mk2442/Itla/digital/impresion-3d/stepper-motor-17hs15/global.png

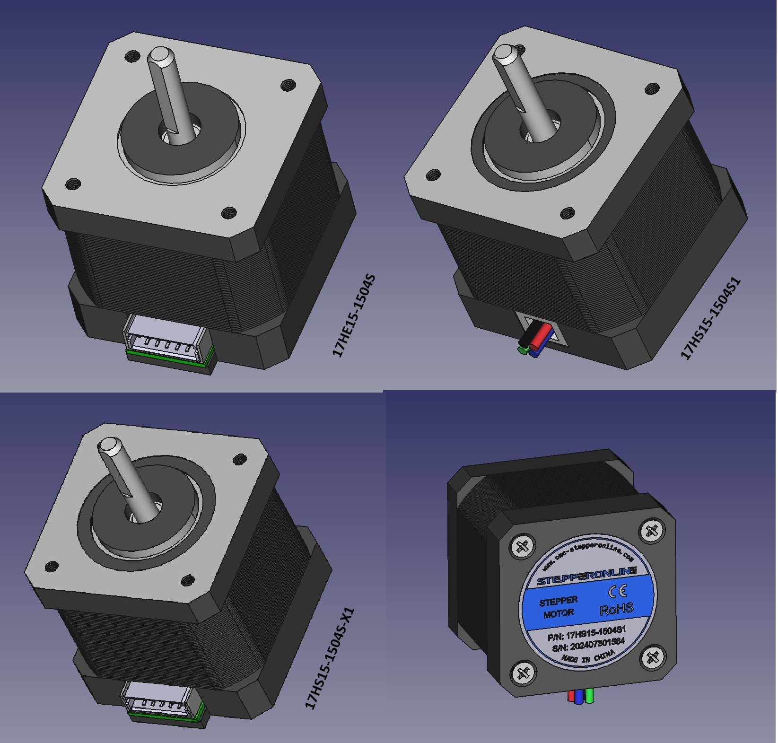
digital/impresion-3d/stepper-motor-17hs15/global.png
