mk2442/Itla/electronica/ESP32-DEVKITV1/README.md

# ESP32-DEVKITV1
ESP32-DEVKITV1 EAGLE-FOOTPRINT

ESP32

ESP32s
