mk2442/Itla/electronica/PHM-30A/README.md

# PHM-30A
Puente H con Mosfet discretos 30A
