mk2442/Itla/digital/proyectos/troca-mcu-stm32g474/README.md

# TROCA-MCU-STM32G474
Tarjeta con microcontrolador STM32G474 100 pines, usamos PCB con pines gatillados.
