mk2442/Itla/digital/documentos/ALU.pdf

# ALU

Angel Alam Mateo Encarnación Mecatrónica
ITLA
La Caleta, Santo Domingo
Cristian Miguel Jimenez
20240712@itla.edu.do

Resumen: En este laboratorio se llevarán a cabo distintas operaciones vinculadas a la unidad lógica aritmética, con el propósito de analizar sus aplicaciones tanto en el ámbito práctico como en el teórico, siendo este un componente fundamental en la electrónica digital.

Abstract: During this lab, various functions related to the arithmetic logic unit will be performed in order to see both the practical and theoretical applications of this key component in the world of digital electronics.

Palabras claves: ALU.

I. Introducción

Durante el siguiente documento se estará
diseñando | un | ALU | mediante | lógica
combinacional con el fin de poder realizar operaciones lógicas y aritméticas de cuatro bits.
II. | Marco Teórico
ALU: | Una | Unidad | Aritmético-Lógica
(ALU) es un elemento esencial dentro de los
procesadores, | encargado | de | ejecutar
operaciones aritméticas, como suma y resta, así como operaciones lógicas, como AND, OR y XOR, entre otras, utilizando datos binarios. Su funcionamiento se basa en recibir dos operandos de entrada junto con una señal de control que define la operación a realizar, generando como salida el resultado y ciertas señales de estado, como acarreo, desbordamiento o condición de cero. Este componente es clave en el procesamiento de información en CPUs, microcontroladores y sistemas digitales, y puede implementarse de manera sencilla
mediante | lenguajes | como | Verilog | en
proyectos con FPGA o en entornos de simulación digital.

III. Diseño del circuito

Para el diseño de la ALU, se partirá de las
funciones | asignadas, | las | cuales | serán
seleccionadas en parte por elección propia y en parte según la matrícula. Estas funciones se escogerán a partir de la siguiente tabla:

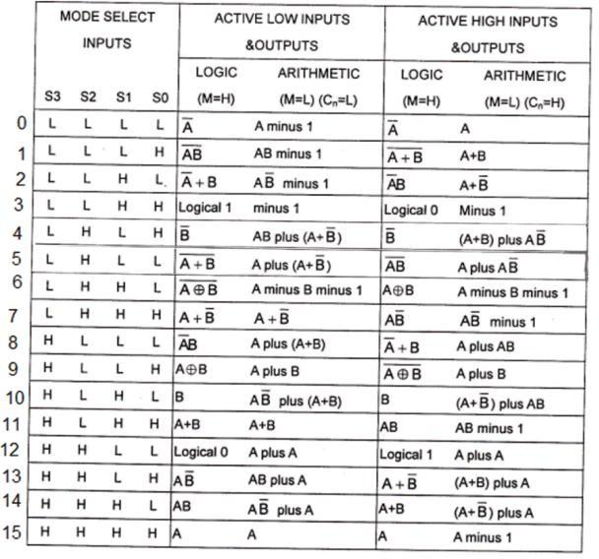
[picture p144: figure]

Y las funciones elegidas son las siguientes:

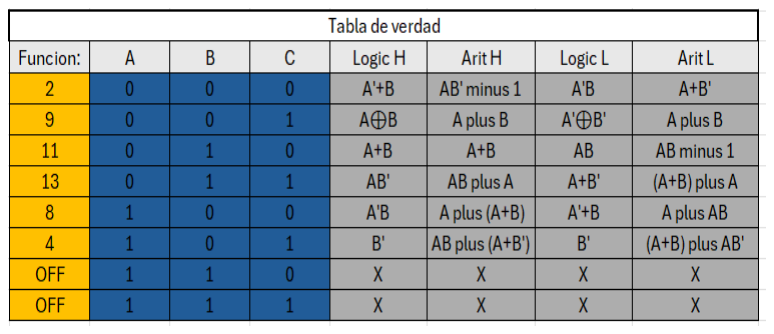
[picture p145: figure]

Partiendo de esta tabla, podemos construir los circuitos logicos en multsim:

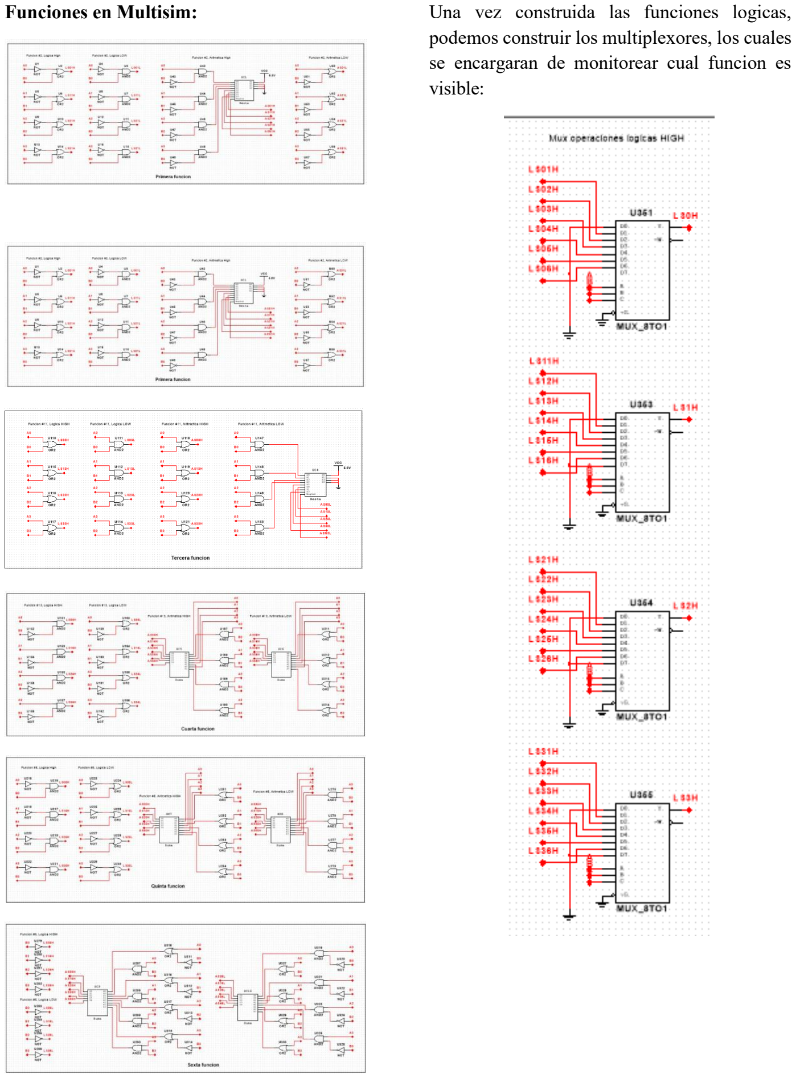
[picture p146: page 2]

Funciones en Multisim: | Una vez construida las funciones logicas, podemos construir los multiplexores, los cuales se encargaran de monitorear cual funcion es visible:

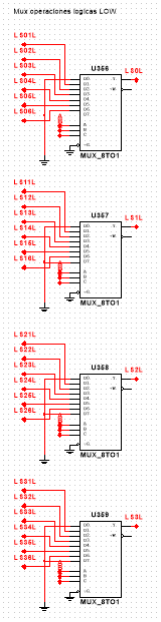
[picture p147: figure]

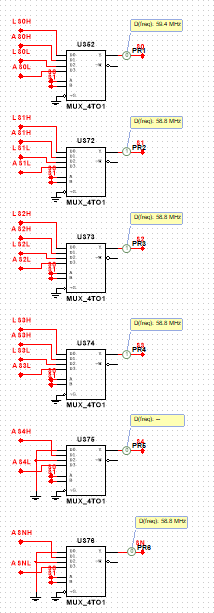
[picture p148: figure]

Para concluir, llevaremos a verilog las funciones creadas y haremos la implementacion en fisico:

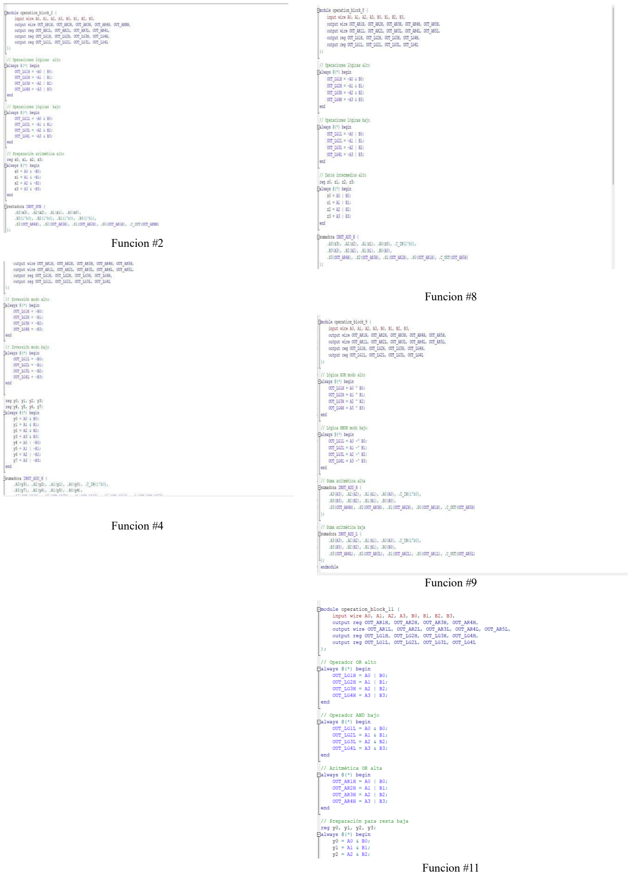
[picture p149: page 5]

Funcion #2

Funcion #4

Funcion #8

Funcion #9

Funcion #11

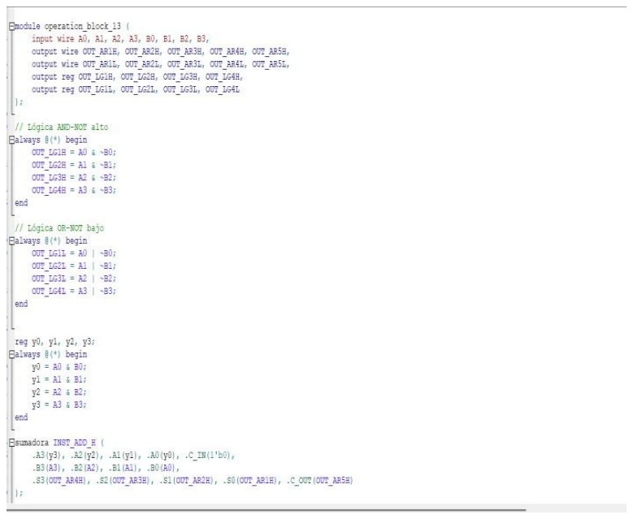
[picture p150: figure]

Funcion #13

Nota: Para la construccion de la restadora, sumadora se utilizaron los mismo diagramas logicos y codigo que se utilizaron en la tarea de la multiplicadora.

IV. Conclusión

Durante el desarrollo de este laboratorio se consiguió diseñar y simular una Unidad Aritmético-Lógica (ALU) de 4 bits empleando lógica combinacional. Se implementaron diversas funciones aritméticas y lógicas, seleccionadas tanto de forma manual como en función de la matrícula, lo que permitió integrar varias operaciones en un único bloque funcional. El uso de multiplexores facilitó la selección de las salidas, evidenciando el principio de control presente en una ALU real. Asimismo, el diseño fue llevado a Verilog con el objetivo de posibilitar su implementación en hardware, acercando el proyecto al uso de FPGA y sistemas digitales reales. Esta
experiencia | permitió | fortalecer | los
conocimientos en diseño digital, estructuración de código y comprender la importancia de las ALU dentro de los sistemas computacionales.
