mk2442/Itla/digital/documentos/Circuitos secuenciales II.pdf

# Circuitos secuenciales II

Cristian Miguel Jimenez

Mecatrónica
ITLA
La Caleta, Santo Domingo
20240712@itla.edu.do

Resumen: En esta práctica se desarrolló un contador síncrono mediante el uso de lógica secuencial y flip-flops tipo D, con el propósito de mostrar en displays de 7 segmentos determinadas combinaciones previamente definidas.

Abstract: In this practice, a synchronous counter was developed using sequential logic and D-type flip-flops, with the objective of displaying specific predefined combinations on 7-segment displays.

Palabras claves: Flip-flop, lógica secuencial, contador síncrono.

I. Introducción

A lo largo del presente documento se llevará a cabo el diseño de un contador síncrono y un decodificador, con el objetivo de representar un patrón secuencial mediante el uso de un display de 7 segmentos.

II. Marco Teórico

Lógica secuencial: La lógica secuencial corresponde a una clase de circuitos digitales cuya salida no solo está determinada por las entradas presentes, sino también por los estados anteriores del sistema. A diferencia de la lógica combinacional, este tipo de lógica puede conservar información a través de elementos de memoria, como los flip-flops, lo que hace posible el desarrollo de registros, contadores y máquinas de estado.

Flip-flop: Un flip-flop es un dispositivo digital biestable capaz de guardar un único bit de información. Su estado cambia según las señales de entrada y la señal de reloj. Constituye la base del almacenamiento en la lógica secuencial y es ampliamente utilizado en la construcción de registros, contadores y sistemas de contro.

Contador síncrono: Un contador síncrono es un circuito secuencial diseñado para aumentar o disminuir su valor con cada pulso de reloj. A diferencia del contador asíncrono, en este caso todos los flip-flops son activados de manera simultánea por la misma señal de reloj, lo que permite un funcionamiento más preciso y reduce los retrasos acumulados.

III. Diseño del circuito e implementación en multisim

El | circuito | que | se | pretende | diseñar
corresponde a un contador síncrono encargado de realizar un desplazamiento de derecha a izquierda, mostrando de manera secuencial una serie de letras mediante el uso de un display de 7 segmentos.

La combinacion que se vera son las iniciales de mi nombre junto a mi matricula, todo separado por guiones.

CMJI-2024-0712

Partiendo de esto, podemos comenzar a diseñar el contador, donde la secuencia sera la siguiente:

Y partiendo de esto, podemos construir la tabla de estados, donde cada estado es representado por un numero de 4 bits, a su vez, incluimos su equivalente para el FlipF tipo D:

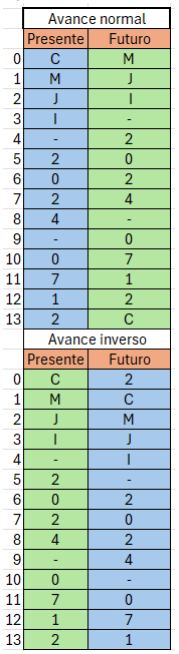
[picture p151: figure]
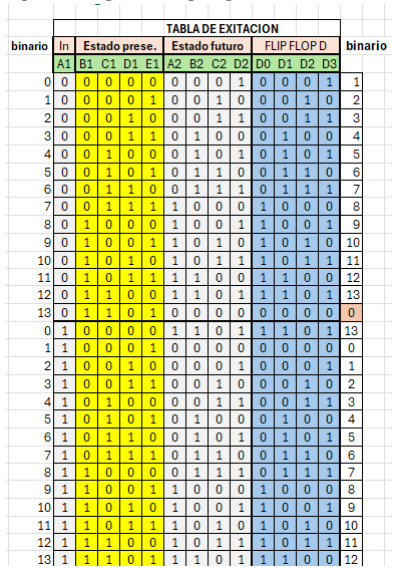
[picture p152: figure]

Y tambien podemos construir el diagrama de estados:

Con esto, realizamos los K-maps para poder

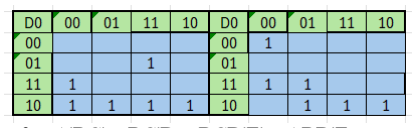
[picture p153: figure]

D0= A'BC' + BC'D + BCD'E' + ABD'E + AB'C'D'E' + A'B'CDE

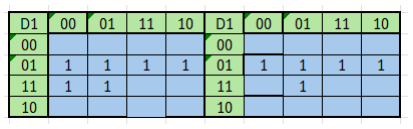
[picture p154: figure]

D1 = B'C + A'CD' + CD'E

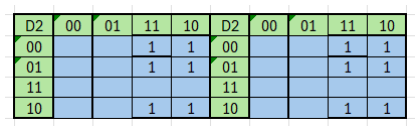
[picture p155: figure]

D2 = B'D + C'D

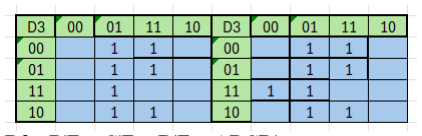
[picture p156: figure]

D3= B'E + C'E + D'E + ABCD'

Con los k-maps, podemos construir el circuito secuencial, que es la primera parte del trabajo:

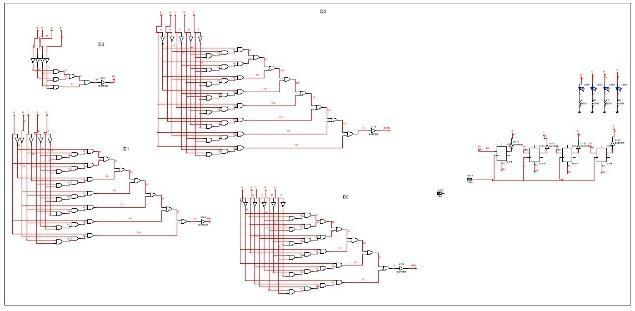
[picture p157: figure]

Diagrama secuencial

Ahora construiremos los pulsadores retencibos para el reset, la inversion de secuencia y el On-off del circuito.

Para hacer un pulsador retencibo con un flip-flop tipo D, basta con las terminare

a un uno logico, y conectar el pulsador al pin de reloj, de la siguiente manera:

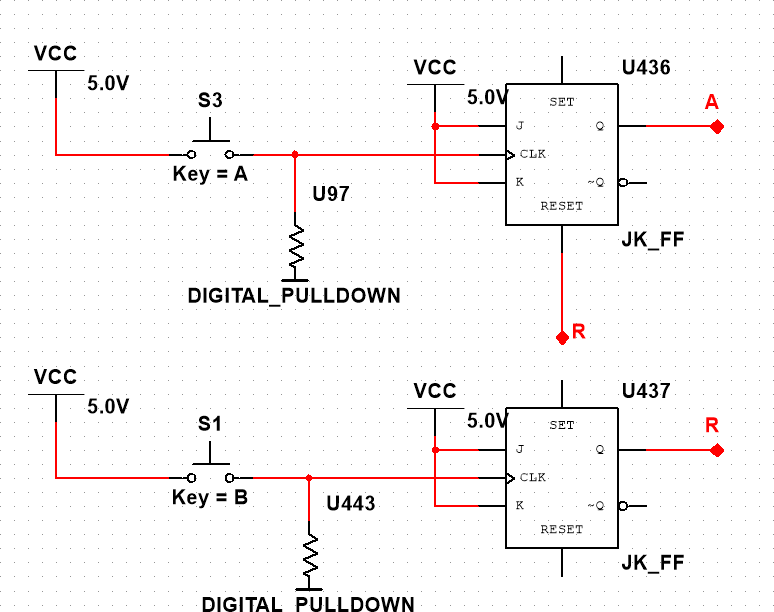
[picture p158: figure]

Pulsadores de inversion y de reset

Nota: El pulsador del reset esta conectado al pin de reset de todos los flip-flop, incluyendo el de inversion.

Para el on-off se utilizaron multiplexores 2 a 1, donde el primer estado es la salida del circuito secuencial, y el segundo estado es una combinacion que hara que los display se apaguen totalmente:

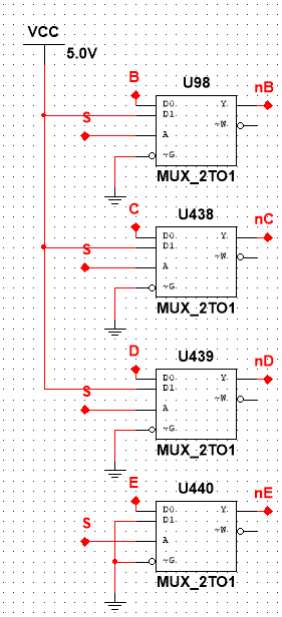
[picture p159: figure]

MUX 2 a 1 del on-off

Y un pulsador retenido:

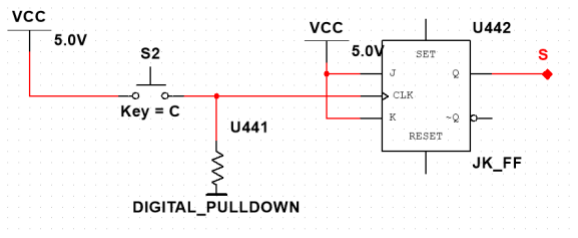
[picture p160: figure]

Conexion de pulsador de On-Off

Para concluir, hay que realizar dos decoder, uno que siga la secuencia normal, otro que vaya desafasado un carácter, para dar el efecto que van moviendose de izquierda a derecha en secuencia normal, y de derecha a izquiera en sucuencia inversa.

Para la construccion de los decoder, utilizamos el siguiente diagrama de referencia:

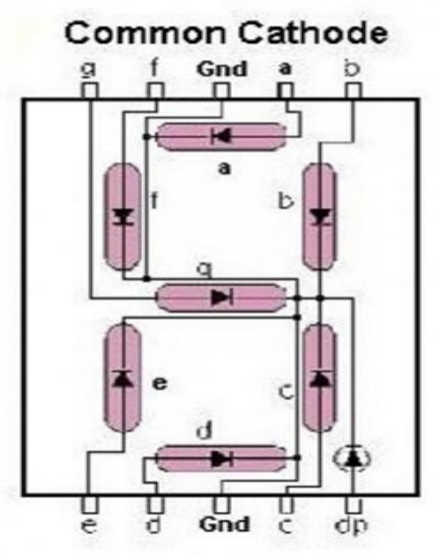
[picture p161: figure]

Display de 7 segmentos

Con esto en conocimimiento, creamos la tabla de verdad de ambos decoder:

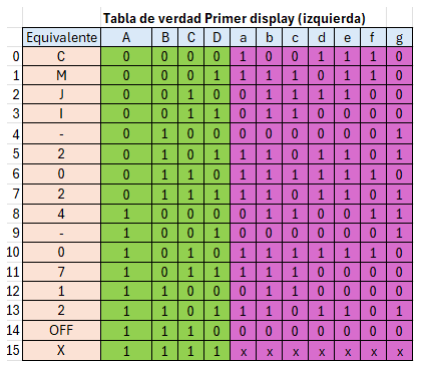
[picture p162: figure]

Primer decoder

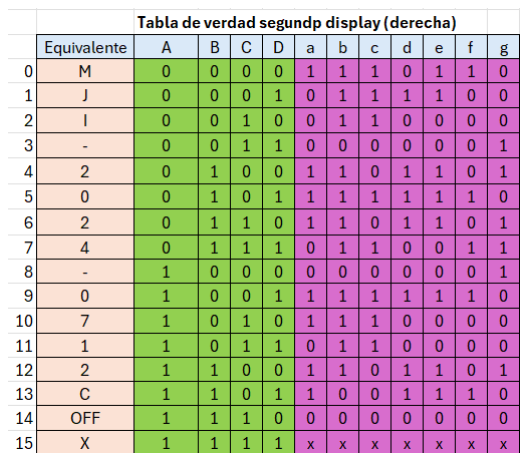
[picture p163: figure]

Segundo decoder

Funciones de cada display:

PRIMER DISPLAY:

ƒA =BD + A'B'C' + A'BC + AB'C

ƒB = A'D + A'C + B'C + BD + AC'D'

ƒC= B'C + A'B'D + A'CD' + AC'D'

ƒD =BD + A'B'D' + B'CD' + A'BC

ƒE = BD + A'B'C' + B'CD' + A'BC

ƒF = A'B'C' + AB'D' + A'BCD'

ƒG =BD + A'BC' + AB'C'

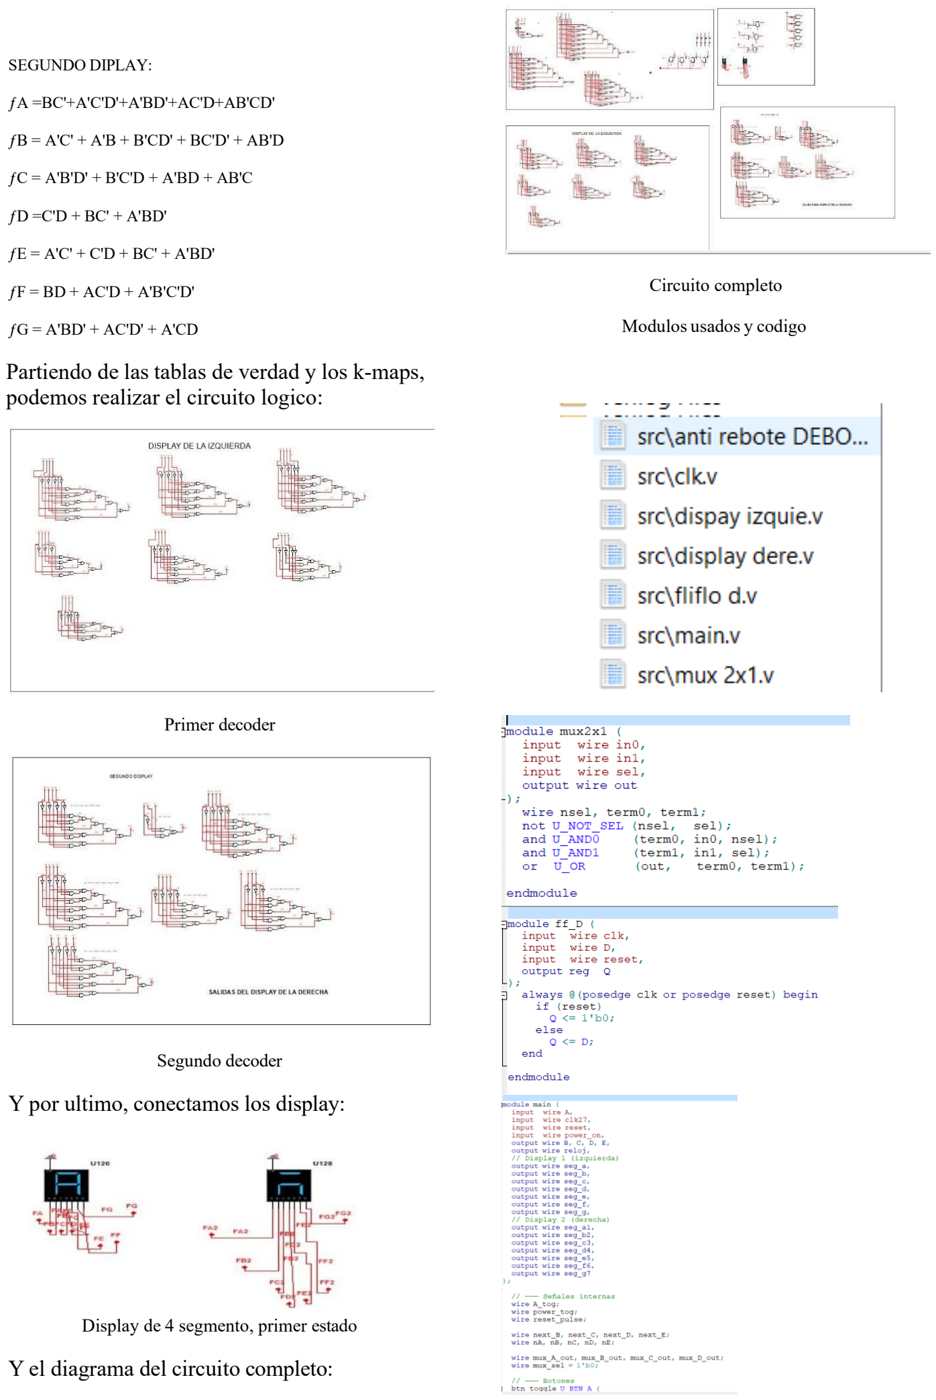
[picture p164: page 5]

SEGUNDO DIPLAY:

ƒA =BC'+A'C'D'+A'BD'+AC'D+AB'CD'

ƒB = A'C' + A'B + B'CD' + BC'D' + AB'D

ƒC = A'B'D' + B'C'D + A'BD + AB'C

ƒD =C'D + BC' + A'BD'

ƒE = A'C' + C'D + BC' + A'BD'

ƒF = BD + AC'D + A'B'C'D'

ƒG = A'BD' + AC'D' + A'CD

Partiendo de las tablas de verdad y los k-maps, podemos realizar el circuito logico:

Primer decoder

Segundo decoder

Y por ultimo, conectamos los display:

Display de 4 segmento, primer estado

Y el diagrama del circuito completo:

Circuito completo

Modulos usados y codigo

IV. Conclusión

Durante el desarrollo de esta práctica se consiguió diseñar e implementar un circuito secuencial operativo, capaz de mostrar una secuencia personalizada de caracteres en dos displays de 7 segmentos mediante el uso de lógica secuencial y flip-flops tipo D. Para su funcionamiento, se incorporaron de manera adecuada elementos fundamentales como el contador síncrono, los decodificadores y los pulsadores retentivos, los cuales permitieron controlar la inversión de la secuencia, el reinicio y el encendido o apagado del sistema. Asimismo, se utilizaron mapas de Karnaugh con el fin de simplificar la lógica de control, y multiplexores para gestionar el estado de activación del circuito. En conjunto, estas herramientas no solo hicieron posible alcanzar los objetivos planteados en la práctica, sino que también fortalecieron el aprendizaje y la comprensión del diseño y análisis de sistemas digitales de mayor complejidad.
