mk2442/Itla/digital/documentos/Multiplexores CRISTIAN.pdf

# Multiplexores

Cristian Miguel Jiménez

20240712@itla.edu.do

MECATRONICA

ITLA
La Caleta, Santo Domingo

Resumen - En esta práctica de laboratorio se trabajó en el diseño y la implementación de circuitos lógicos combinacionales, empleando los multiplexores (MUX) como componente principal. El propósito fue desarrollar sistemas
digitales | capaces | de | generar | salidas
determinadas a partir de entradas específicas, evidenciando así que los multiplexores pueden utilizarse como generadores de funciones lógicas universales

Abstract - In this laboratory practice, the focus was on the design and implementation of combinational logic circuits, using multiplexers (MUX) as the main component. The goal was to create digital systems capable of producing
specific | outputs | from | given | inputs,
demonstrating that multiplexers can be used as universal logic function generators

INTRODUCCIÓN

En este documento se presenta el desarrollo de
un | circuito | combinacional | utilizando
multiplexores 4×1. A lo largo del trabajo se muestra el proceso de diseño e implementación del circuito, así como el análisis de su funcionamiento dentro de un sistema digital.

MARCÓ TEÓRICO

Circuito combinacional:

Es un conjunto de compuertas lógicas en el que la salida depende únicamente de los valores actuales de las entradas, sin almacenar información ni considerar estados anteriores. Estos circuitos se emplean para implementar
diversas | funciones | lógicas, | como
decodificadores, multiplexores, sumadores,
entre | otros. | Su | comportamiento | puede
representarse completamente mediante tablas de verdad y expresiones booleanas.

Multiplexor:

Un multiplexor es un circuito lógico que permite seleccionar una señal entre varias entradas y dirigirla hacia una única salida. Esta selección se realiza mediante líneas de control llamadas selectores. En esencia, funciona como un interruptor digital que determina cuál de las entradas se conecta a la salida.

- Montaje experimental

Para la realización de este laboratorio se utilizaron los siguientes componentes:

1. Resistencias de 1 kΩ
2. Project board
3. Display de 7 segmentos
4. FPGA Tang Primer 25K

Asimismo, se emplearon los siguientes programas de simulación y desarrollo:

- Multisim
- Gowin

DISEÑO DE CIRCUITO

Para comenzar con el diseño del circuito, es necesario partir de la siguiente tabla de verdad, la cual define el comportamiento del

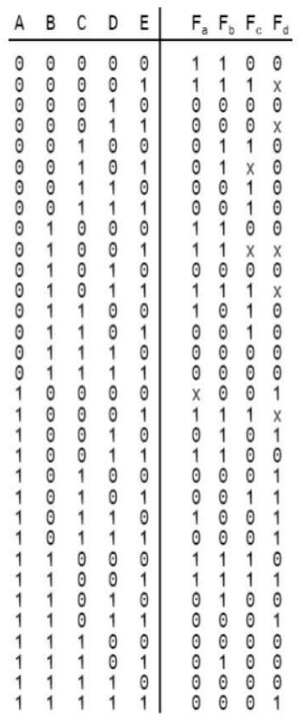
[picture p177: figure]

A esta tabla de verdad se le debe aplicar el método VEM, por lo que se dividirá en cuatro grupos. Además, se considerará que A y B funcionarán como las líneas selectoras de los multiplexores.

Partiendo de esa división, realizamos K-maps y los circuitos combinacionales para que la salida sea la esperada:

Función Fa vem:

Tabla de verdad
A B C | D E | Fa | Fb | Fc | Fd
0 0 | 0 | 0 0 | 1 | 1 | 0 | 0
0 0 | 0 | 0 1 | 1 | 1 | 1 | X
0 0 | 0 | 1 0 | 0 | 0 | 0 | 0
0 0 | 0 | 1 1 | 0 | 0 | 0 | X
0 0 | 1 | 0 0 | 0 | 1 | 1 | 0
0 0 | 1 | 0 1 | 0 | 1 | X | 0
0 0 | 1 | 1 0 | 0 | 0 | 1 | 0
0 0 | 1 | 1 1 | 0 | 0 | 1 | 0
0 1 | 0 | 0 0 | 1 | 1 | 0 | 0
0 1 | 0 | 0 1 | 1 | 1 | x | X
0 1 | 0 | 1 0 | 0 | 0 | 0 | 0
0 1 | 0 | 1 1 | 1 | 1 | 1 | X
0 1 | 1 | 0 0 | 1 | 0 | 1 | 0
0 1 | 1 | 0 1 | 0 | 0 | 1 | 0
0 1 | 1 | 1 0 | 0 | 0 | 0 | 0
0 1 | 1 | 1 1 | 0 | 0 | 0 | 0
1 0 | 0 | 0 0 | x | 0 | 0 | 1
1 0 | 0 | 0 1 | 1 | 1 | 1 | X
1 0 | 0 | 1 0 | 0 | 1 | 0 | 1
1 0 | 0 | 1 1 | 1 | 1 | 0 | 0
1 0 | 1 | 0 0 | 0 | 0 | 0 | 1
1 0 | 1 | 0 1 | 0 | 0 | 1 | 1
1 0 | 1 | 1 0 | 1 | 0 | 0 | 1
1 0 | 1 | 1 1 | 0 | 0 | 0 | 1
1 1 | 0 | 0 0 | 1 | 1 | 1 | 0
1 1 | 0 | 0 1 | 1 | 1 | 1 | 1
1 1 | 0 | 1 0 | 0 | 1 | 0 | 0
1 1 | 0 | 1 1 | 0 | 0 | 0 | 1
1 1 | 1 | 0 0 | 0 | 0 | 0 | 0
1 1 | 1 | 0 1 | 0 | 1 | 0 | 0
1 1 | 1 | 1 0 | 0 | 0 | 0 | 0
1 1 | 1 | 1 1 | 0 | 0 | 0 | 1

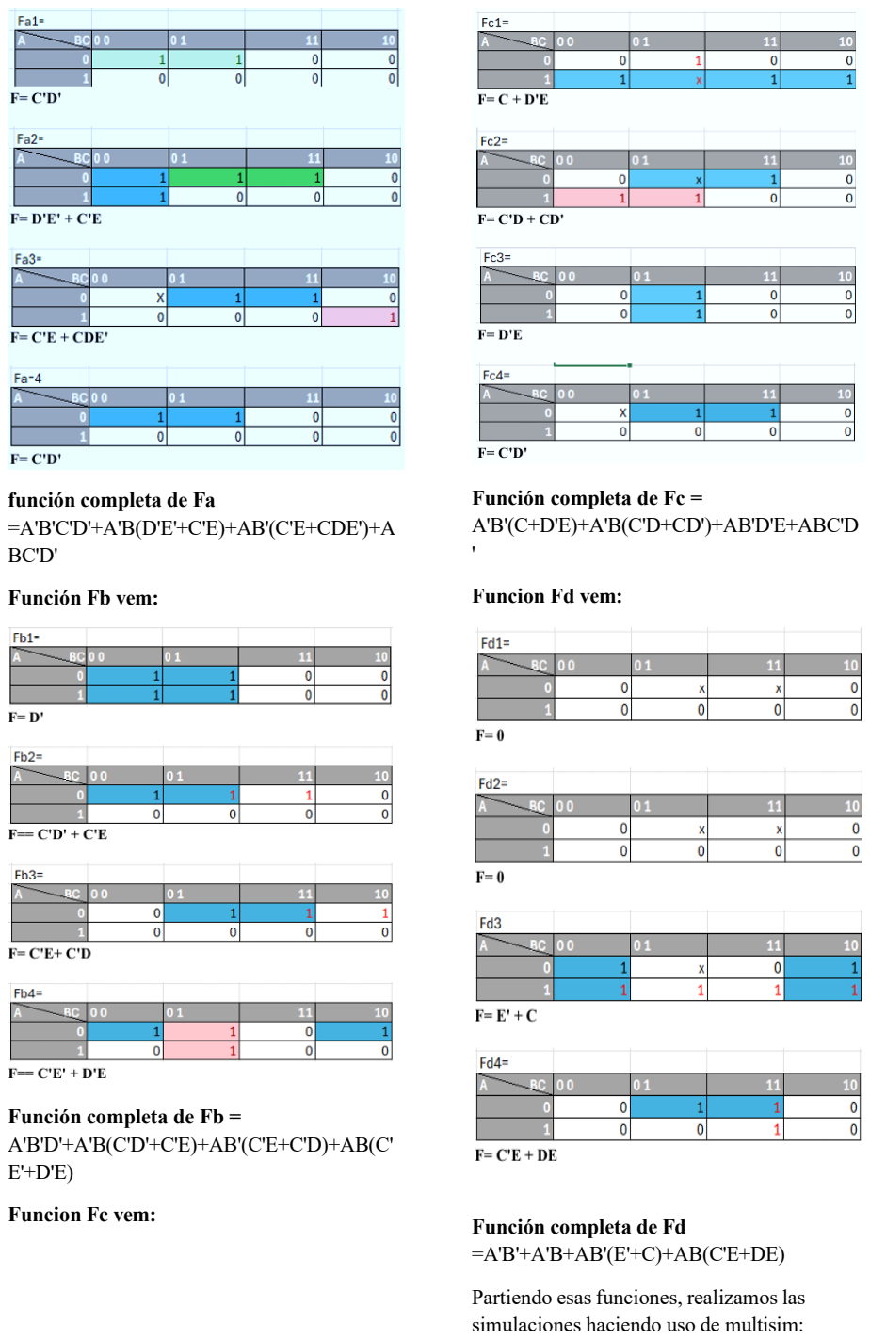
[picture p178: page 3]

función completa de Fa
=A'B'C'D'+A'B(D'E'+C'E)+AB'(C'E+CDE')+A BC'D'

Función Fb vem:

Función completa de Fb =
A'B'D'+A'B(C'D'+C'E)+AB'(C'E+C'D)+AB(C' E'+D'E)

Funcion Fc vem:

Función completa de Fc =
A'B'(C+D'E)+A'B(C'D+CD')+AB'D'E+ABC'D '

Funcion Fd vem:

Función completa de Fd
=A'B'+A'B+AB'(E'+C)+AB(C'E+DE)

Partiendo esas funciones, realizamos las simulaciones haciendo uso de multisim:

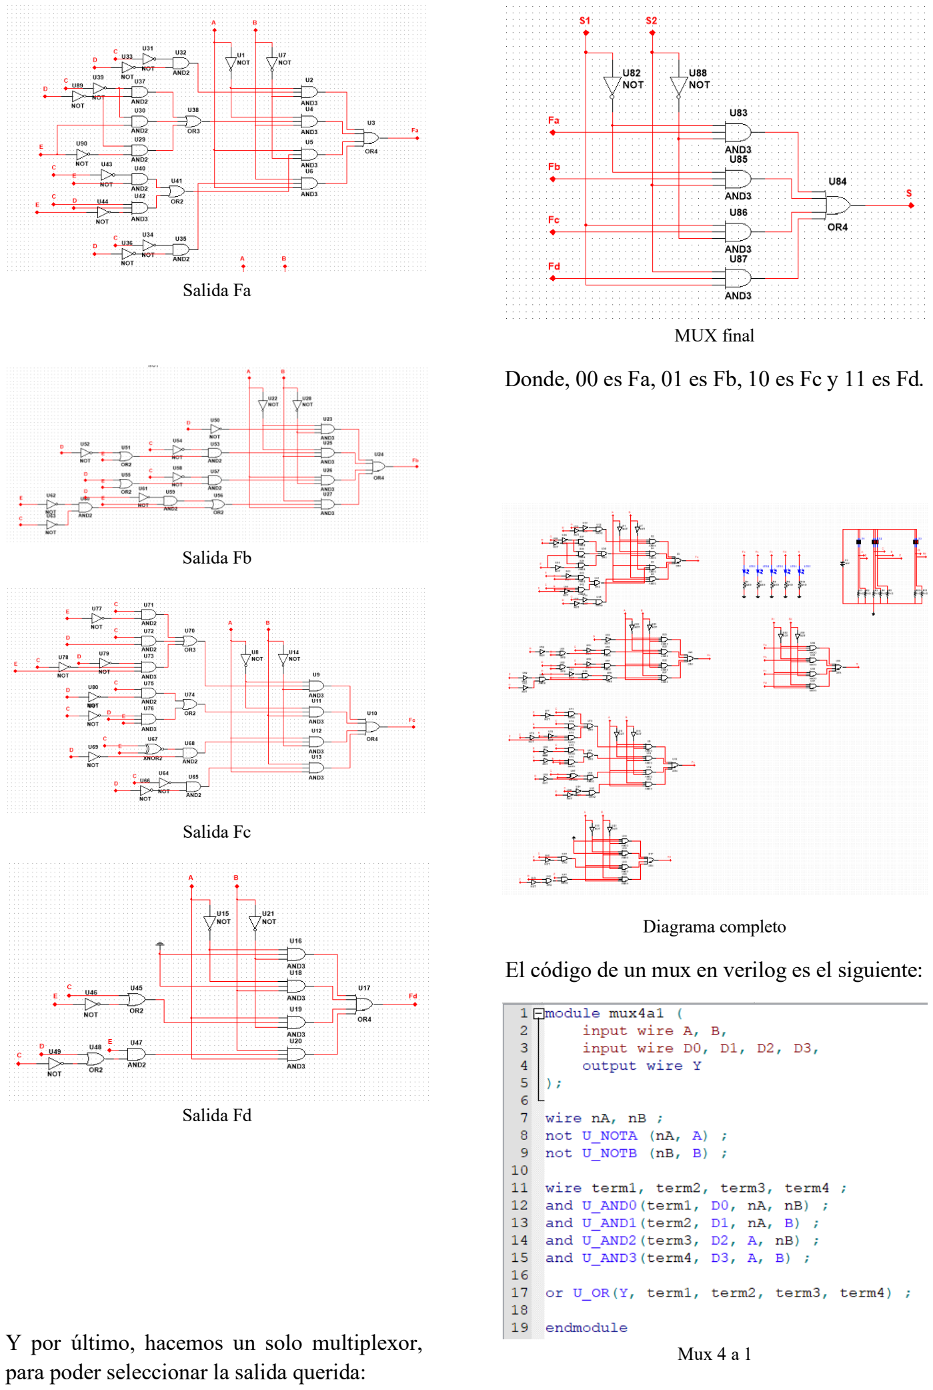
[picture p179: page 4]

Salida Fa

Salida Fb

Salida Fc

Salida Fd

Y por último, hacemos un solo multiplexor, para poder seleccionar la salida querida:

MUX final

Donde, 00 es Fa, 01 es Fb, 10 es Fc y 11 es Fd.

Diagrama completo

El código de un mux en verilog es el siguiente:

Mux 4 a 1

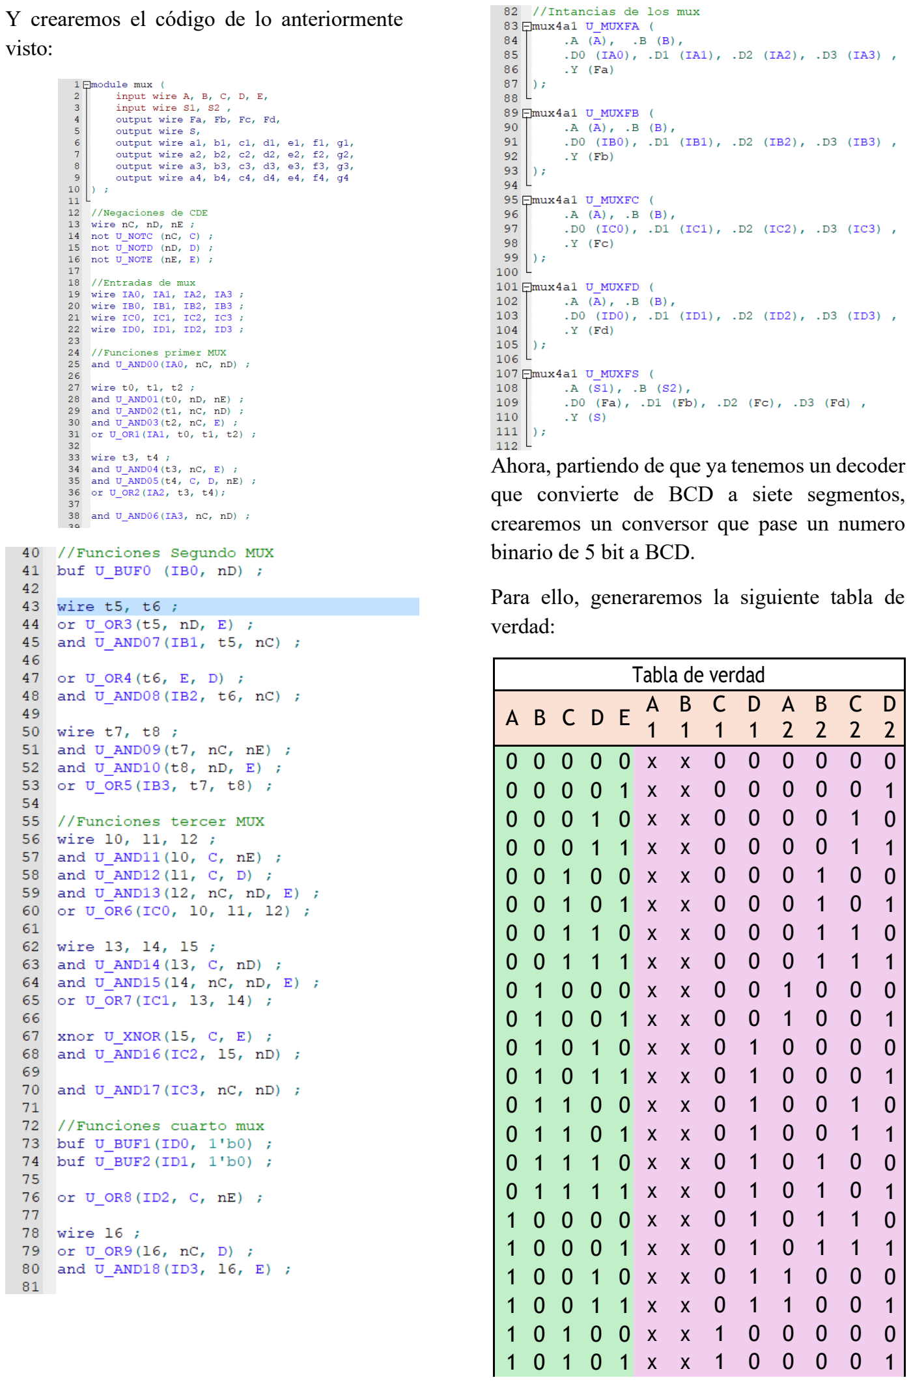
[picture p180: page 5]

Y crearemos el código de lo anteriormente visto:

Ahora, partiendo de que ya tenemos un decoder que convierte de BCD a siete segmentos, crearemos un conversor que pase un numero binario de 5 bit a BCD.

Para ello, generaremos la siguiente tabla de verdad:

Tabla de verdad

A B C D E

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
0 0 0 0 0 x x 0 0 0 0 0 0
0 0 0 0 1 x x 0 0 0 0 0 1
0 0 0 1 0 x x 0 0 0 0 1 0
0 0 0 1 1 x x 0 0 0 0 1 1
0 0 1 0 0 x x 0 0 0 1 0 0
0 0 1 0 1 x x 0 0 0 1 0 1
0 0 1 1 0 x x 0 0 0 1 1 0
0 0 1 1 1 x x 0 0 0 1 1 1
0 1 0 0 0 x x 0 0 1 0 0 0
0 1 0 0 1 x x 0 0 1 0 0 1
0 1 0 1 0 x x 0 1 0 0 0 0
0 1 0 1 1 x x 0 1 0 0 0 1
0 1 1 0 0 x x 0 1 0 0 1 0
0 1 1 0 1 x x 0 1 0 0 1 1
0 1 1 1 0 x x 0 1 0 1 0 0
0 1 1 1 1 x x 0 1 0 1 0 1
1 0 0 0 0 x x 0 1 0 1 1 0
1 0 0 0 1 x x 0 1 0 1 1 1
1 0 0 1 0 x x 0 1 1 0 0 0
1 0 0 1 1 x x 0 1 1 0 0 1
1 0 1 0 0 x x 1 0 0 0 0 0
1 0 1 0 1 x x 1 0 0 0 0 1

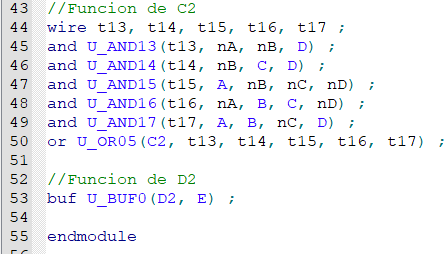
[picture p181: figure]

Por otro lado, creamos una función para poder visualizar mediante un display cual es las opciones vemos en el ultimo MUX, y lo hacemos con la siguiente tabla de verdad:

Partiendo de la tabla de verdad, podemos deducir las ecuaciones:
Tabla de verdad
A | B | a | b | c | d | e | f | g
0 | 0 | 1 | 1 | 1 | 0 | 1 | 1 | 1
0 | 1 | 0 | 0 | 1 | 1 | 1 | 1 | 1
1 | 0 | 1 | 0 | 0 | 1 | 1 | 1 | 0
1 | 1 | 0 | 1 | 1 | 1 | 1 | 0 | 1

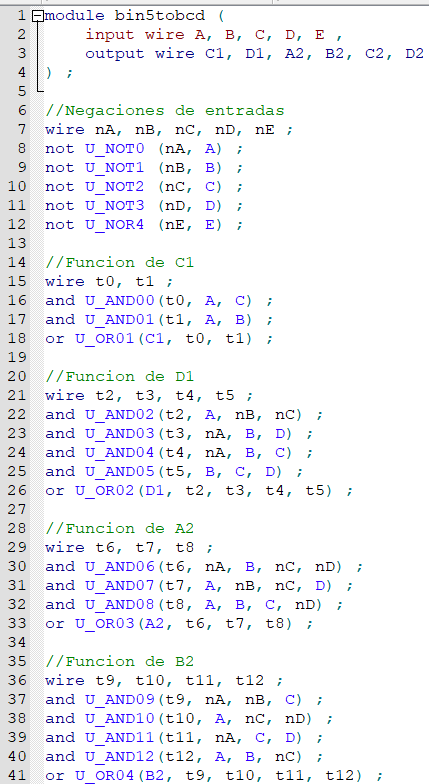
[picture p182: figure]

Y partiendo de esta tabla de verdad, realizamos el código:

1 0 1 1 0 x x 1 0 0 0 1 0
1 0 1 1 1 x x 1 0 0 0 1 1
1 1 0 0 0 x x 1 0 0 1 0 0
1 1 0 0 1 x x 1 0 0 1 0 1
1 1 0 1 0 x x 1 0 0 1 1 0
1 1 0 1 1 x x 1 0 0 1 1 1
1 1 1 0 0 x x 1 0 1 0 0 0
1 1 1 0 1 x x 1 0 1 0 0 1
1 1 1 1 0 x x 1 1 0 0 0 0
1 1 1 1 1 x x 1 1 0 0 0 1

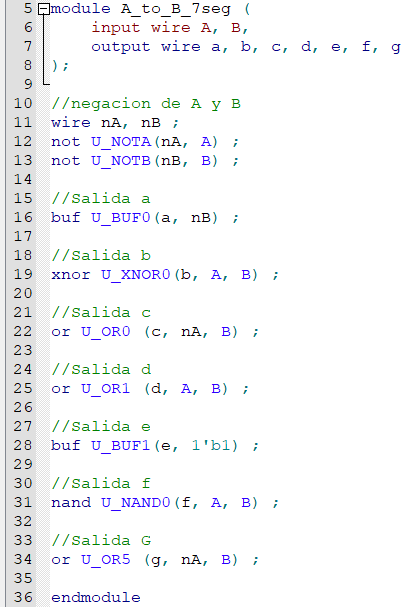
[picture p183: figure]
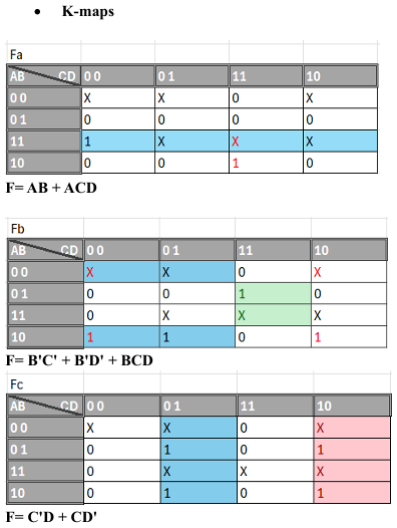
[picture p184: figure]

Ya con todo lo que necesario realizado, instanciamos las funciones para poder tener los display de salida:

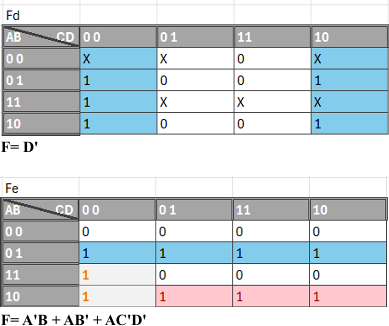
[picture p185: figure]

Problema 3: Diseñe un Decodificador de código Exceso-3 a Decimal. Para este circuito solo deben de hacer uso de un DEMUX 16x1 y las compuertas necesarias. Debajo la tabla de correspondencia.

Esta tabla muestra cómo convertir cada código Exceso-3 de 4 bits (A, B, C, D) a su equivalente decimal para usarlo con un DEMUX 1×16. En las filas tienes todas las combinaciones válidas de Exceso-3 (desde 0011 hasta 1100), y en la columna Fe aparece el número decimal que corresponde (con un “1” en la posición del decimal activo y “0” en las demás). Los “x” marcan los códigos inválidos de Exceso-3 (que no usamos). Así, al conectar esas entradas al DEMUX y usar las líneas de selección adecuadas, cada pulso activa la salida única que representa el valor decimal real de ese código.

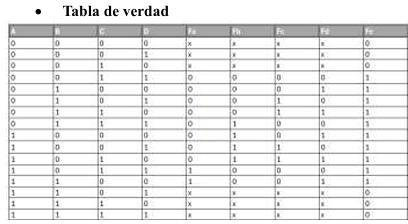
[picture p186: figure]

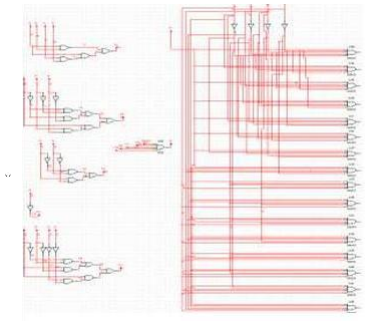
[picture p187: figure]
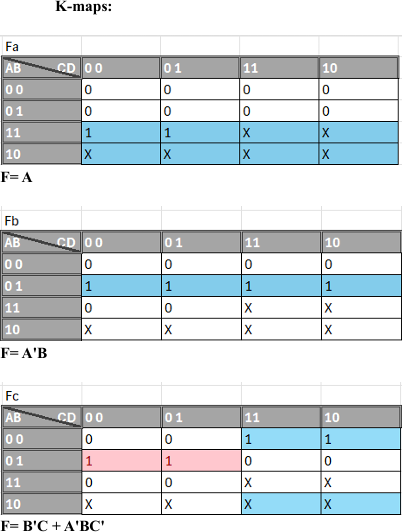
[picture p188: figure]

En este esquema diseñé el decodificador de código Exceso-3 a decimal usando un DEMUX 16×1 más unas compuertas lógicas para filtrar solo las combinaciones válidas. A la derecha está el DEMUX con sus 16 salidas, cada una conectada a los diodos de las compuertas AND que permiten pasar la señal solo cuando la entrada (A-D) coincide con uno de los códigos de Exceso-3 que quiero decodificar. A la izquierda ves varios grupos de compuertas NOT y AND que se encargan de generar las señales de habilitación de cada salida del DEMUX según el valor de A, B, C y D (marcando con “x” los códigos inválidos). Cuando pones en las entradas un código Exceso-3 válido, solo una de las líneas del DEMUX queda activa pasando por su AND correspondiente, y así obtengo el bit de salida decimal que buscaba.

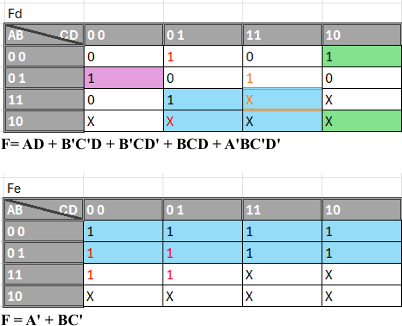
[picture p189: figure]

PROBLEMA 4 Diseñe un Decodificador de código Gray a Decimal. Para este circuito solo deben de hacer uso de un DEMUX 16x1 y las compuertas necesarias.

En esta tabla puse cada código Gray válido (columnas A D) y marqué con “x” los que no se usan. Luego, para cada fila, dejo en 1 solo la salida decimal que corresponde y en 0 las demás (Fa–Fe). Así tengo claro qué línea del DEMUX debe activarse para convertir ese patrón Gray en su número decimal equivalente.

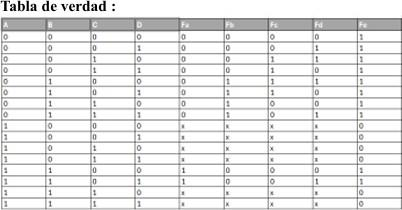
[picture p190: figure]

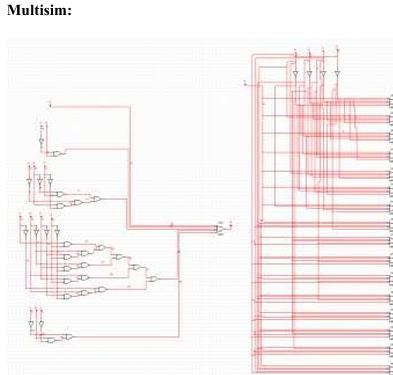
[picture p191: figure]

En mi proyecto de Multisim armé el decodificador de Gray a decimal usando solo un DEMUX 16×1 y unas pocas compuertas. A la izquierda puse la lógica que transforma el código Gray de 4 bits (mis entradas A-D) en los bits de selección del DEMUX, usando inversores y compuertas AND/XOR para filtrar los patrones válidos. A la derecha coloqué el DEMUX 16×1 con su entrada de datos fija en ‘1’, así cada una de las 16 salidas se activa solo cuando los selectores coinciden con ese número. De esta forma, al ingresar cualquier código Gray válido, solo se enciende la línea decimal correcta del 0 al 15.

Conclusión

Durante esta práctica se logró implementar
circuitos | combinacionales | usando
multiplexores 4x1 para generar funciones lógicas específicas, las cuales fueron seleccionadas por un multiplexor adicional y visualizadas en un display. También se construyó un conversor binario a BCD para mostrar el valor decimal correspondiente en siete segmentos. La implementación física con FPGA y la simulación en Gowin
permitieron | comprobar | el | correcto
funcionamiento de cada módulo. Esta experiencia permitió reforzar el uso de multiplexores en el diseño digital y cómo integrarlos en circuitos más complejos junto con decodificadores.
