mk2442/Itla/digital/documentos/Practica 2.pdf

# Practica 2

| Cristian Miguel Jimenez

Mecatrónica
ITLA
La Caleta, Boca chica
2024-0712@itla.edu.do
Resumen - Este documento describe la segunda práctica, la cual se enfoca en los circuitos secuenciales. Se destaca que estos circuitos son cruciales en la electrónica digital porque tienen la capacidad de almacenar y procesar información de forma secuencial, siendo esenciales para numerosos dispositivos y sistemas digitales.

Summary - This document describes the second practice, which focuses on sequential circuits. It emphasizes that these circuits are crucial in digital electronics because they have the ability to store and process information sequentially, making them essential for numerous digital devices and systems.

I. Introducción.

La segunda práctica de este documento aborda el
estudio | de | los | circuitos | secuenciales,
fundamentales en la electrónica digital. A diferencia de los circuitos combinacionales, cuyas salidas dependen únicamente de las entradas presentes, los circuitos secuenciales cuentan con memoria. Esto implica que su funcionamiento no solo se determina por las señales actuales, sino también por los estados previos y la secuencia de eventos que ha experimentado el sistema.

Marco Teórico.

A. Fundamentos de la lógica secuencial: Entender cómo los circuitos son capaces de
almacenar | información | de | estados
anteriores, a diferencia de los circuitos
combinacionales, | que | dependen
únicamente de las entradas presentes.
B. Flip-Flops: Analizar en detalle los distintos tipos de flip-flops, entre ellos:
RS (Set-Reset): El más sencillo, con entradas destinadas a establecer o reiniciar su estado. D (Data o retardo): Guarda el valor presente en su entrada de datos cuando es activado, siendo fundamental en la implementación de registros.
JK: Considerado un flip-flop universal, ya que puede emular el comportamiento de los tipos RS y D, además de incorporar una función de conmutación (toggle).
T (Toggle): Cambia de estado cada vez que recibe una señal de reloj, por lo que es ampliamente utilizado en contadores.
C. Diagramas y tablas de estados: Son herramientas utilizadas para el análisis y diseño de circuitos secuenciales más complejos. Permiten representar cómo el sistema evoluciona entre distintos estados lógicos en función de las entradas y del estado actual.

## I ) Primer ejercicio

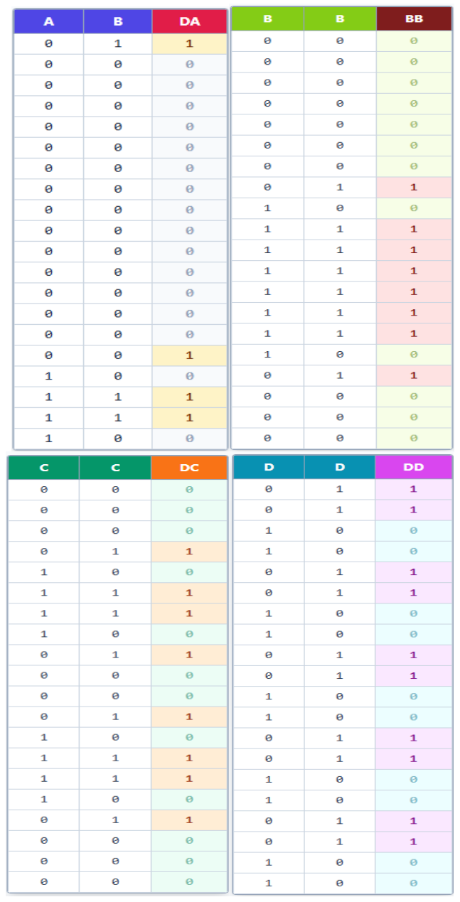
[picture p192: figure]

Realizar un contador que pase por los estado 0,1,2,3,4,5,6,7,8,9,8,7,6,5,4,3,2,1, el mismo debe tener un botón que permita iniciar el circuito y otro que pueda resetear el circuito ( no Dipswitch), Usar flip Flop tipo D y luego Tipo JK para realizarlo, hacer un análisis de similitudes y diferencias cuando se usa el tipo D y cuando se utiliza el JK.

Tabla de verdad y de estados

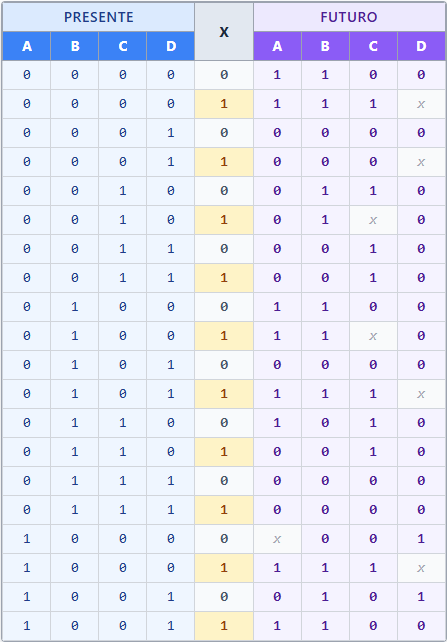
[picture p193: figure]

Para cumplir con los requisitos del ejercicio, se añadió un flip-flop extra junto con algunas compuertas lógicas. El propósito de esto fue cambiar la operación del circuito: cuando la cuenta binaria alcanzara el valor de "9", la lógica de salida pasaría de nivel alto (high) a nivel bajo (low). A partir de ese momento, el circuito iniciaría una cuenta regresiva. Una vez que la cuenta regresiva llegara a cero, el sistema se reiniciaría automáticamente utilizando una compuerta AND de cuatro entradas conectada a las salidas negadas de cada flip-flop.

flip flop(D) 5 Variables :

Kmaps FF (D) | FF (JK)

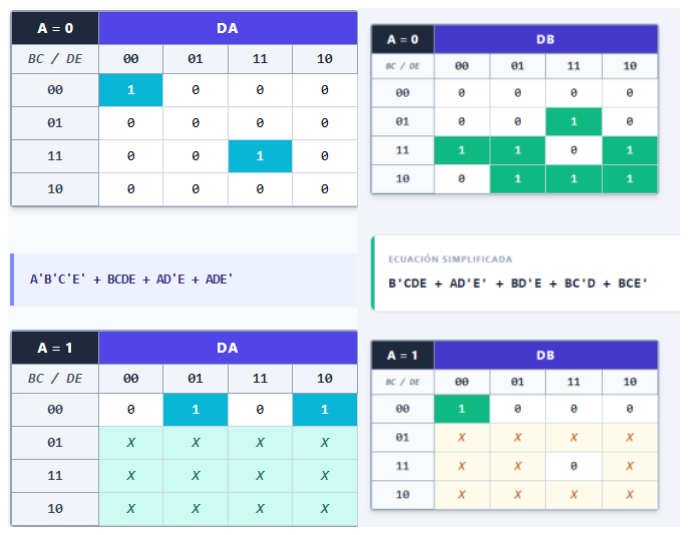
[picture p194: figure]
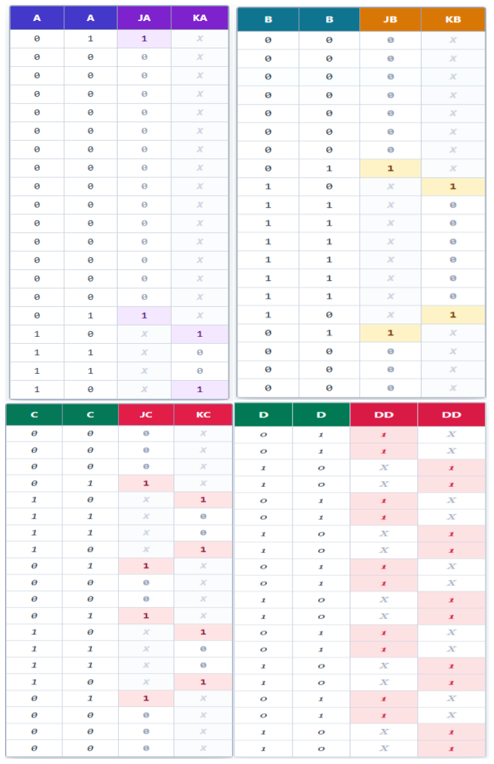
[picture p195: figure]
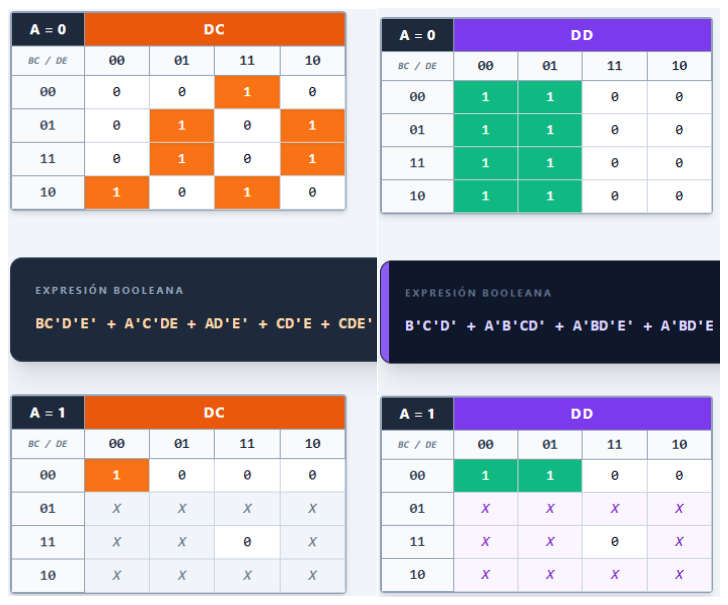
[picture p196: figure]

Kmaps FF(JK) 5 Variables

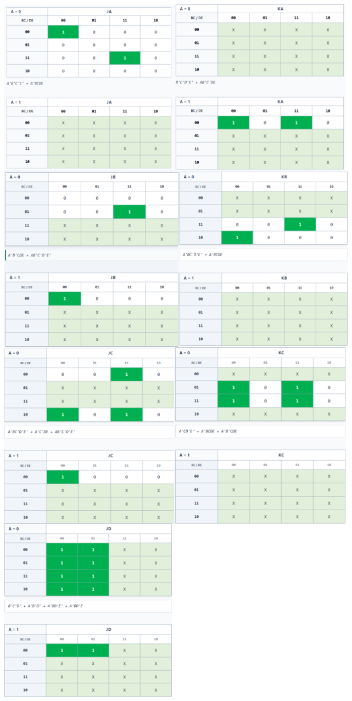
[picture p197: figure]

Diagramas lógicos y de estados

`

FF D:

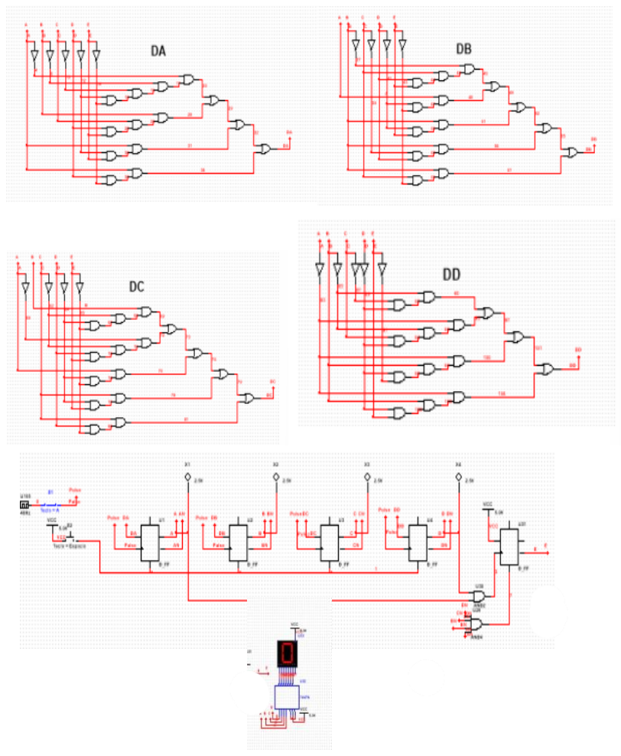
[picture p198: figure]

FF JK:

JA | KA

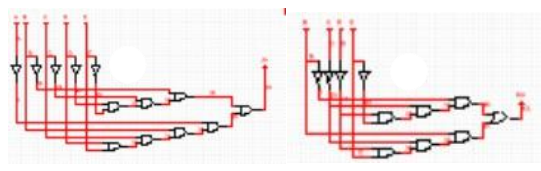
[picture p199: figure]

JB | KB

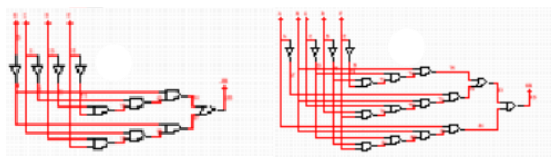
[picture p200: figure]

JC | KC

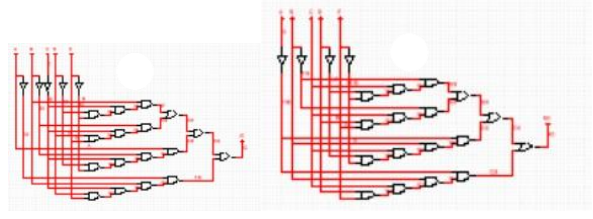
[picture p201: figure]

JD | KD

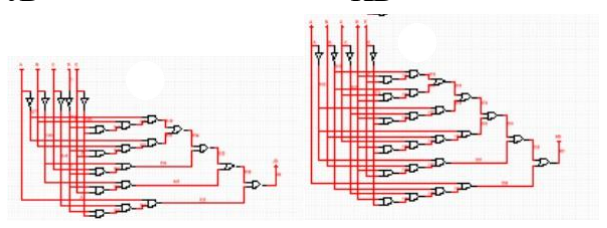
[picture p202: figure]

II - LABORATORIO
LOGICA SECUENCIAL

PROBLEMA 1
Diseñe un Contador del 0 al 9. Usar el FF JK

Para abordar la solución de este problema, el primer paso fundamental consistió en la creación de la tabla de estados, la cual fue elaborada meticulosamente siguiendo las indicaciones y transiciones que se visualizan en el diagrama de estados previamente definido.

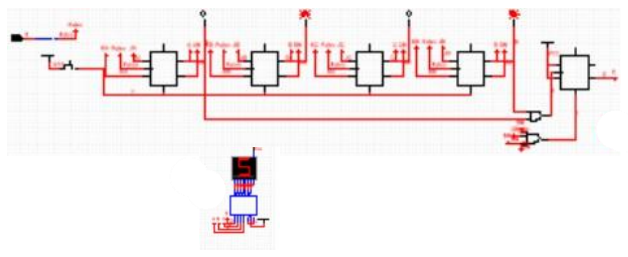
[picture p203: figure]

Una vez establecida la lógica de los estados, el siguiente paso crucial fue la elaboración de las tablas de excitación para cada uno de los flip-flops involucrados en el diseño del circuito. Estas tablas son esenciales, ya que a partir de ellas se logra determinar las entradas requeridas para que cada flip-flop alcance el siguiente estado deseado, lo que a su vez permite obtener las expresiones lógicas de las salidas del sistema. Finalmente, con toda esta información, se procedió a la construcción y simplificación mediante los mapas de Karnaugh (K-maps), un método gráfico que facilita la minimización de las funciones booleanas, optimizando así el diseño del circuito digital.

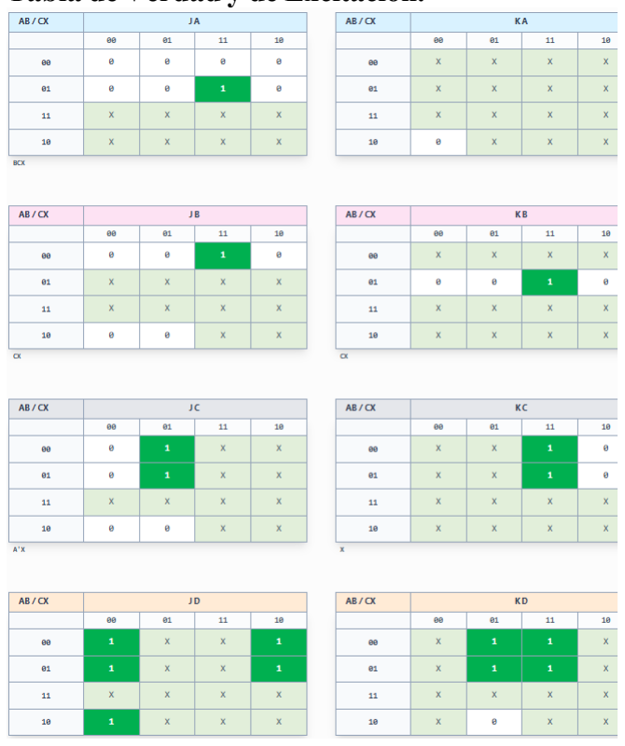
[picture p204: figure]

Tabla de Verdad y de Excitación.

Diagrama de estados

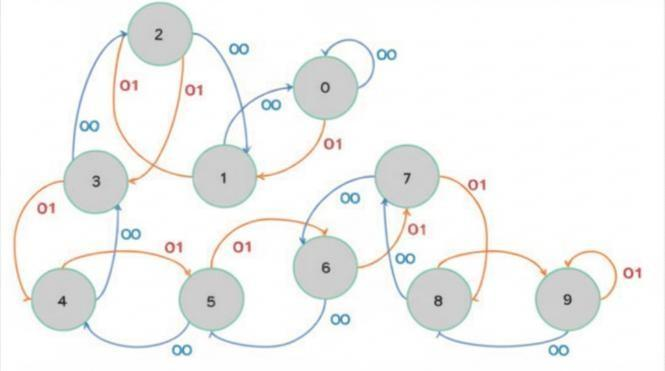
[picture p205: figure]
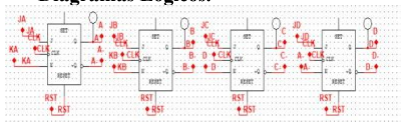
[picture p206: figure]

Diagramas Lógicos.

Diagramas Lógicos:

PROBLEMA 2

Un contador con la siguiente secuencia binaria: 0,1,3,2,6,4,5,7 y que se repita. Use Flip-Flops RS.

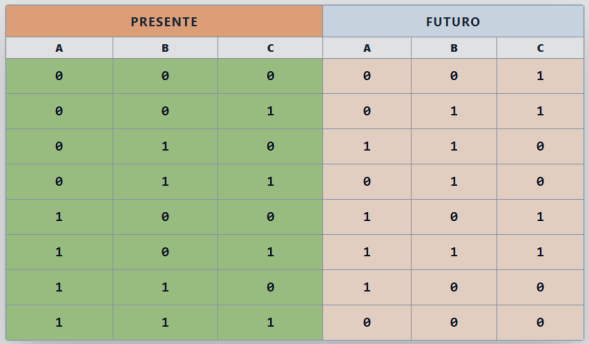
[picture p207: figure]

Tabla de Verdad y de Excitación.

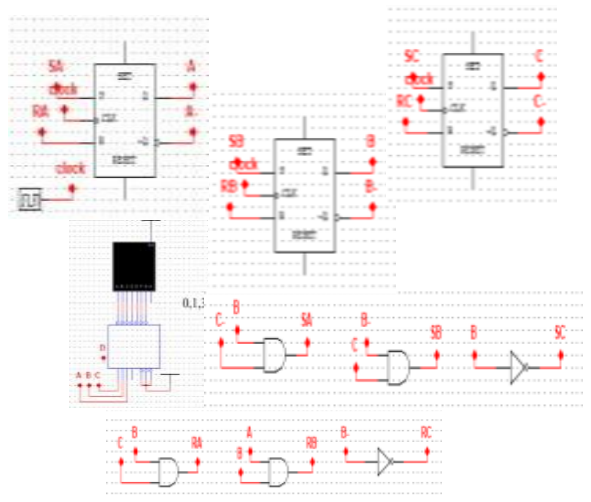
[picture p208: figure]
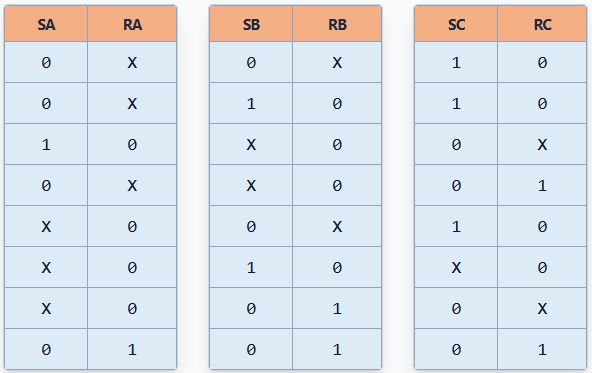
[picture p209: figure]

PROBLEMA 3
Un circuito secuencial tiene una entrada y una salida. El diagrama de estado se muestra abajo. Diseñe un circuito secuencial con FF tipo D.

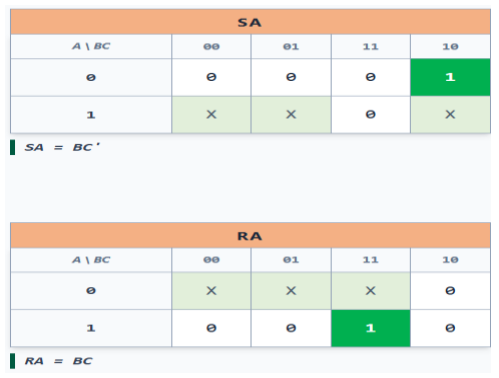
[picture p210: figure]
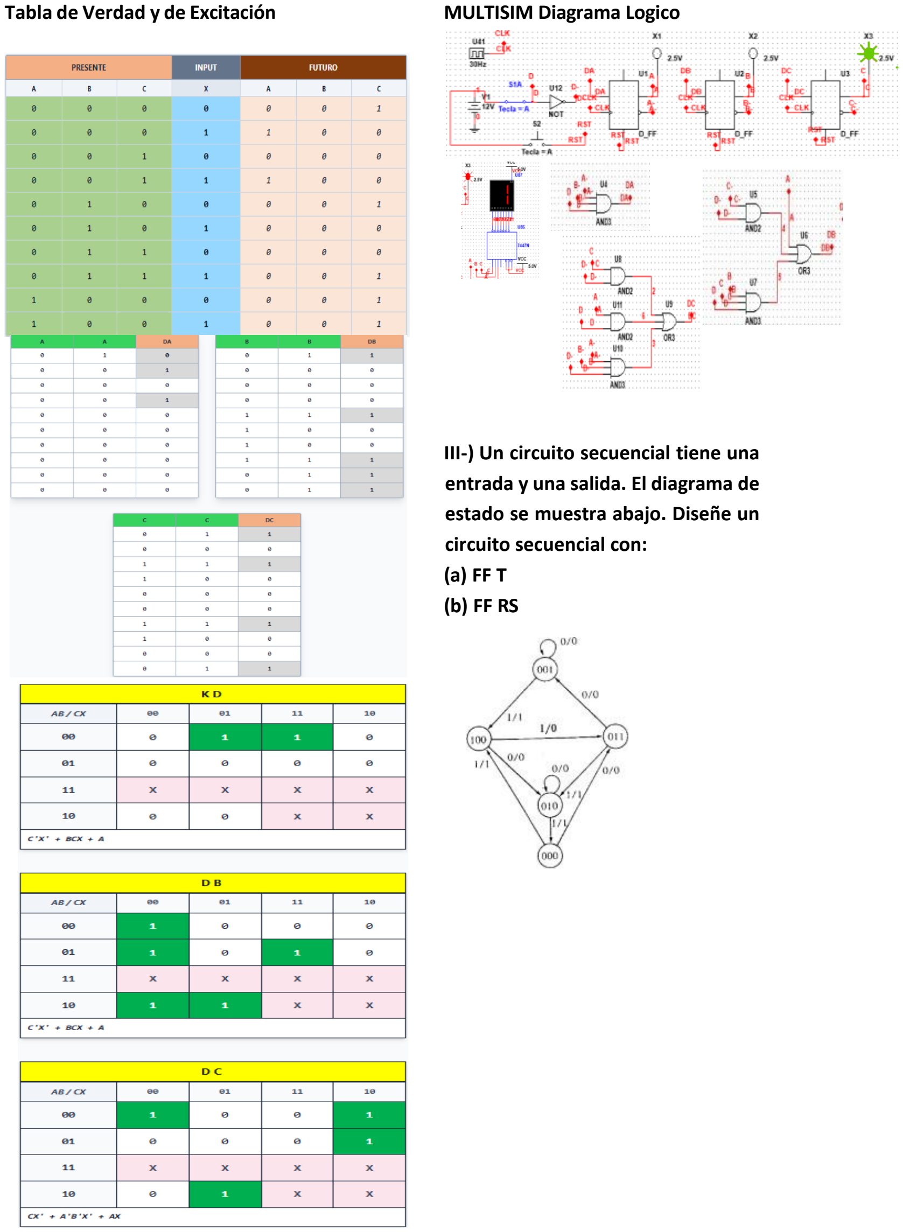
[picture p211: page 8]

Tabla de Verdad y de Excitación | MULTISIM Diagrama Logico

### III-) Un circuito secuencial tiene una entrada y una salida. El diagrama de estado se muestra abajo. Diseñe un circuito secuencial con: (a) FF T (b) FF RS

### Para abordar la solución de este complejo problema de diseño digital, el proceso se inició de manera sistemática, construyendo minuciosamente la tabla de estados ; esta fue elaborada en estricta conformidad con las transiciones y comportamientos definidos en el diagrama de estados

### previamente establecidos, sirviendo como la hoja de ruta que describe cómo el sistema evoluciona de un estado a otro en

función de sus entradas.

Una vez que la lógica de las transiciones de estado estuvo claramente definida, el siguiente paso crítico fue la generación de las tablas de excitación para cada uno de los flip-flops que conformarían el núcleo de nuestro circuito. Estas tablas son fundamentales, ya que nos permitieron determinar cuáles deben ser las entradas específicas(J, K, D, T, etc.) de cada flip-flop para inducir el cambio del estado actual al

siguiente estado deseado.

## Tabla de Verdad y de estados

## (a) FF RS

## Kmaps FF RS

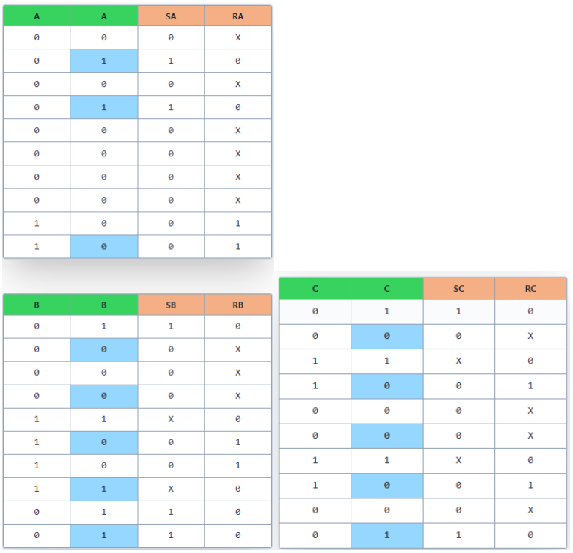
[picture p212: figure]

## Diagrama logico FF RS

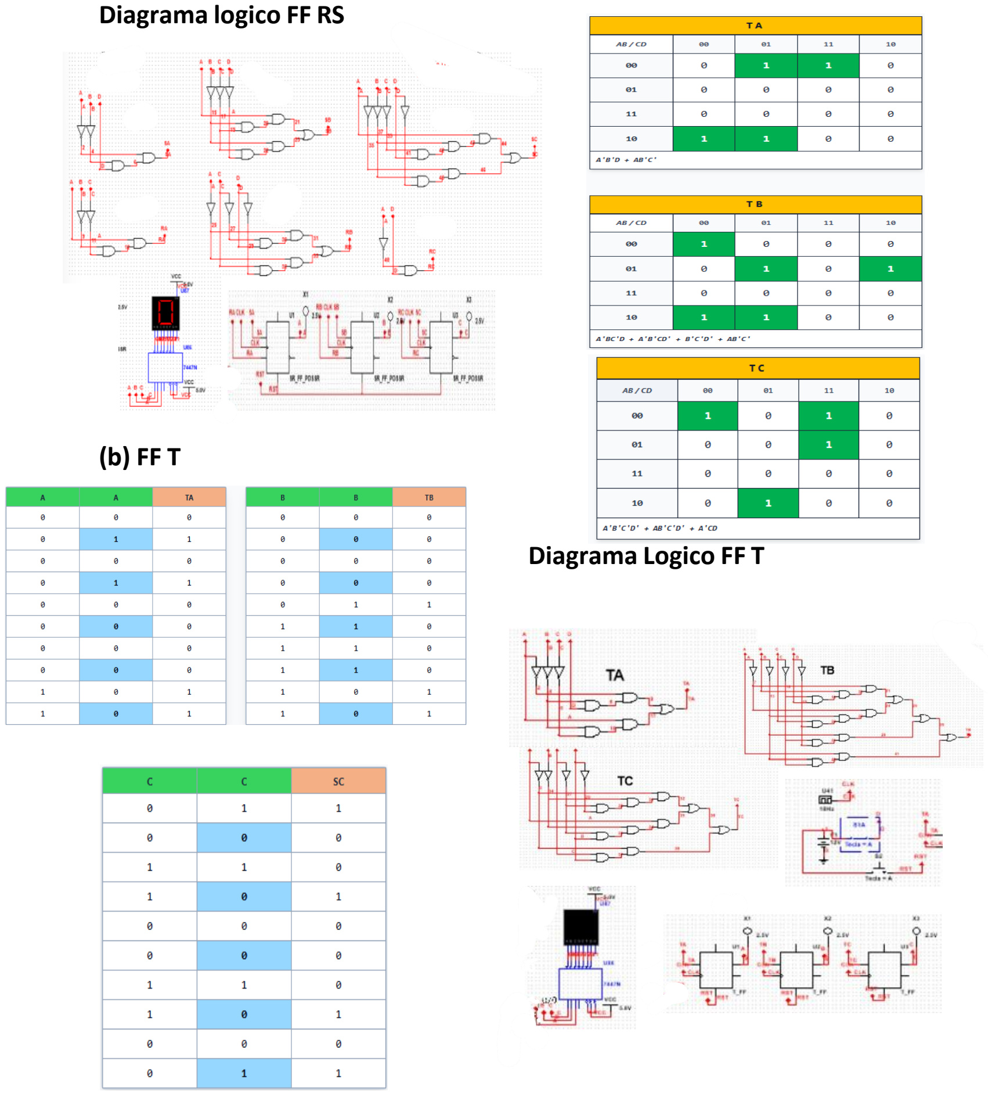
[picture p213: page 11]

## (b) FF T

## Diagrama Logico FF T

11’

## 2-) Un circuito secuencial tiene una entrada y una salida. El diagrama de estado se muestra abajo. Diseñe un circuito secuencial con: (a) FF RS

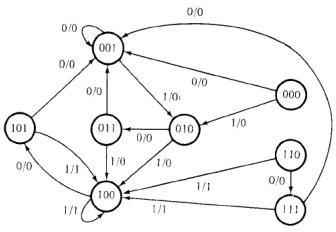
[picture p214: figure]
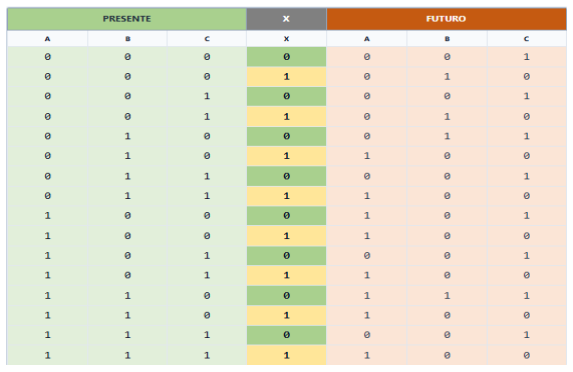
[picture p215: figure]

## Para abordar la solución de este complejo problema de diseño digital, el proceso se inició de

manera sistemática,

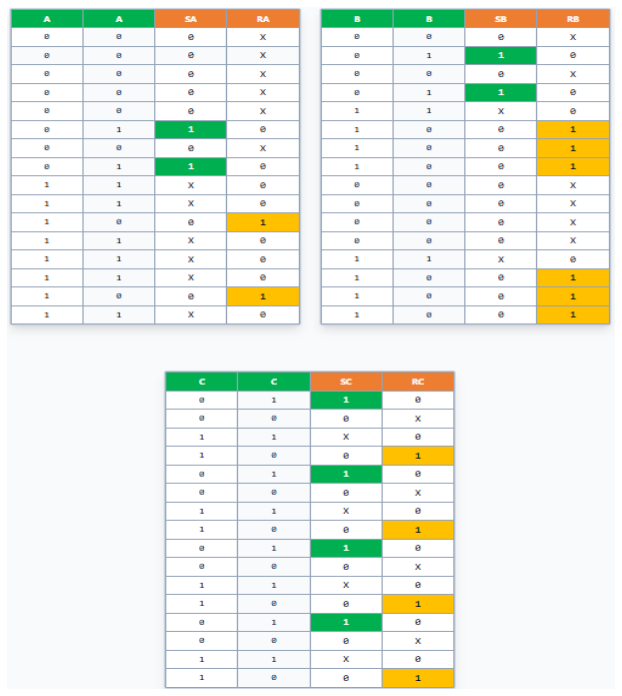
[picture p216: figure]

## construyendo minuciosamente la tabla de estados ; esta fue elaborada en estricta conformidad con lastransiciones y comportamientos definidos en el diagrama de estados previamente establecidos

## sirviendo como la hoja de ruta que describe cómo el sistema evoluciona de un estado a otro

## en función de sus entradas. Una vez que la lógica de las transiciones de estado estuvo claramente definida, el siguiente paso crítico fue la generación de lastablas de excitación para cada uno de los flip-flops que conformarían el núcleo de

nuestro circuito.

IV- Ejercicio 1.

## Utilizando un multiplexor con A

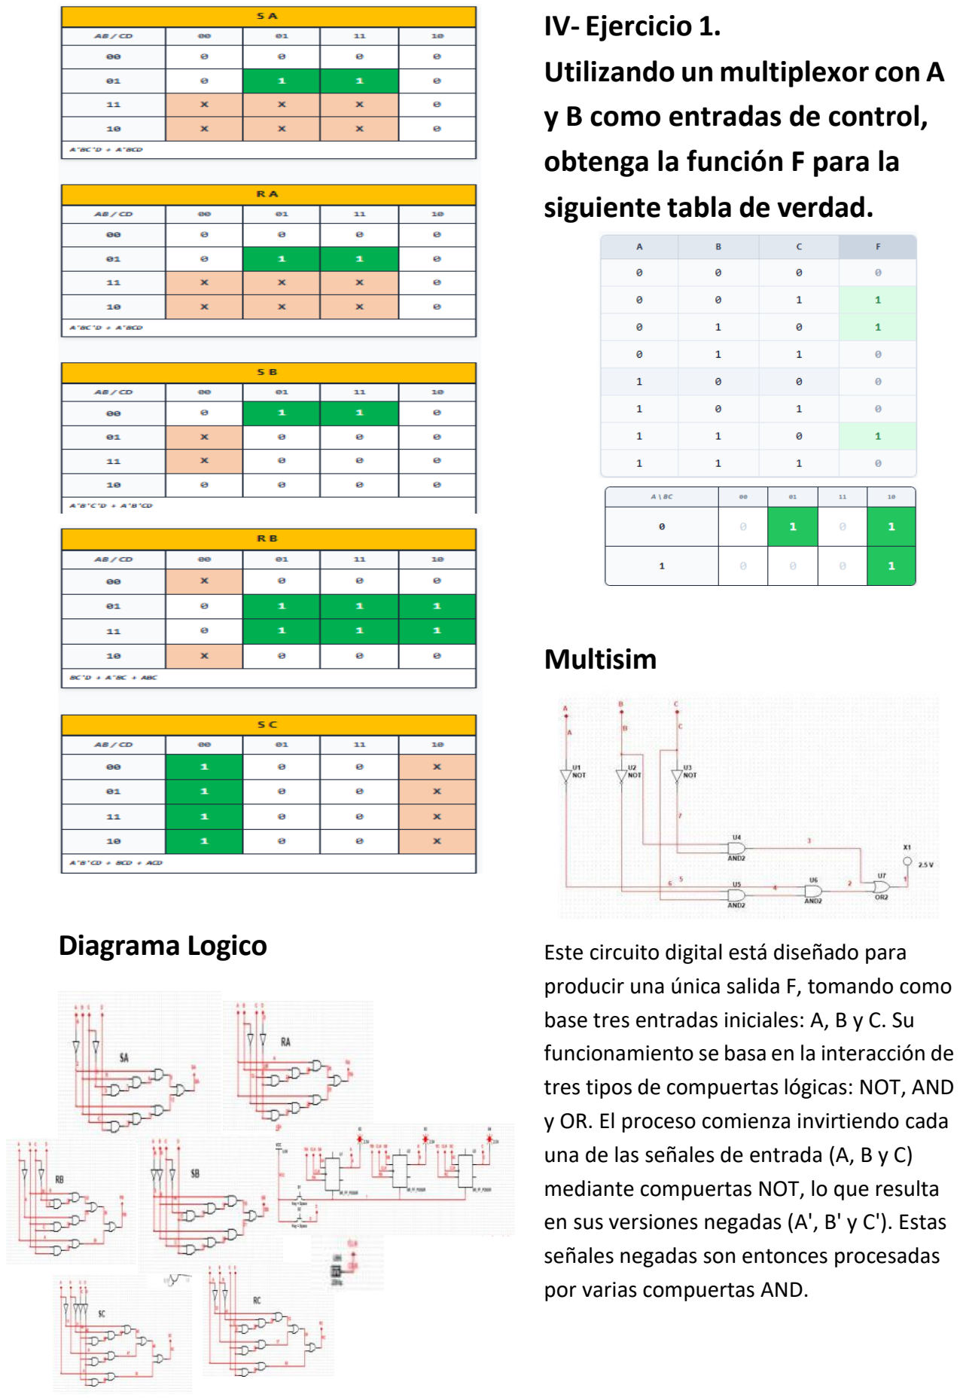
[picture p217: page 13]

## Diagrama Logico

y B como entradas de control,

## obtenga la función F para la

siguiente tabla de verdad.

## Multisim

Este circuito digital está diseñado para producir una única salida F, tomando como base tres entradas iniciales: A, B y C. Su funcionamiento se basa en la interacción de tres tipos de compuertas lógicas: NOT, AND y OR. El proceso comienza invirtiendo cada una de las señales de entrada (A, B y C) mediante compuertas NOT, lo que resulta en sus versiones negadas (A', B' y C'). Estas señales negadas son entonces procesadas

por varias compuertas AND.

### Específicamente, una sección del circuito una la negación de A (A') con la negación de C (C'). Otra sección, por su parte, combina

la negación de B (B') con la señal original C,

### y el producto de esta operación se fusiona a

su vez con la entrada original A. Finalmente,

### los resultados obtenidos de estas dos operaciones con compuertas AND son enviados a una compuerta OR, cuya función es unirlos para generar la señal de salida definitiva, F. La expresión booleana que describe la lógica de este circuito es F = A'·C'

+ A·B'·C.

## Código en verilog

## Ejercicio 2

## Implementarla siguiente función mediante un multiplexor de tres entradas de control

## Tabla de verdad

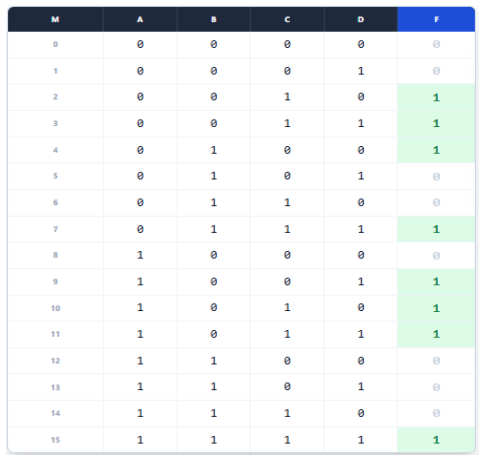
[picture p218: figure]
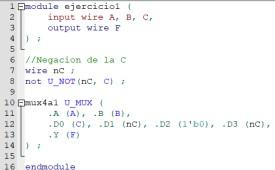
[picture p219: figure]

## Tabla de verdad para definir que debe tener cada entrada del mux

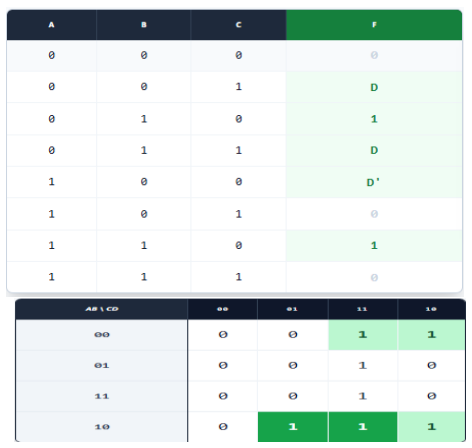
[picture p220: figure]

## B’C’+CD+AB’D+A’BC’D’

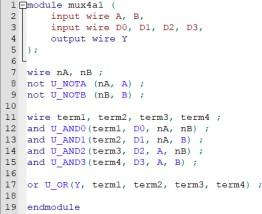
[picture p221: figure]

## DIAGRAMA LOGICO

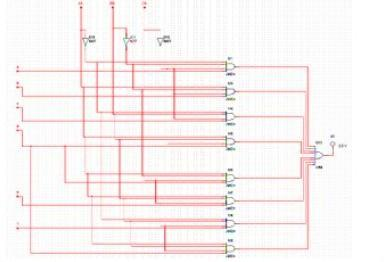
[picture p222: figure]
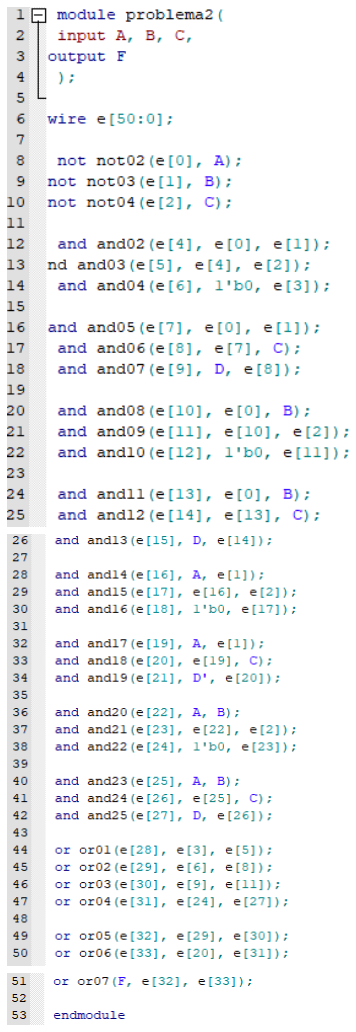
[picture p223: figure]

### Este diseño electrónico corresponde a un multiplexor de 8 a 1 implementado únicamente con compuertas lógicas básicas. Su funcionamiento se basa en el uso de las señales A, B y C como líneas de selección, las cuales son invertidas para obtener también sus

respectivos complementos.

### Cada una de las ocho combinaciones posibles de estas señales de control habilita de manera exclusiva una compuerta AND. Dichas compuertas reciben diferentes entradas de datos, que pueden ser constantes (0 o 1) o variables lógicas como D y su

complemento D’.

### En consecuencia, solo una de las rutas de entrada se activa en cada momento, según

la combinación presente en A, B y C.

### Finalmente, las salidas de todas las compuertas AND se integran mediante una compuerta OR, produciendo la salida final

del multiplexor.

### Código en verilog

Ejercicio 3.

### Diseñe una unidad aritmética lógica que realiza las operaciones NAND, NOR, AND y OR entre dos bits (C y D). La operación se indica con otros dos bits (A y B). Utilice las variables A y B como entradas de control

del multiplexor.

### Tabla de verdad:

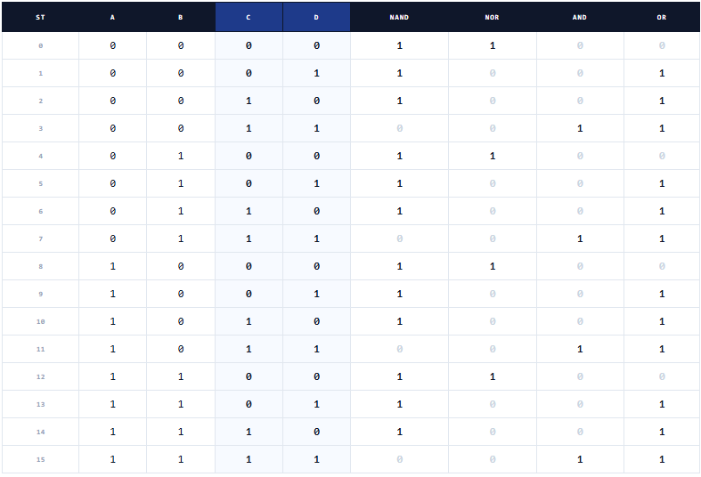
[picture p224: figure]

Diagrama lógico

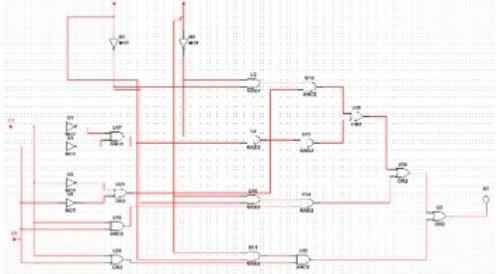
[picture p225: figure]

### Este diseño electrónico corresponde a una unidad aritmético-lógica (ALU) básica, capaz de realizar cuatro tipos distintos de operaciones lógicas a partir de sus

entradas.

### Ejercicio 4 Mediante un multiplexor de tres entradas de control implementar la siguiente función:

### Tabla de verdad

## ABC'D+AB'C'D+ AB'C'D' + ABCD'+

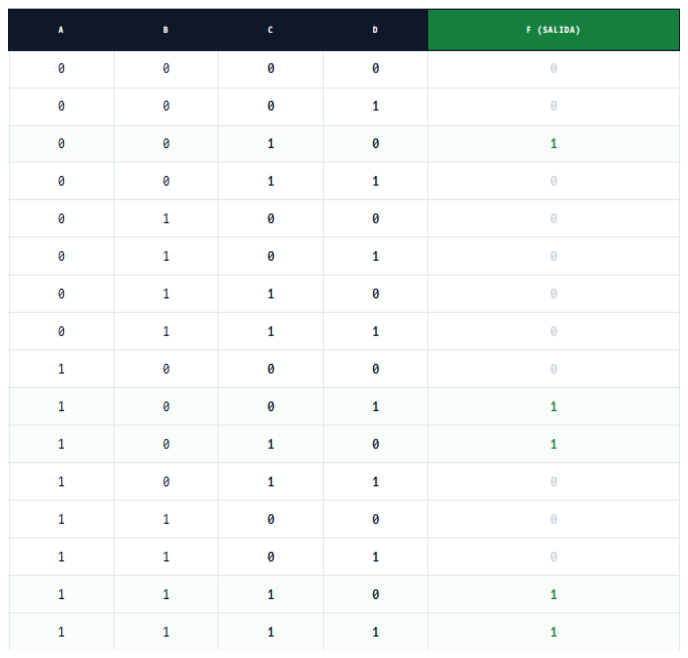
[picture p226: figure]

## ABCD

Este documento incluye una tabla de verdad diseñada para analizar el comportamiento de la función F(A, B, C, D), resaltando visualmente (mediante colores) los casos en los que la salida F toma el valor de 1.
La función se activa, o resulta verdadera, únicamente en cinco combinaciones específicas de entrada, conocidas como minterminos. Estas configuraciones representan los únicos escenarios en los que se cumplen las condiciones lógicas definidas por la función original.
Para garantizar la exactitud del diseño, cada término lógico fue cuidadosamente verificado dentro de la tabla de verdad, evaluando cada bit de manera detallada y confirmando así la correcta implementación de la función.

### Diagrama lógico

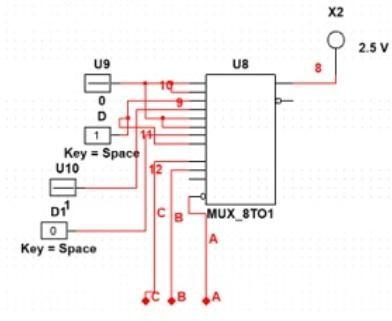
[picture p227: figure]

Problema:
Realizar un circuito teóricamente un portón digital con estados
FF Tipo D

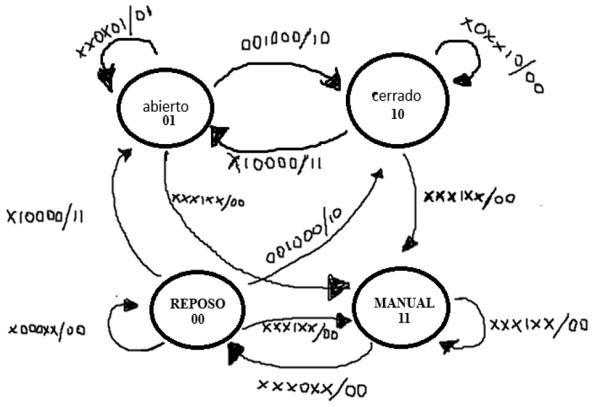
[picture p228: figure]

Tabla de Excitación del Flip-Flop D:

Regla simple: D siempre es igual a Q(t+1)

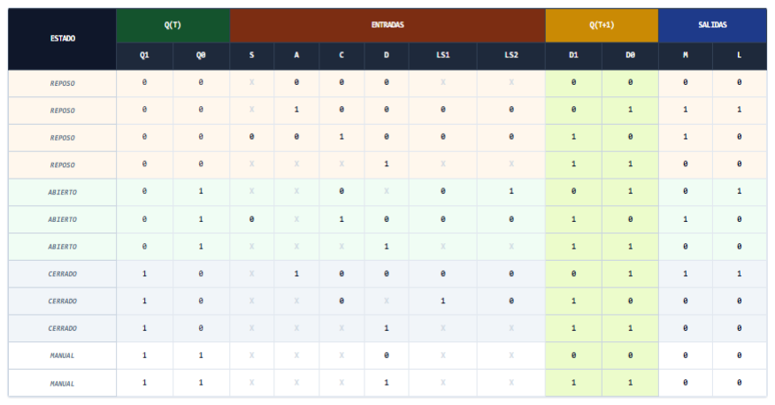
[picture p229: figure]

D1 y D0 son las entradas de tus dosflip-flops:
D1 controla el flip-flop que maneja Q1 (bit mássignificativo) D0 controla el flip-flop que maneja Q0 (bit menossignificativo)

Las columnas D1 y D0 en la tabla de excitación representan qué valores debes poner en las entradas de los flip-flops para lograr la transición deseada.
Para el Flip-Flop tipo D siempre es igual al próximo estado Q(t+1). Las ecuaciones se obtienen analizando en qué casos D1=1 y D0=1, escribiendo la expresión booleana que satisface todos esos casos.

Ecuaciones de Excitación (Flip-Flop D):
D1 = Q1'·Q0'·C·S' + Q1'·Q0·C·S' + Q1·Q0'·A' + Q1·Q0·D + D D0 = Q1'·Q0'·A + Q1'·Q0·C'·LS2 + Q1·Q0'·A + Q1·Q0·D Motor = (Q1'·Q0'·A) + (Q1'·Q0·C·S') + (Q1·Q0'·A)
LED = (Q1'·Q0'·A) + (Q1'·Q0) + (Q1·Q0'·A)

### FF Tipo JK:

Tabla de Excitación JK (Referencia)

El Flip-Flop JK tiene dos entradas de control: J (Jump): Para activar/poner en 1
K (Kill): Para desactivar/poner en 0

1- X representa "don't care" (no importa el valor) 2- Se necesitan 2 flip-flopsJK para representar los 4 estados (Q1 Q0)
3- Los valores de J y K se calculan según la tabla de excitación del flip-flop JK
4- Las entradas XXX1XX indican activación del modo MANUAL

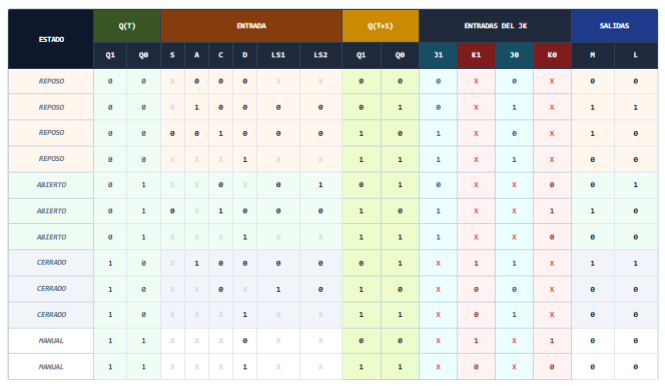
[picture p230: figure]

Proceso de Cálculo de esta tabla
Identificar la transición Miras el estado actual y el próximo estado de cada bit (Q1 y Q0) , entonces Aplicar la tabla de excitación Para cada bit, buscas en la tabla qué valores de J y K necesitas , después Asignar valores
Escribeslos valores de J1, K1, J0, K0 .

Funciones booleanas

Para los Flip-Flops JK:

J1 = Q1'·(Q0'·A + Q0'·S'·LS1'·LS2' + Q0'·D + Q0·S'·A + Q0·D) K1 = Q1·A'·D'·(Q0'·LS1'·LS2' + Q0)
J0 = Q0'·(Q1'·A·LS1'·LS2' + Q1'·D + Q1·A'·D'·LS1'·LS2' + Q1·D)
K0 = Q0·(Q1'·S'·A·LS1'·LS2' + Q1·A'·D')

Para las Salidas:
Motor = LS1'·LS2'·(Q1'·Q0'·A + Q1'·Q0'·S' + Q1'·Q0·S'·A + Q1·Q0'·A'·D')
LED = Q1'·Q0'·A·LS1'·LS2' + Q0·LS1'·LS2·(Q1'·A'·D' + Q1·A'·D')

## Conclusión

### Esta experiencia práctica ha sido fundamental para fortalecer mi comprensión sobre los circuitos secuenciales. Al desarrollar los problemas propuestos por el profesor, logré profundizar en el funcionamiento y las aplicaciones de los contadores basados en

flip-flops síncronos.

### La resolución de cada ejercicio me permitió entender con mayor claridad la interacción entre estos componentes y su gran

versatilidad dentro de la electrónica digital.

### Considero que esta etapa de aprendizaje ha sido clave para consolidar mis habilidades tanto en el diseño como en el análisis de sistemas secuenciales, estableciendo una base sólida para enfrentar proyectos futuros

de mayor complejidad.

PD.
(Después de todo este proceso, solo puedo concluir que el verdadero experimento no fue el de los circuitos secuenciales, sino comprobar cuántas horas puede sobrevivir una persona sin dormir, cuántos niveles de estrés puede soportar sin colapsar, y cómo, en algún punto del análisis, casi me convenzo de que restaurar Constantinopla era una idea completamente razonable.)
