mk2442/Itla/digital/documentos/Primer parcial 2Display.pdf

# Laboratorio de Electrónica Digital Primer Parcial

### Cristian M. Jimenez

2024-0712

### 1. Información específica de la practica Descripción:

En esta práctica se desarrollará un circuito combinacional que cumpla con las especificaciones indicadas más adelante. Para el diseño se aplicarán las herramientas de sistemas digitales vistas hasta ahora, como la tabla de verdad, álgebra booleana, mapas de Karnaugh, términos max-term o min-term y el diagrama de tiempo. Este último permitirá prever el comportamiento esperado en la salida del circuito antes de implementarlo. Cada proyecto será diferente, ya que estará basado en la matrícula y datos personales de cada estudiante. Debido a que es una actividad evaluativa, se espera que tanto el diseño como su montaje físico cumplan con los requisitos establecidos y funcionen correctamente.

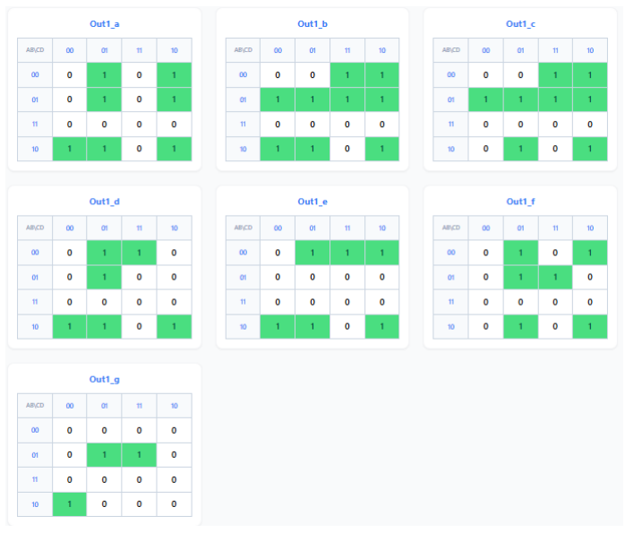
[picture p231: figure]

### 2. Objetivos de Aprendizaje:

1. Crear un circuito combinacional que cumpla estrictamente con las especificaciones técnicas dadas.
2.Emplear metodologías de diseño digital especializadas para sistemas de lógica combinacional.
3.Desarrollar el diseño utilizando Verilog como lenguaje de descripción de hardware (HDL).
4.Seleccionar la tecnología de implementación, ya sea mediante lógica discreta (compuertas) o dispositivos programables (FPGA). 5.Validar el comportamiento del sistema mediante herramientas de simulación de software.
6.Generar y analizar cronogramas (diagramas de tiempo) para verificar la sincronía y el funcionamiento lógico.
7.Ejecutar el montaje físico y la puesta en marcha del diseño en hardware real (FPGA o compuertas).

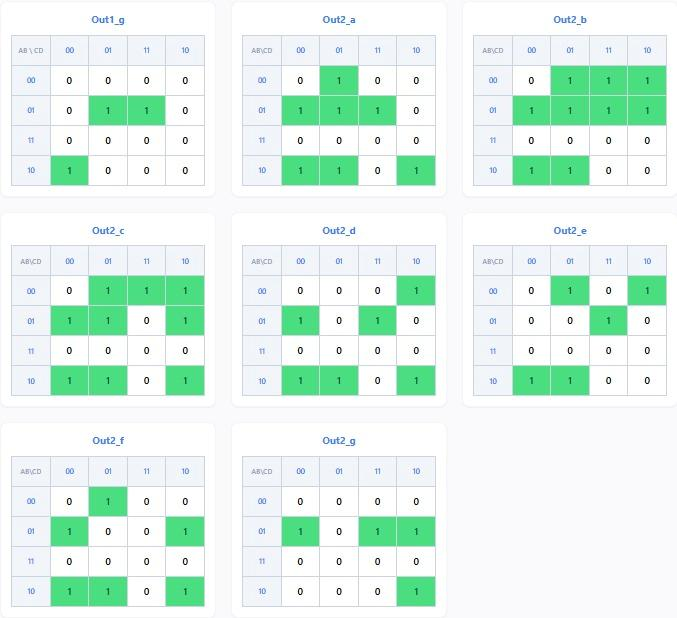
[picture p232: figure]

Diseño a realizar: Se necesita diseñar un decodificador que sea capaz de mostrar en un display a 7 segmentos (ánodo o cátodo común) las iniciales de sus nombres y sus dos apellidos, el día, mes y año de su cumpleaños. Si algún número se repite, deberá tomar alguno de los últimos cuatro dígitos de su matrícula. Tomando en cuenta que solo el año de nacimiento puede repetirse máximo dos veces. La información deberá presentarse en el mismo orden (OJHC2301974); en total se utilizarán once combinaciones. Utilizar un contador para automatizarlo y, de igual forma se debe observar en un conjunto de leds el número binario equivalente de 4 bits. La implementación debe ser usando HDL y el FPGA (Use descripción estructural)

En esta ocasión elaboré mi tabla considerando los dos displays y utilicé en el decodificador (SP1809042367). Para cumplir con los requisitos, decidí usar los últimos cuatro dígitos de una matrícula; sin embargo, elegí una combinación distinta a la de mi matrícula oficial porque coincidía con el mandato y este exige que no se repitan caracteres.

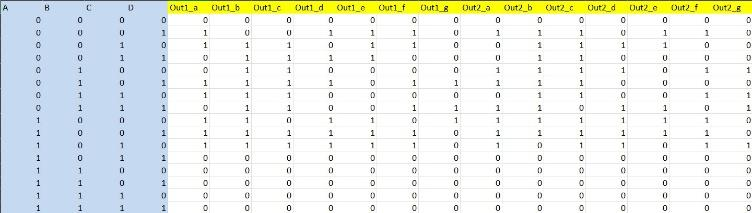
[picture p233: figure]

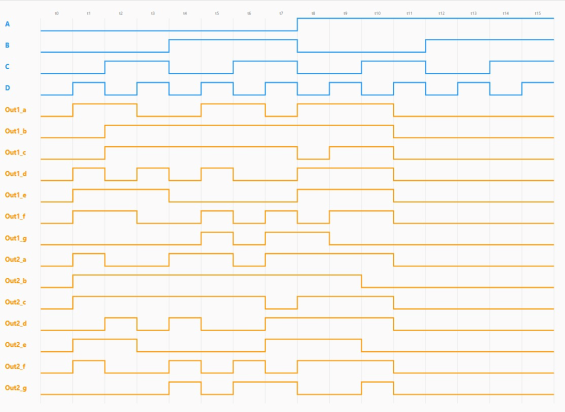
[picture p234: figure]

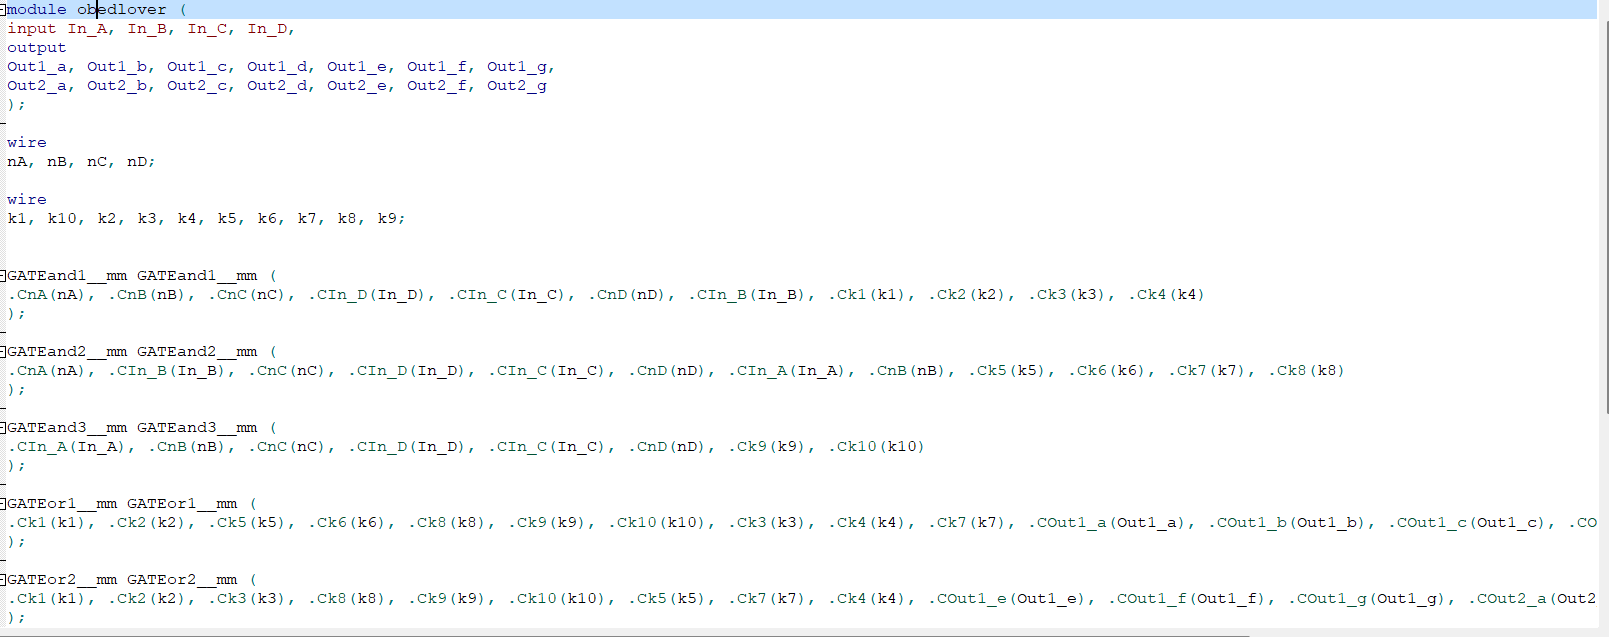
[picture p235: figure]
