mk2442/Itla/digital/impresion-3d/rd-inteligente/Auxiliaries/.thumbnails/thumbnail_3mf.png

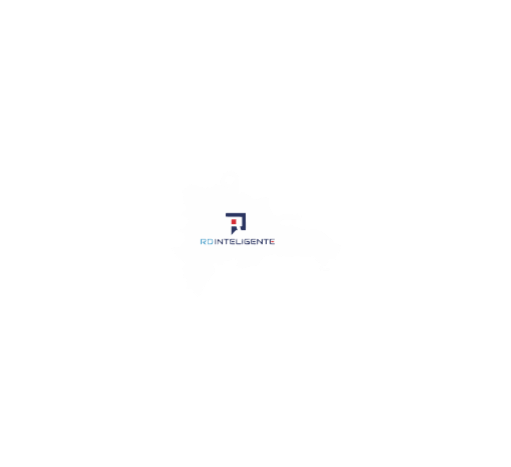
digital/impresion-3d/rd-inteligente/Auxiliaries/.thumbnails/thumbnail_3mf.png
