mk2442/Itla/digital/impresion-3d/rd-inteligente/Metadata/pick_1.png

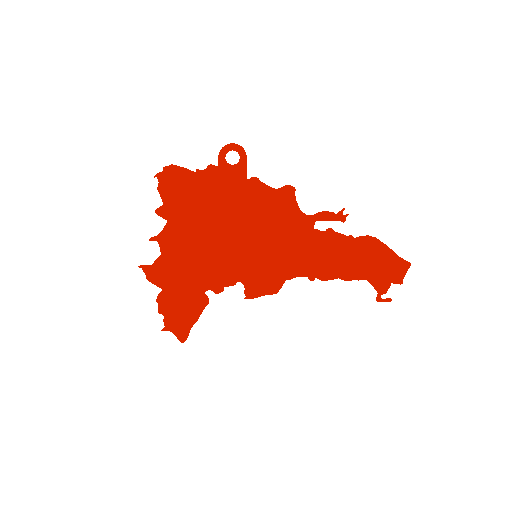
digital/impresion-3d/rd-inteligente/Metadata/pick_1.png
