mk2442/Itla/digital/impresion-3d/rd-inteligente/Metadata/pick_2.png

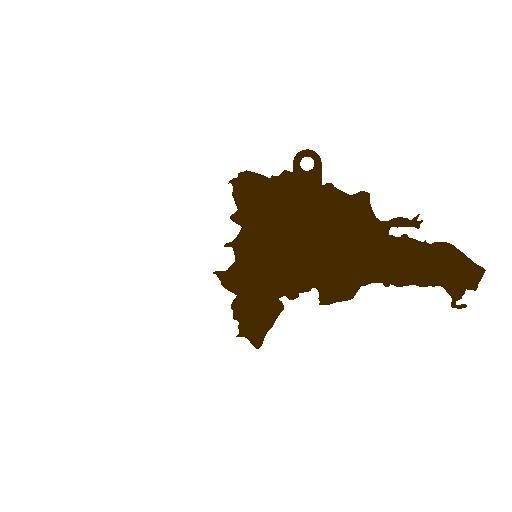
digital/impresion-3d/rd-inteligente/Metadata/pick_2.png
