mk2442/Itla/digital/impresion-3d/rd-inteligente/Metadata/pick_3.png

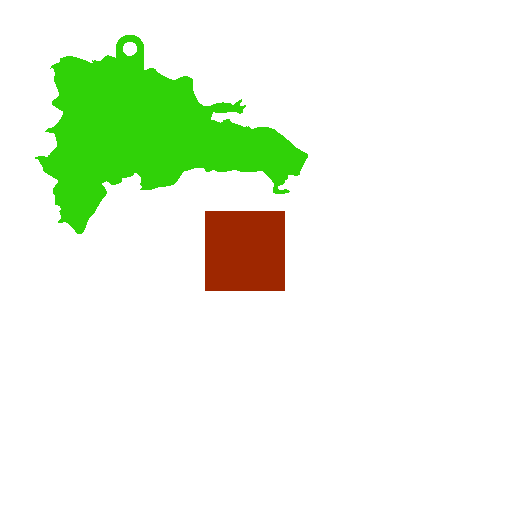
digital/impresion-3d/rd-inteligente/Metadata/pick_3.png
