mk2442/Itla/digital/impresion-3d/rd-inteligente/Metadata/plate_no_light_3.png

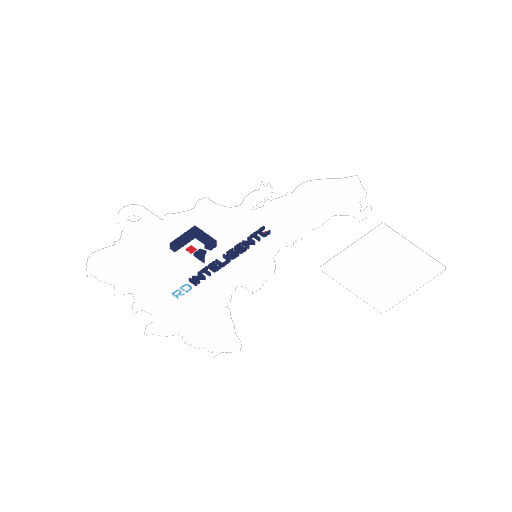
digital/impresion-3d/rd-inteligente/Metadata/plate_no_light_3.png
