mk2442/Itla/digital/impresion-3d/stepper-motor-17hs15/HE_s_v1.jpg

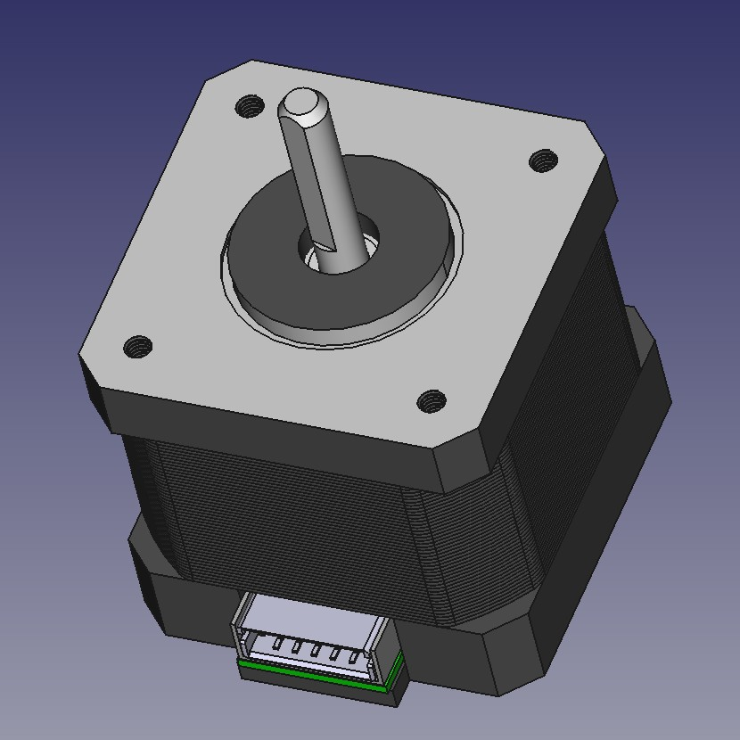
digital/impresion-3d/stepper-motor-17hs15/HE_s_v1.jpg
