mk2442/Itla/digital/impresion-3d/stepper-motor-17hs15/S-X1_V1.jpg

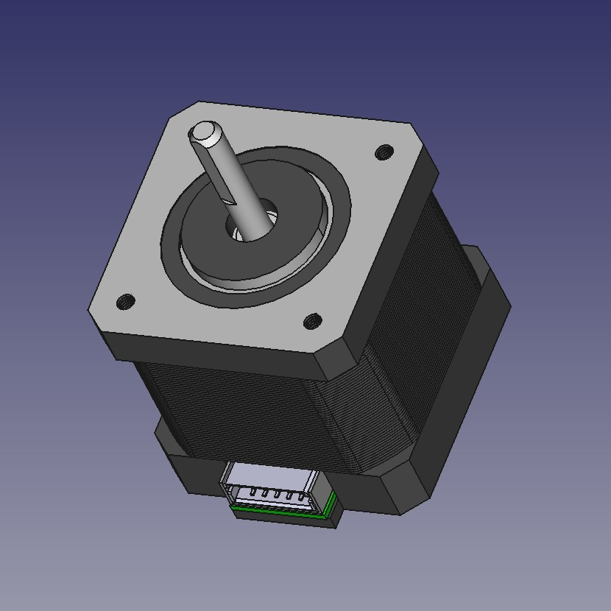
digital/impresion-3d/stepper-motor-17hs15/S-X1_V1.jpg
