mk2442/Itla/digital/impresion-3d/wireless-speaker-cover/Metadata/pick_3.png

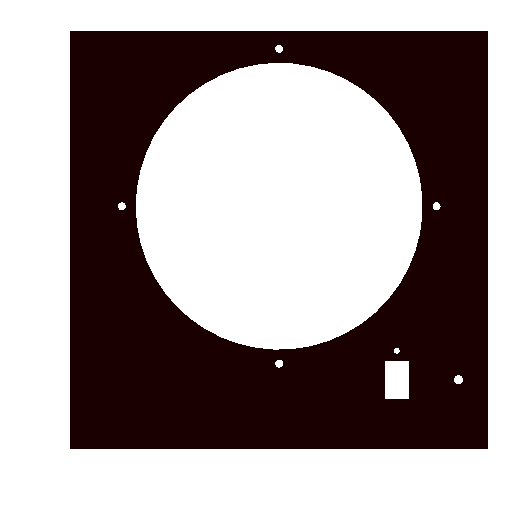
digital/impresion-3d/wireless-speaker-cover/Metadata/pick_3.png
