mk2442/Itla/digital/impresion-3d/wireless-speaker-cover/Metadata/plate_2.png

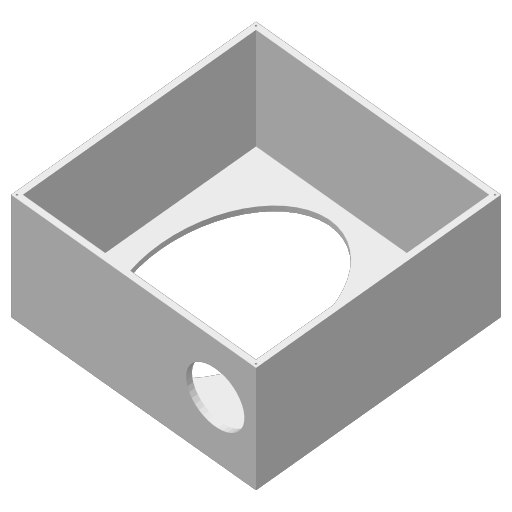
digital/impresion-3d/wireless-speaker-cover/Metadata/plate_2.png
