mk2442/Itla/digital/impresion-3d/wireless-speaker-cover/Metadata/plate_no_light_2.png

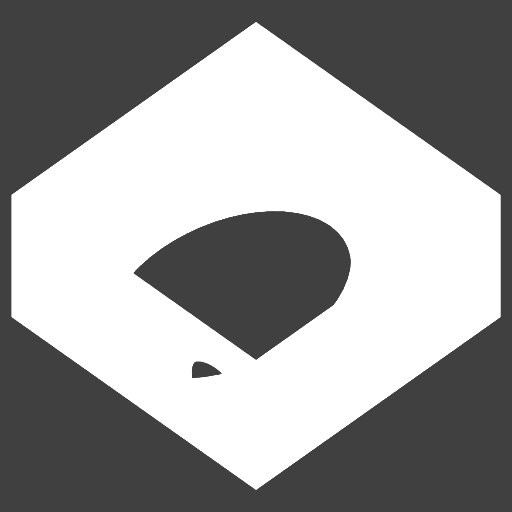
digital/impresion-3d/wireless-speaker-cover/Metadata/plate_no_light_2.png
