mk2442/Itla/solid/greca/Nueva carpeta/Hoja de Drawing.JPG

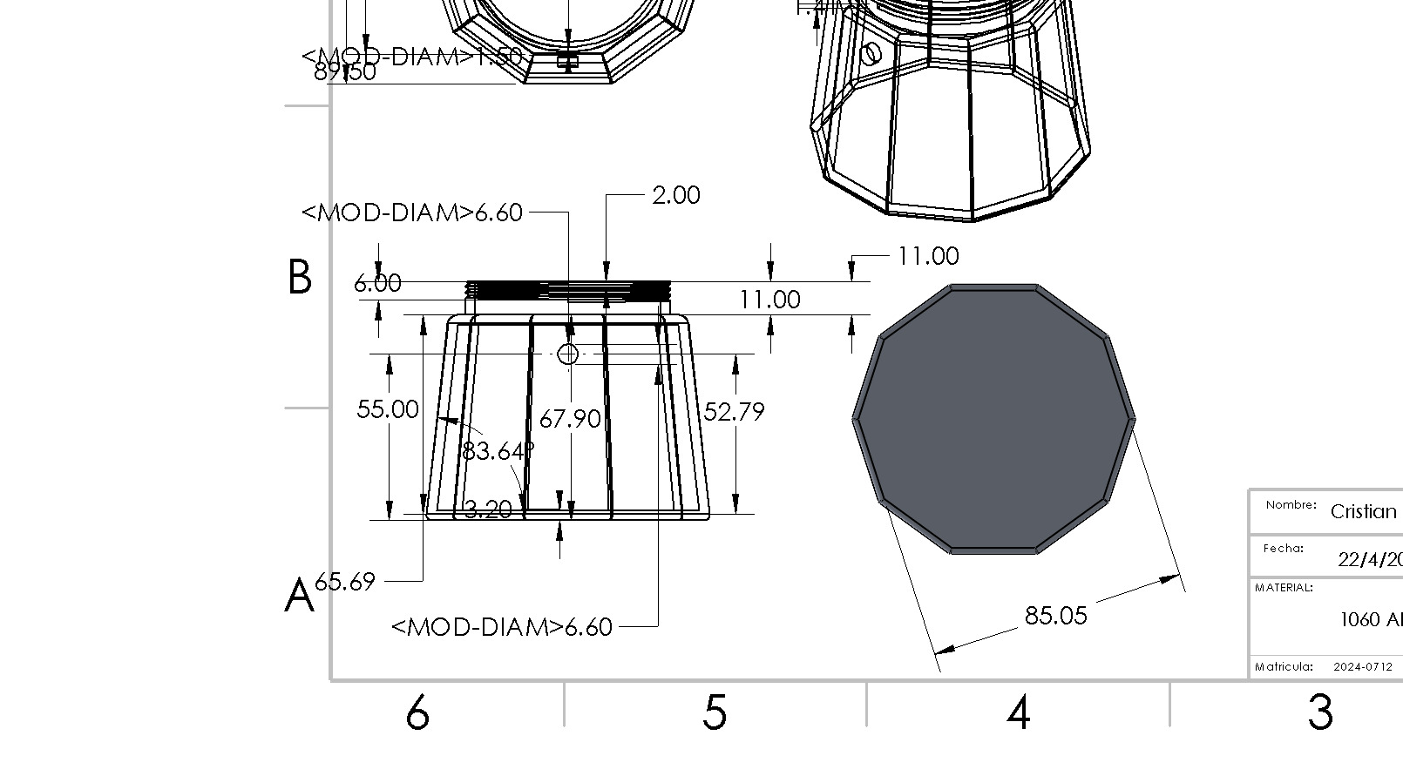
solid/greca/Nueva carpeta/Hoja de Drawing.JPG
