mk2442/Itla/digital/proyectos/rc-kakata-control/production/backups/RC_KAKATA_CONTROL_1.0_2026-02-28_17-51-48_x/bom.csv

Designator | Footprint | Quantity | Value | LCSC Part #
C1, C10, C11, C12, C13, C14, C16, C17, C18, C19, C2, C21, C24, C25, C26, C29, C3, C30, C31, C32, C33, C34, C35, C4, C40, C41, C42, C43, C5, C51, C52, C53, C54, C6, C7, C8, C9 | C_0603 | 37 | 100NF | C14663
C15 | 0603 | 1 | 10nF | C100042
C20, C22, C50 | C_0603 | 3 | 1uF | C559769
C23 | CP_Elec_8x6.2 | 1 | 100uF | C116241
C36, C37 | C_0603 | 2 | 16pF | C327125
C38, C39 | C_0603 | 2 | 20pF | C105621
C45, C47, C48, C49 | CP_Elec_6.3x5.9 | 4 | 100uF | C72478
C55, C56 | 0603 | 2 | 100nF | C519438
C57 | 0603 | 1 | 100nF | C14663
D1, D3 | D_SMC | 2 | SS54 | C22452
D13, D14, D15, D16, D17 | D_SOD-323_TVS | 5 | PESD3V3L1BA | C22466620
D2 | D_SOD-123F | 1 | SMF5.0A | C151296
D4, D6 | D_SOD-123F | 2 | SMF24CA | C3720035
D5 | SMF3.3_SODFL3718X108N | 1 | SMF3.3 | C6165153
J10, J14, J8 | CONN-TH_DB125-2.54-4P-GN | 3 | DB125-2.54-4P-GN | C918122
J11, J13, J17, J19, J2, J21, J23, J3, J4, J5, J7, J9 | CONN-TH_2P-P5.08_DIBO_DB128V-5.08 | 12 | Screw_Terminal_01x02 | C2915639
J12 | PinHeader_1x07_P2.54mm_Vertical | 1 | Conn_01x07 | C6332200
J6 | 2x20_Shrouded | 1 | Raspberry_Pi_2x20_PTH | C9138
L1 | 0603 | 1 | 130nH | C701178
LED1, LED2, LED3, LED4, LED5 | 0603 | 5 | LED_0603_Red | C965799
R1, R2, R3, R4 | R_0603 | 4 | 4.7K | C99782
R10, R9 | R_0603 | 2 | 2.2K | C114662
R11, R6, R8 | R_0603 | 3 | 1K | C22548
R12, R18 | R_0603 | 2 | 300 | C114617
R13, R14, R16, R19, R38, R39, R5, R52, R7 | R_0603 | 9 | 10K | C98220
R15, R17, R20, R21, R22, R23, R24, R25, R26, R27, R28, R29, R30, R31, R32, R33, R34, R35, R36, R37, R40, R41, R42, R43, R44, R53, R54, R55 | R_0603 | 28 | 22K | C114065
R46, R47, R48, R49, R50 | R_0603 | 5 | 33R | C108661
R51 | R_0603 | 1 | 100K | C14675
SW1, SW2, SW3, SW4, SW6 | SW-SMD_L3.9-W3.0-P4.45 | 5 | TS-1088-AR02016 | C720477
U3 | LQFP-176_L24.0-W24.0-P0.50-LS26.0-BL | 1 | STM32H743IIT6 | C89597
U4 | JOYTICK-TH_YF16S-FL7.2-B5KB-45-10-Y_1 | 1 | YK16S-L7.2-B10KA(32-8)-G-A29 | C37323746
U5 | QFN-24_L4.0-W4.0-P0.50-BL-EP2.7 | 1 | MPU-6050_C24112 | C24112
U8 | SOIC-8_L5.3-W5.3-P1.27-LS8.0-BL | 1 | W25Q128JVSIQ | C97521
X1 | Crystal_SMD_3225-4Pin_3.2x2.5mm | 1 | 25MHZ | C5280577
X2 | MC-306_4P-L8.0-W3.2-P5.5-BL | 1 | 32.768kHz | C16320
