mk2442/Itla/solid/p/Ensamblaje1 - Pieza1-1-1.STL

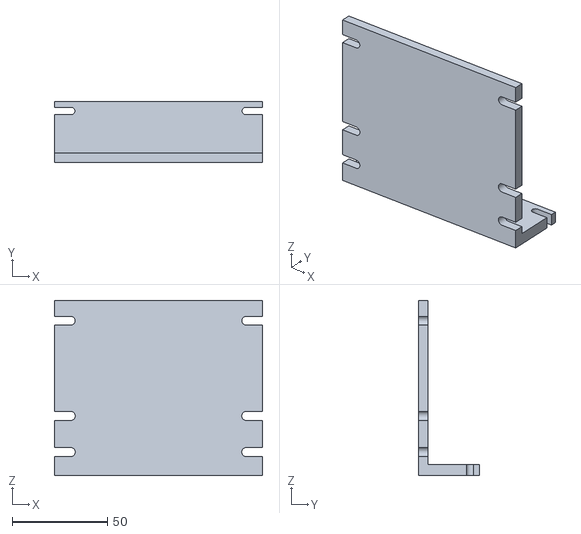
[picture p263: CAD file, 2026-11-01]
solid/p/Ensamblaje1 - Pieza1-1-1.STL
109.1 x 32.0 x 92.0
