mk2442/Itla/solid/empaque/2/Ensamblaje1.SLDASM

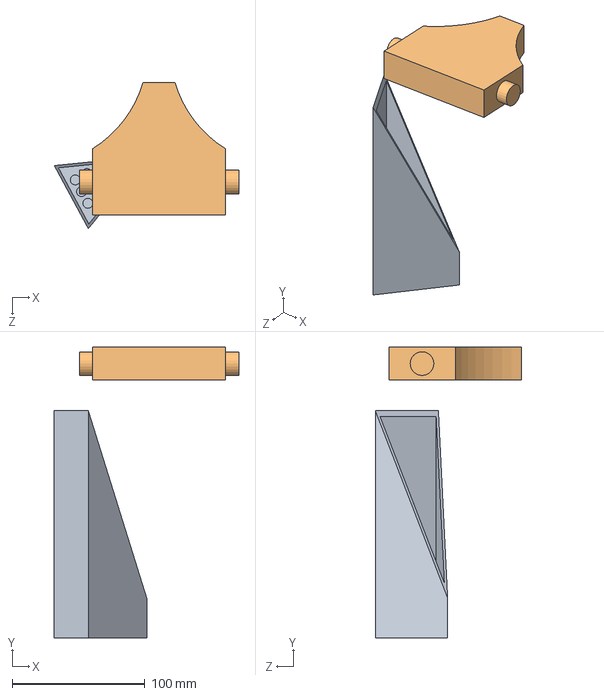
[picture p264: CAD file, 2026-11-01]
solid/empaque/2/Ensamblaje1.SLDASM
138.8 x 218.9 x 110.2 mm
Pieza1
Pieza2
