mk2442/Itla/solid/ensamble 1/Assem1.SLDASM

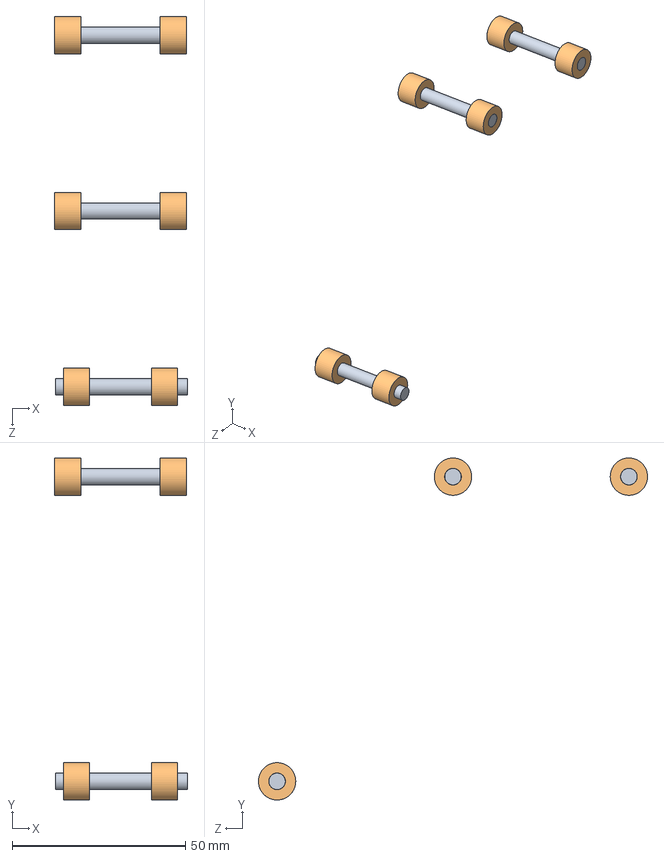
[picture p265: CAD file, 2026-11-01]
solid/ensamble 1/Assem1.SLDASM
38.5 x 98.8 x 112.4 mm
collar x 6
axle x 3
