mk2442/Itla/solid/asemble 2/Assem2.SLDASM

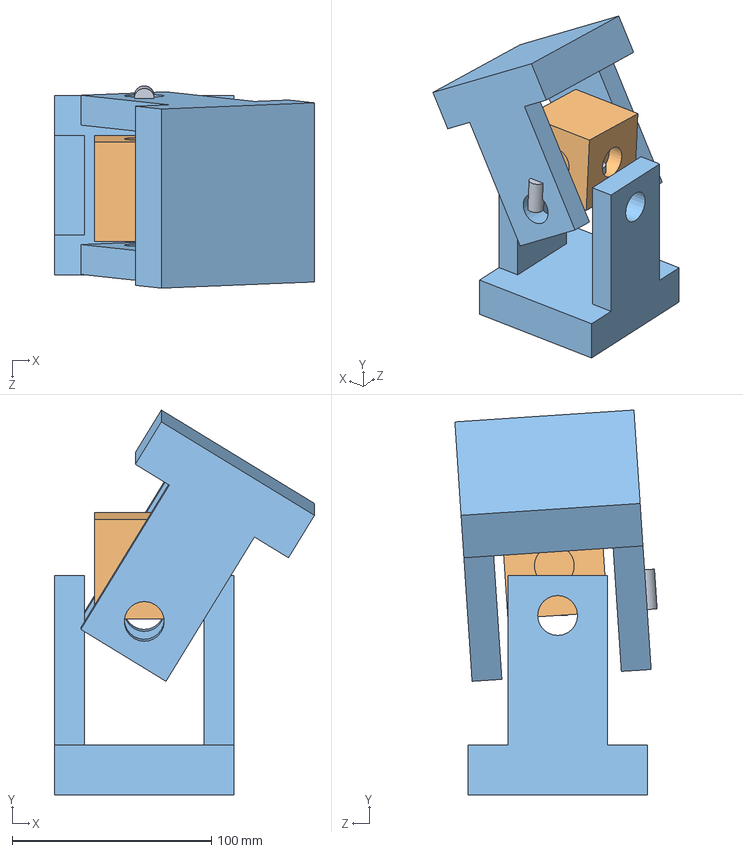
[picture p266: CAD file, 2026-11-01]
solid/asemble 2/Assem2.SLDASM
130.4 x 193.0 x 101.4 mm
u bracket x 2
block
pin x 4
