mk2442/Itla/solid/asemble/Assem1.SLDASM

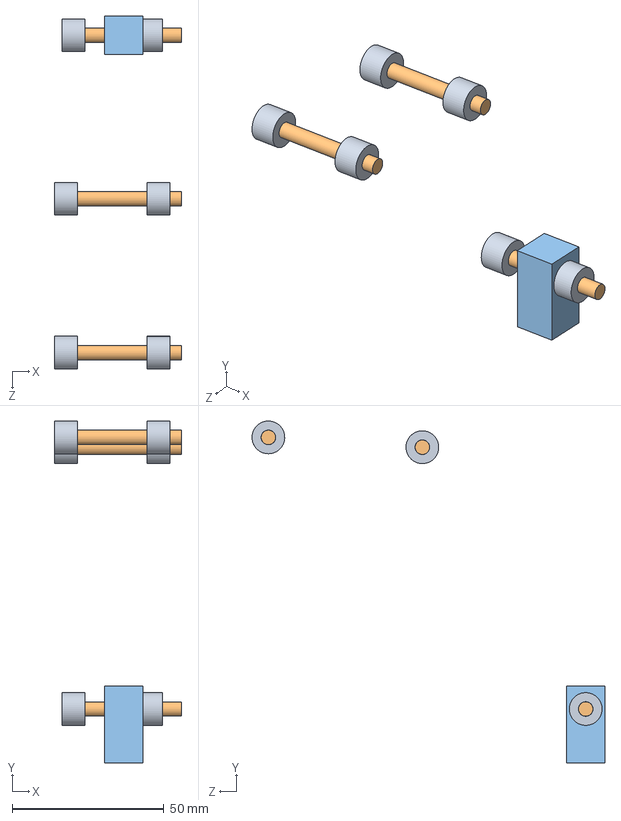
[picture p267: CAD file, 2026-11-01]
solid/asemble/Assem1.SLDASM
41.9 x 112.6 x 116.2 mm
clevis
axle x 3
collar x 6
