mk2442/Itla/solid/ensamble 2/Assem1.SLDASM

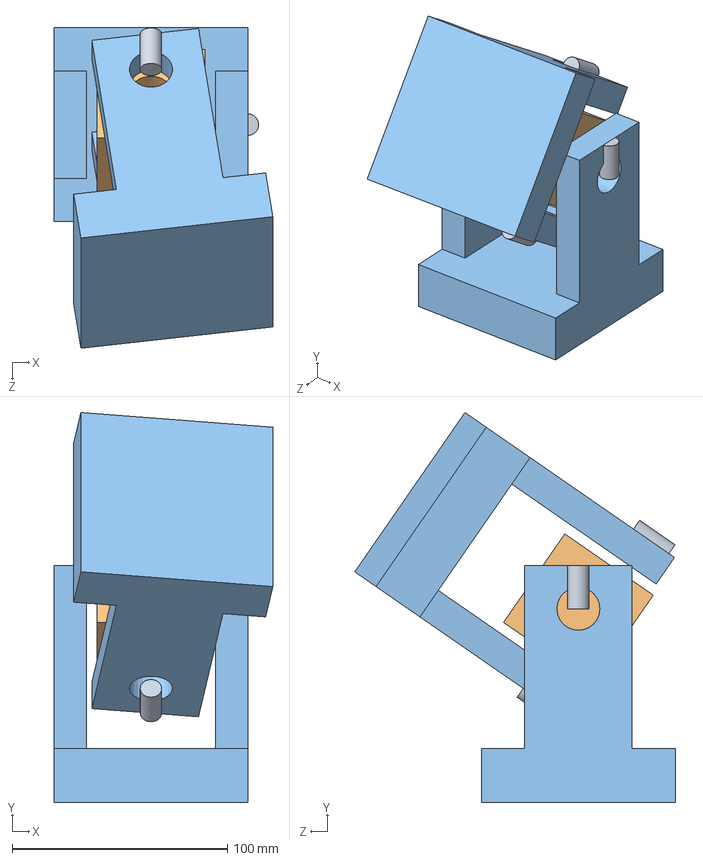
[picture p268: CAD file, 2026-11-01]
solid/ensamble 2/Assem1.SLDASM
101.6 x 181.2 x 148.9 mm
u bracket x 2
block
pin x 4
