mk2442/Itla/solid/p/Ensamblaje1.SLDASM

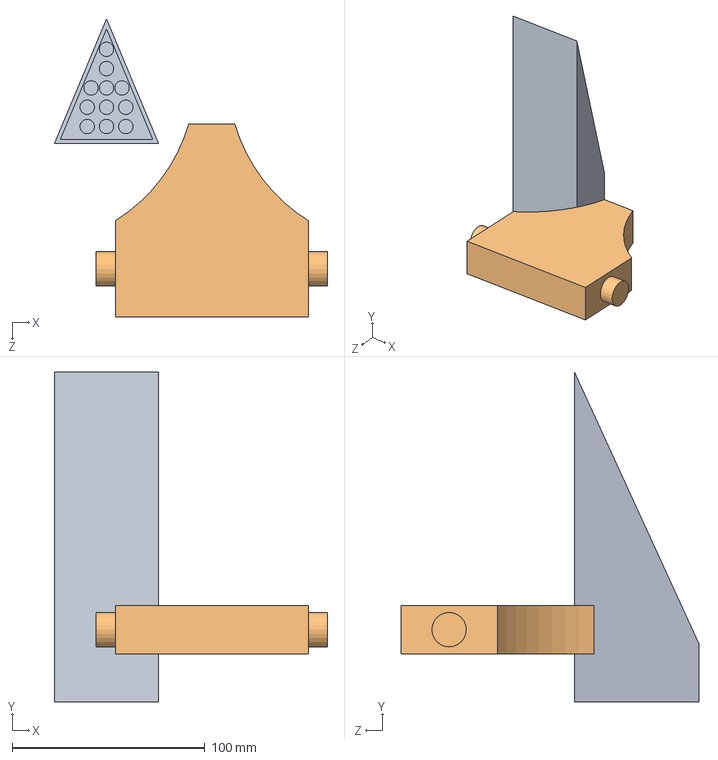
[picture p269: CAD file, 2026-11-01]
solid/p/Ensamblaje1.SLDASM
141.6 x 171.0 x 154.6 mm
Pieza1
Pieza2
