mk2442/Itla/solid/asemble 3/Assem1.SLDASM

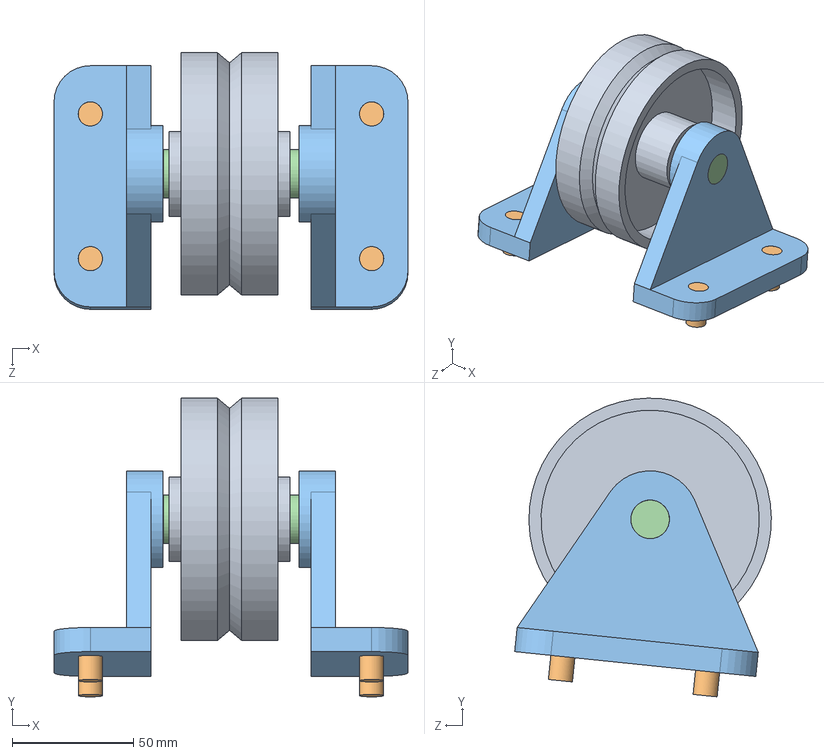
[picture p270: CAD file, 2026-11-01]
solid/asemble 3/Assem1.SLDASM
146.0 x 123.2 x 105.9 mm
axle40
nraket100 x 2
pin x 4
will
