mk2442/Itla/solid/ensable 3/Assem1.SLDASM

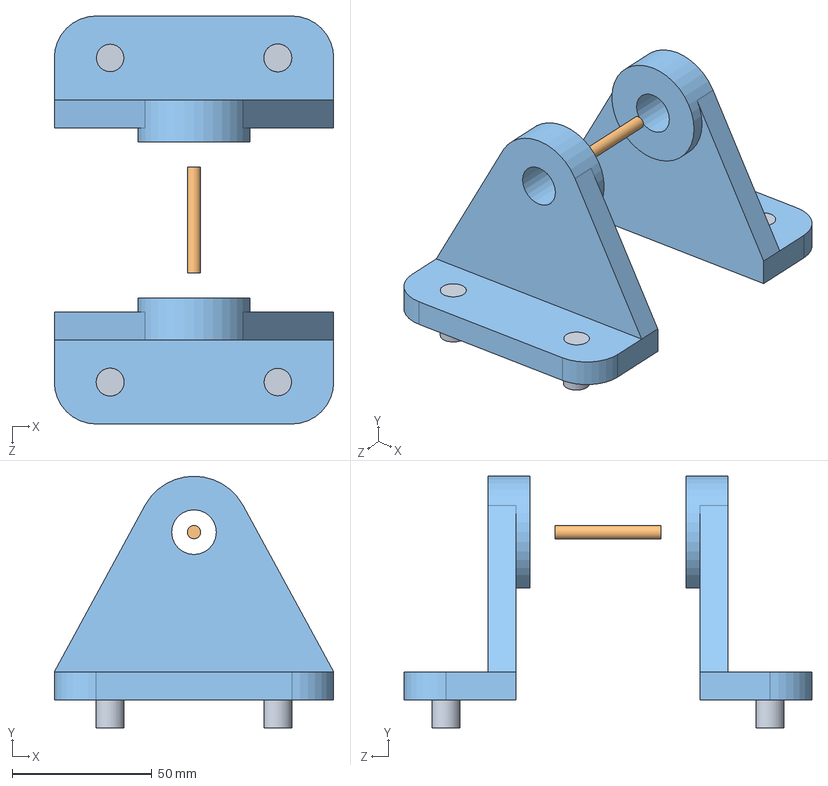
[picture p271: CAD file, 2026-11-01]
solid/ensable 3/Assem1.SLDASM
100.0 x 90.0 x 146.0 mm
braket x 2
axle
pin x 4
