mk2442/Itla/solid/p/Ensamblaje1 - Pieza2-2-1.3mf

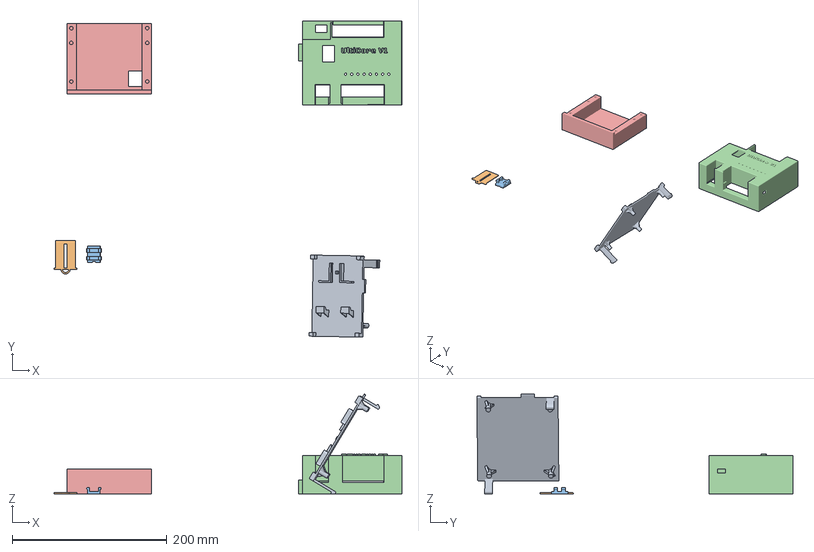
[picture p272: CAD file, 2026-11-01]
solid/p/Ensamblaje1 - Pieza2-2-1.3mf
450.0 x 409.1 x 129.2 mm
parte inferior case plc def.STL
cuña plc def.STL
tapa plc.STL
parte superior de case PLC def.STL
Ensamblaje1 - Pieza2-2-1.STL
Texto
