mk2442/Itla/solid/parcial final/knuckle joint.SLDASM

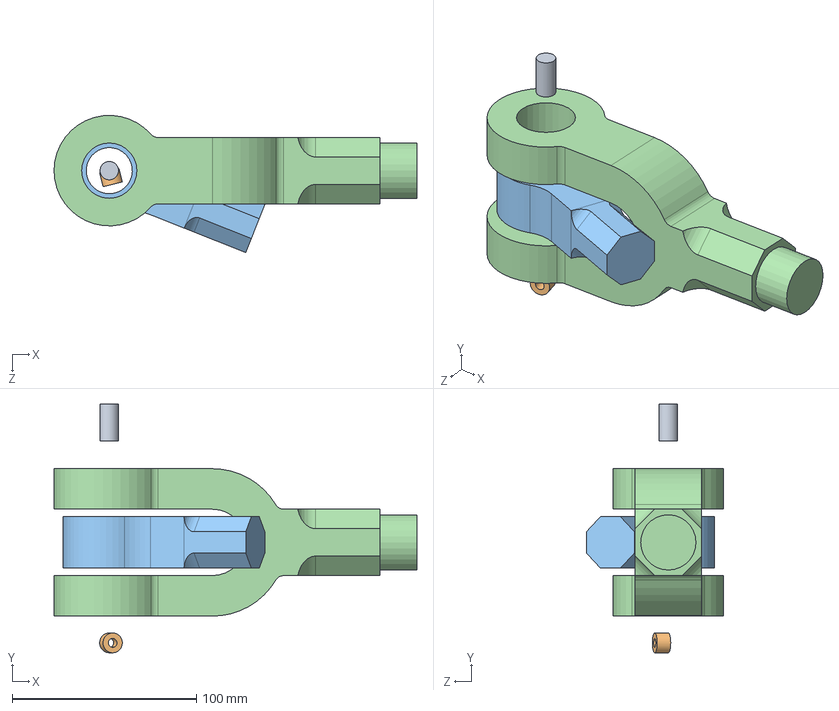
[picture p273: CAD file, 2026-11-01]
solid/parcial final/knuckle joint.SLDASM
197.0 x 134.9 x 74.4 mm
fork
eye end
collar
pin
