mk2442/Itla/solid/a/knucle point.SLDASM

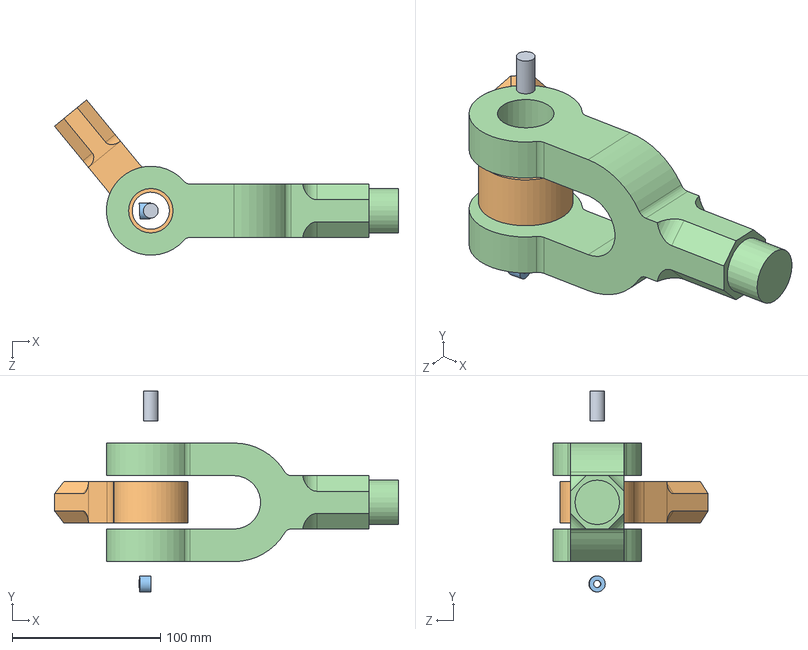
[picture p274: CAD file, 2026-11-01]
solid/a/knucle point.SLDASM
232.0 x 135.4 x 104.7 mm
fork
collar
eye end
pin
