mk2442/Itla/solid/p/Ensamblaje1 - Pieza2-2.STL

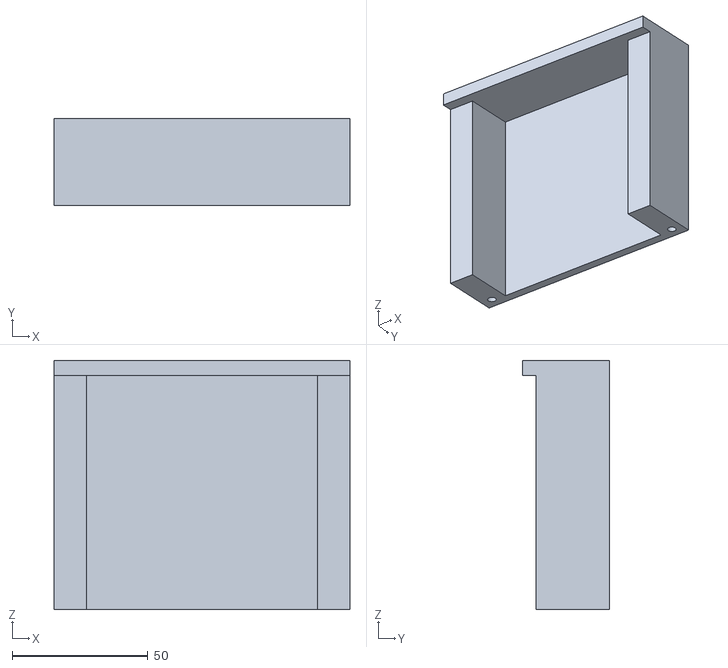
[picture p275: CAD file, 2026-11-01]
solid/p/Ensamblaje1 - Pieza2-2.STL
109.0 x 32.0 x 91.8
