mk2442/Itla/digital/impresion-3d/llavero-rdx/LlaveroRDXv1.3mf

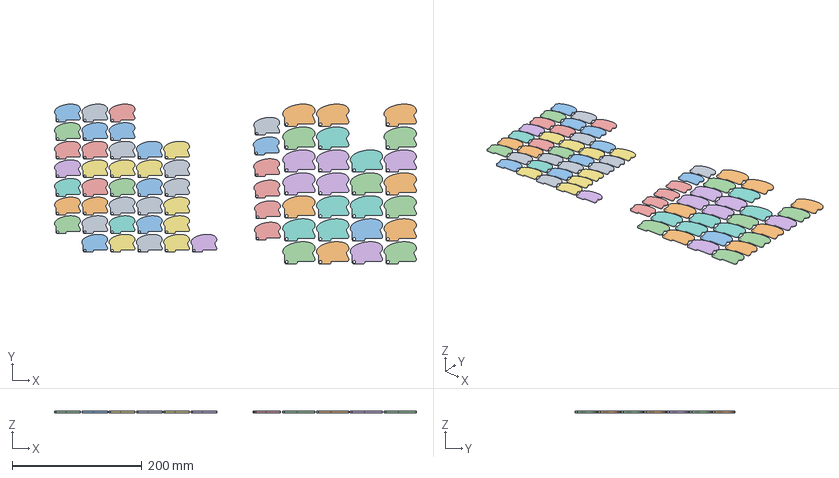
[picture p276: CAD file, 2026-11-01]
digital/impresion-3d/llavero-rdx/LlaveroRDXv1.3mf
557.0 x 246.1 x 2.50 mm
LlaveroRDXv1.STL
LlaveroRDXv1.STL 4
LlaveroRDXv1.STL 1
LlaveroRDXv1.STL 4 1
LlaveroRDXv1.STL 2
LlaveroRDXv1.STL 4 2
LlaveroRDXv1.STL 3
LlaveroRDXv1.STL 4 3
LlaveroRDXv1.STL 5
LlaveroRDXv1.STL 4 4
LlaveroRDXv1.STL 6
LlaveroRDXv1.STL 4 5
LlaveroRDXv1.STL 7
LlaveroRDXv1.STL 4 6
LlaveroRDXv1.STL 8
LlaveroRDXv1.STL 4 7
LlaveroRDXv1.STL 9
LlaveroRDXv1.STL 4 8
LlaveroRDXv1.STL 10
LlaveroRDXv1.STL 4 9
LlaveroRDXv1.STL 11
LlaveroRDXv1.STL 4 10
LlaveroRDXv1.STL 12
LlaveroRDXv1.STL 4 11
LlaveroRDXv1.STL 13
LlaveroRDXv1.STL 4 12
LlaveroRDXv1.STL 14
LlaveroRDXv1.STL 4 13
LlaveroRDXv1.STL 15
LlaveroRDXv1.STL 4 14
LlaveroRDXv1.STL 16
LlaveroRDXv1.STL 4 15
LlaveroRDXv1.STL 17
LlaveroRDXv1.STL 4 16
LlaveroRDXv1.STL 4 17
LlaveroRDXv1.STL 18
LlaveroRDXv1.STL 19
LlaveroRDXv1.STL 4 18
LlaveroRDXv1.STL 20
LlaveroRDXv1.STL 4 19
LlaveroRDXv1.STL 21
LlaveroRDXv1.STL 4 20
LlaveroRDXv1.STL 22
LlaveroRDXv1.STL 4 21
LlaveroRDXv1.STL 23
LlaveroRDXv1.STL 4 22
LlaveroRDXv1.STL 24
LlaveroRDXv1.STL 4 23
LlaveroRDXv1.STL 25
LlaveroRDXv1.STL 4 24
LlaveroRDXv1.STL 26
LlaveroRDXv1.STL 4 25
LlaveroRDXv1.STL 27
LlaveroRDXv1.STL 28
LlaveroRDXv1.STL 29
LlaveroRDXv1.STL 30
LlaveroRDXv1.STL 31
LlaveroRDXv1.STL 32
LlaveroRDXv1.STL 33
LlaveroRDXv1.STL 34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
