mk2442/Itla/digital/impresion-3d/logo/base.stl

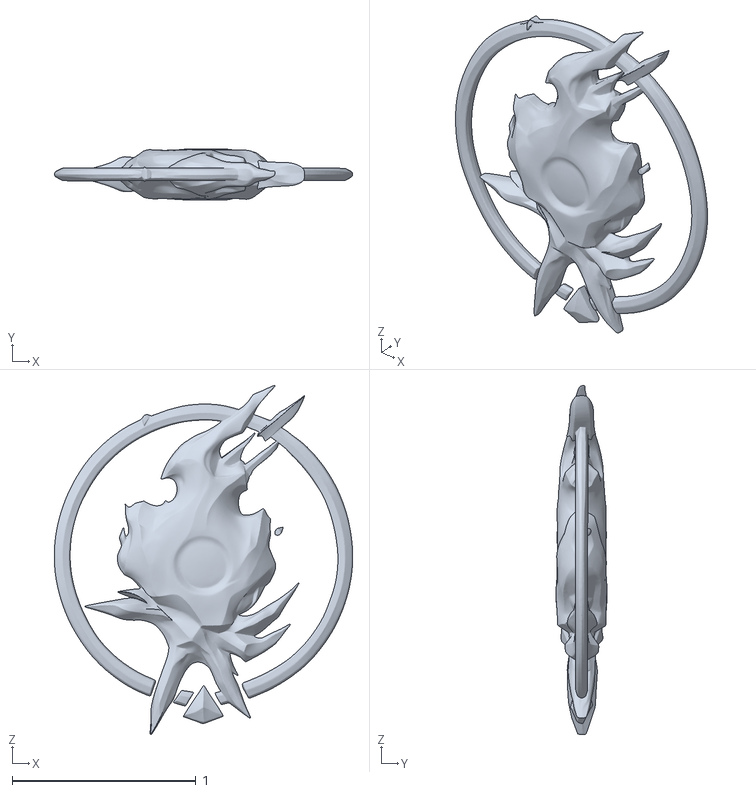
[picture p277: CAD file, 2026-11-01]
digital/impresion-3d/logo/base.stl
1.62 x 0.278 x 1.90
