mk2442/Itla/digital/proyectos/rc-kakata-control/RC-KAKATA-CONTROL.step

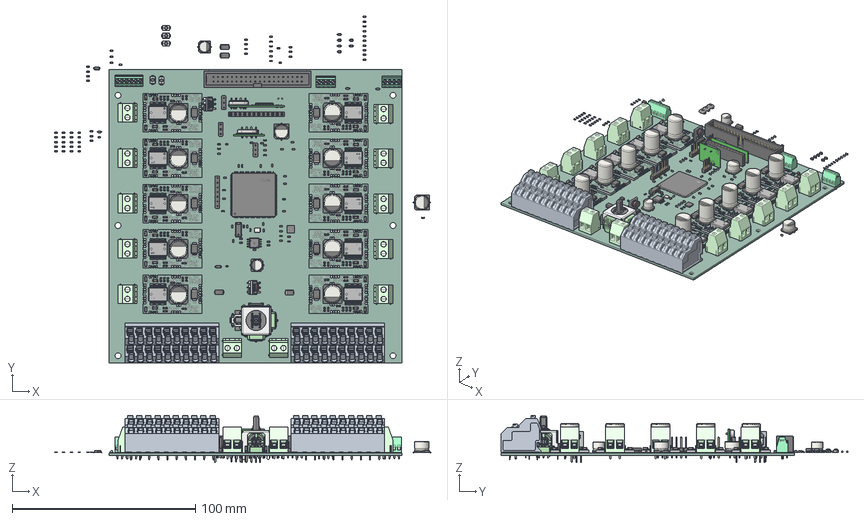
[picture p279: CAD file, 2026-11-01]
digital/proyectos/rc-kakata-control/RC-KAKATA-CONTROL.step
205.2 x 189.3 x 25.7 mm
C_0603_1608Metric x 57
QFN-24_L4.0-W4.0-P0.50-TL-EP2.6
D_SOD-323 x 9
C_0805_2012Metric x 40
D_SMB x 10
CP_Elec_10x14.3 x 10
R_0603_1608Metric x 130
POWERSSO-36_L10.3-W7.5-H2.3-P0.50-LS10.3-BL-EP_VNH5050ATR-E x 10
H_bridge_copper x 10
H_bridge_pad x 10
H_bridge_via x 10
H_bridge_silkscreen x 10
H_bridge_soldermask x 20
H_bridge_PCB x 10
LQFP-176_L24.0-W24.0-H1.4-LS26.0-P0.50
CONN-TH_2P-P5.08_DIBO_DB128V-5.08 x 12
Module_RF_Transmisor_WL102-341_Vertical
D_SMA x 4
SW-SMD_L3.9-W2.9-H2.0-LS4.8 x 5
LED_0603_1608Metric x 4
DG250T-5.0-20P-11-00A&Z(H) x 2
CP_Elec_8x6.2 x 2
JOYTICK-TH_YF16S-FL7.2-B5KB-45-10-Y_1
MC-306_4P-L8.0-W3.2-H2.4-LS3.8-P5.5
CONN-TH_DB125-2.54-4P-GN x 2
Crystal_SMD_3225-4Pin_3.2x2.5mm
IDC-Header_2x20_P2.54mm_Vertical
Module_RF_Receiver_WL101-341_Horizontal
D_SOD-123F x 2
PCB, DD0503MA ULTRA MINI DC 3.7V 4.5V 5V TO 3.3V DC DC STEP DOWN CONVERTER BUCK MODULE x 2
SMD RESISTOR, DD0503MA ULTRA MINI DC 3.7V 4.5V 5V TO 3.3V DC DC STEP DOWN CONVERTER BUCK MODULE x 6
PIN HEADER, 1X3, 2.54 mm, DD0503MA ULTRA MINI DC 3.7V 4.5V 5V TO 3.3V DC DC STEP DOWN CONVERTER BUCK MODULE x 2
6R8 SMD INDUCTOR, DD0503MA ULTRA MINI DC 3.7V 4.5V 5V TO 3.3V DC DC STEP DOWN CONVERTER BUCK MODULE x 2
MICRO REG, DD0503MA ULTRA MINI DC 3.7V 4.5V 5V TO 3.3V DC DC STEP DOWN CONVERTER BUCK MODULE x 2
PinHeader_1x07_P2.54mm_Vertical
PinHeader_1x03_P2.54mm_Vertical x 3
D_SOD-523
CP_Elec_6.3x5.9 x 2
PinSocket_1x12_P2.54mm_Vertical
CONN-TH_DB125-2.54-6P-GN
SOIC-8_L5.3-W5.3-H1.9-LS7.9-P1.27
RC-KAKATA-CONTROL_PCB
