mk2442/Itla/digital/proyectos/troca-mcu-stm32g474/H_bridge.step

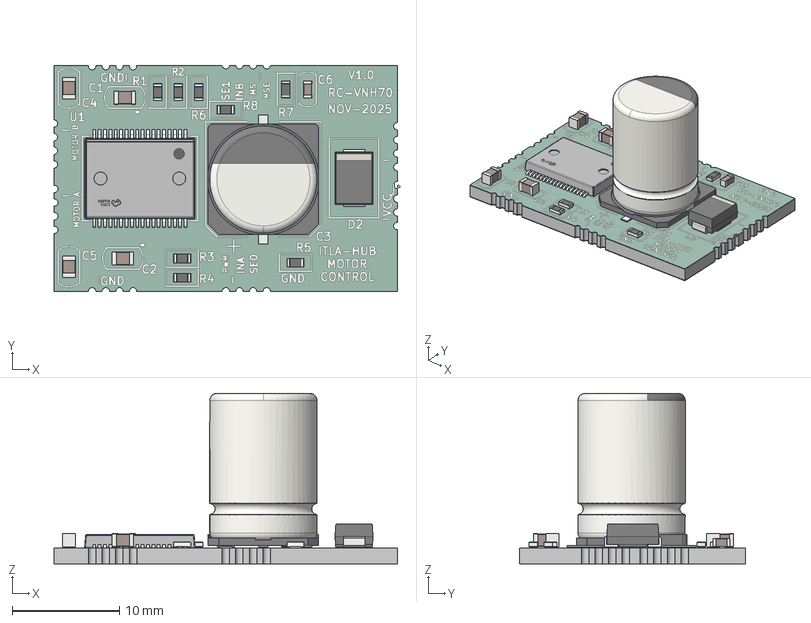
[picture p280: CAD file, 2026-11-01]
digital/proyectos/troca-mcu-stm32g474/H_bridge.step
32.2 x 21.0 x 15.9 mm
C_0805_2012Metric x 4
D_SMB
CP_Elec_10x14.3
R_0603_1608Metric x 8
C_0603_1608Metric
POWERSSO-36_L10.3-W7.5-H2.3-P0.50-LS10.3-BL-EP_VNH5050ATR-E
H_bridge_silkscreen
H_bridge_soldermask x 2
H_bridge_PCB
