mk2442/Itla/solid/a/fork.SLDPRT

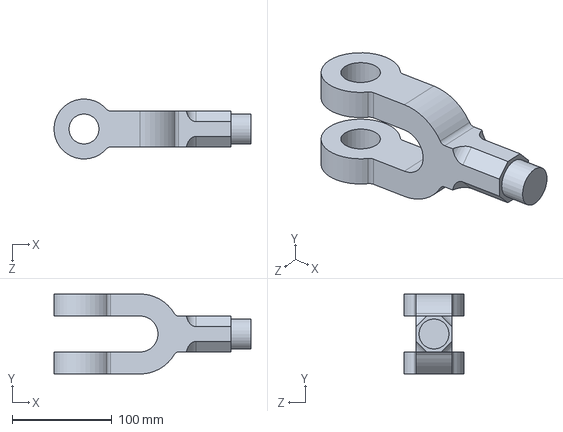
[picture p281: CAD file, 2026-11-01]
solid/a/fork.SLDPRT
197.0 x 80.0 x 59.9 mm
