mk2442/Itla/solid/asemble 2/u bracket.SLDPRT

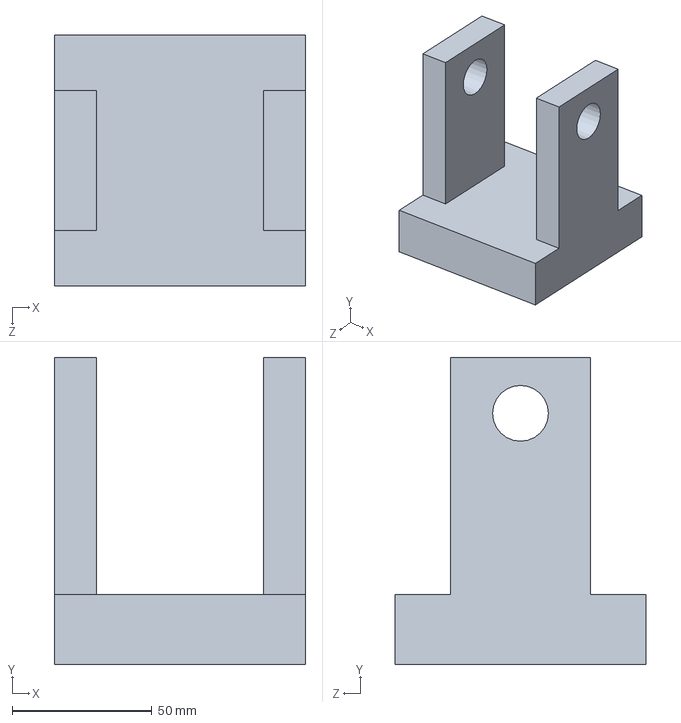
[picture p282: CAD file, 2026-11-01]
solid/asemble 2/u bracket.SLDPRT
90.0 x 110.0 x 90.0 mm
