mk2442/Itla/solid/asemble 3/axle40.SLDPRT

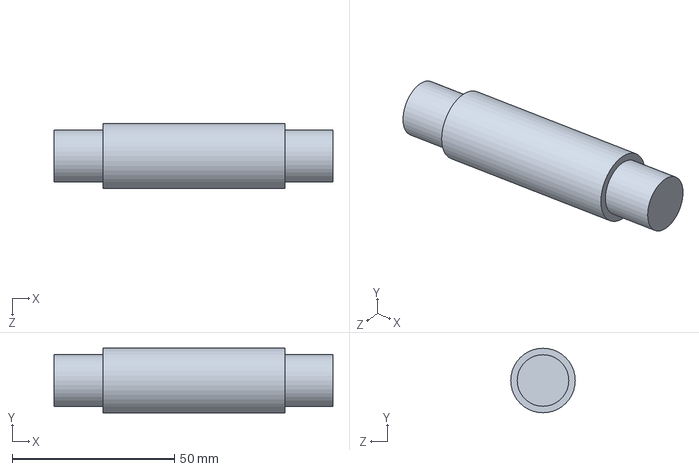
[picture p283: CAD file, 2026-11-01]
solid/asemble 3/axle40.SLDPRT
86.0 x 19.9 x 19.9 mm
