mk2442/Itla/solid/asemble/clevis.SLDPRT

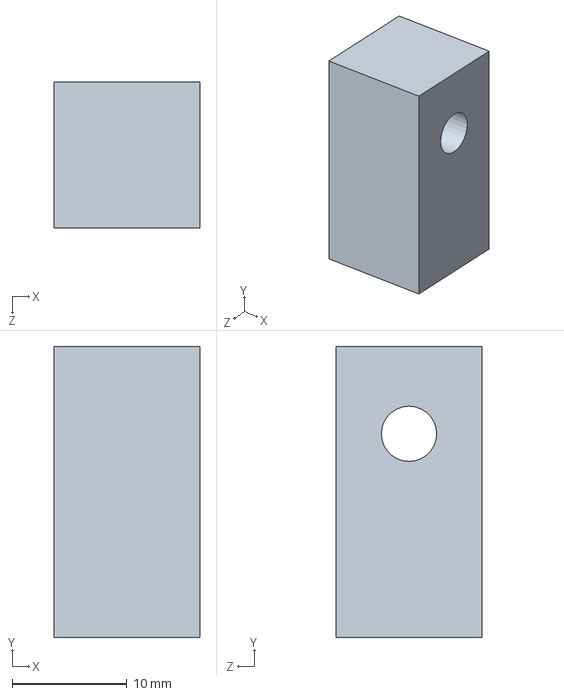
[picture p284: CAD file, 2026-11-01]
solid/asemble/clevis.SLDPRT
12.7 x 25.4 x 12.7 mm
