mk2442/Itla/solid/cafetera/junta de goma.SLDPRT

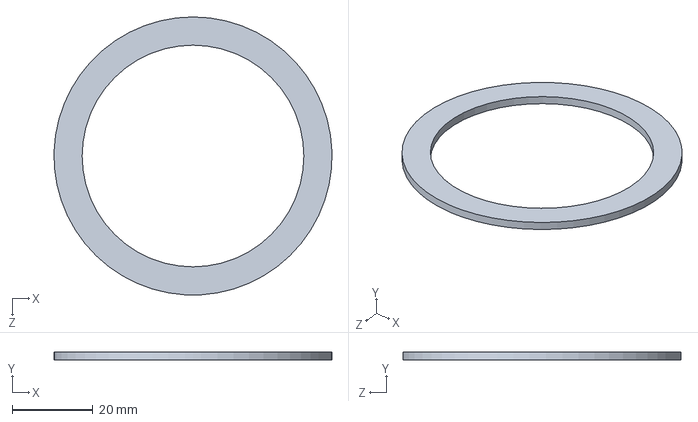
[picture p285: CAD file, 2026-11-01]
solid/cafetera/junta de goma.SLDPRT
69.0 x 2.00 x 69.0 mm
