mk2442/Itla/solid/eco/ss.SLDPRT

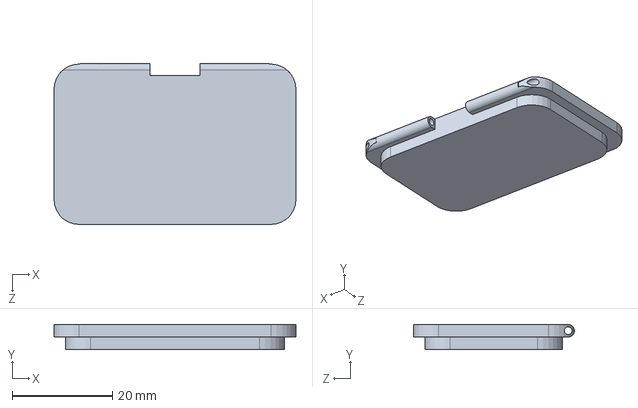
[picture p286: CAD file, 2026-11-01]
solid/eco/ss.SLDPRT
48.2 x 5.00 x 32.0 mm
