mk2442/Itla/solid/empaque/2/Pieza2.SLDPRT

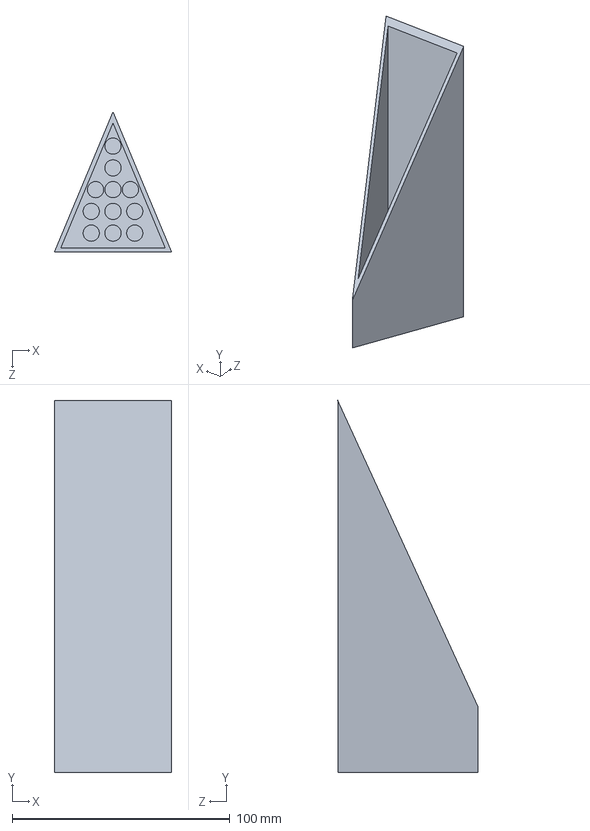
[picture p287: CAD file, 2026-11-01]
solid/empaque/2/Pieza2.SLDPRT
54.0 x 171.0 x 64.6 mm
