mk2442/Itla/solid/ensable 3/pin.SLDPRT

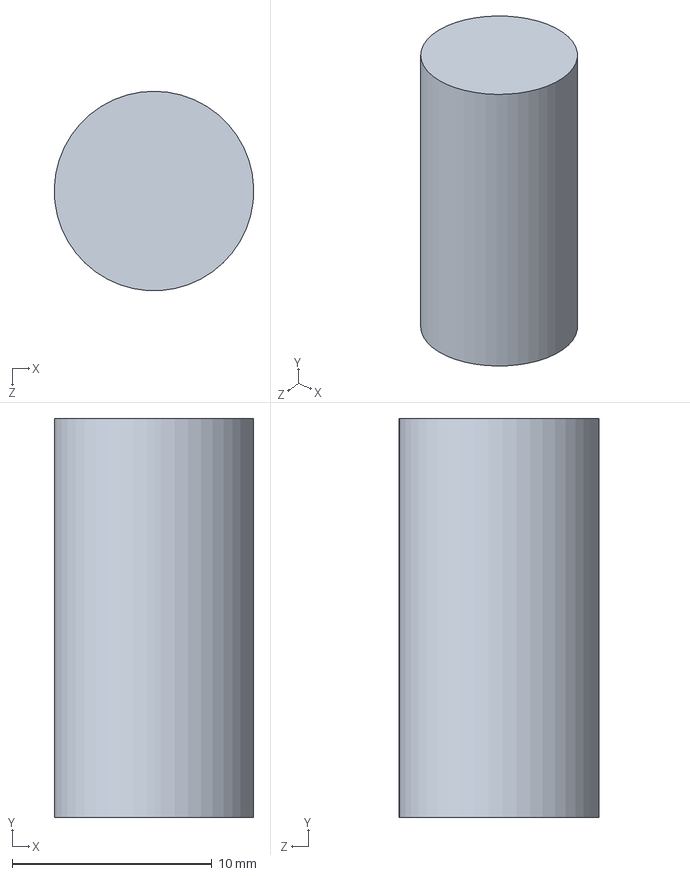
[picture p288: CAD file, 2026-11-01]
solid/ensable 3/pin.SLDPRT
9.99 x 20.0 x 10.0 mm
