mk2442/Itla/solid/ensamble 1/collar.SLDPRT

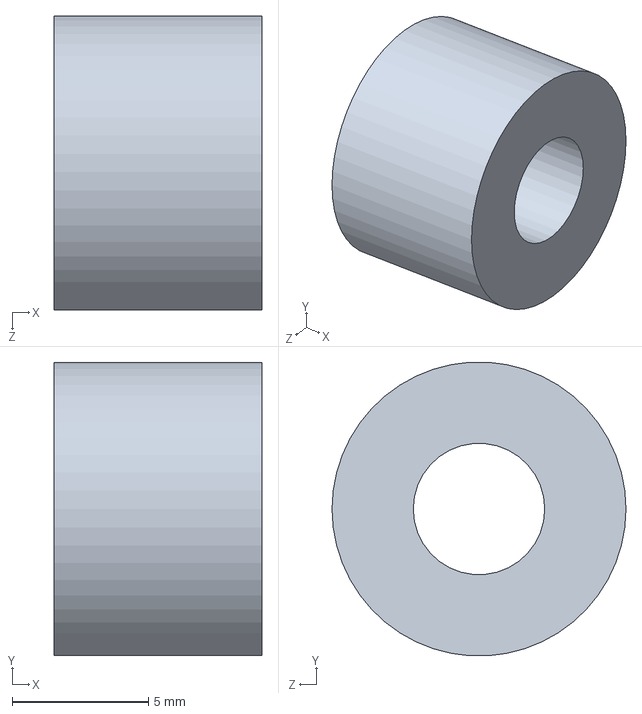
[picture p289: CAD file, 2026-11-01]
solid/ensamble 1/collar.SLDPRT
7.62 x 10.8 x 10.8 mm
