mk2442/Itla/solid/ensamble 2/block.SLDPRT

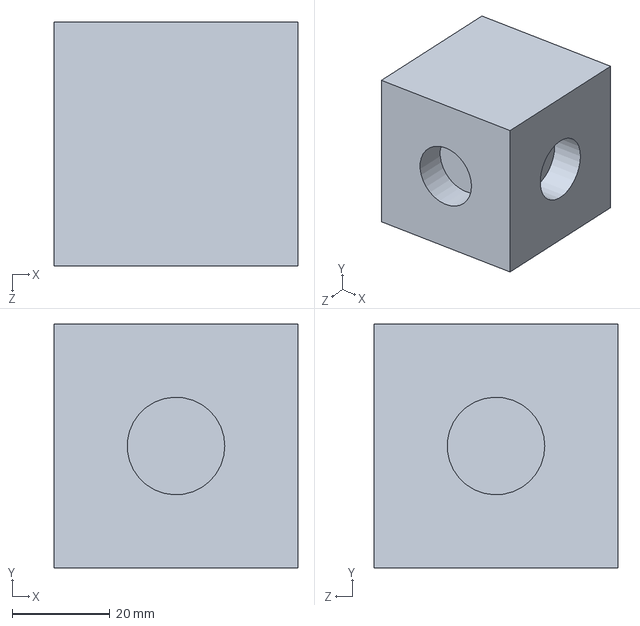
[picture p290: CAD file, 2026-11-01]
solid/ensamble 2/block.SLDPRT
50.0 x 50.0 x 50.0 mm
