mk2442/Itla/solid/examen final/eye end.SLDPRT

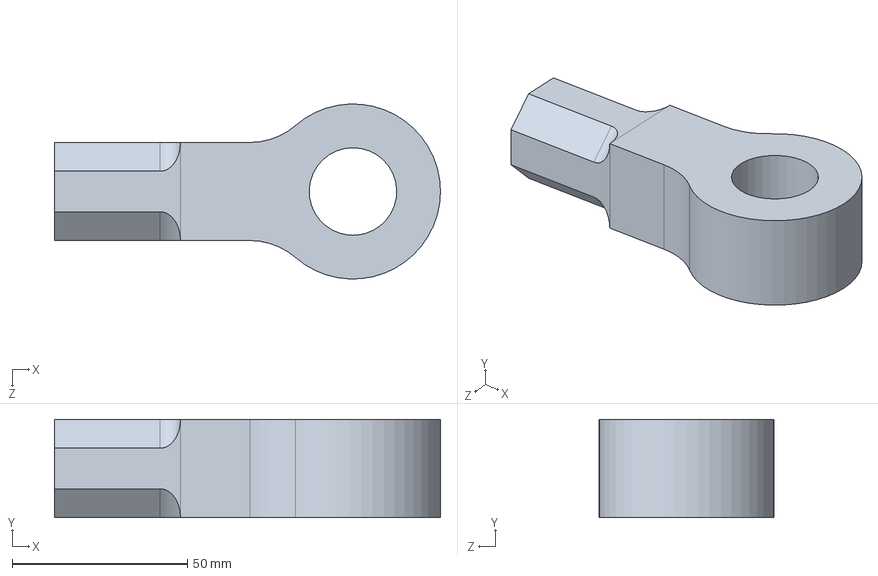
[picture p291: CAD file, 2026-11-01]
solid/examen final/eye end.SLDPRT
110.3 x 28.0 x 50.0 mm
