mk2442/Itla/solid/figura 10.SLDPRT

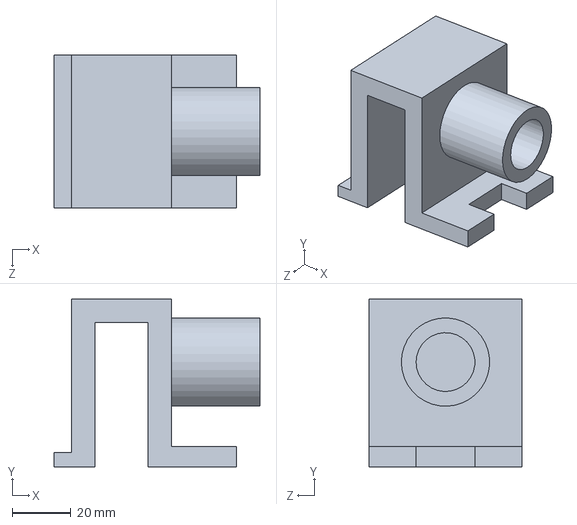
[picture p292: CAD file, 2026-11-01]
solid/figura 10.SLDPRT
70.0 x 57.0 x 52.0 mm
