mk2442/Itla/solid/greca/a/3d/elvi/Pieza_vE_9.STL

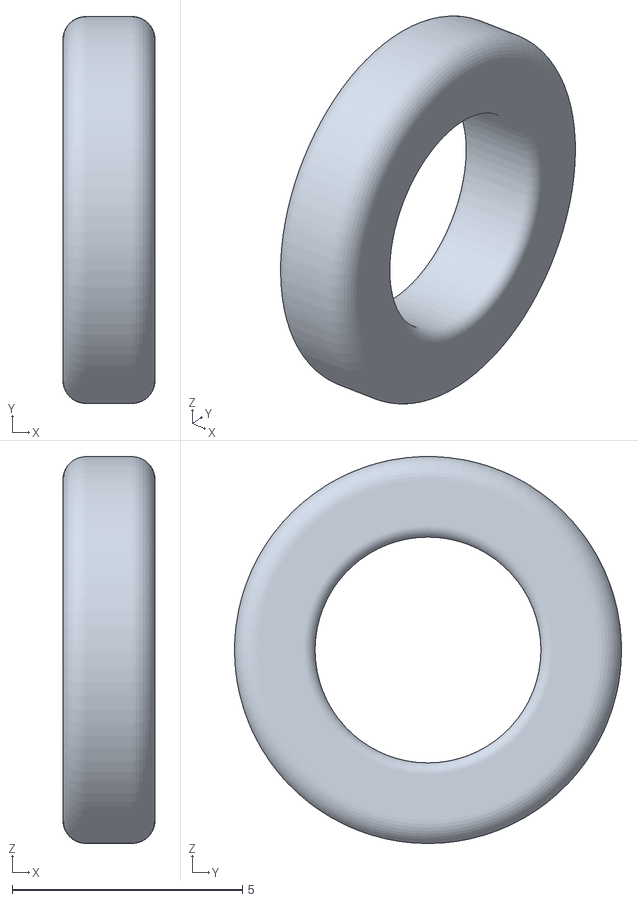
[picture p293: CAD file, 2026-11-01]
solid/greca/a/3d/elvi/Pieza_vE_9.STL
2.00 x 8.40 x 8.40
