mk2442/Itla/solid/greca/a/3d/motol.SLDPRT

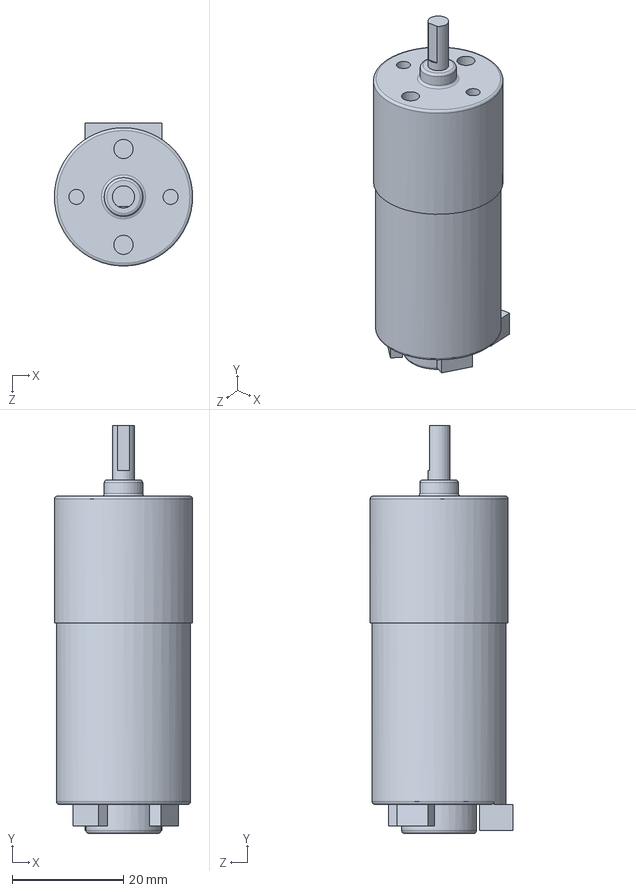
[picture p294: CAD file, 2026-11-01]
solid/greca/a/3d/motol.SLDPRT
24.9 x 73.5 x 25.7 mm
