mk2442/Itla/solid/greca/a/Nueva carpeta/Piezas del Sistema de giro/Case Motor de Giro Nuevo.SLDPRT

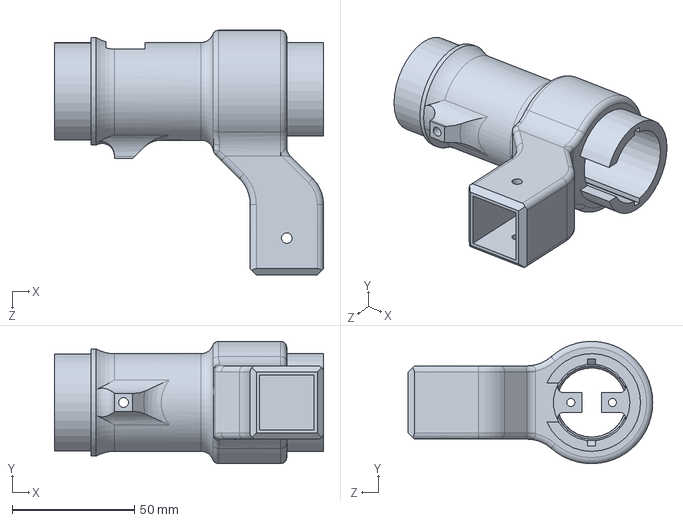
[picture p295: CAD file, 2026-11-01]
solid/greca/a/Nueva carpeta/Piezas del Sistema de giro/Case Motor de Giro Nuevo.SLDPRT
110.0 x 50.0 x 100.0 mm
