mk2442/Itla/solid/greca/a/Nueva carpeta/soporte.STL

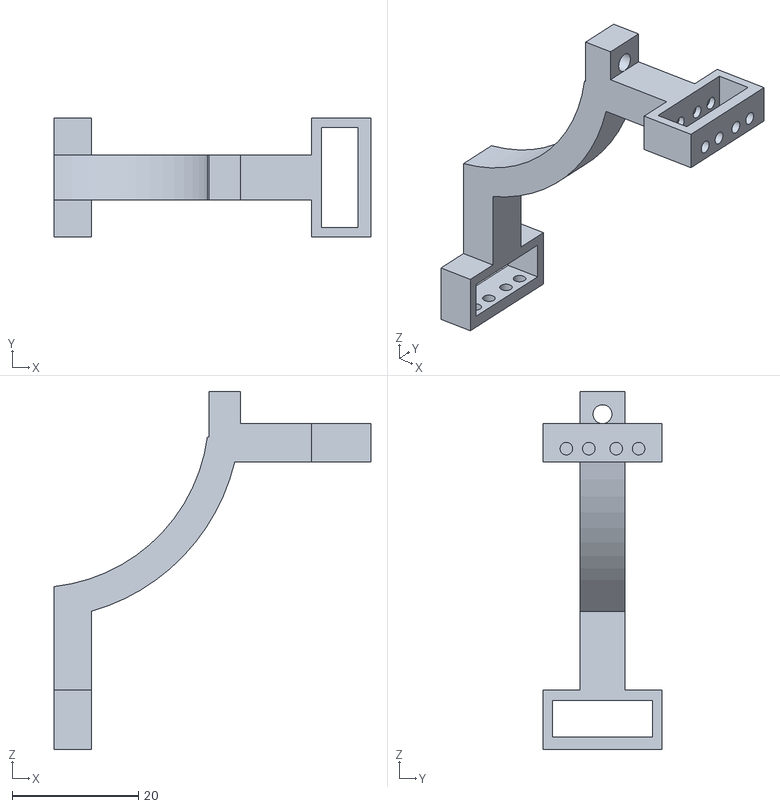
[picture p296: CAD file, 2026-11-01]
solid/greca/a/Nueva carpeta/soporte.STL
50.2 x 18.8 x 56.8
