mk2442/Itla/solid/greca/a/Pieza extractor.SLDPRT

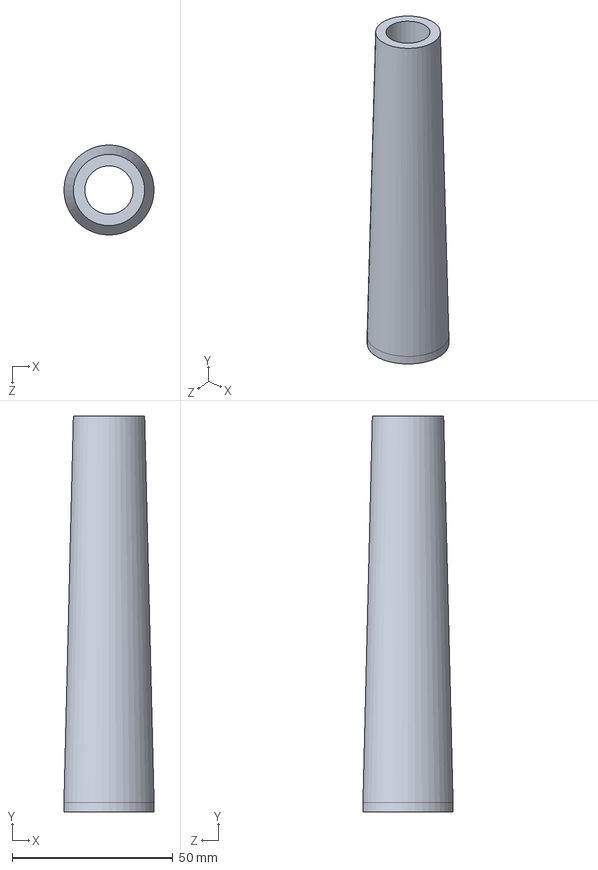
[picture p297: CAD file, 2026-11-01]
solid/greca/a/Pieza extractor.SLDPRT
28.0 x 123.0 x 28.0 mm
