mk2442/Itla/solid/greca/a/TORNILLO 1/tornillo2.1.SLDPRT

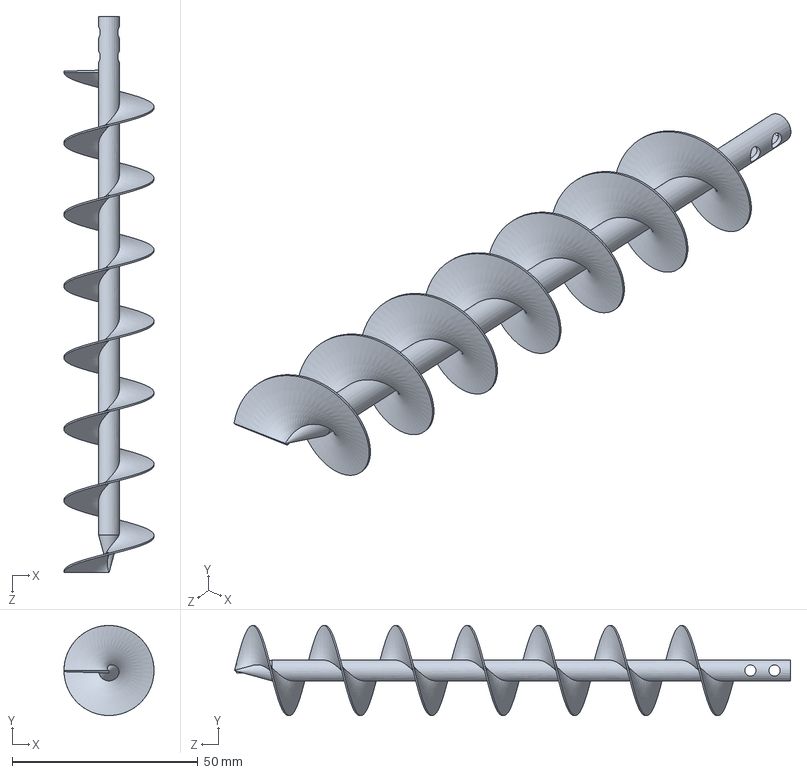
[picture p298: CAD file, 2026-11-01]
solid/greca/a/TORNILLO 1/tornillo2.1.SLDPRT
24.2 x 24.2 x 149.7 mm
