mk2442/Itla/solid/greca/embudo.SLDPRT

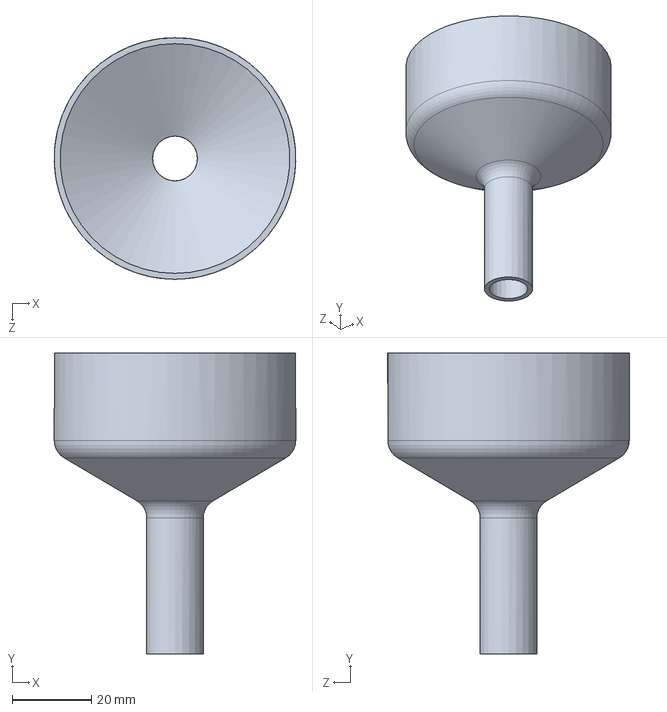
[picture p299: CAD file, 2026-11-01]
solid/greca/embudo.SLDPRT
61.0 x 76.0 x 61.0 mm
