mk2442/Itla/solid/Nueva carpeta/Pieza1.SLDPRT

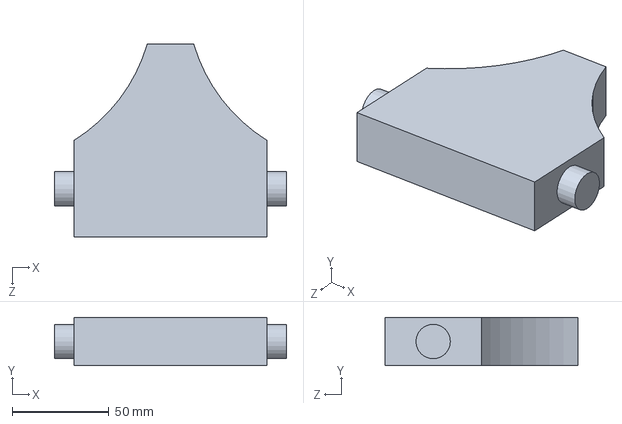
[picture p300: CAD file, 2026-11-01]
solid/Nueva carpeta/Pieza1.SLDPRT
120.0 x 25.0 x 100.0 mm
