mk2442/Itla/solid/parcial final/eye end.SLDPRT

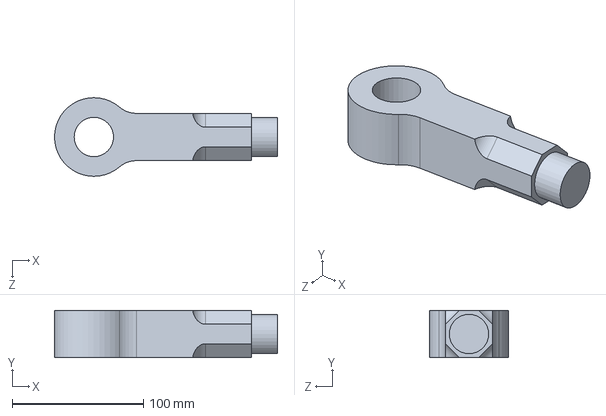
[picture p301: CAD file, 2026-11-01]
solid/parcial final/eye end.SLDPRT
170.0 x 36.0 x 60.0 mm
