mk2442/Itla/solid/pieza/afsgd/porton.STL

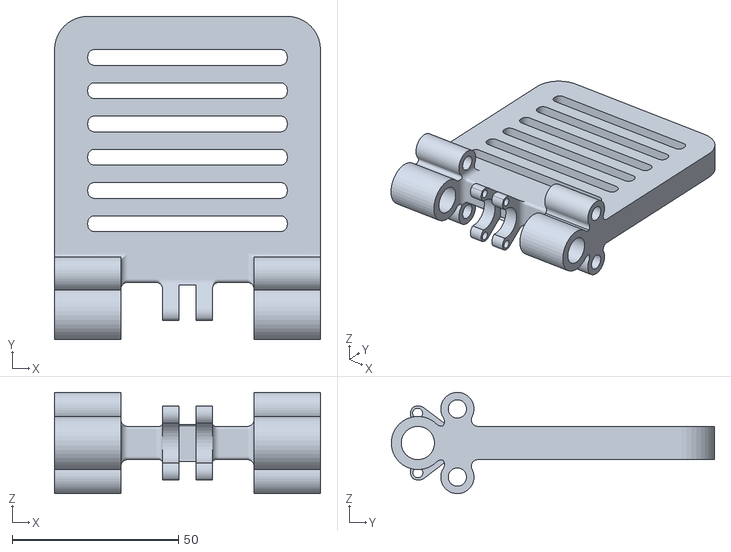
[picture p302: CAD file, 2026-11-01]
solid/pieza/afsgd/porton.STL
80.0 x 97.2 x 30.5
