mk2442/Itla/solid/pieza/Nueva carpeta/porton.STL

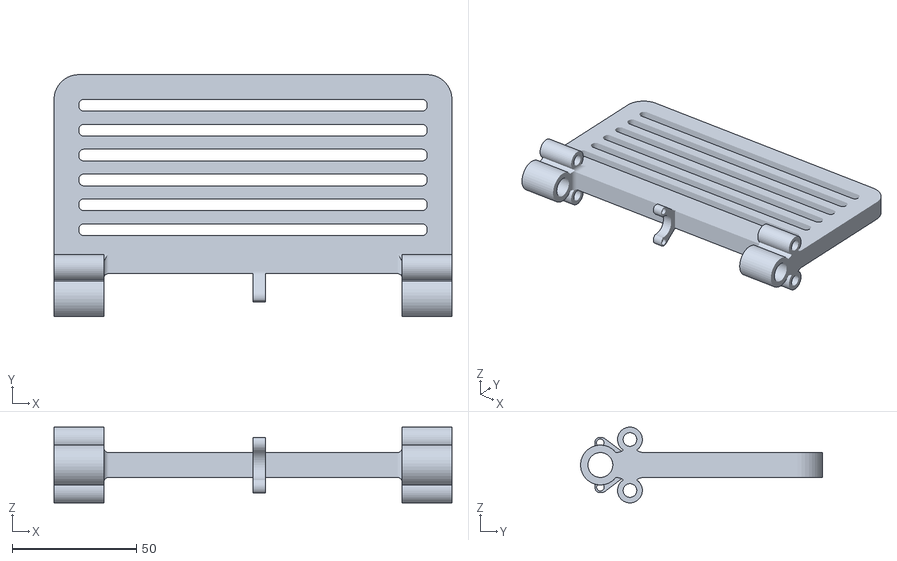
[picture p303: CAD file, 2026-11-01]
solid/pieza/Nueva carpeta/porton.STL
160.0 x 97.2 x 30.5
