mk2442/Itla/solid/pieza/Pieza2.SLDPRT

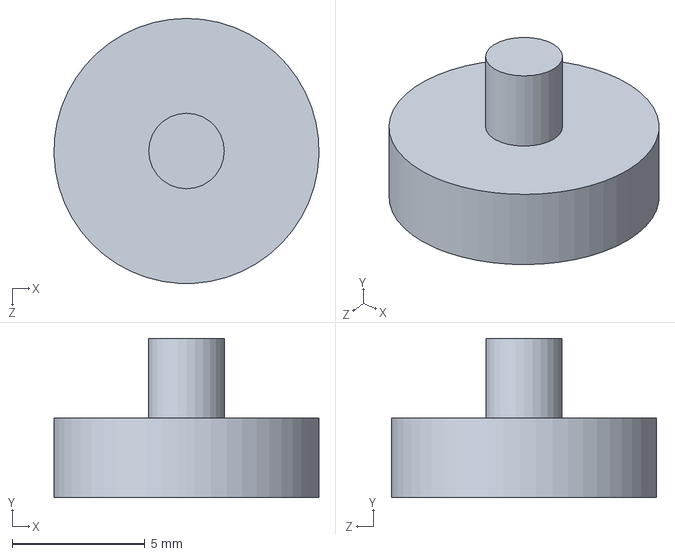
[picture p304: CAD file, 2026-11-01]
solid/pieza/Pieza2.SLDPRT
10.00 x 6.00 x 10.0 mm
