mk2442/Itla/digital/proyectos/troca-mcu-stm32g474/TROCA-MCU-STM32G474.step

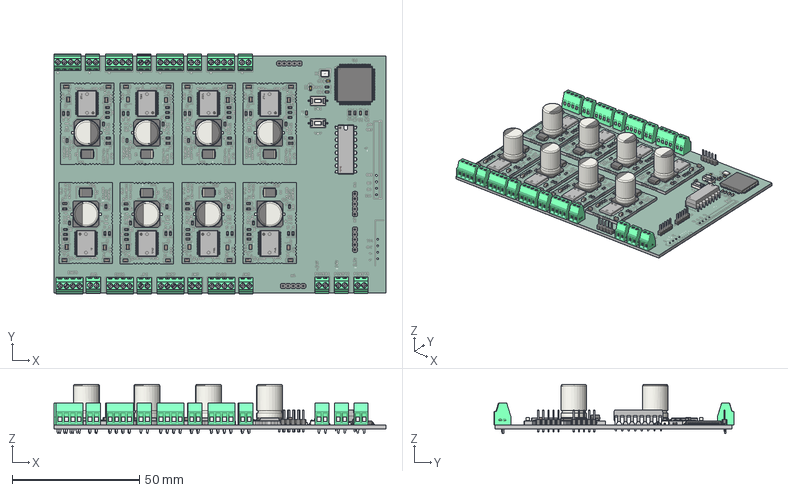
[picture p306: CAD file, 2026-11-01]
digital/proyectos/troca-mcu-stm32g474/TROCA-MCU-STM32G474.step
130.5 x 94.5 x 19.4 mm
CONN-TH_XY308-2.54-4P x 8
C_0603_1608Metric x 14
C_0805_2012Metric x 32
D_SMB x 8
CP_Elec_10x14.3 x 8
R_0603_1608Metric x 65
POWERSSO-36_L10.3-W7.5-H2.3-P0.50-LS10.3-BL-EP_VNH5050ATR-E x 8
H_bridge_silkscreen x 8
H_bridge_soldermask x 16
H_bridge_PCB x 8
CONN-TH_XY308-2.54-2P x 11
HDR-TH_5P-P2.00-M-LI-1X5P x 4
CRYSTAL-SMD_4P-L3.2-W2.5-BL
C0603_L1.6-W0.8-H0.8 x 2
PDIP-16_L19.3-W6.4-P2.54-LS7.94-BL
SW-SMD_HX-3X6X2.5-X x 2
LQFP-100_14x14mm_P0.5mm
TROCA-MCU-STM32G474_silkscreen
TROCA-MCU-STM32G474_soldermask x 2
TROCA-MCU-STM32G474_PCB
