mk2442/Itla/solid/a/collar.SLDPRT

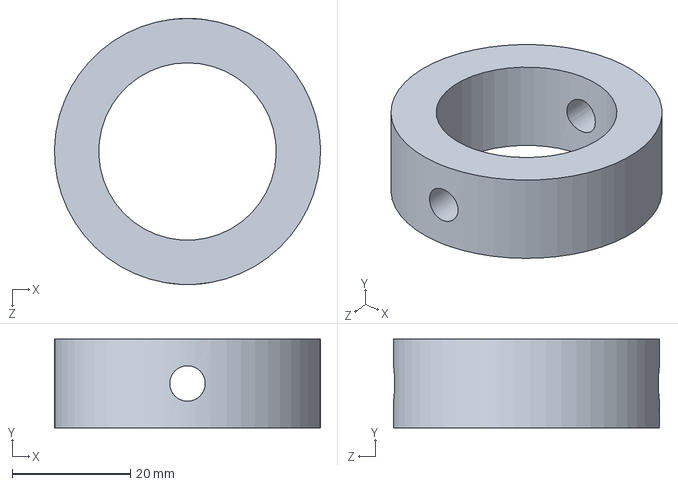
[picture p307: CAD file, 2026-11-01]
solid/a/collar.SLDPRT
45.0 x 15.0 x 45.0 mm
