mk2442/Itla/solid/asemble 3/nraket100.SLDPRT

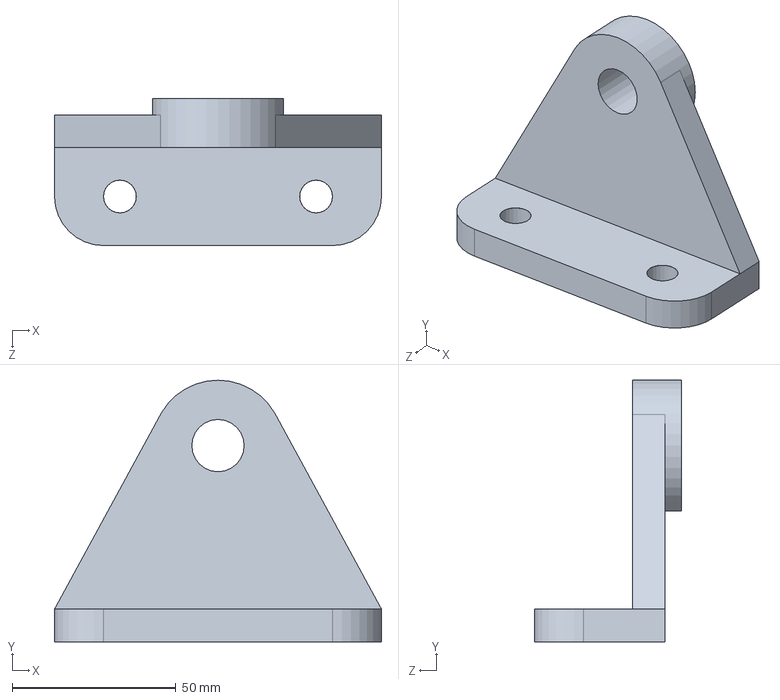
[picture p308: CAD file, 2026-11-01]
solid/asemble 3/nraket100.SLDPRT
100.0 x 80.0 x 45.0 mm
