mk2442/Itla/solid/asemble/axle.SLDPRT

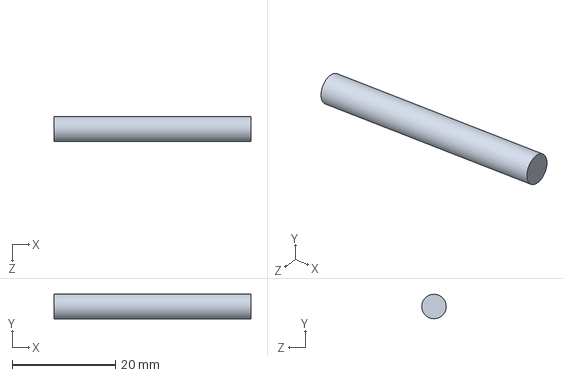
[picture p309: CAD file, 2026-11-01]
solid/asemble/axle.SLDPRT
38.1 x 4.76 x 4.76 mm
