mk2442/Itla/solid/cafetera/cabezita.SLDPRT

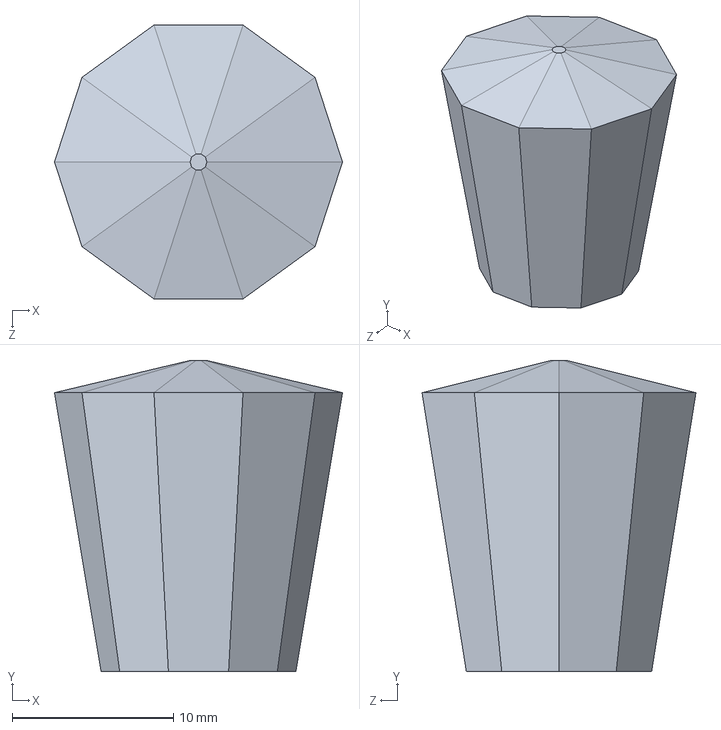
[picture p310: CAD file, 2026-11-01]
solid/cafetera/cabezita.SLDPRT
17.9 x 19.3 x 17.0 mm
