mk2442/Itla/solid/eco/p.SLDPRT

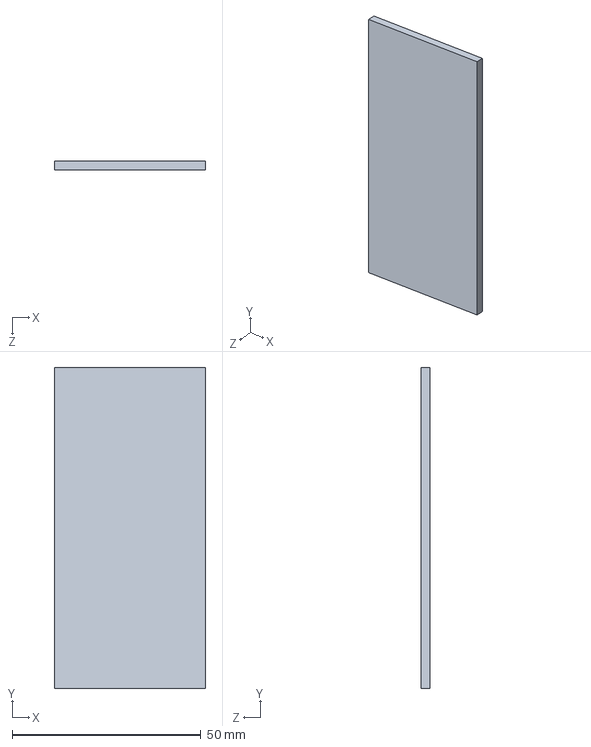
[picture p311: CAD file, 2026-11-01]
solid/eco/p.SLDPRT
40.0 x 85.0 x 2.50 mm
