mk2442/Itla/solid/empaque/1/cajon 1.SLDPRT

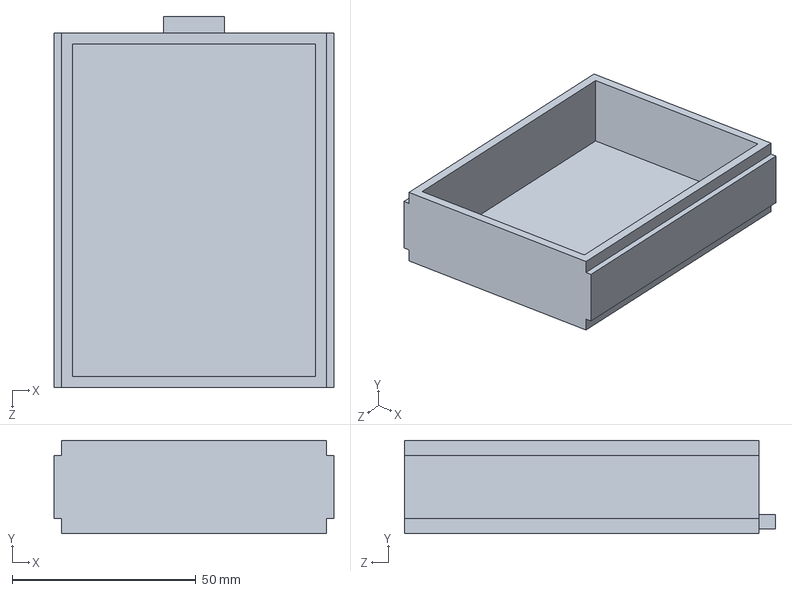
[picture p312: CAD file, 2026-11-01]
solid/empaque/1/cajon 1.SLDPRT
76.2 x 25.4 x 101.0 mm
