mk2442/Itla/solid/ensamble 2/pin.SLDPRT

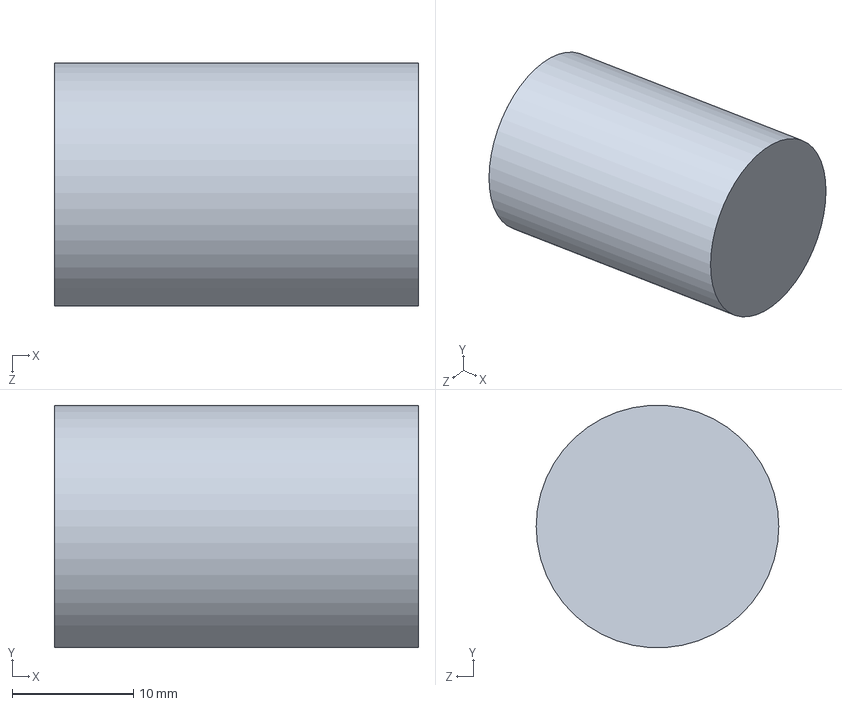
[picture p313: CAD file, 2026-11-01]
solid/ensamble 2/pin.SLDPRT
30.0 x 20.0 x 20.0 mm
