mk2442/Itla/solid/examen final/fprk.SLDPRT

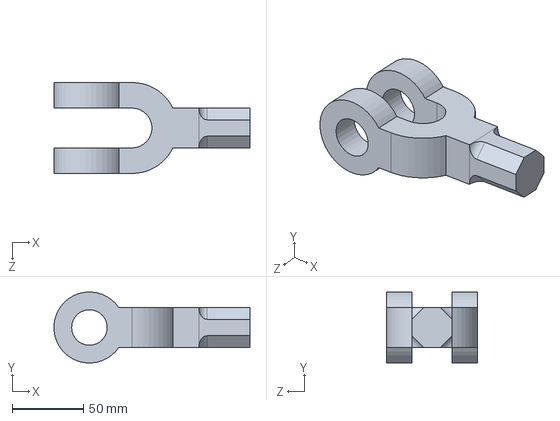
[picture p314: CAD file, 2026-11-01]
solid/examen final/fprk.SLDPRT
137.9 x 49.9 x 64.0 mm
