mk2442/Itla/solid/greca/a/3d/elvi/Pieza4_extractor_agua.STL

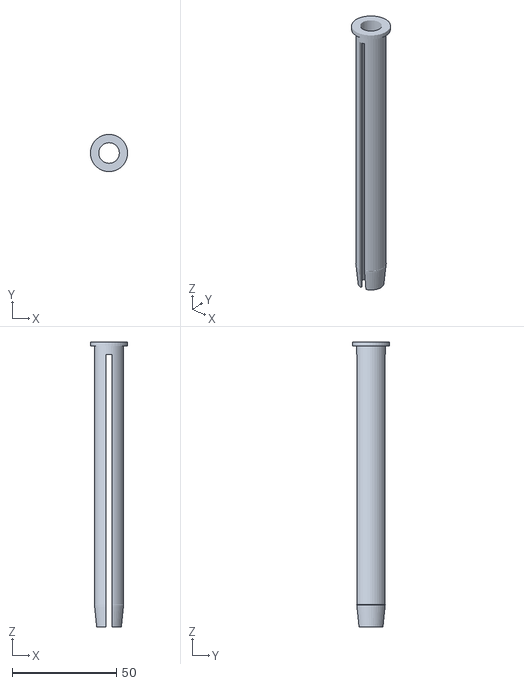
[picture p315: CAD file, 2026-11-01]
solid/greca/a/3d/elvi/Pieza4_extractor_agua.STL
17.9 x 17.9 x 137.0
