mk2442/Itla/solid/greca/a/3d/motol2.SLDPRT

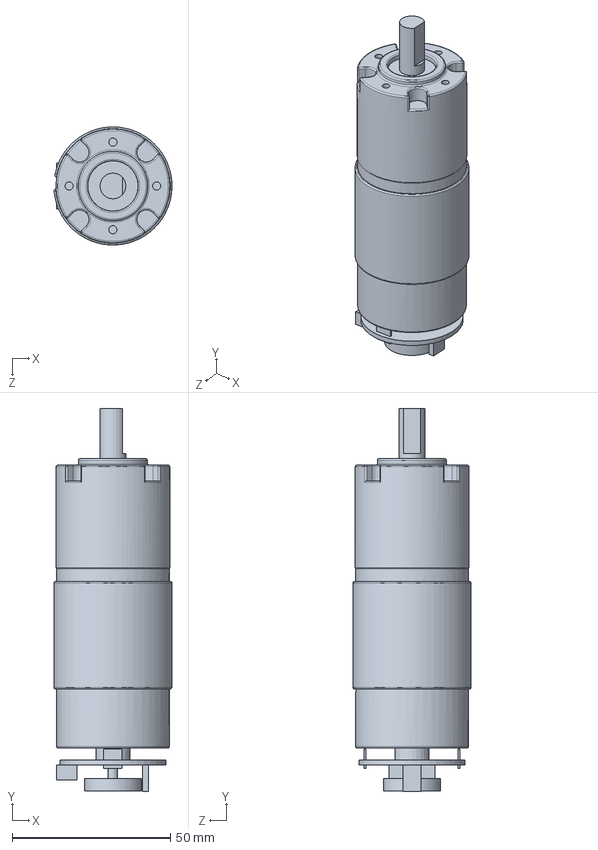
[picture p316: CAD file, 2026-11-01]
solid/greca/a/3d/motol2.SLDPRT
37.3 x 121.0 x 37.3 mm
