mk2442/Itla/solid/greca/a/extractor 3.SLDPRT

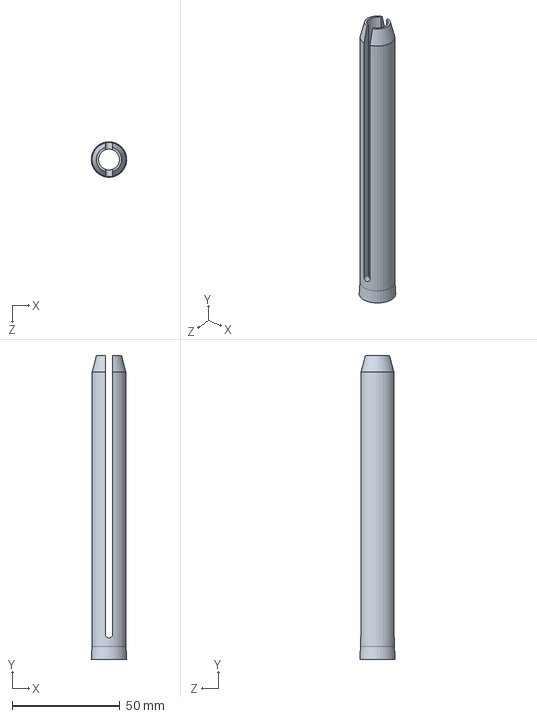
[picture p317: CAD file, 2026-11-01]
solid/greca/a/extractor 3.SLDPRT
16.5 x 140.8 x 16.4 mm
