mk2442/Itla/solid/greca/a/TORNILLO 1/tornillo1.SLDPRT

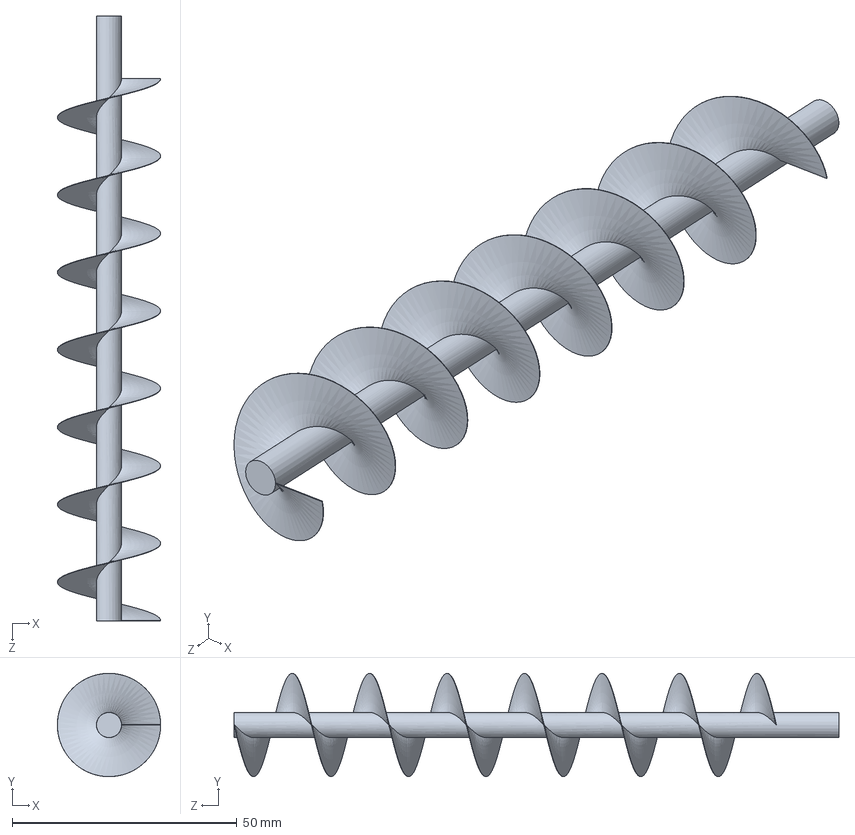
[picture p318: CAD file, 2026-11-01]
solid/greca/a/TORNILLO 1/tornillo1.SLDPRT
23.0 x 23.0 x 134.7 mm
