mk2442/Itla/solid/greca/base.SLDPRT

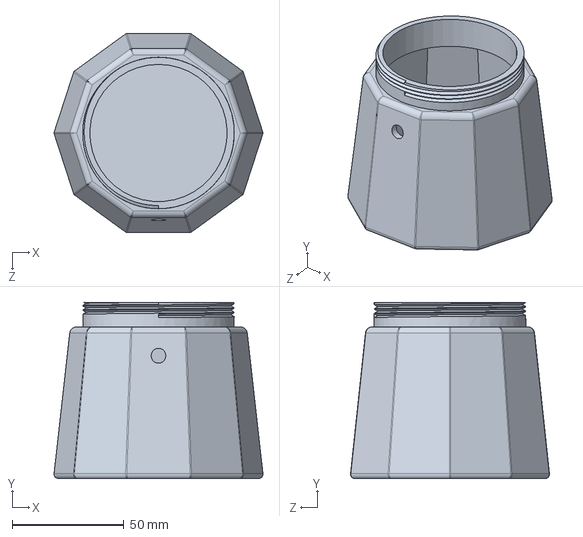
[picture p319: CAD file, 2026-11-01]
solid/greca/base.SLDPRT
93.5 x 78.9 x 89.1 mm
