mk2442/Itla/solid/parcial final/fork.SLDPRT

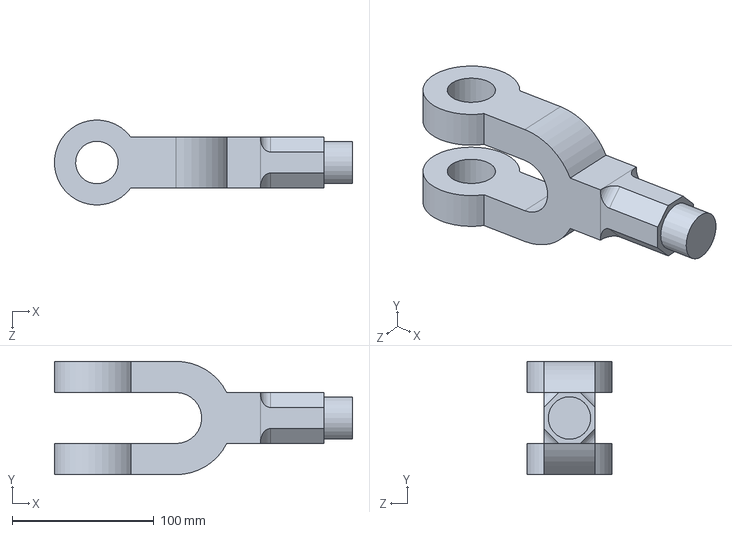
[picture p320: CAD file, 2026-11-01]
solid/parcial final/fork.SLDPRT
210.4 x 80.0 x 60.0 mm
