mk2442/Itla/solid/Part2.SLDPRT

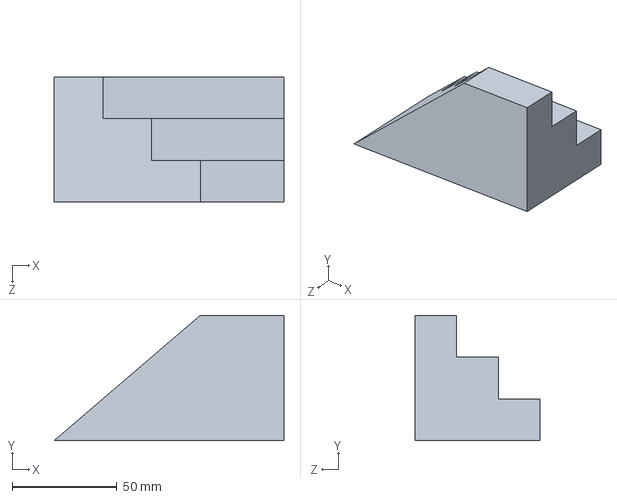
[picture p321: CAD file, 2026-11-01]
solid/Part2.SLDPRT
110.0 x 60.0 x 60.0 mm
