mk2442/Itla/solid/pieza/afsgd/soporte steppler1.STL

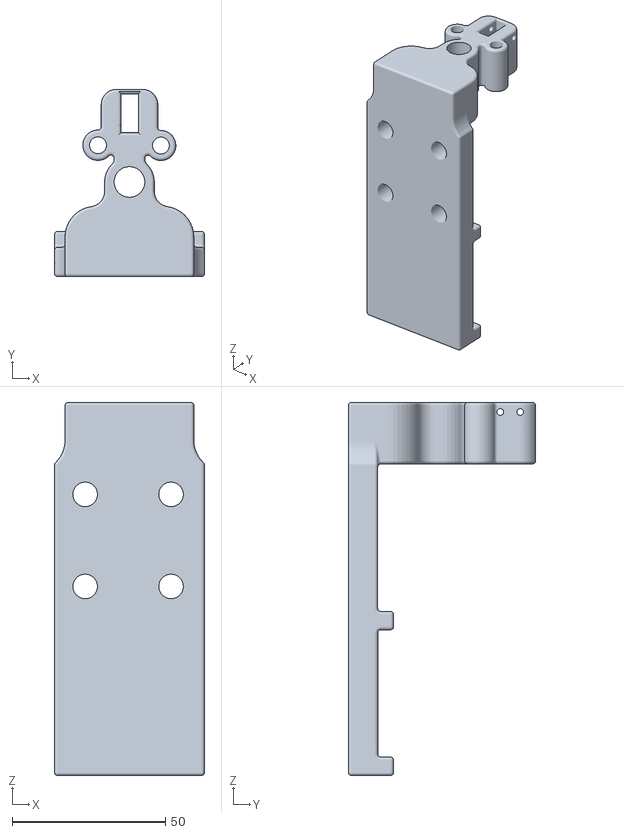
[picture p322: CAD file, 2026-11-01]
solid/pieza/afsgd/soporte steppler1.STL
48.9 x 61.1 x 121.6
