mk2442/Itla/solid/pieza/soporte steppler.SLDPRT

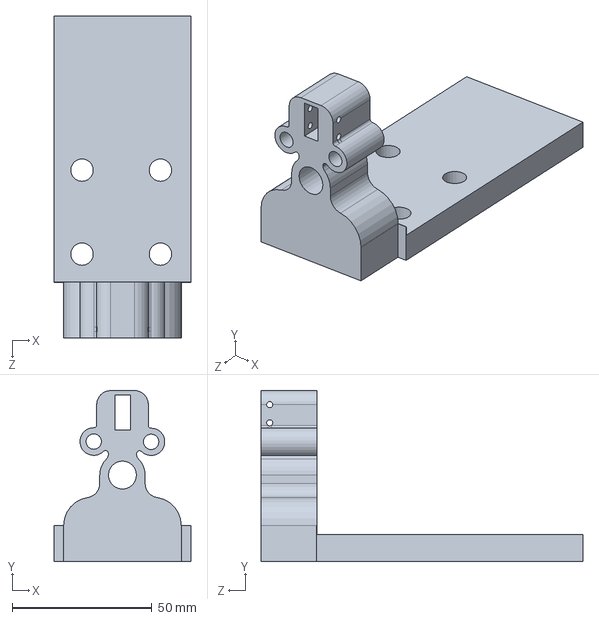
[picture p323: CAD file, 2026-11-01]
solid/pieza/soporte steppler.SLDPRT
48.9 x 61.1 x 115.0 mm
