mk2442/Itla/solid/rover/goma.SLDPRT

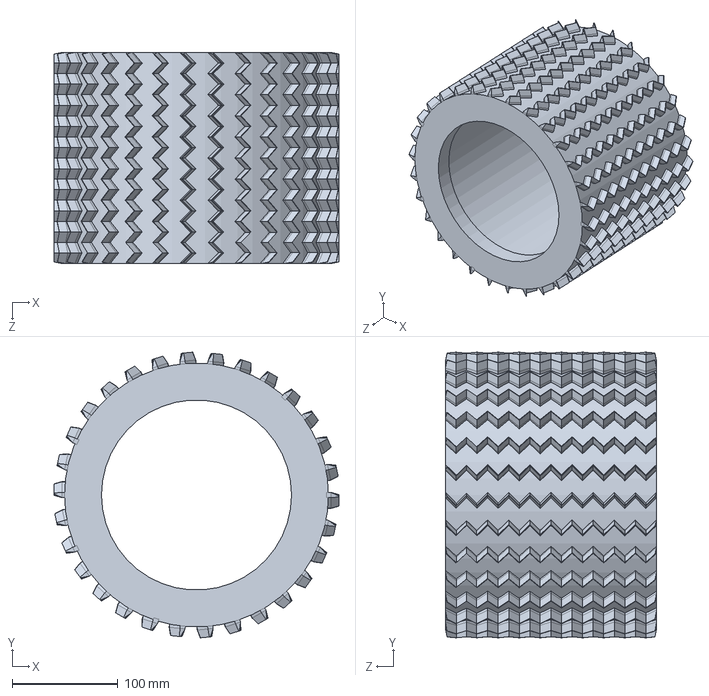
[picture p324: CAD file, 2026-11-01]
solid/rover/goma.SLDPRT
270.0 x 270.7 x 200.0 mm
