mk2442/Itla/digital/impresion-3d/stepper-motor-17hs15/17HE15-1504S.step

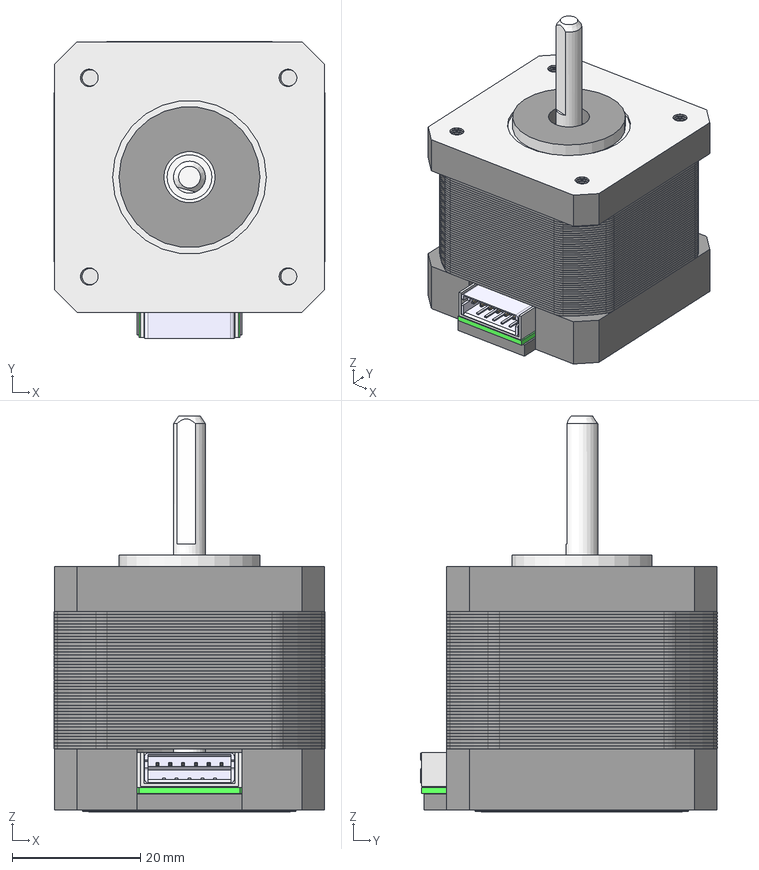
[picture p325: CAD file, 2026-11-01]
digital/impresion-3d/stepper-motor-17hs15/17HE15-1504S.step
42.3 x 46.3 x 61.8 mm
Bottom
Sheet_metal
Axis
625ZZ_001 x 2
PCB
Conn_cover
M3x16-Vis x 4
Base
pin001
pin002
pin003
pin004
pin005
pin006
Top_body
Blue
Blue001
Blue002
Blue003
Blue004
Blue005
Blue006
Blue007
Blue008
www.omc
www.omc001
www.omc002
www.omc003
www.omc004
www.omc005
www.omc006
www.omc007
www.omc008
www.omc009
www.omc010
www.omc011
www.omc012
www.omc013
www.omc014
www.omc015
www.omc016
www.omc017
www.omc018
www.omc019
www.omc020
www.omc021
www.omc022
www.omc023
www.omc024
www.omc025
