mk2442/Itla/solid/a/eye end.SLDPRT

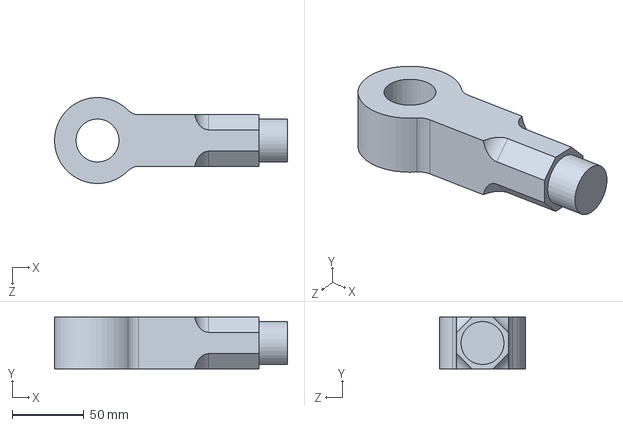
[picture p326: CAD file, 2026-11-01]
solid/a/eye end.SLDPRT
162.5 x 36.0 x 60.0 mm
