mk2442/Itla/solid/asemble 3/will.SLDPRT

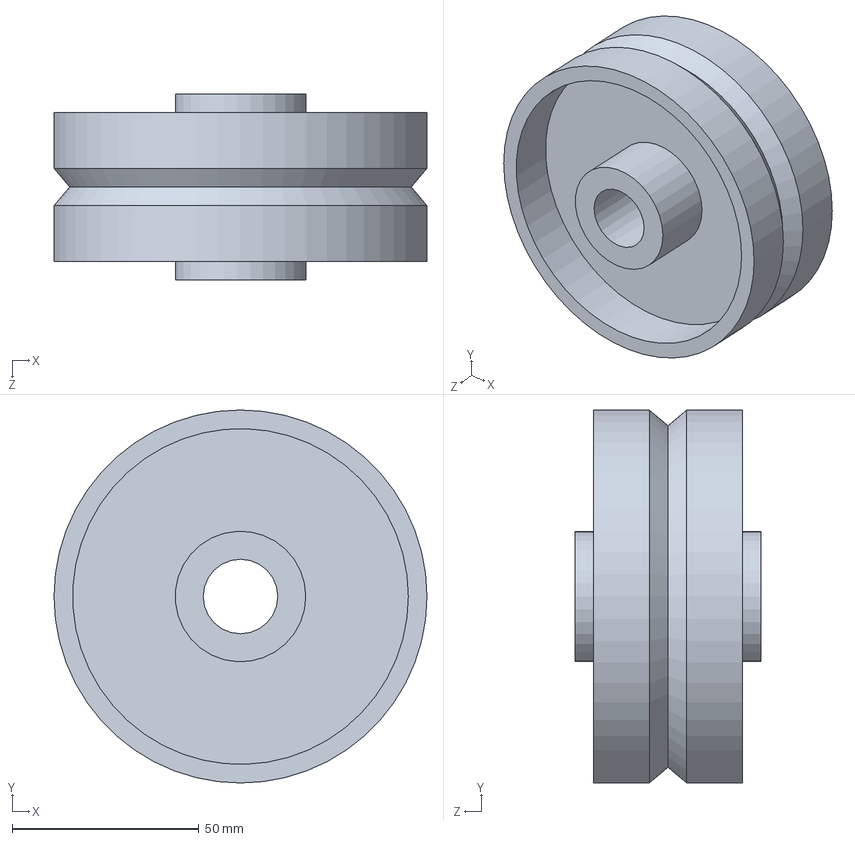
[picture p327: CAD file, 2026-11-01]
solid/asemble 3/will.SLDPRT
100.0 x 100.0 x 50.0 mm
