mk2442/Itla/solid/cafetera/mango.SLDPRT

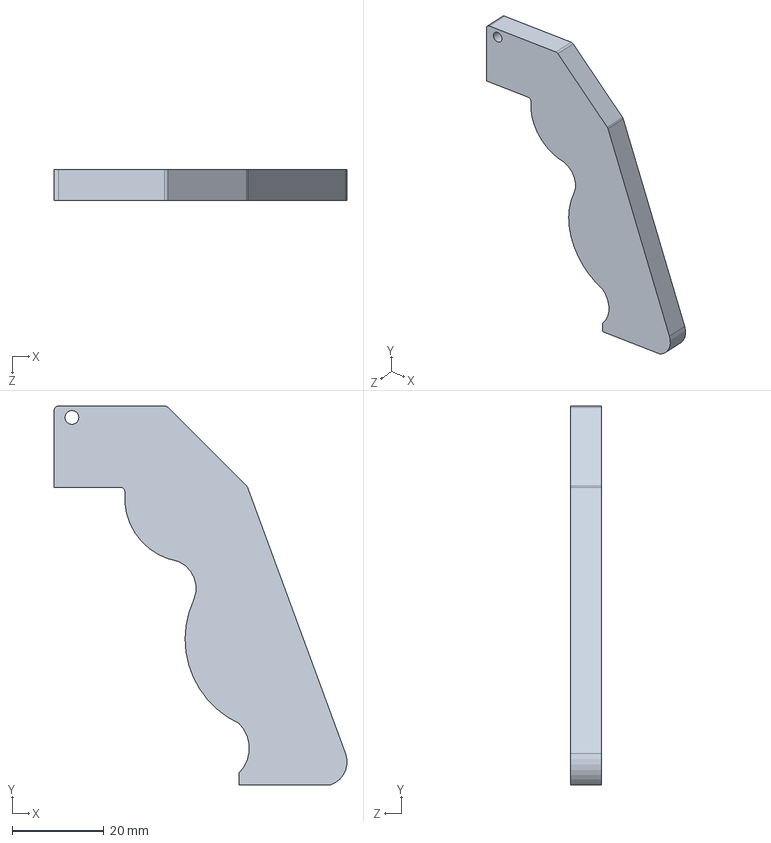
[picture p328: CAD file, 2026-11-01]
solid/cafetera/mango.SLDPRT
63.8 x 82.5 x 6.80 mm
