mk2442/Itla/solid/eco/tp.SLDPRT

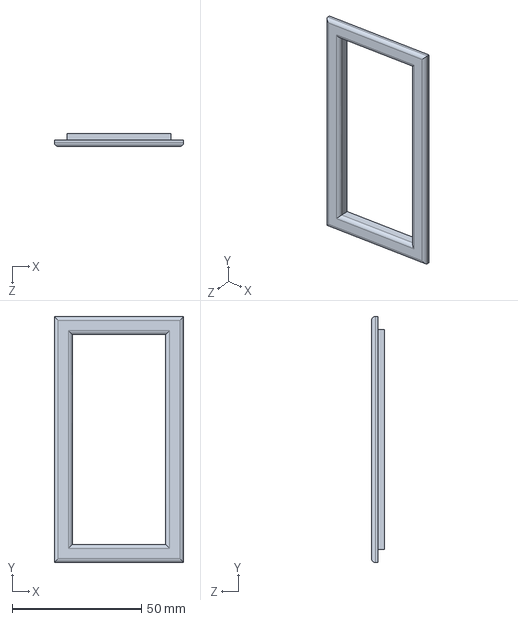
[picture p329: CAD file, 2026-11-01]
solid/eco/tp.SLDPRT
50.0 x 95.0 x 5.00 mm
