mk2442/Itla/solid/empaque/1/empaque.SLDPRT

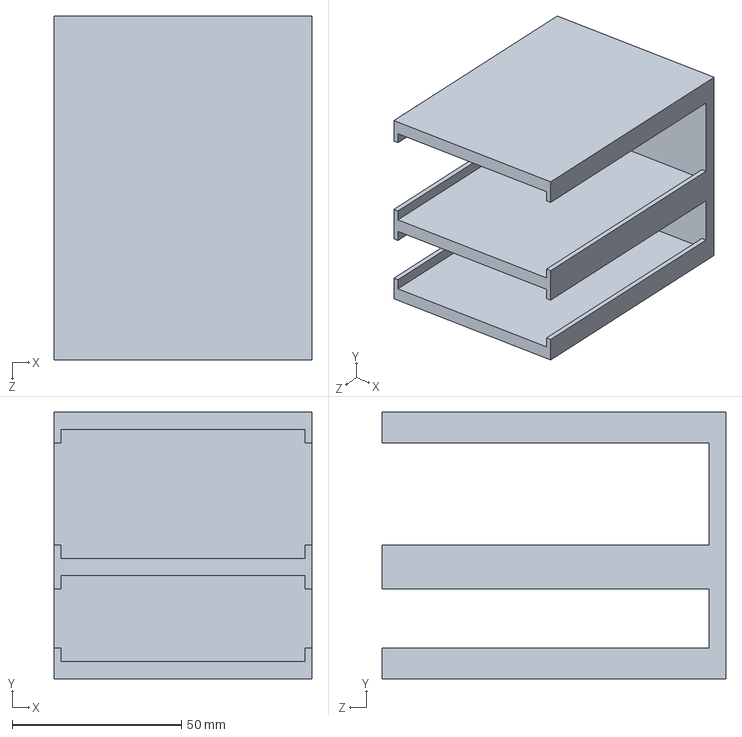
[picture p330: CAD file, 2026-11-01]
solid/empaque/1/empaque.SLDPRT
76.2 x 78.7 x 101.6 mm
