mk2442/Itla/solid/empaque/2/Pieza1.SLDPRT

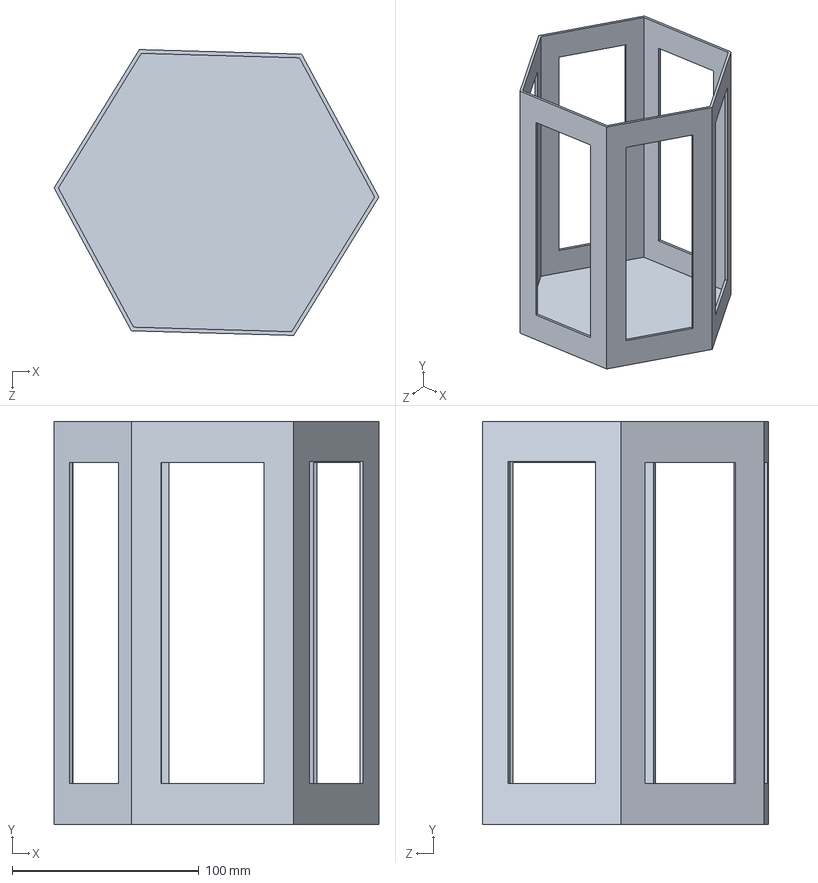
[picture p331: CAD file, 2026-11-01]
solid/empaque/2/Pieza1.SLDPRT
174.0 x 215.9 x 153.2 mm
