mk2442/Itla/solid/ensable 3/weel.SLDPRT

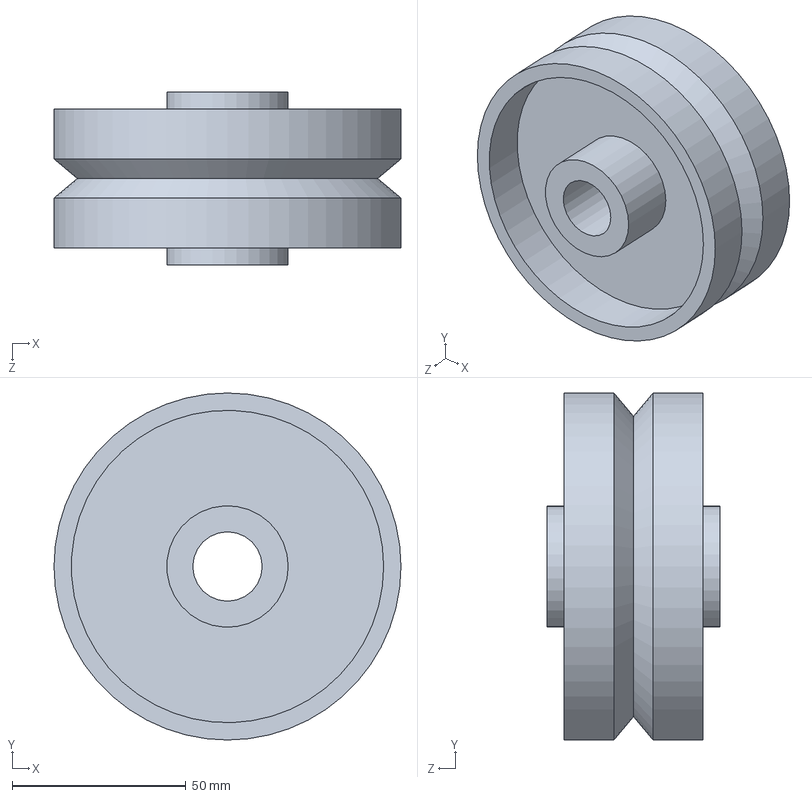
[picture p332: CAD file, 2026-11-01]
solid/ensable 3/weel.SLDPRT
100.0 x 100.0 x 50.0 mm
