mk2442/Itla/solid/ensamble 1/link 5 hole.SLDPRT

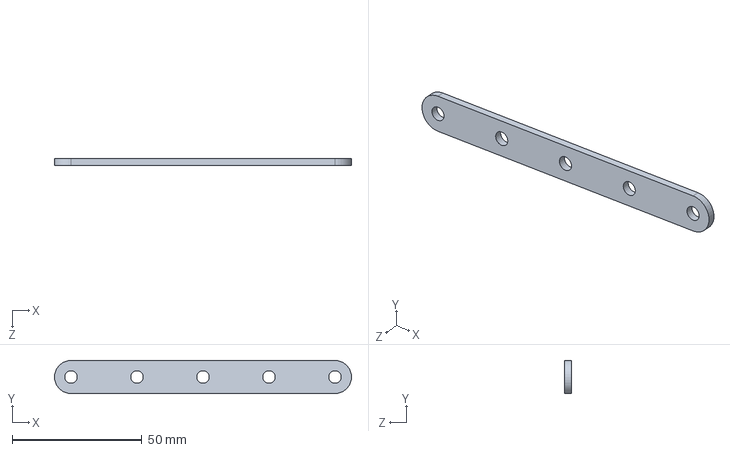
[picture p333: CAD file, 2026-11-01]
solid/ensamble 1/link 5 hole.SLDPRT
114.3 x 12.7 x 2.54 mm
