mk2442/Itla/solid/examen final/Part3.SLDPRT

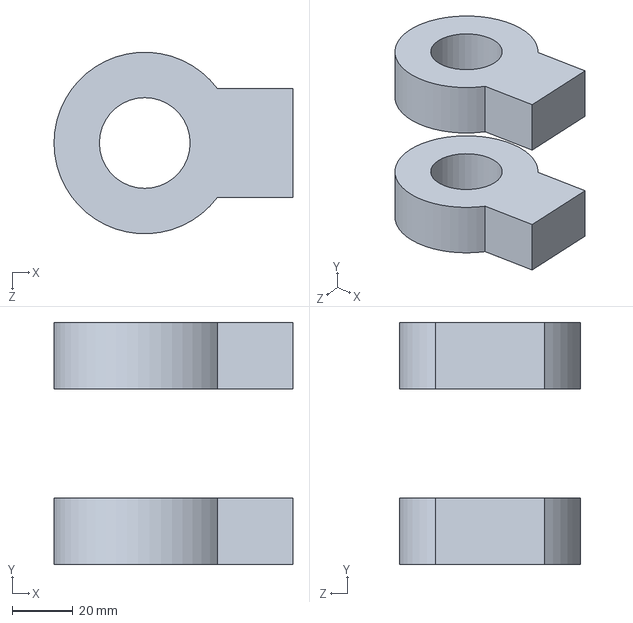
[picture p334: CAD file, 2026-11-01]
solid/examen final/Part3.SLDPRT
79.0 x 80.0 x 59.9 mm
