mk2442/Itla/solid/greca/a/3d/elvi/Pieza_vE_3.STL

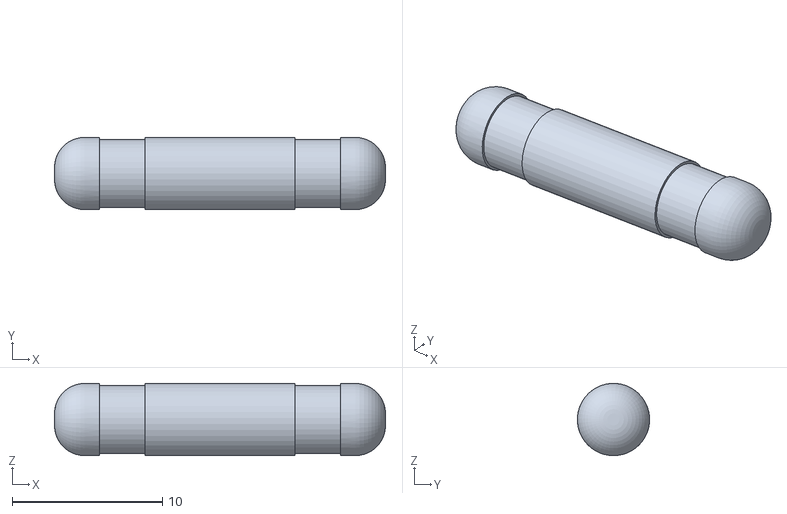
[picture p335: CAD file, 2026-11-01]
solid/greca/a/3d/elvi/Pieza_vE_3.STL
22.0 x 4.80 x 4.80
