mk2442/Itla/solid/greca/a/Nueva carpeta/Piezas del Sistema de giro/Case Motor de Giro Nuevo Tapa.SLDPRT

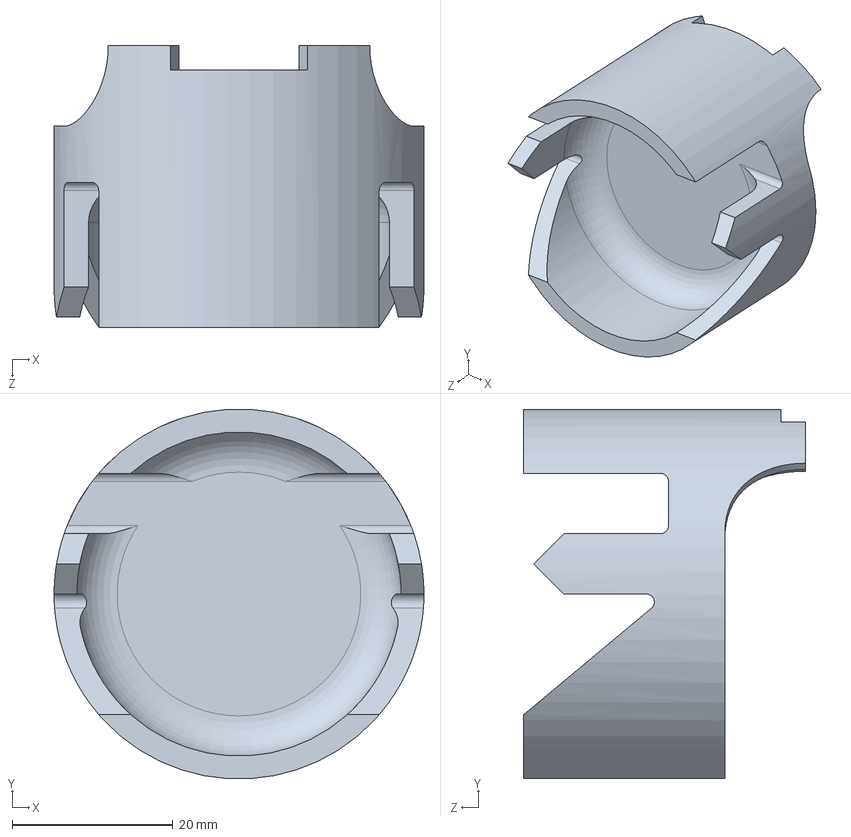
[picture p336: CAD file, 2026-11-01]
solid/greca/a/Nueva carpeta/Piezas del Sistema de giro/Case Motor de Giro Nuevo Tapa.SLDPRT
46.0 x 45.9 x 35.0 mm
