mk2442/Itla/solid/greca/a/Pieza extractor2.SLDPRT

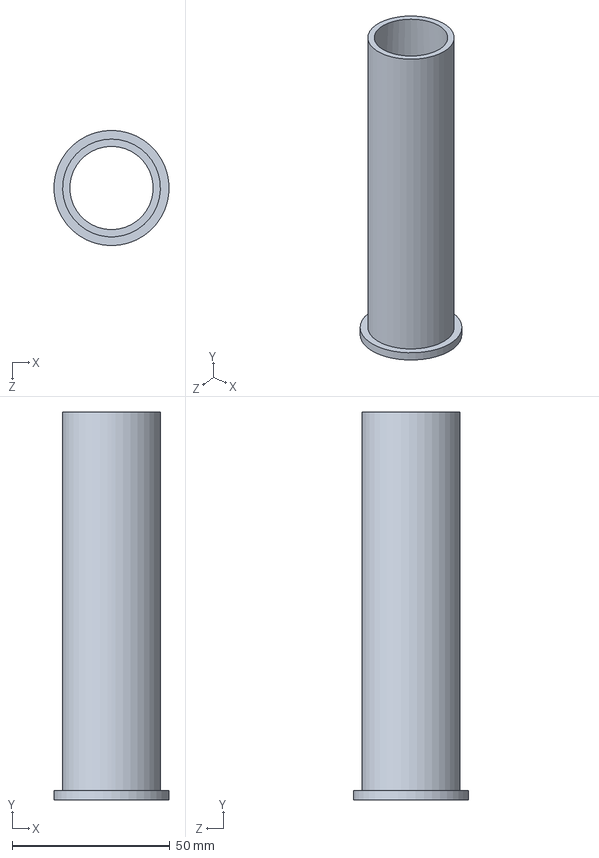
[picture p337: CAD file, 2026-11-01]
solid/greca/a/Pieza extractor2.SLDPRT
36.4 x 123.0 x 36.5 mm
