mk2442/Itla/solid/pieza/adaptador.3mf

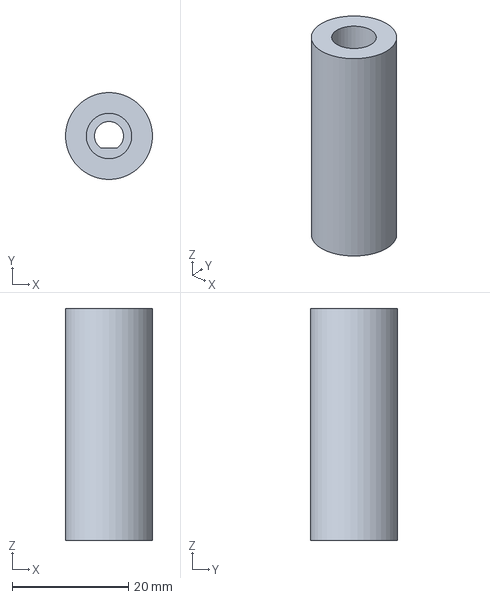
[picture p338: CAD file, 2026-11-01]
solid/pieza/adaptador.3mf
15.0 x 15.0 x 40.0 mm
