mk2442/Itla/solid/pieza/afsgd/Pieza117.STL

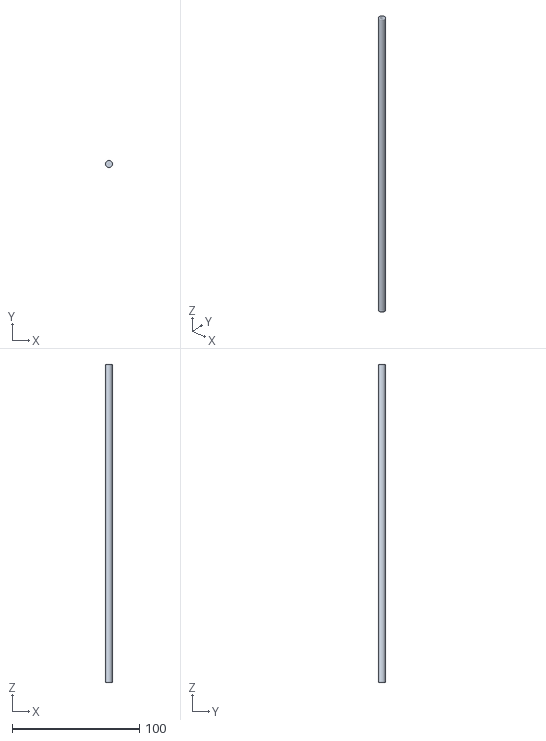
[picture p339: CAD file, 2026-11-01]
solid/pieza/afsgd/Pieza117.STL
5.50 x 5.50 x 250.0
