mk2442/Itla/solid/rover/centro de rueda.SLDPRT

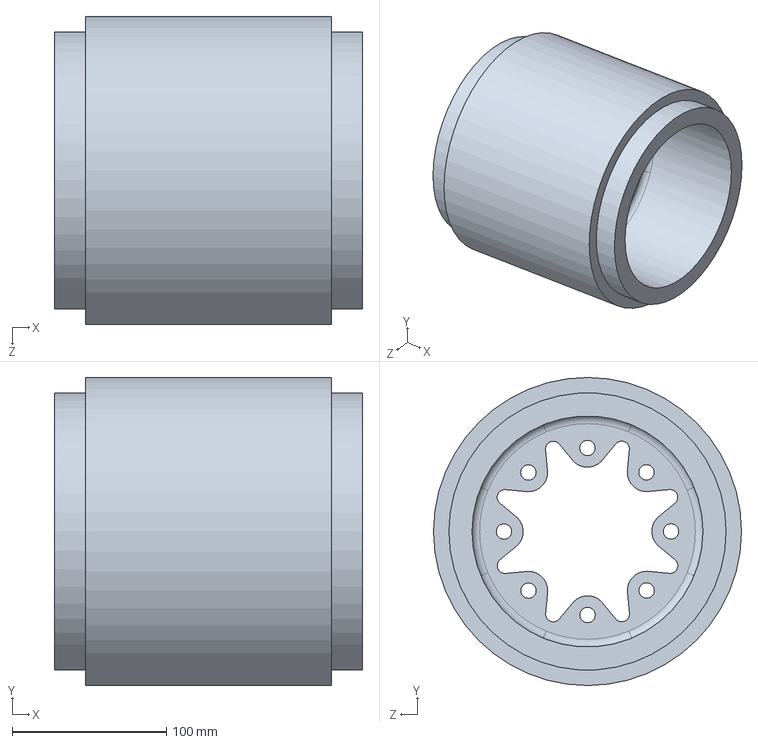
[picture p340: CAD file, 2026-11-01]
solid/rover/centro de rueda.SLDPRT
200.0 x 200.0 x 200.0 mm
