mk2442/Itla/solid/asemble/5 hole link.SLDPRT

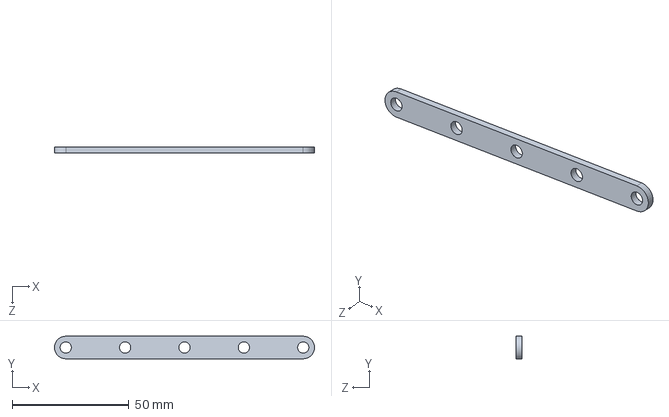
[picture p341: CAD file, 2026-11-01]
solid/asemble/5 hole link.SLDPRT
111.2 x 9.68 x 2.54 mm
