mk2442/Itla/solid/cafetera/parte de arriba.SLDPRT

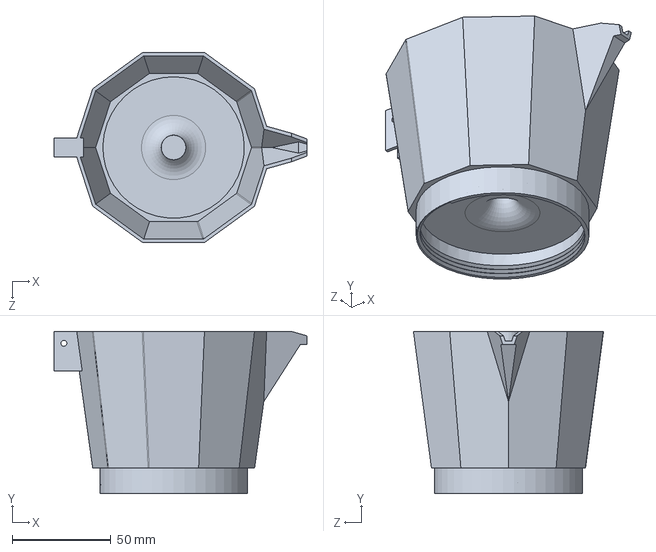
[picture p342: CAD file, 2026-11-01]
solid/cafetera/parte de arriba.SLDPRT
128.0 x 82.0 x 96.2 mm
