mk2442/Itla/solid/empaque/1/cajon 2.SLDPRT

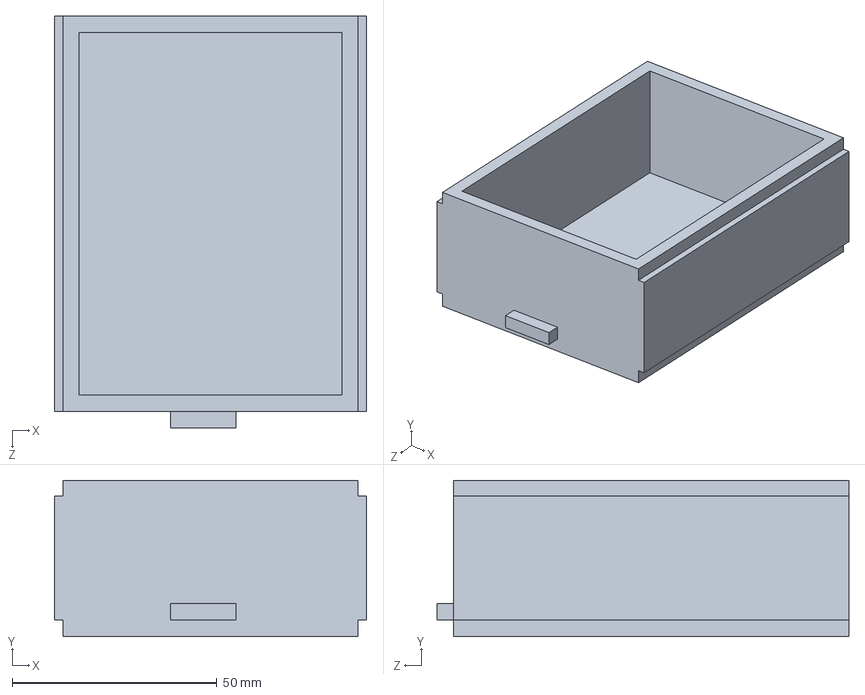
[picture p343: CAD file, 2026-11-01]
solid/empaque/1/cajon 2.SLDPRT
76.2 x 38.1 x 100.5 mm
