mk2442/Itla/solid/greca/a/Nueva carpeta/Piezas del Sistema de giro/Sujetador Motor A.SLDPRT

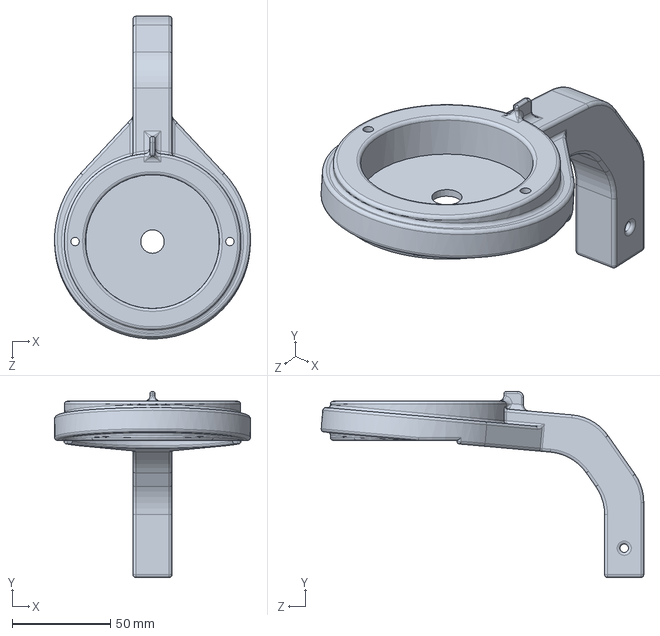
[picture p344: CAD file, 2026-11-01]
solid/greca/a/Nueva carpeta/Piezas del Sistema de giro/Sujetador Motor A.SLDPRT
100.0 x 95.0 x 164.6 mm
