mk2442/Itla/solid/greca/a/Pieza extractor2.0.SLDPRT

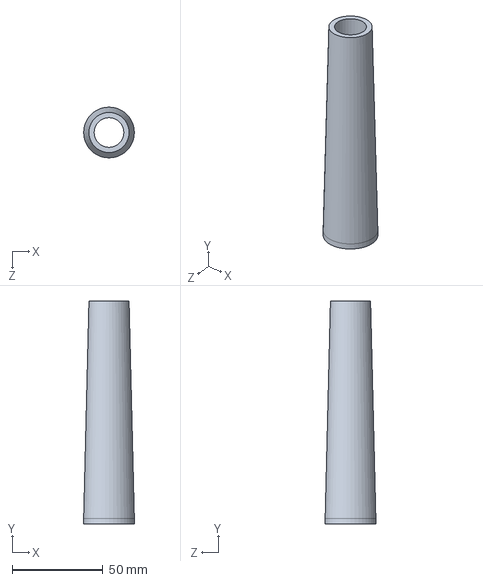
[picture p345: CAD file, 2026-11-01]
solid/greca/a/Pieza extractor2.0.SLDPRT
28.0 x 123.0 x 28.0 mm
