mk2442/Itla/solid/greca/colador-tapa.SLDPRT

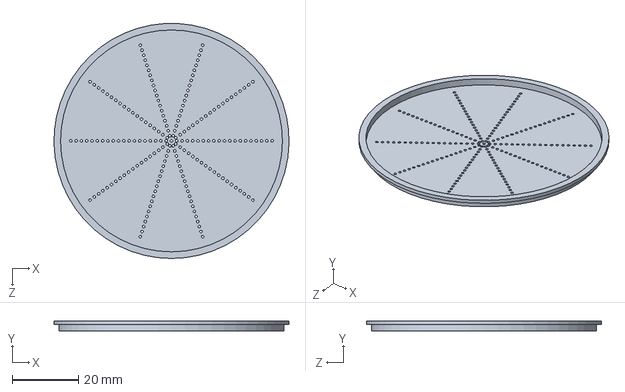
[picture p346: CAD file, 2026-11-01]
solid/greca/colador-tapa.SLDPRT
71.0 x 3.00 x 70.9 mm
