mk2442/Itla/solid/Part25.SLDPRT

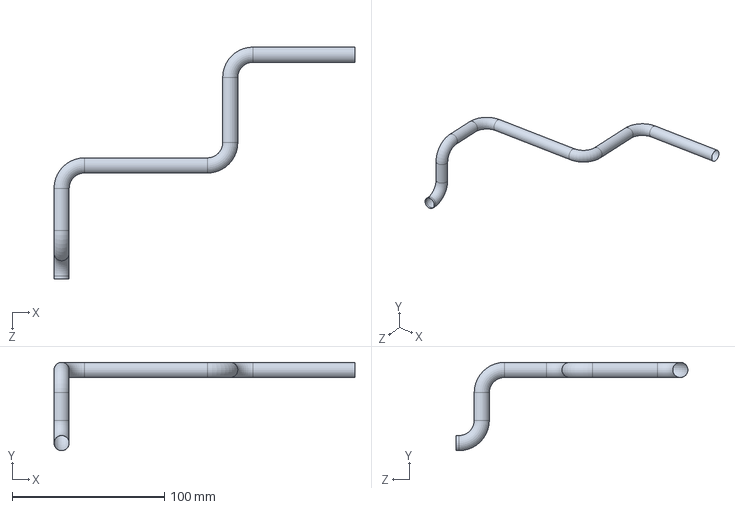
[picture p347: CAD file, 2026-11-01]
solid/Part25.SLDPRT
197.8 x 58.1 x 152.4 mm
