mk2442/Itla/solid/pieza/Pieza1.SLDPRT

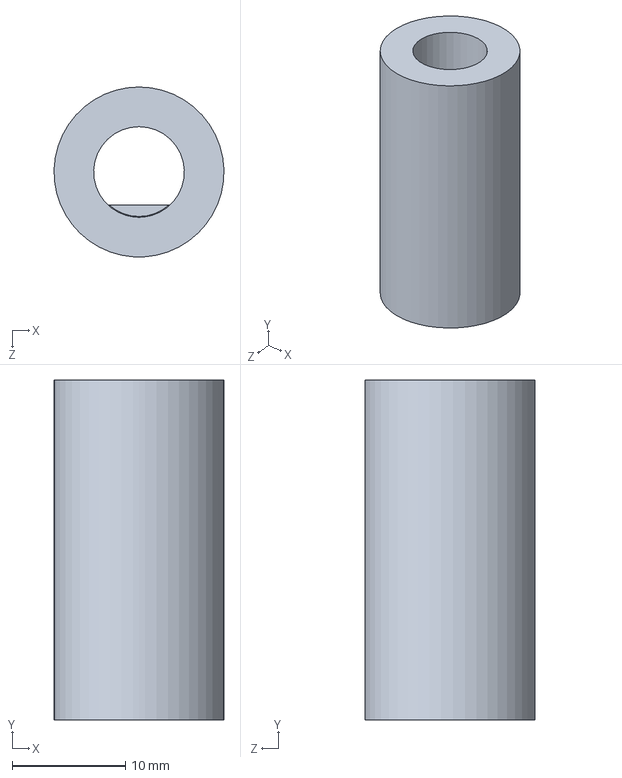
[picture p348: CAD file, 2026-11-01]
solid/pieza/Pieza1.SLDPRT
15.0 x 30.0 x 15.0 mm
