mk2442/Itla/solid/rover/transmicion.SLDPRT

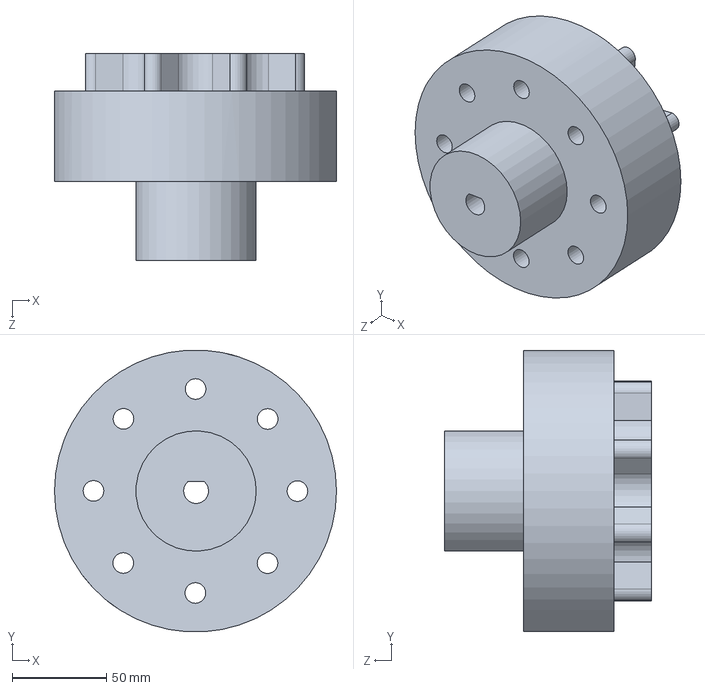
[picture p349: CAD file, 2026-11-01]
solid/rover/transmicion.SLDPRT
150.0 x 149.7 x 110.0 mm
