mk2442/Itla/solid/asemble 3/wheelplate.SLDPRT

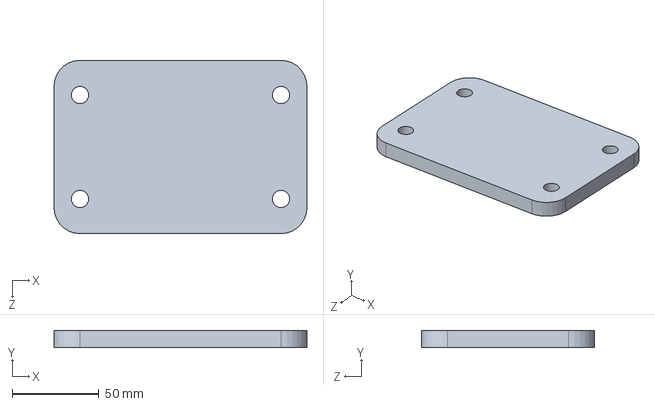
[picture p350: CAD file, 2026-11-01]
solid/asemble 3/wheelplate.SLDPRT
146.0 x 10.0 x 100.0 mm
