mk2442/Itla/solid/asemble/3 hole link.SLDPRT

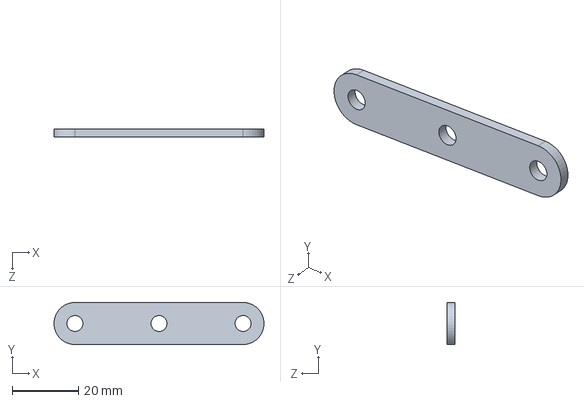
[picture p351: CAD file, 2026-11-01]
solid/asemble/3 hole link.SLDPRT
63.5 x 12.7 x 2.54 mm
