mk2442/Itla/solid/cafetera/embudo.SLDPRT

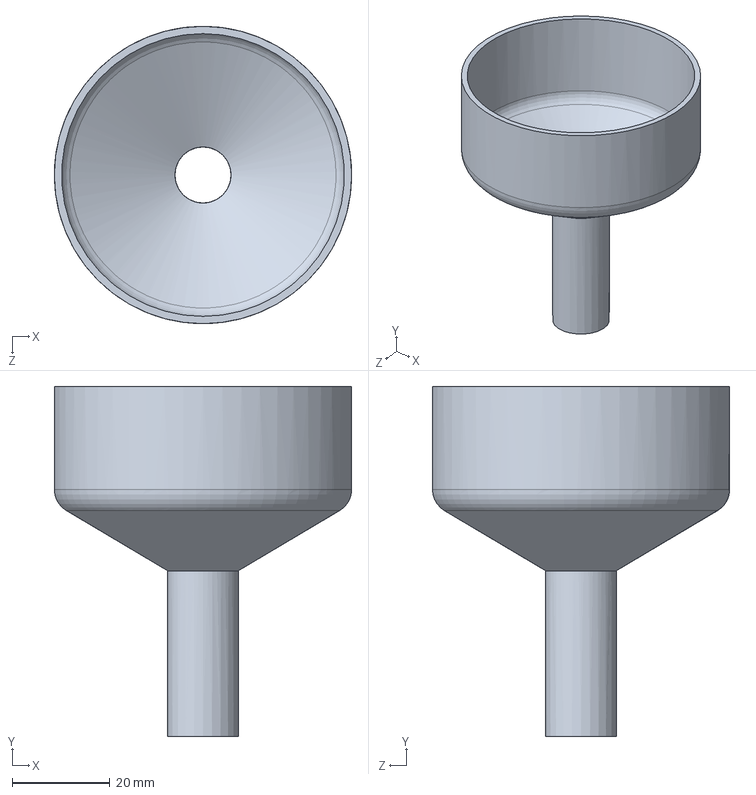
[picture p352: CAD file, 2026-11-01]
solid/cafetera/embudo.SLDPRT
61.0 x 71.8 x 61.0 mm
