mk2442/Itla/solid/eco/s.SLDPRT

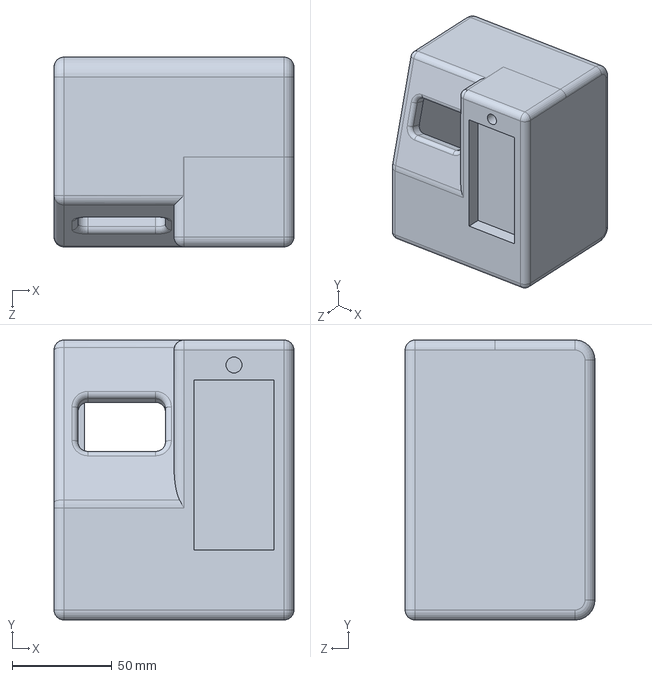
[picture p353: CAD file, 2026-11-01]
solid/eco/s.SLDPRT
120.0 x 140.0 x 94.9 mm
