mk2442/Itla/solid/figura 1.SLDPRT

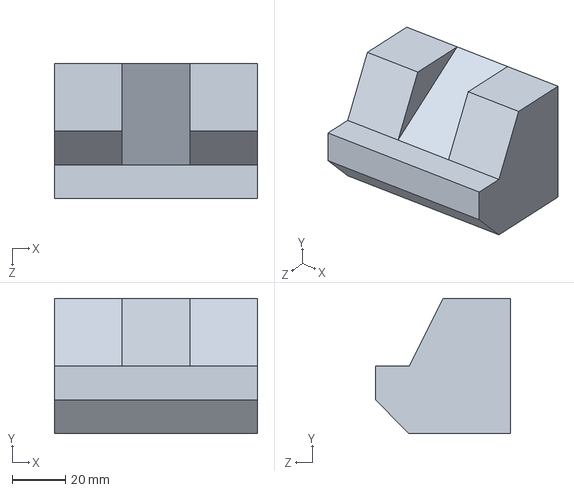
[picture p354: CAD file, 2026-11-01]
solid/figura 1.SLDPRT
76.2 x 50.8 x 50.8 mm
