mk2442/Itla/solid/greca/a/Nueva carpeta/Piezas del Sistema de giro/Eje Exagonal de Giro.SLDPRT

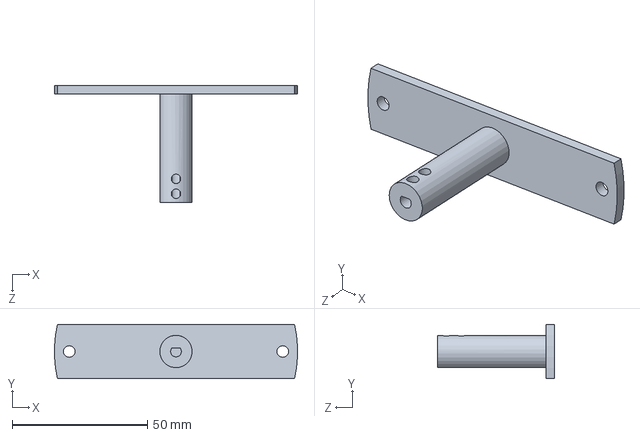
[picture p355: CAD file, 2026-11-01]
solid/greca/a/Nueva carpeta/Piezas del Sistema de giro/Eje Exagonal de Giro.SLDPRT
89.9 x 20.0 x 43.3 mm
