mk2442/Itla/solid/greca/valbula.SLDPRT

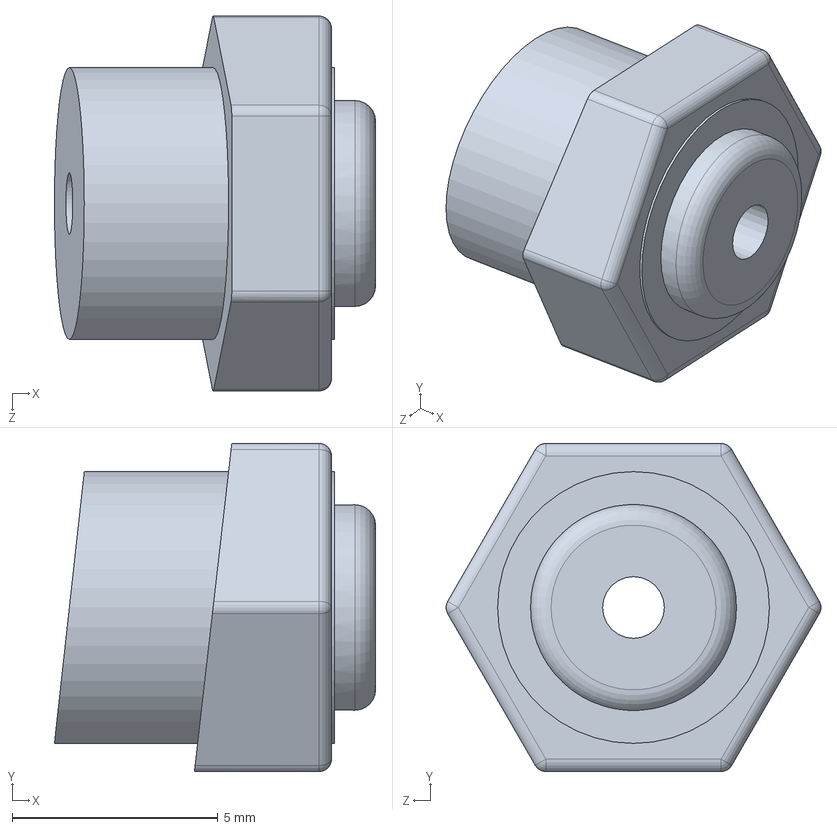
[picture p356: CAD file, 2026-11-01]
solid/greca/valbula.SLDPRT
7.80 x 7.97 x 9.11 mm
