mk2442/Itla/solid/parcial final/pin.SLDPRT

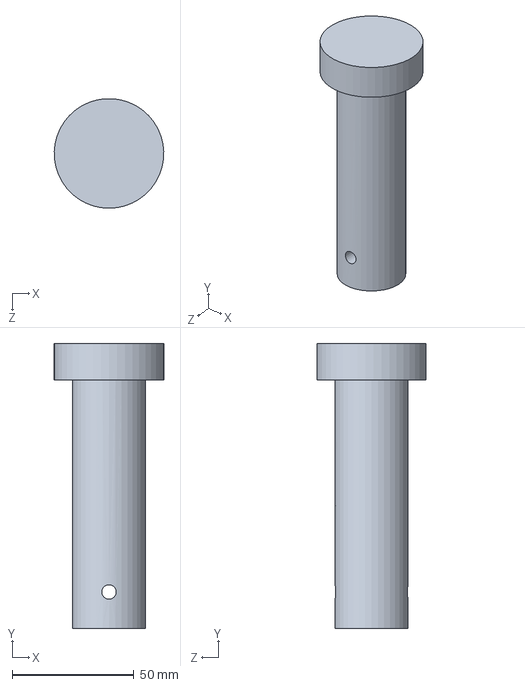
[picture p357: CAD file, 2026-11-01]
solid/parcial final/pin.SLDPRT
45.0 x 117.0 x 44.9 mm
