mk2442/Itla/solid/pieza/afsgd/Pieza1.3mf

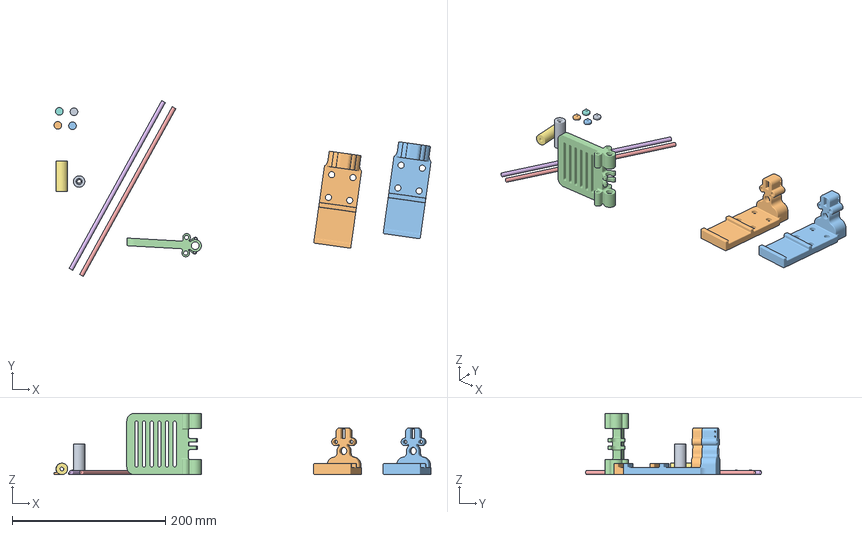
[picture p358: CAD file, 2026-11-01]
solid/pieza/afsgd/Pieza1.3mf
492.0 x 229.5 x 80.0 mm
Pieza1.STL x 2
Pieza2.STL x 4
porton.STL
Pieza117.STL x 2
soporte steppler1.STL x 2
