mk2442/Itla/solid/pieza/soporteSLDPRT.SLDPRT

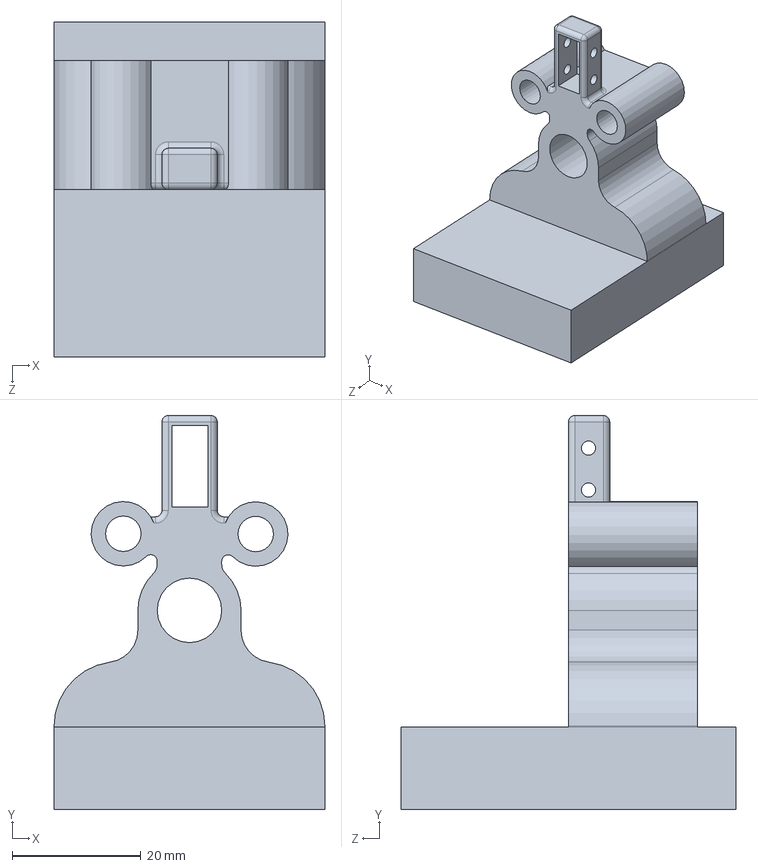
[picture p359: CAD file, 2026-11-01]
solid/pieza/soporteSLDPRT.SLDPRT
42.0 x 61.1 x 52.0 mm
