mk2442/Itla/solid/a/taper pin.SLDPRT

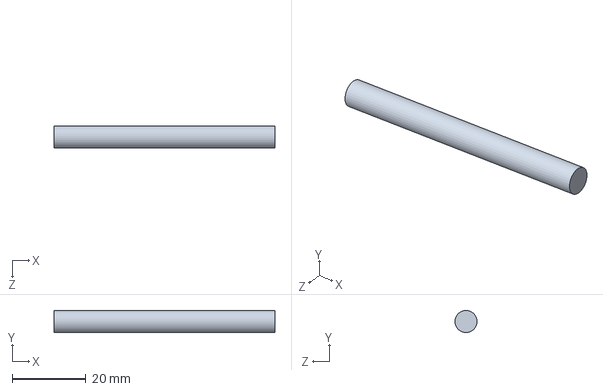
[picture p360: CAD file, 2026-11-01]
solid/a/taper pin.SLDPRT
60.0 x 5.97 x 6.00 mm
