mk2442/Itla/solid/cafetera/colador 2.SLDPRT

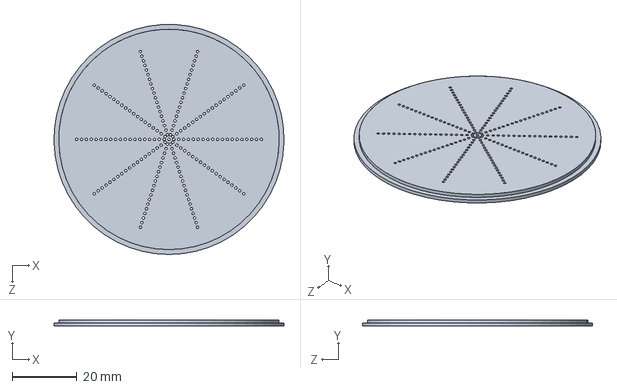
[picture p361: CAD file, 2026-11-01]
solid/cafetera/colador 2.SLDPRT
71.0 x 2.00 x 70.9 mm
