mk2442/Itla/solid/greca/a/Nueva carpeta/Piezas del Sistema de giro/Rodamiento Hub.SLDPRT

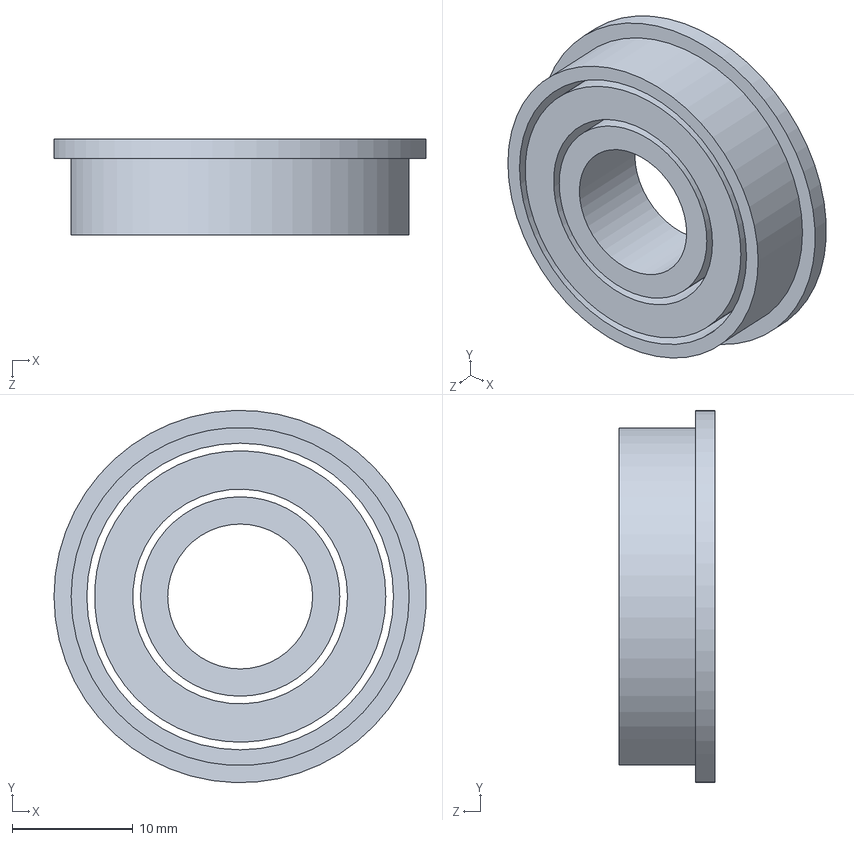
[picture p362: CAD file, 2026-11-01]
solid/greca/a/Nueva carpeta/Piezas del Sistema de giro/Rodamiento Hub.SLDPRT
30.8 x 30.8 x 7.95 mm
