mk2442/Itla/solid/greca/tapa.SLDPRT

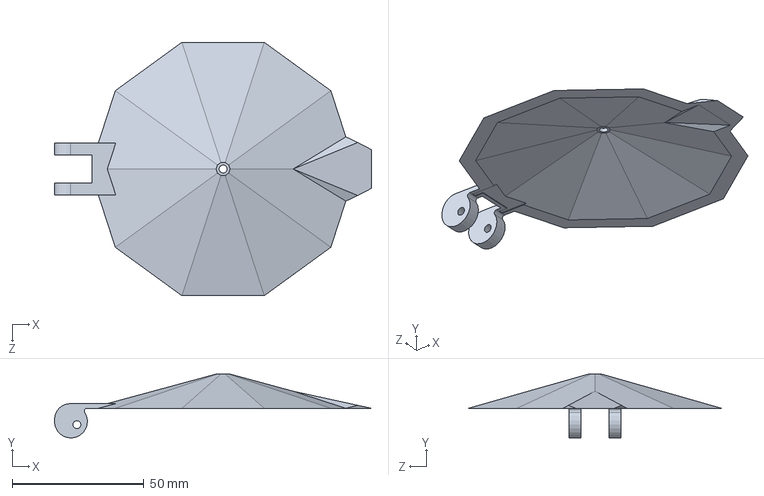
[picture p363: CAD file, 2026-11-01]
solid/greca/tapa.SLDPRT
120.4 x 24.2 x 96.2 mm
