mk2442/Itla/solid/Part7.SLDPRT

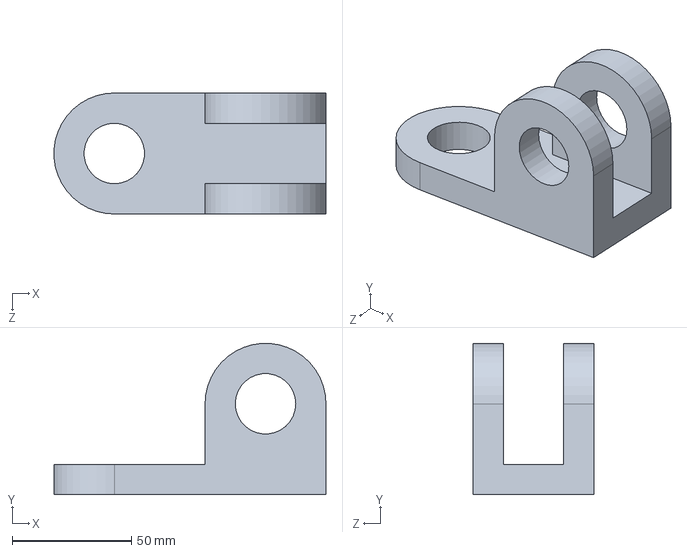
[picture p364: CAD file, 2026-11-01]
solid/Part7.SLDPRT
114.2 x 63.4 x 50.8 mm
