mk2442/Itla/solid/pieza/porton.SLDPRT

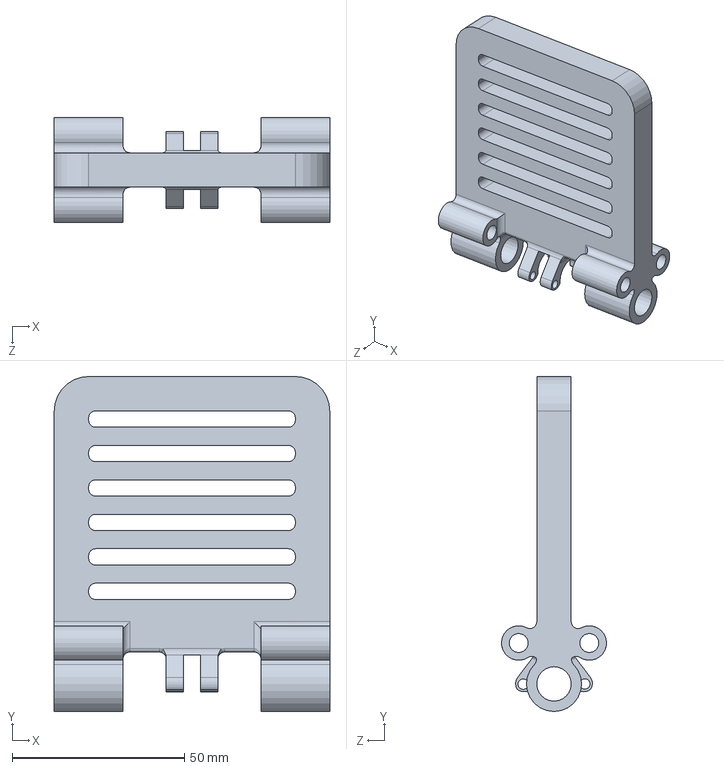
[picture p365: CAD file, 2026-11-01]
solid/pieza/porton.SLDPRT
80.0 x 97.2 x 30.5 mm
