mk2442/Itla/solid/cafetera/colador.SLDPRT

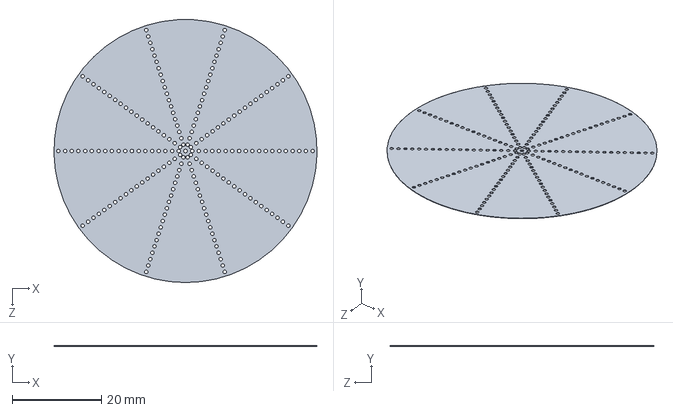
[picture p366: CAD file, 2026-11-01]
solid/cafetera/colador.SLDPRT
59.0 x 0.1 x 59.0 mm
