mk2442/Itla/solid/figura 13.SLDPRT

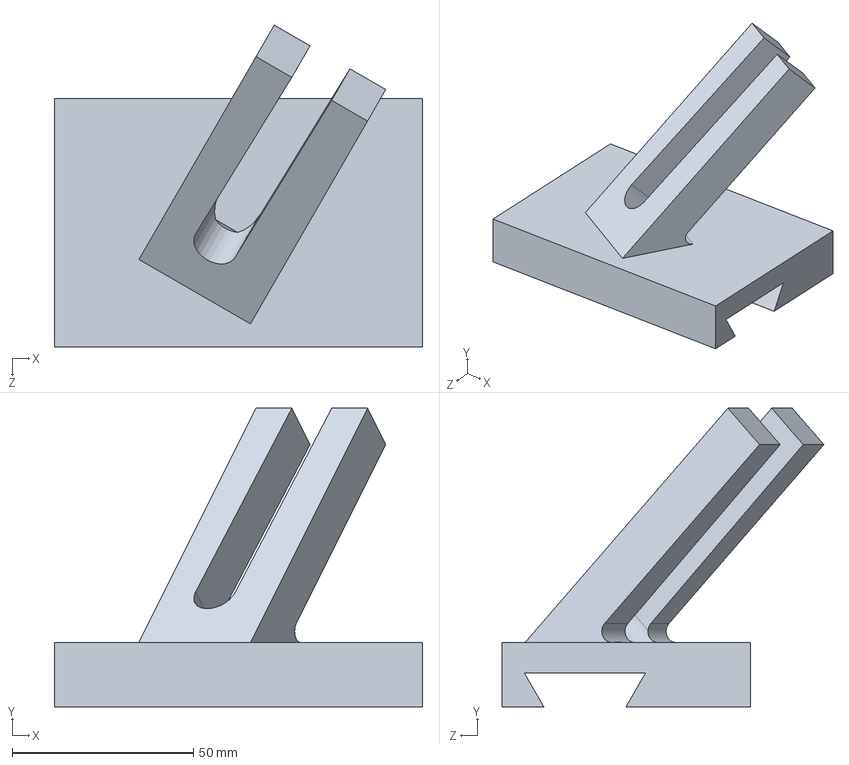
[picture p367: CAD file, 2026-11-01]
solid/figura 13.SLDPRT
101.6 x 82.4 x 88.8 mm
