mk2442/Itla/solid/greca/a/Nueva carpeta/Piezas del Sistema de giro/soporte 2.SLDPRT

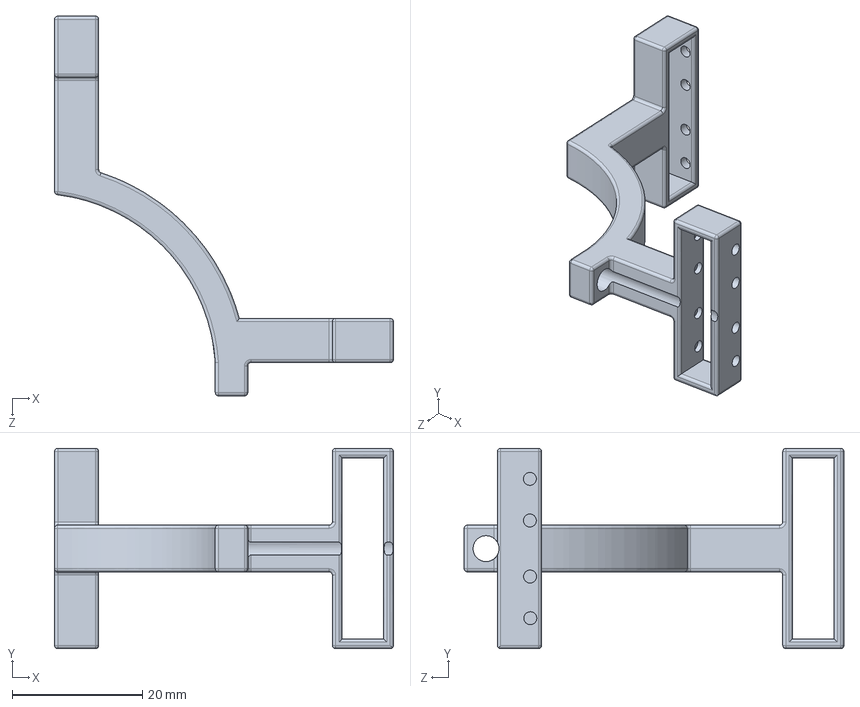
[picture p368: CAD file, 2026-11-01]
solid/greca/a/Nueva carpeta/Piezas del Sistema de giro/soporte 2.SLDPRT
52.1 x 30.8 x 58.4 mm
