mk2442/Itla/solid/p/Pieza2.SLDPRT

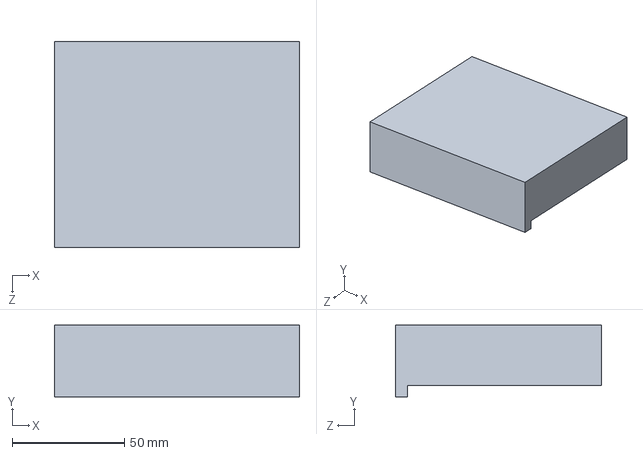
[picture p369: CAD file, 2026-11-01]
solid/p/Pieza2.SLDPRT
109.0 x 32.0 x 91.8 mm
