mk2442/Itla/solid/pieza/porton p.SLDPRT

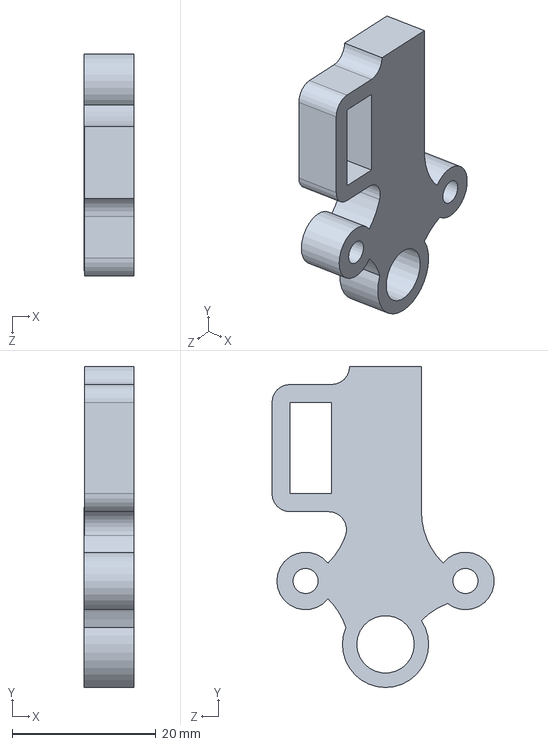
[picture p370: CAD file, 2026-11-01]
solid/pieza/porton p.SLDPRT
7.00 x 44.7 x 30.9 mm
