mk2442/Itla/solid/cafetera/valbula.SLDPRT

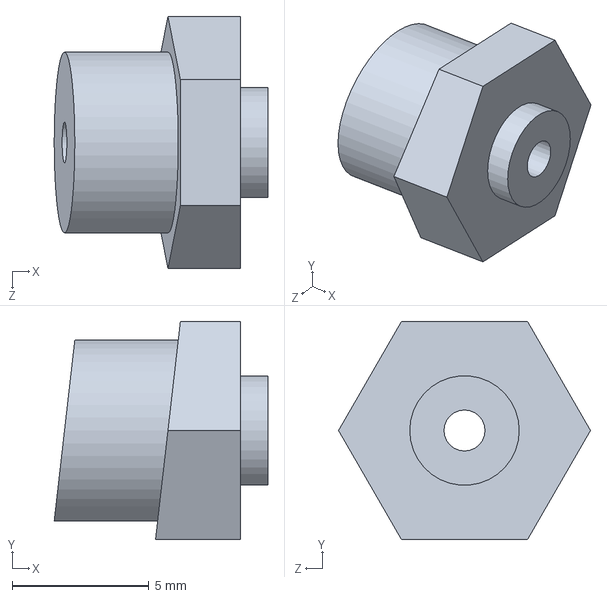
[picture p371: CAD file, 2026-11-01]
solid/cafetera/valbula.SLDPRT
7.80 x 7.97 x 9.20 mm
