mk2442/Itla/solid/greca/a/Nueva carpeta/Piezas del Sistema de giro/Rodamiento Hub Externo.SLDPRT

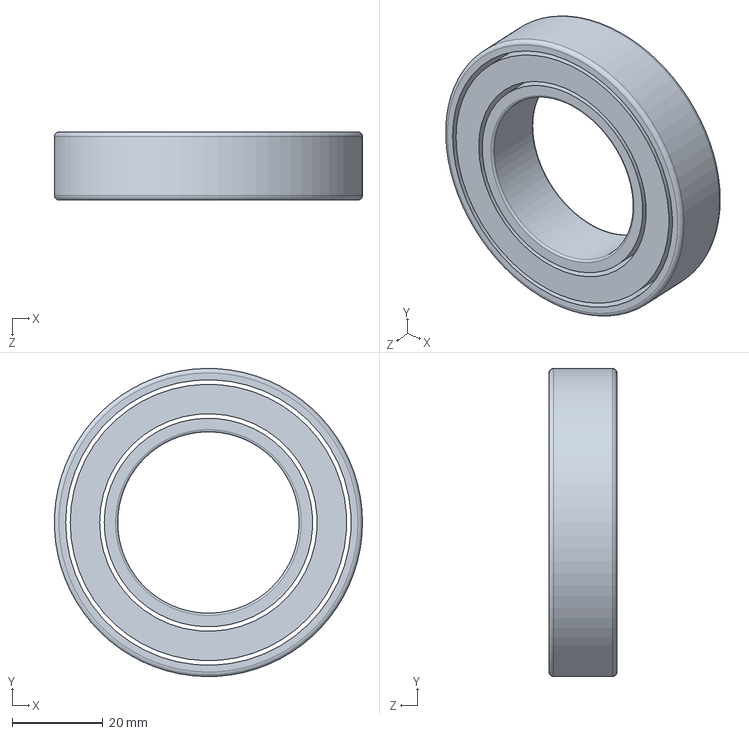
[picture p372: CAD file, 2026-11-01]
solid/greca/a/Nueva carpeta/Piezas del Sistema de giro/Rodamiento Hub Externo.SLDPRT
68.0 x 68.0 x 15.0 mm
