mk2442/Itla/solid/greca/palito de la tapa.SLDPRT

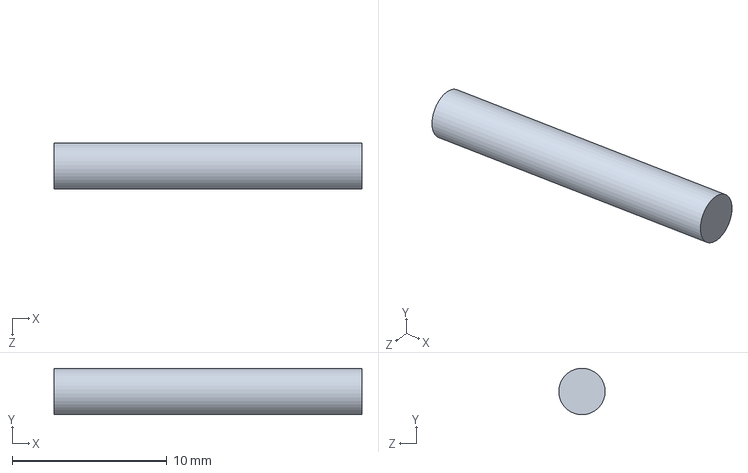
[picture p373: CAD file, 2026-11-01]
solid/greca/palito de la tapa.SLDPRT
19.9 x 3.00 x 2.99 mm
