mk2442/Itla/solid/Part22.SLDPRT

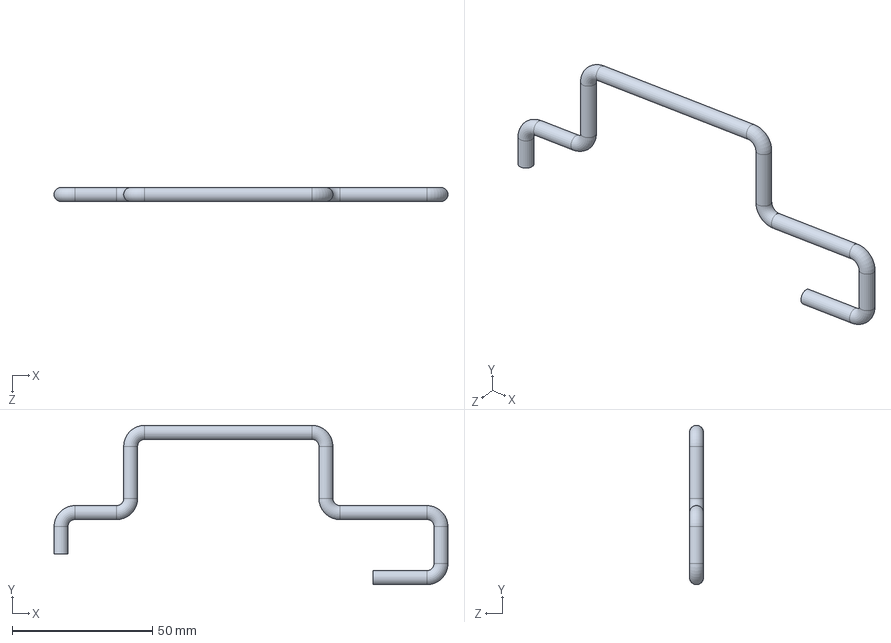
[picture p374: CAD file, 2026-11-01]
solid/Part22.SLDPRT
140.3 x 56.7 x 5.00 mm
