mk2442/Itla/solid/18.SLDPRT

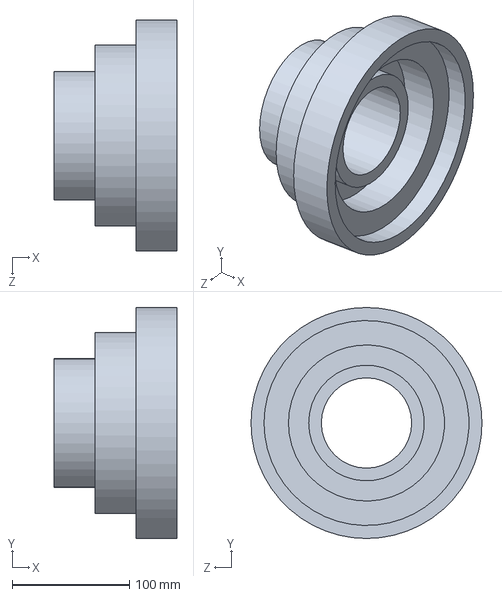
[picture p375: CAD file, 2026-11-01]
solid/18.SLDPRT
105.0 x 197.4 x 197.4 mm
