mk2442/Itla/solid/pieza/soporte steppler11.SLDPRT

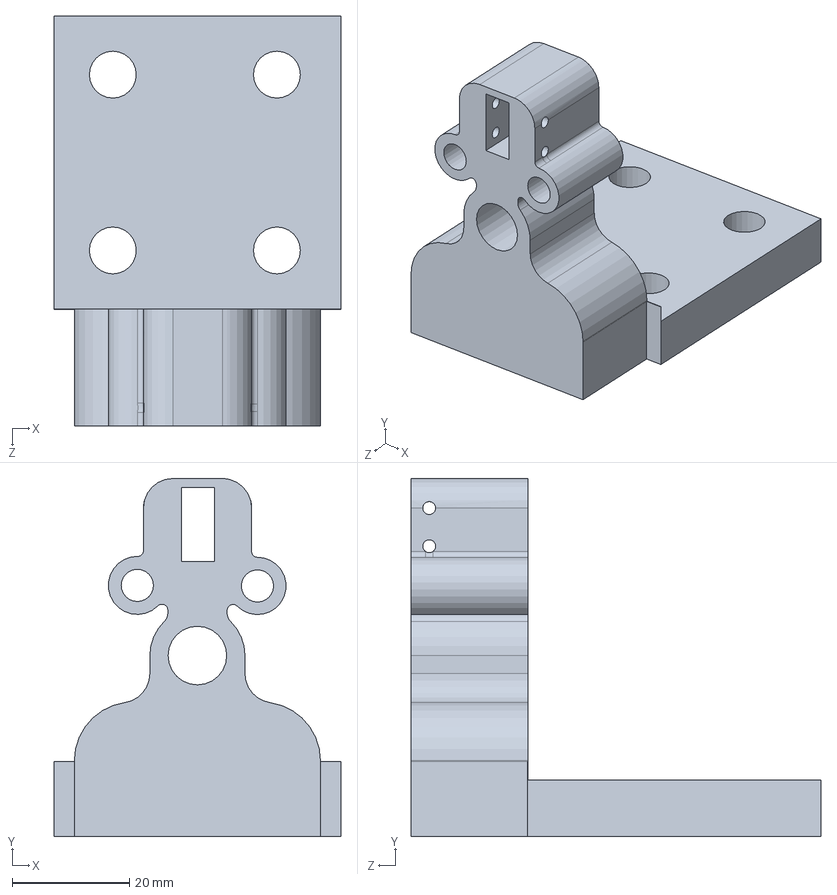
[picture p376: CAD file, 2026-11-01]
solid/pieza/soporte steppler11.SLDPRT
48.9 x 61.1 x 69.9 mm
