mk2442/Itla/solid/cafetera/tapaa.SLDPRT

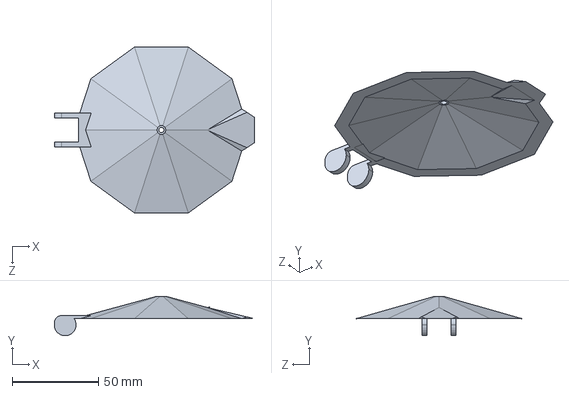
[picture p377: CAD file, 2026-11-01]
solid/cafetera/tapaa.SLDPRT
116.0 x 22.9 x 96.2 mm
