mk2442/Itla/solid/cafetera/base.SLDPRT

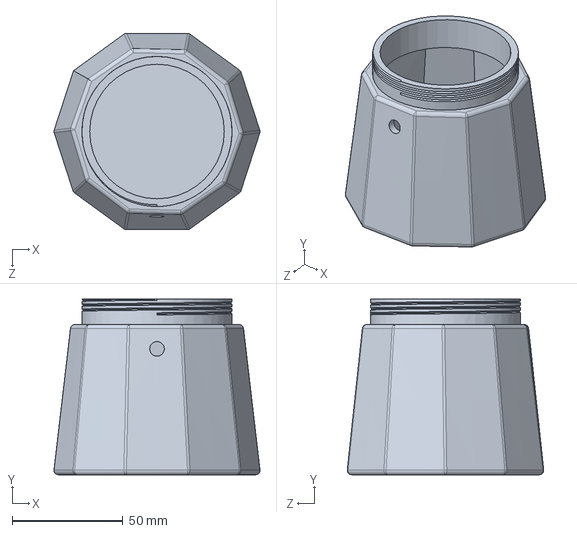
[picture p378: CAD file, 2026-11-01]
solid/cafetera/base.SLDPRT
92.9 x 79.2 x 88.6 mm
