mk2442/Itla/solid/empaque/1/Ensamblaje1.SLDASM

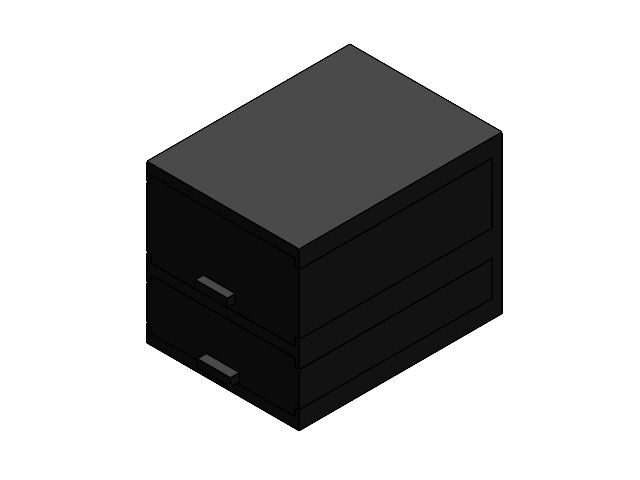
[picture p379: CAD file, 2026-11-01]
solid/empaque/1/Ensamblaje1.SLDASM
empaque
cajon 2
cajon 1
