mk2442/Itla/solid/rover/Ensamblaje1.SLDASM

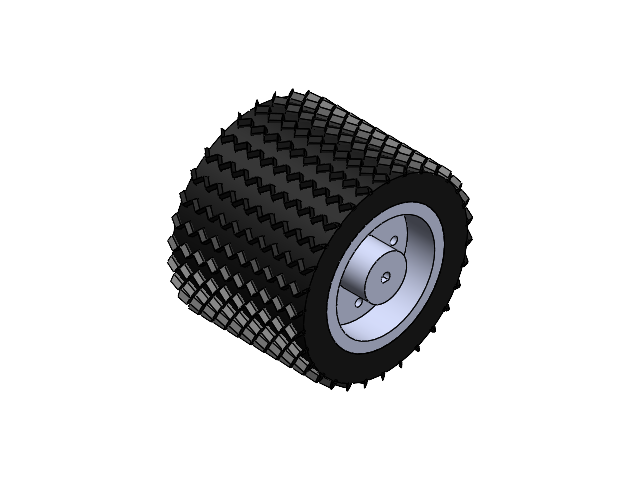
[picture p380: CAD file, 2026-11-01]
solid/rover/Ensamblaje1.SLDASM
centro de rueda
transmicion
goma
