mk2442/Itla/solid/greca/a/Nueva carpeta/Piezas del Sistema de giro/Sistema de Giro Mark 4.SLDASM

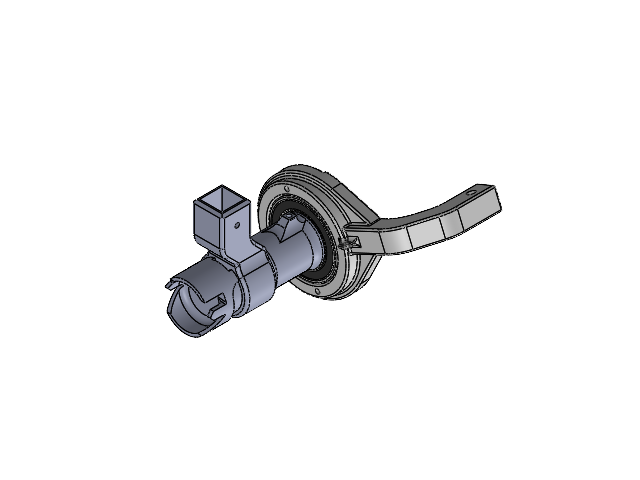
[picture p381: CAD file, 2026-11-01]
solid/greca/a/Nueva carpeta/Piezas del Sistema de giro/Sistema de Giro Mark 4.SLDASM
Case Motor de Giro Nuevo
Rodamiento Hub Externo
Rodamiento Hub
Sujetador Motor A
Eje Exagonal de Giro
Case Motor de Giro Nuevo Tapa
