mk2442/Itla/solid/eco/Ensamblaje1.SLDASM

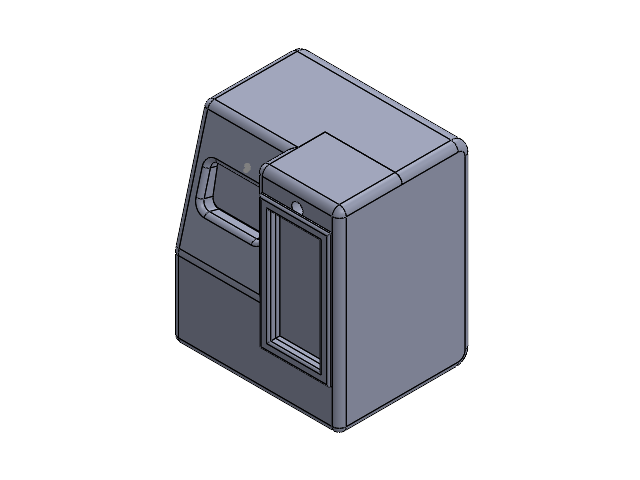
[picture p382: CAD file, 2026-11-01]
solid/eco/Ensamblaje1.SLDASM
s
ss
tp
p
