mk2442/Itla/solid/greca/greca v2.SLDASM

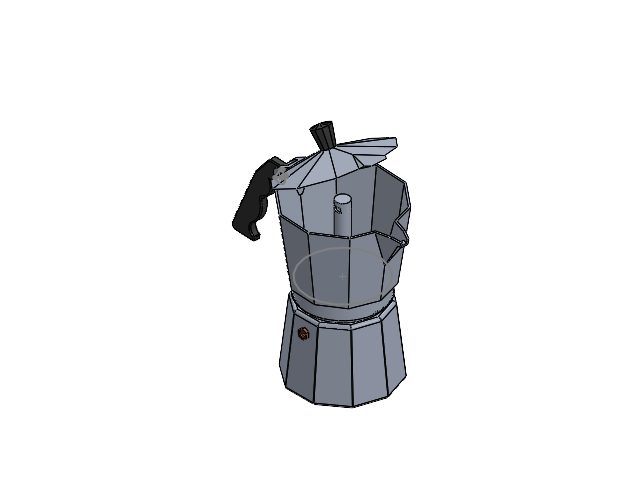
[picture p383: CAD file, 2026-11-01]
solid/greca/greca v2.SLDASM
base
arandela de goma
cabezita
colador-embudo
colador-tapa
embudo
mango
palito de la tapa x 2
parte de arriba
tapa
valbula
