mk2442/Itla/(list of files, cad)

Other CAD files:
solid/p/p/Ensamblaje1 - Pieza2-2-1.gcode.3mf
solid/p/Ensamblaje1 - Pieza1-1.STL
solid/asemble 2/block.SLDPRT
solid/ensable 3/braket.SLDPRT
solid/greca/a/TORNILLO 1/tornillo2.0.SLDPRT
solid/parcial final/collar.SLDPRT
solid/Part24.SLDPRT
solid/a/Pieza extractor.STL
solid/asemble 2/pin.SLDPRT
solid/ensamble 1/Part1.SLDPRT
solid/ensamble 2/u bracket.SLDPRT
solid/pieza/afsgd/Pieza2.STL
solid/ensable 3/well plate.SLDPRT
solid/ensamble 1/axle.SLDPRT
solid/p/Pieza1.SLDPRT
solid/asemble 3/pin.SLDPRT
solid/asemble/3 hole.SLDPRT
solid/ensable 3/axle.SLDPRT
solid/ensamble 1/link 3 hole.SLDPRT
solid/parcial final/taper pin.SLDPRT
solid/a/pin.SLDPRT
solid/asemble/collar.SLDPRT
solid/greca/cabezita.SLDPRT
solid/pieza/soporte steppler1.SLDPRT
solid/cafetera/palito.SLDPRT
solid/greca/arandela de goma.SLDPRT
solid/figura 2.SLDPRT
solid/greca/colador-embudo.SLDPRT
solid/pieza/Pieza117.SLDPRT
solid/Nueva carpeta (3)/Pieza1.SLDPRT
solid/Nueva carpeta (3)/Pieza1.STL
solid/Nueva carpeta (3)/Pieza2.SLDPRT
solid/Nueva carpeta (3)/Pieza2.STL
solid/Nueva carpeta (3)/Pieza3.SLDPRT
solid/Nueva carpeta (3)/Pieza3.STL
solid/Nueva carpeta (3)/soporte.SLDPRT
solid/Nueva carpeta (3)/tornillo.SLDPRT
solid/Nueva carpeta (4)/Cajita.SLDPRT
solid/Nueva carpeta (4)/Cajita.STL
solid/Nueva carpeta (4)/empuje.SLDPRT
solid/Nueva carpeta (4)/empuje.STL
solid/Nueva carpeta (4)/geometric perfume bottle 3d model (1).step
solid/Nueva carpeta (4)/rampa.SLDPRT
solid/Nueva carpeta (4)/rampa.STL
solid/Nueva carpeta (5)/Pieza1.SLDPRT
solid/Nueva carpeta (5)/Pieza1.STL
solid/Nueva carpeta (5)/Pieza2.SLDPRT
solid/Nueva carpeta (5)/Pieza2.STL
solid/Nueva carpeta (5)/Pieza4.SLDPRT
solid/Nueva carpeta (5)/Pieza4.STL
solid/Nueva carpeta (5)/flecha.SLDPRT
solid/Nueva carpeta (5)/flecha.STL
solid/Nueva carpeta (6)/Ensamblaje1.SLDASM
solid/Nueva carpeta (6)/Pieza1.SLDPRT
solid/Nueva carpeta (6)/Pieza2.SLDPRT
solid/Nueva carpeta (6)/Pieza3.SLDPRT
solid/Part1.SLDPRT
solid/Part13.SLDPRT
solid/Part14.SLDPRT
solid/Part15.SLDPRT
solid/Part16.SLDPRT
solid/Part17.SLDPRT
solid/Part18.SLDPRT
solid/Part19.SLDPRT
solid/Part20.SLDPRT
solid/Part21.SLDPRT
solid/Part23.SLDPRT
solid/Part26.SLDPRT
solid/Part27.SLDPRT
solid/Part28.SLDPRT
solid/Part29.SLDPRT
solid/Part3.SLDPRT
solid/Part30.SLDPRT
solid/Part31.SLDPRT
solid/Part32.SLDPRT
solid/Part33.SLDPRT
solid/Part4.SLDPRT
solid/Part5.SLDPRT
solid/Part6.SLDPRT
solid/Part8.SLDPRT
solid/Pieza de mono.SLDPRT
solid/Pieza de mono.STL
solid/a/knucle point.SLDDRW
solid/asemble 2/asemble 2.SLDDRW
solid/asemble 3/Hoja de Drawing.SLDDRW
solid/asemble/Hoja de Drawing.SLDDRW
solid/asemble/drawing 1.SLDDRW
solid/cachu.SLDPRT
solid/cuchara.SLDPRT
solid/empaque/1/cajon 1.STL
solid/empaque/1/cajon 2.STL
solid/empaque/1/empaque.3mf
solid/empaque/1/empaque.STL
solid/figura 11.SLDPRT
solid/figura 12.SLDPRT
solid/figura 14.SLDPRT
solid/figura 3.SLDPRT
solid/figura 4.SLDPRT
solid/figura 5.SLDPRT
solid/figura 6.SLDPRT
solid/figura 7.SLDPRT
solid/figura 8.SLDPRT
solid/figura 9.SLDPRT
solid/greca/Hoja de Drawing.SLDDRW
solid/greca/a/3d/Pieza extractor2.0.STL
solid/greca/a/3d/Pieza extractor2.STL
solid/greca/a/3d/extractor 3.STL
solid/greca/a/Nueva carpeta/Piezas del Sistema de giro/soporte 2.STL
solid/greca/a/TORNILLO 1/tornillo2.0.STL
solid/greca/drawing greca 1.SLDDRW
solid/greca/greca v1.SLDASM
solid/greca/mango.SLDPRT
solid/greca/parte de arriba.SLDPRT
solid/hojas/Hoja de Drawing (1).SLDDRW
solid/hojas/Hoja de Drawing.SLDDRW
solid/hojas/articulación.SLDDRW
solid/hojas/brazo.SLDDRW
solid/hojas/rueda.SLDDRW
solid/p/Ensamblaje1 - Pieza2-2-1.STL
solid/peifume.SLDPRT
solid/pelfume.SLDPRT
solid/pieza/Pieza1.3mf
solid/pieza/Pieza1.STL
solid/pieza/adaptador.STL
solid/pieza/afsgd/Pieza1.STL
solid/pieza/porton p.STL
solid/pieza/soporte steppler.STL
solid/pieza/soporteSLDPRT.STL
solid/poster.SLDPRT
solid/poster.STEP
solid/u bracket.SLDPRT
solid/ñuchara.SLDPRT
