mk2442/Itla/solid/a/knucle point.pdf

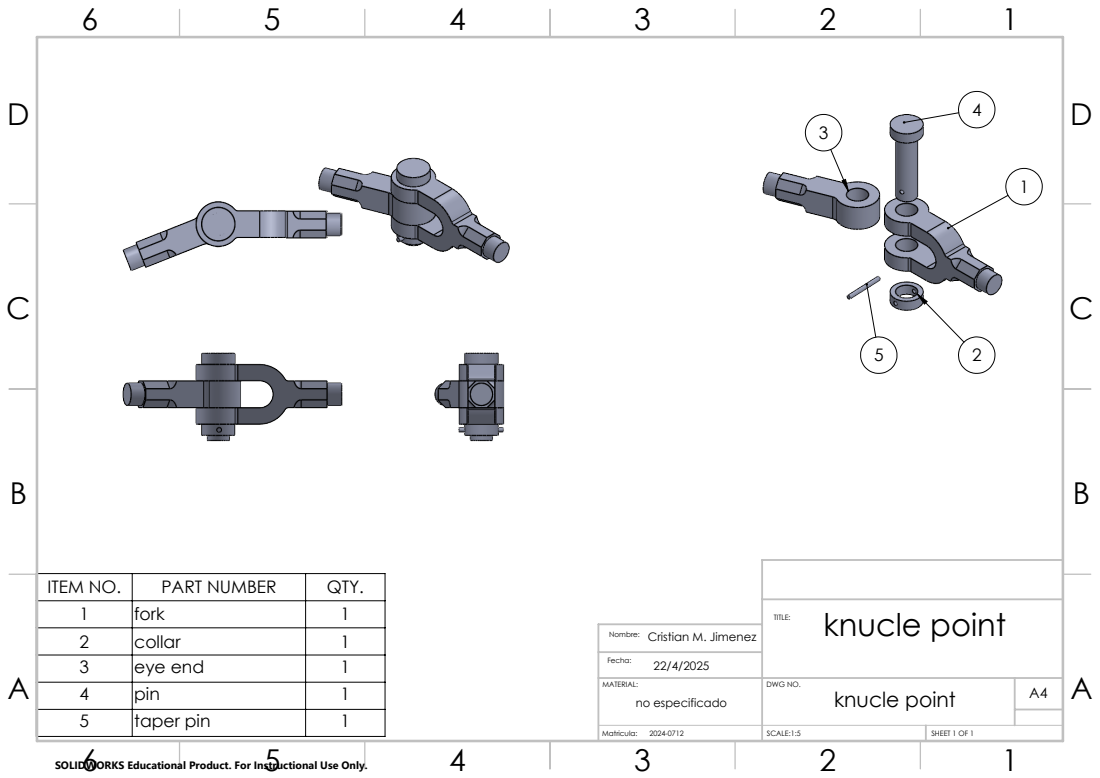
[picture p384: page 1]
ITEM NO.; PART NUMBER; QTY.; eye end; Cristian M. Jimenez

knucle point TITLE:

4 | pin | 1
5 | taper pin | 1

MATERIAL: | DWG NO. knucle point | A4 no especificado

Matricula: 2024-0712 | SCALE:1:5 | SHEET 1 OF 1

SOLIDWORKS Educational Product. For Instructional Use Only.

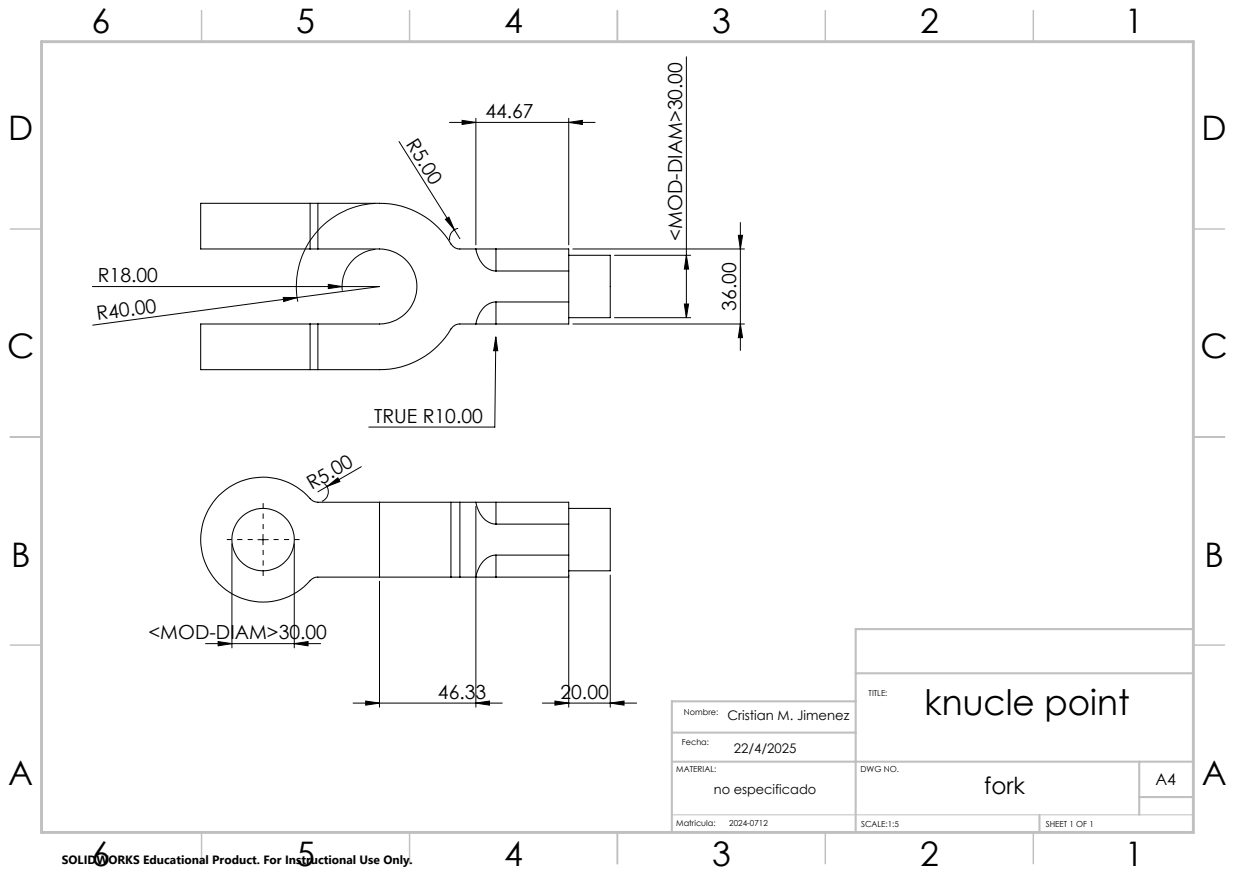
[picture p385: page 2]
TRUE R10.00; DWG NO. A4 no especificado; Cristian M. Jimenez

knucle point TITLE:

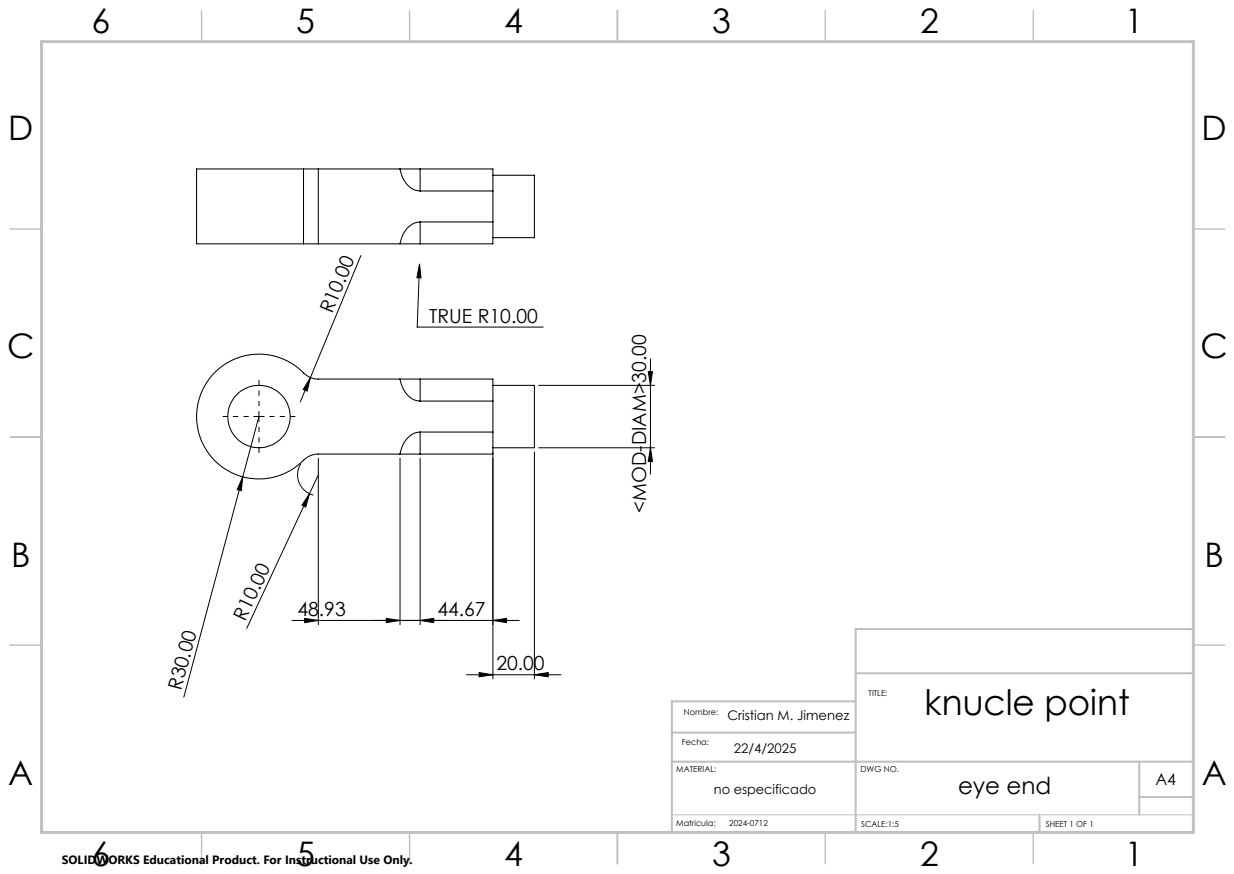
[picture p386: page 3]
TRUE R10.00; DWG NO. A4 no especificado eye end; Cristian M. Jimenez

knucle point TITLE:

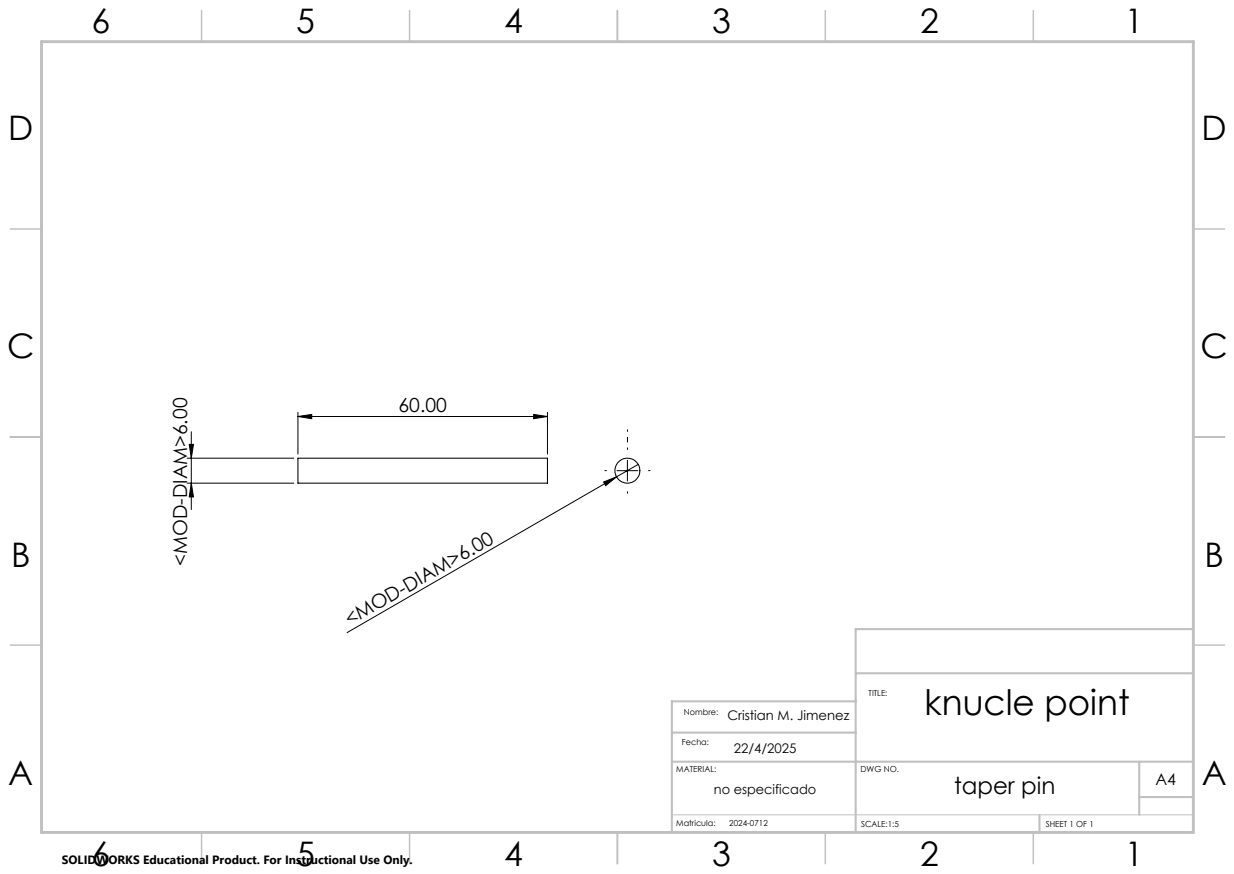
[picture p387: page 4]
DWG NO. A4 no especificado taper pin; Cristian M. Jimenez

knucle point TITLE:

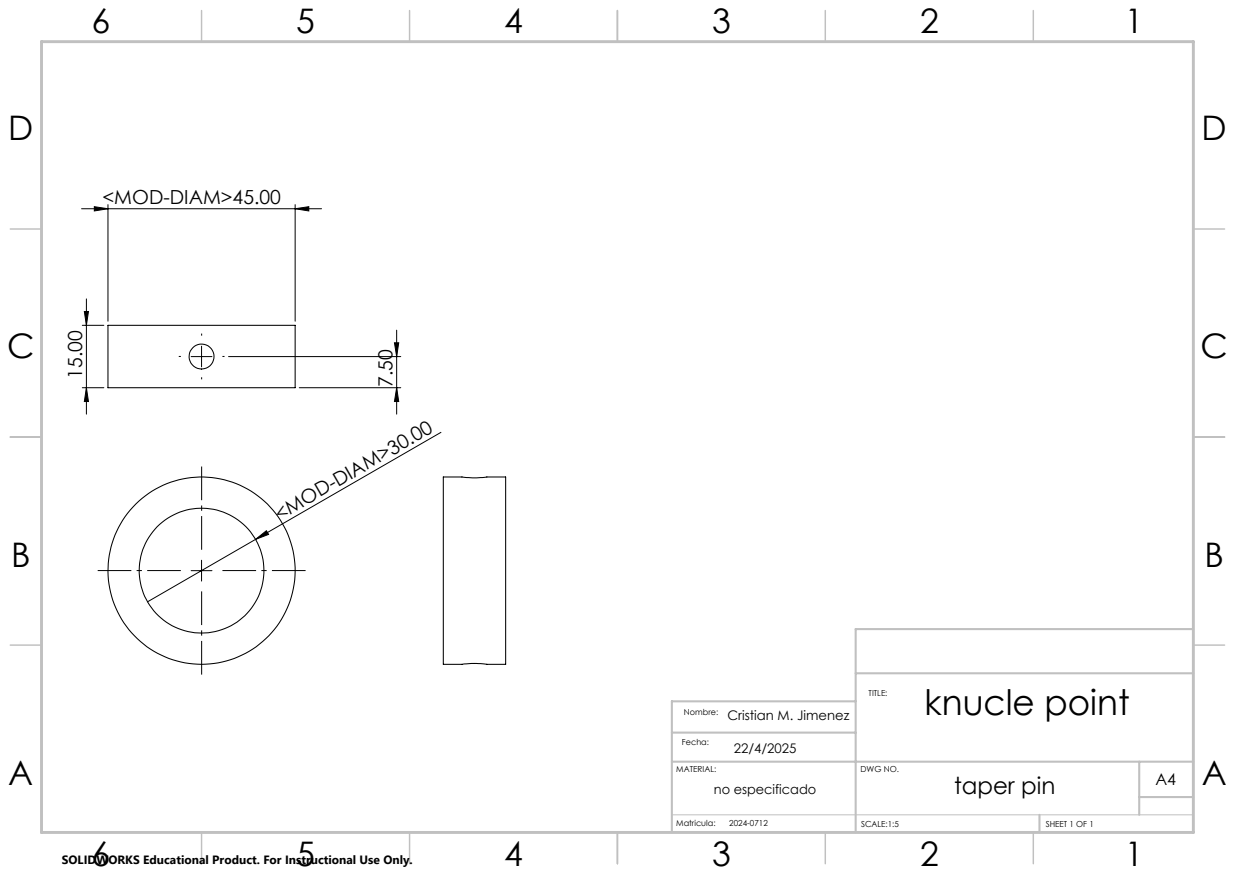
[picture p388: page 5]
<MOD-DIAM>30.00 7.50; DWG NO. A4 no especificado taper pin; Cristian M. Jimenez

knucle point TITLE:

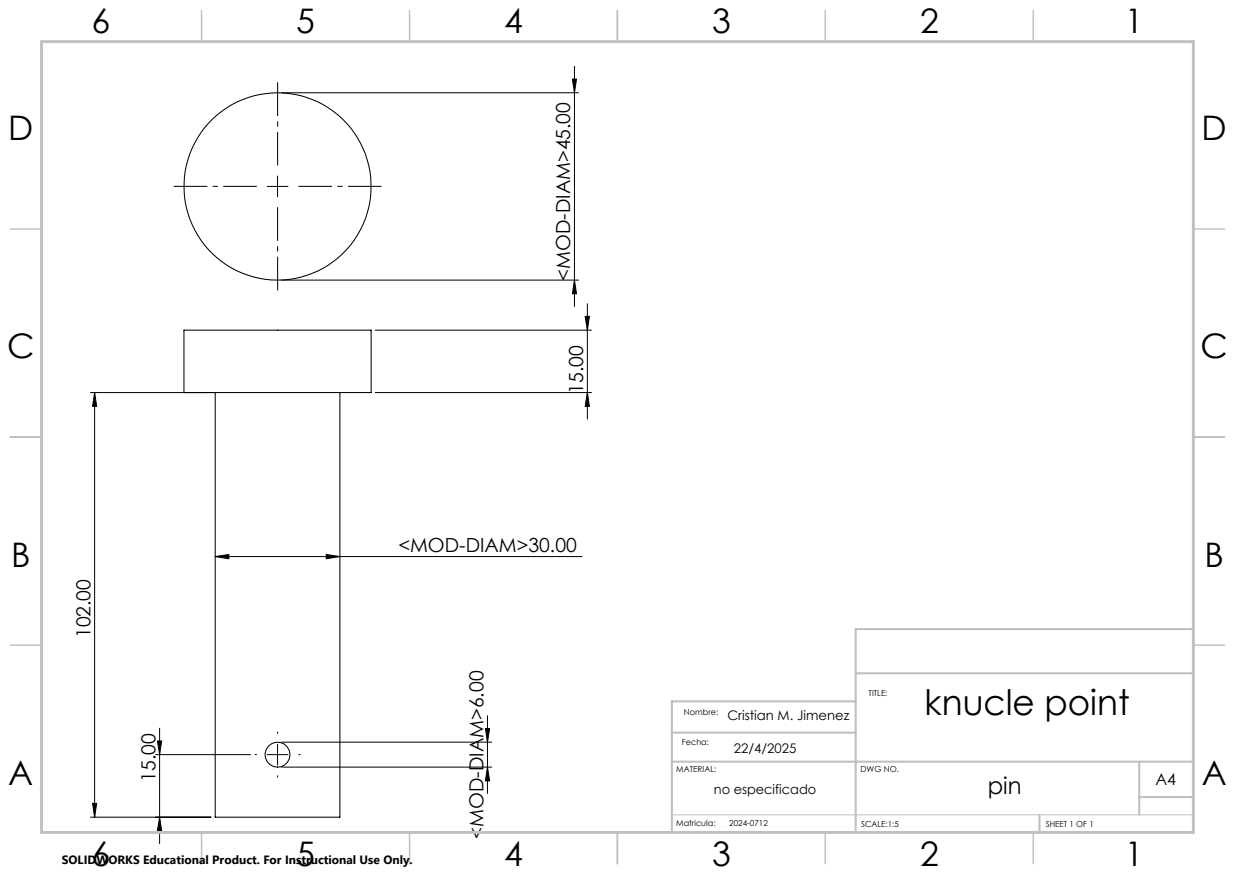
[picture p389: page 6]
<MOD-DIAM>45.00 15.00; DWG NO. A4 no especificado; Cristian M. Jimenez

<MOD-DIAM>30.00 <MOD-DIAM>6.00

knucle point TITLE:
