mk2442/Itla/digital/proyectos/electronica-ii/Electronica II/generador de pulsos/generador de pulso 2.pdf

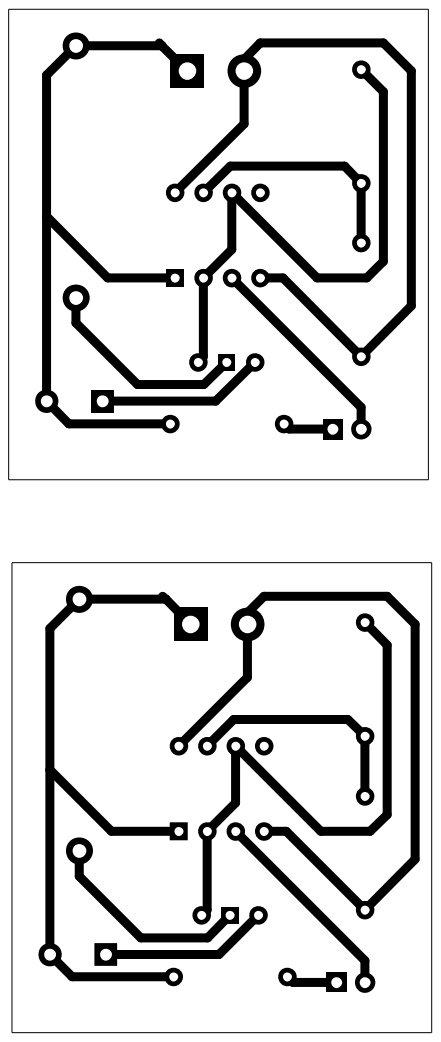
[picture p390: page 1]
