mk2442/Itla/solid/greca/Hoja de Drawing.pdf

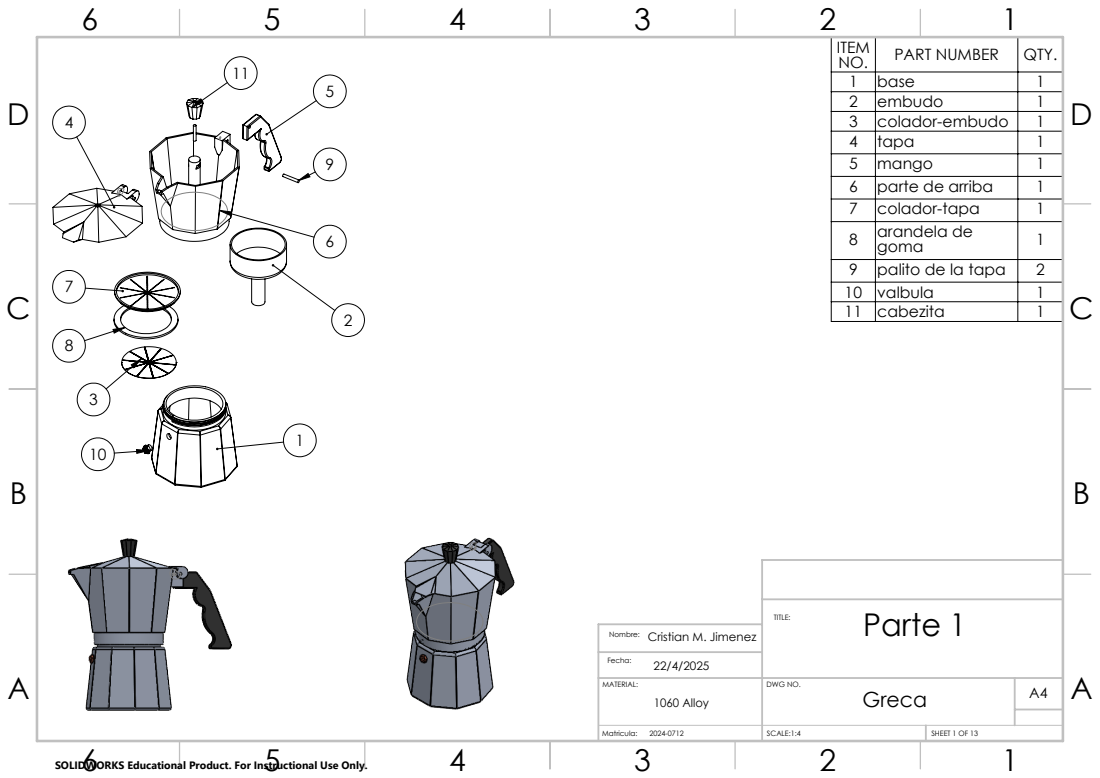
[picture p391: page 1]
DWG NO.; SCALE:1:4; SHEET 1 OF 13; 1060 Alloy; Matricula: 2024-0712; Parte 1 TITLE:; Cristian M. Jimenez

ITEM NO. | PART NUMBER | QTY.
1 | base | 1
2 | embudo | 1
3 | colador-embudo | 1
4 | tapa | 1
5 | mango | 1
6 | parte de arriba | 1
7 | colador-tapa | 1
8 | arandela de goma | 1
9 | palito de la tapa | 2
10 | valbula | 1
11 | cabezita | 1

SOLIDWORKS Educational Product. For Instructional Use Only.

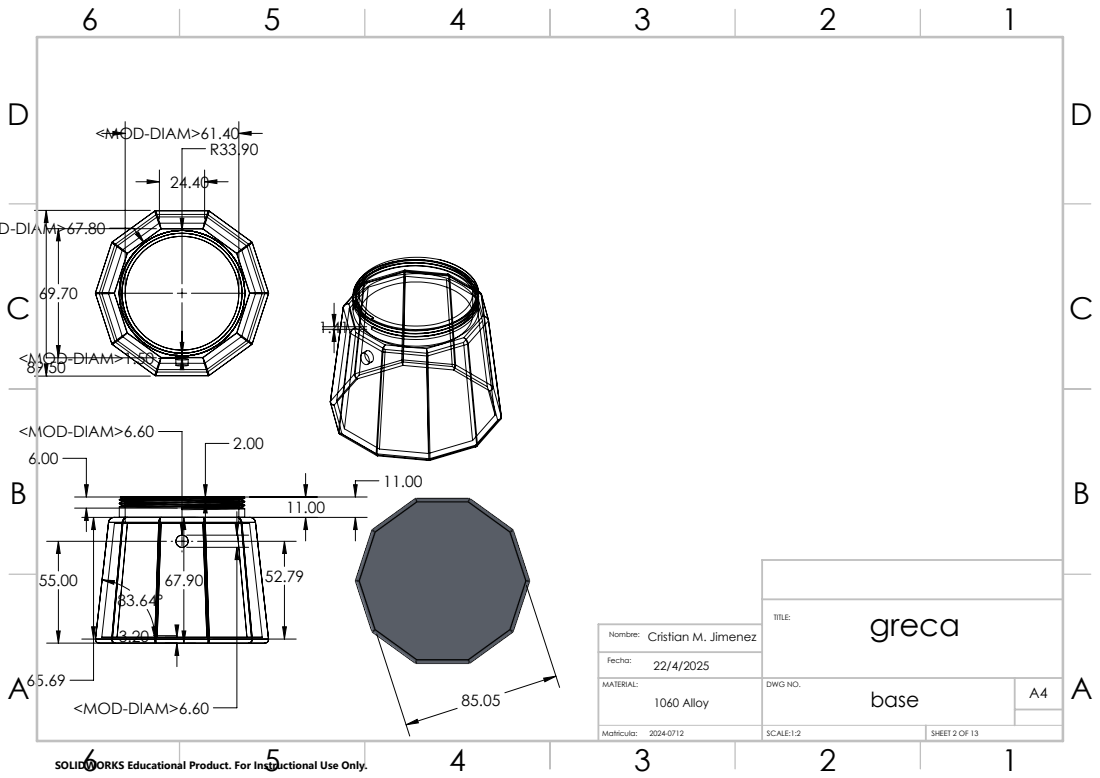
[picture p392: page 2]
DWG NO.; SCALE:1:2; SHEET 2 OF 13; 1060 Alloy; greca TITLE:; Cristian M. Jimenez

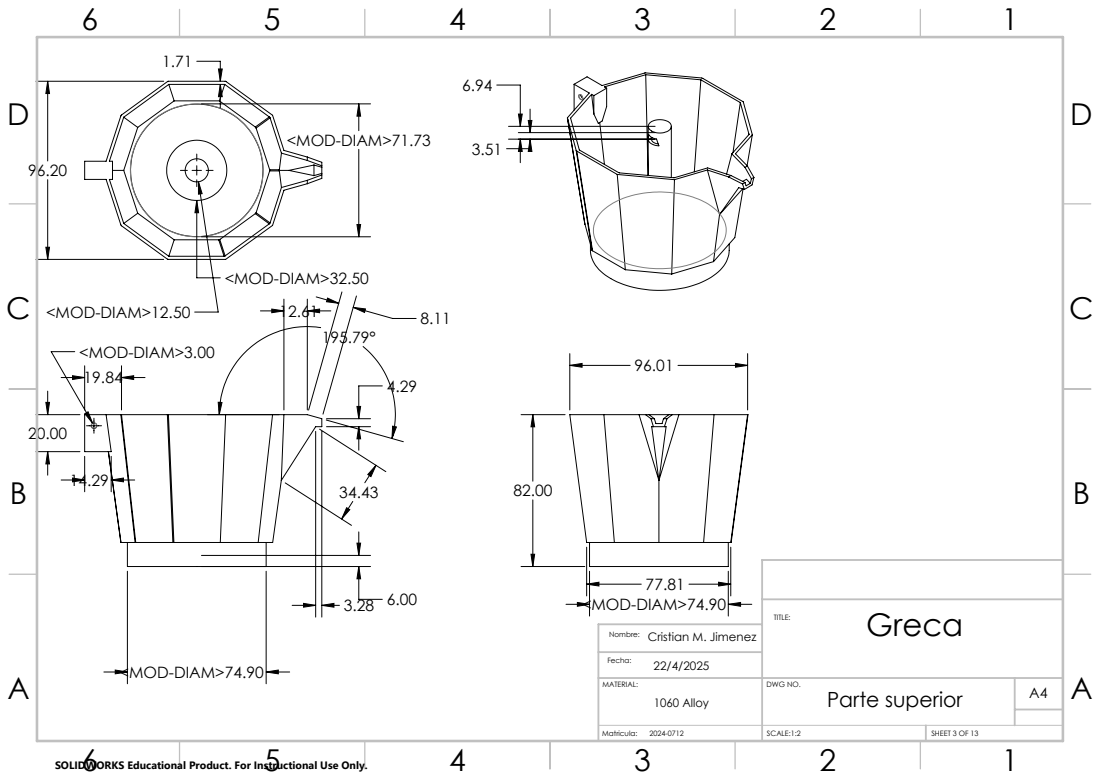
[picture p393: page 3]
DWG NO.; SCALE:1:2; SHEET 3 OF 13; 1060 Alloy; Parte superior; Greca TITLE:; Cristian M. Jimenez

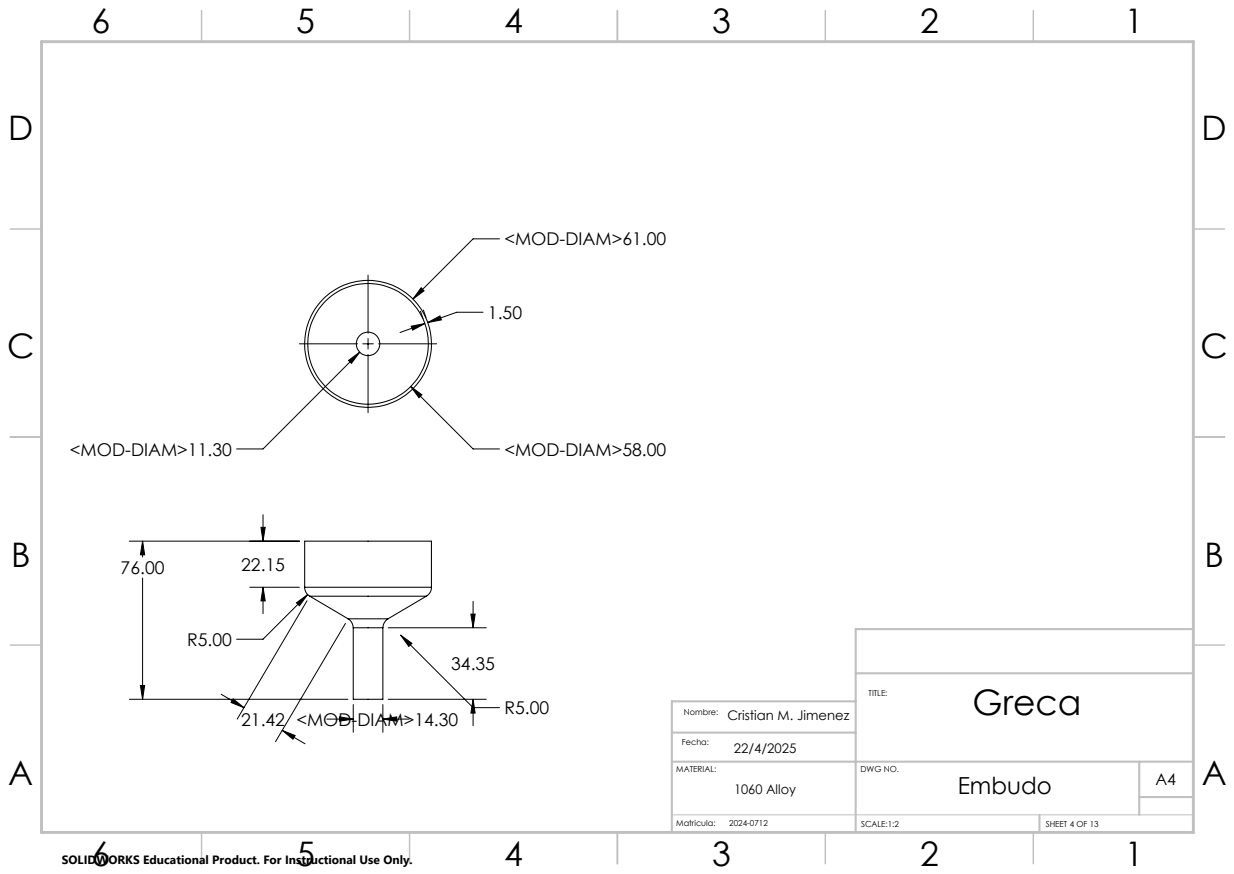
[picture p394: page 4]
DWG NO.; SCALE:1:2; SHEET 4 OF 13; 1060 Alloy; Greca TITLE:; Cristian M. Jimenez

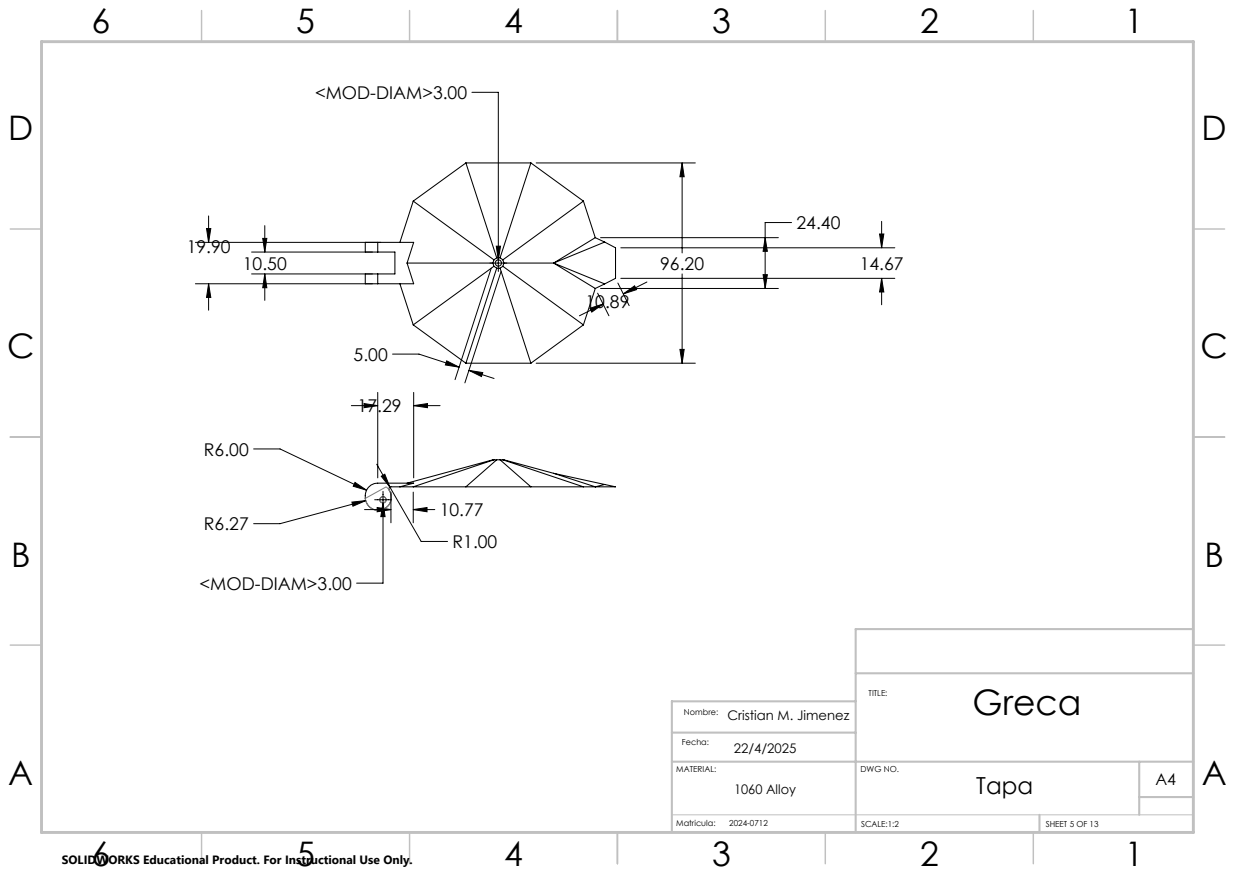
[picture p395: page 5]
DWG NO.; SCALE:1:2; SHEET 5 OF 13; 1060 Alloy; Greca TITLE:; Cristian M. Jimenez

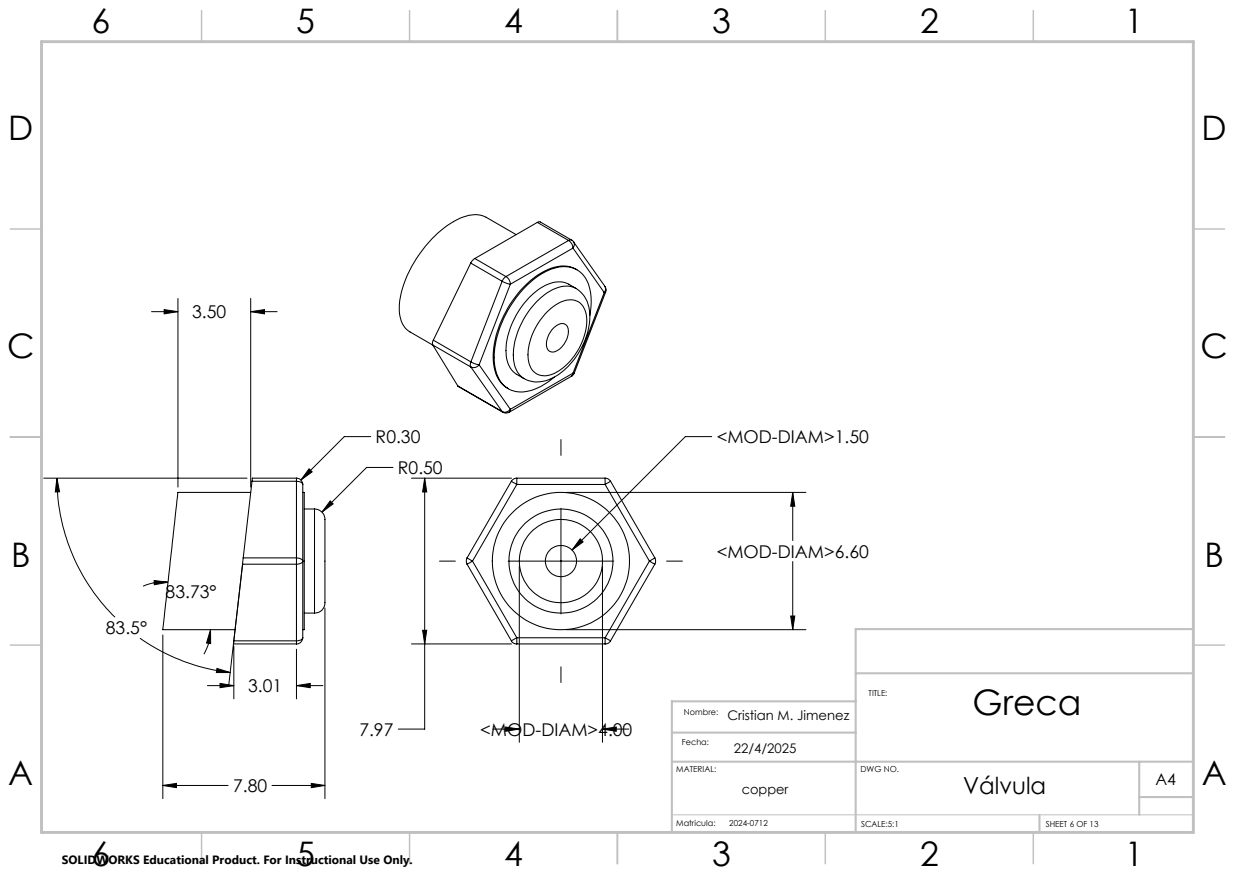
[picture p396: page 6]
DWG NO.; SCALE:5:1; SHEET 6 OF 13; Greca TITLE:; Cristian M. Jimenez

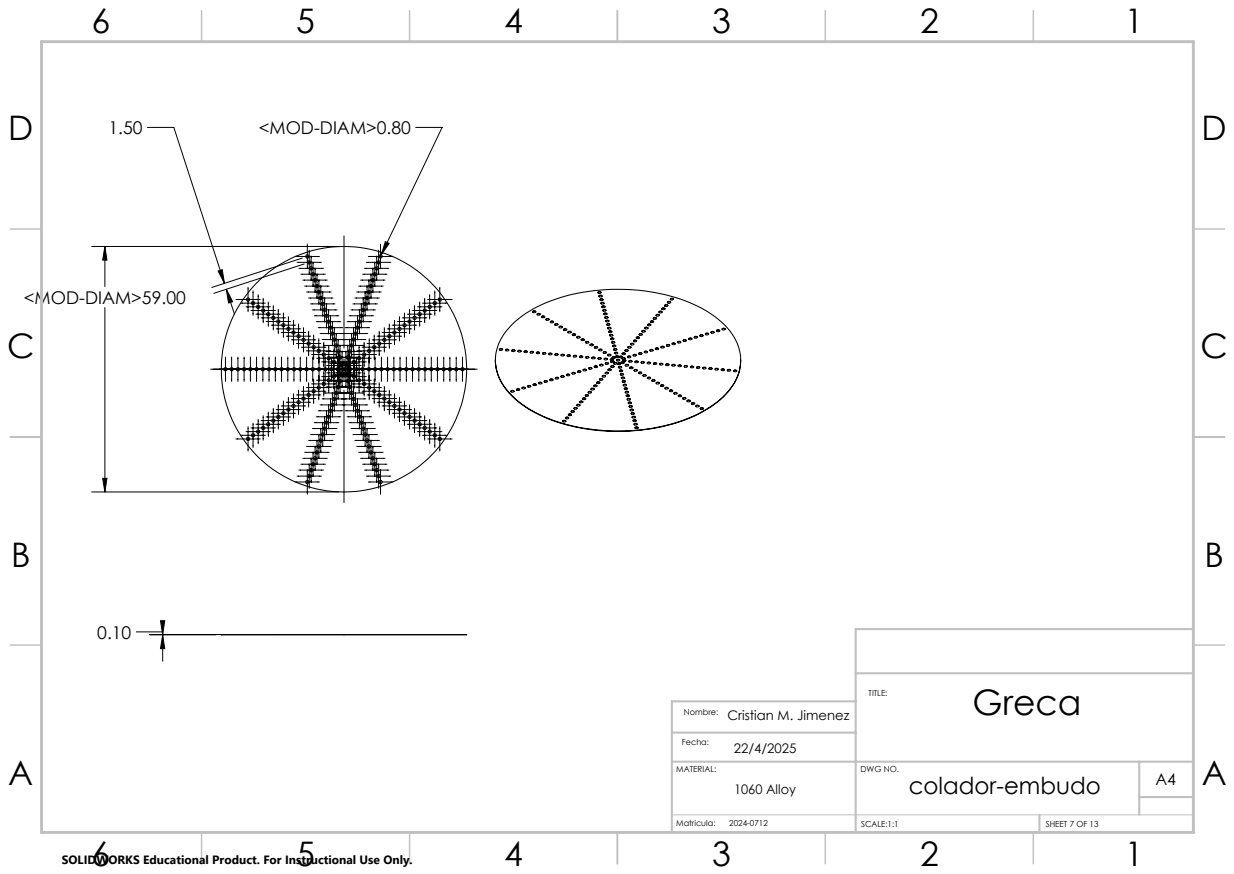
[picture p397: page 7]
DWG NO.; SCALE:1:1; SHEET 7 OF 13; 1060 Alloy; Greca TITLE:; Cristian M. Jimenez

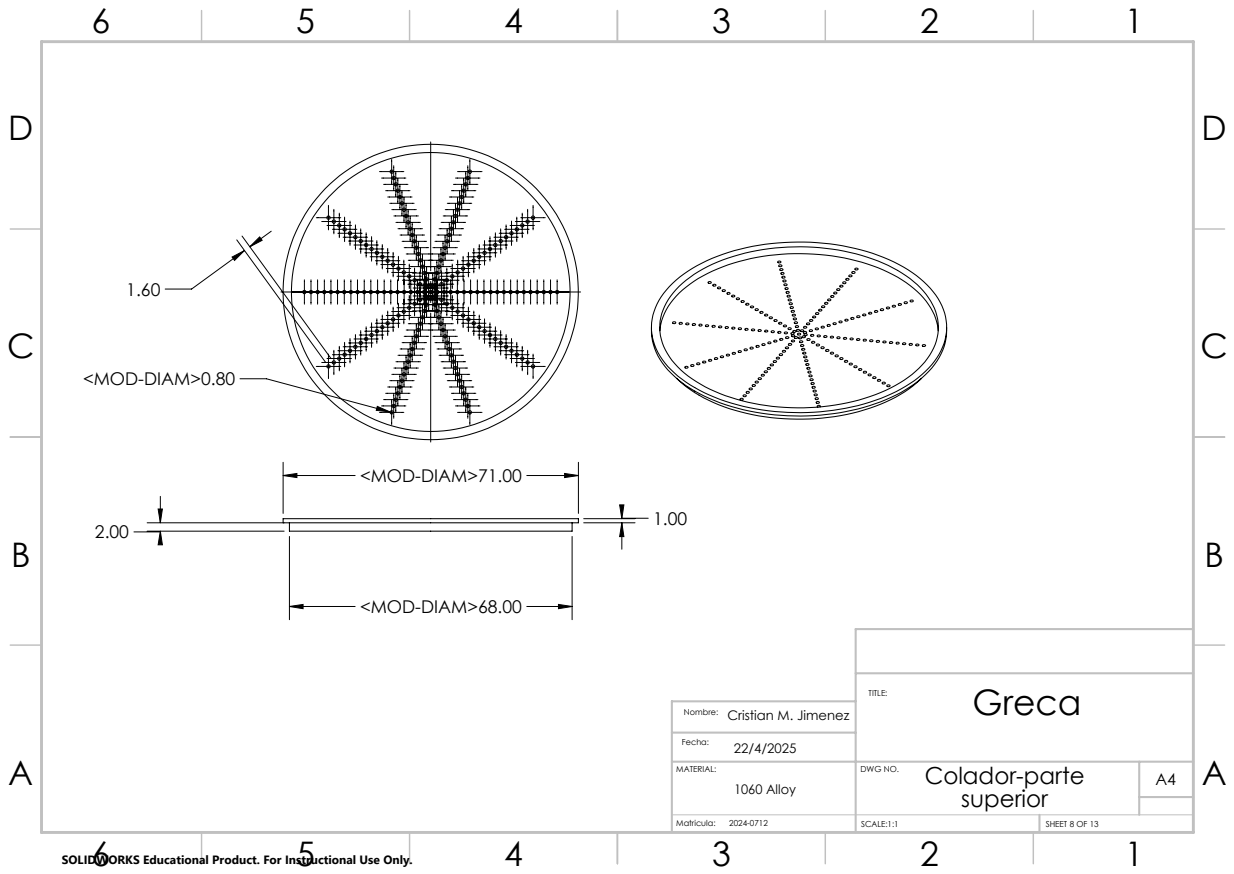
[picture p398: page 8]
DWG NO.; SCALE:1:1; SHEET 8 OF 13; 1060 Alloy; Greca TITLE:; Cristian M. Jimenez

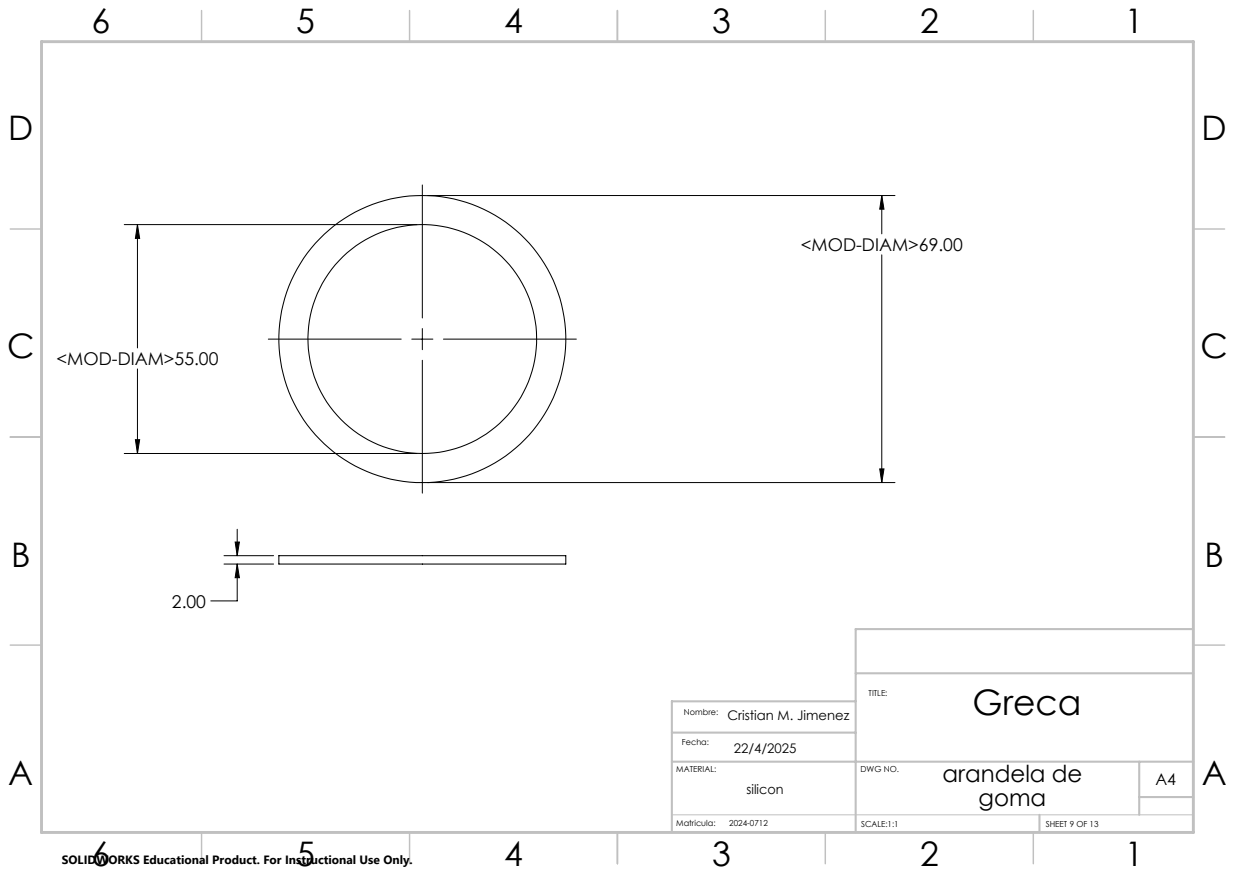
[picture p399: page 9]
Greca TITLE:; Cristian M. Jimenez

MATERIAL: | arandela de DWG NO. goma | A4 silicon

SCALE:1:1 | SHEET 9 OF 13

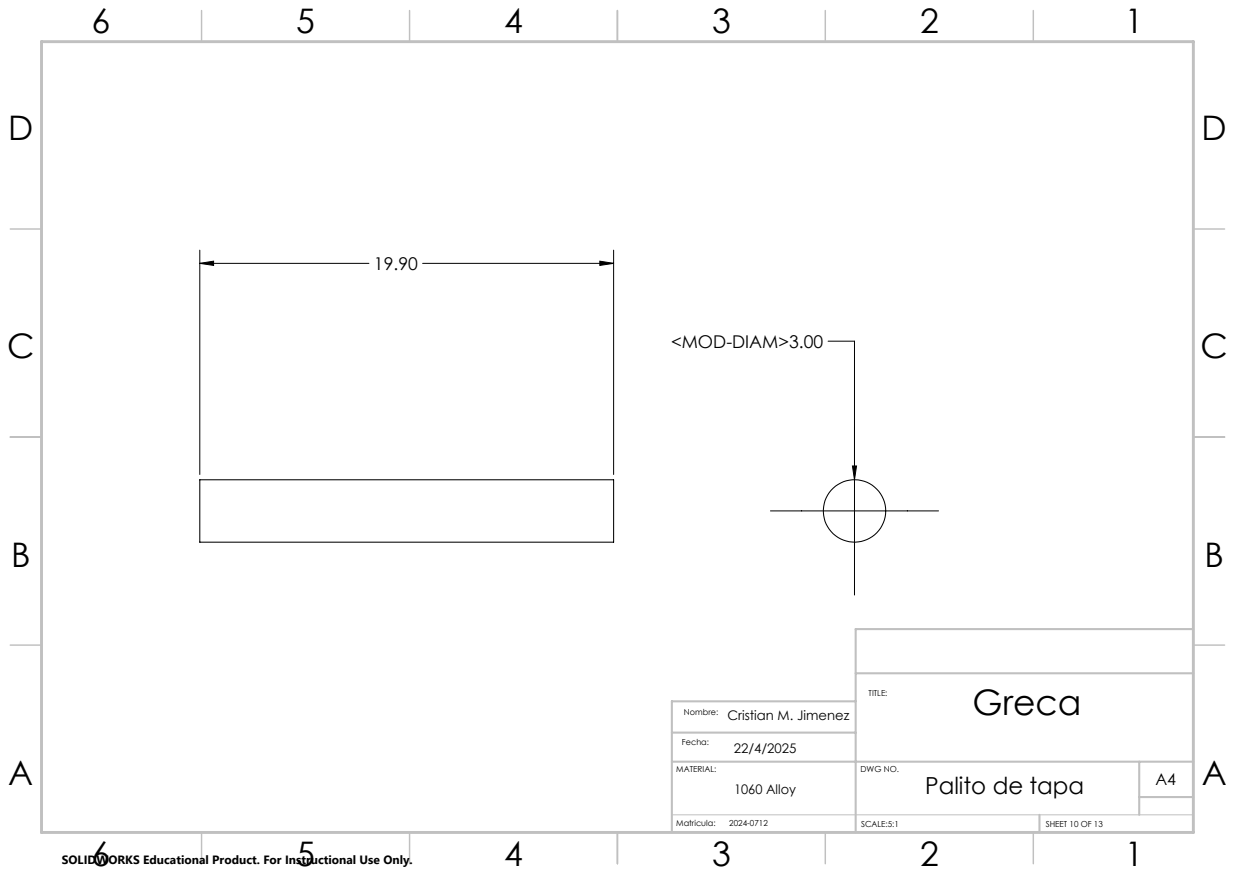
[picture p400: page 10]
SCALE:5:1; SHEET 10 OF 13; 1060 Alloy; Greca TITLE:; Cristian M. Jimenez

DWG NO.
Palito de tapa

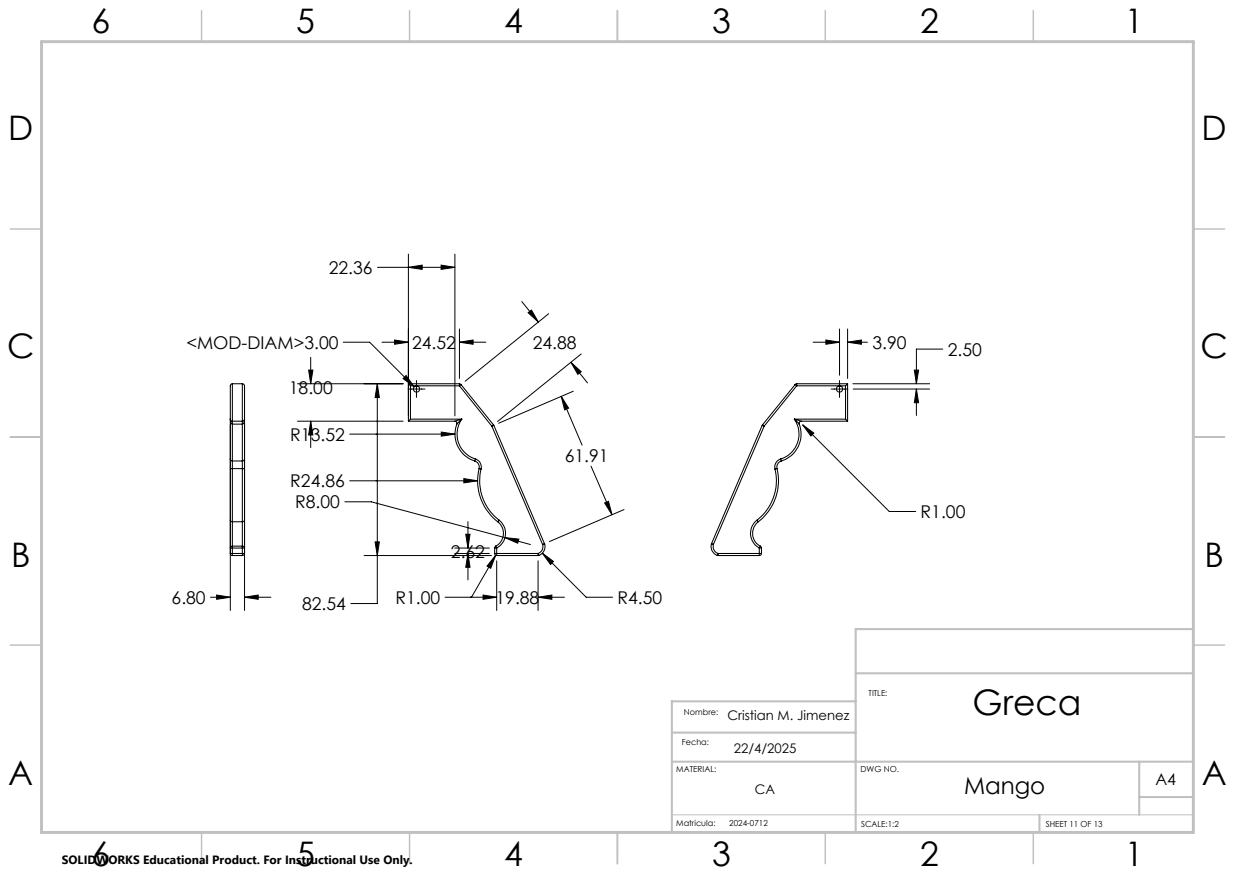
[picture p401: page 11]
<MOD-DIAM>3.00; DWG NO.; SCALE:1:2; SHEET 11 OF 13; Greca TITLE:; Cristian M. Jimenez

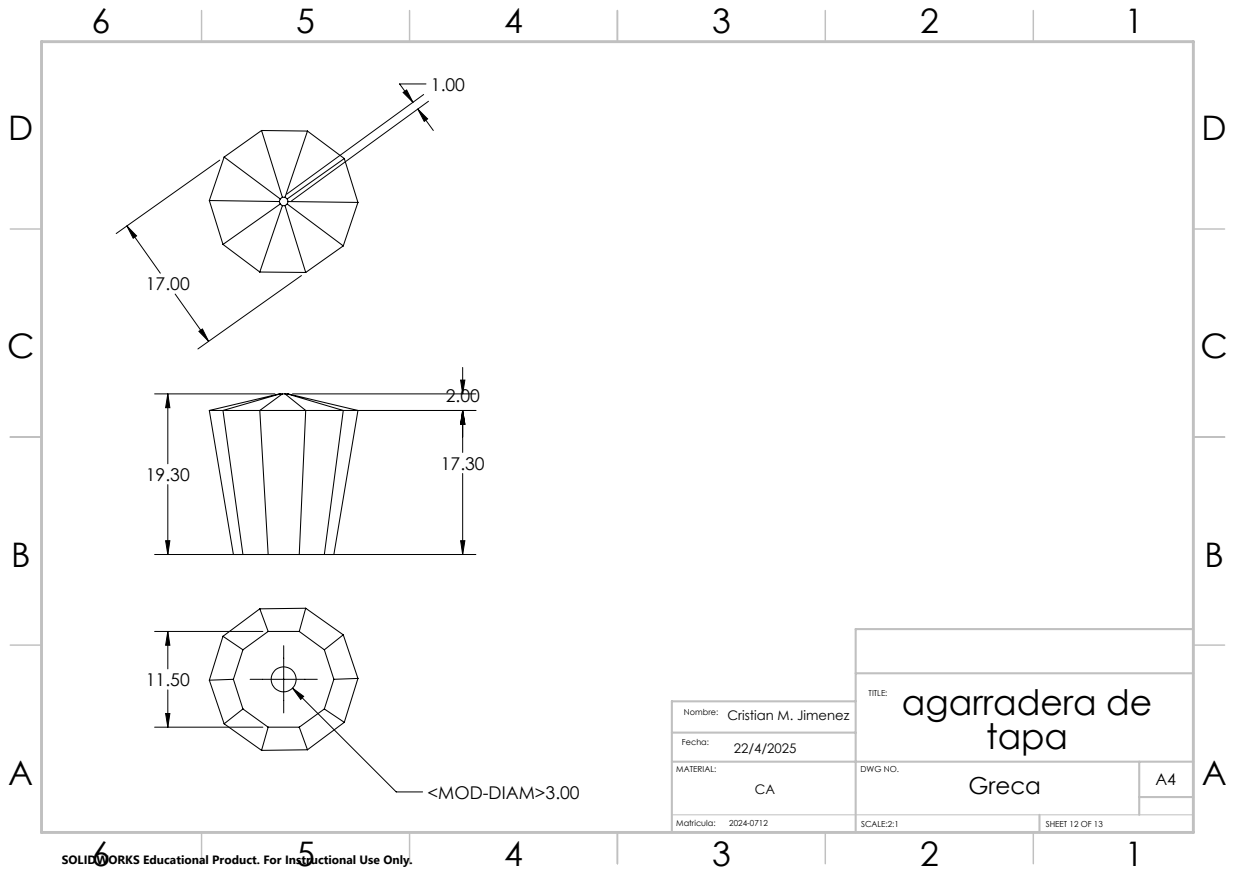
[picture p402: page 12]
DWG NO.; SCALE:2:1; SHEET 12 OF 13; agarradera de; Cristian M. Jimenez

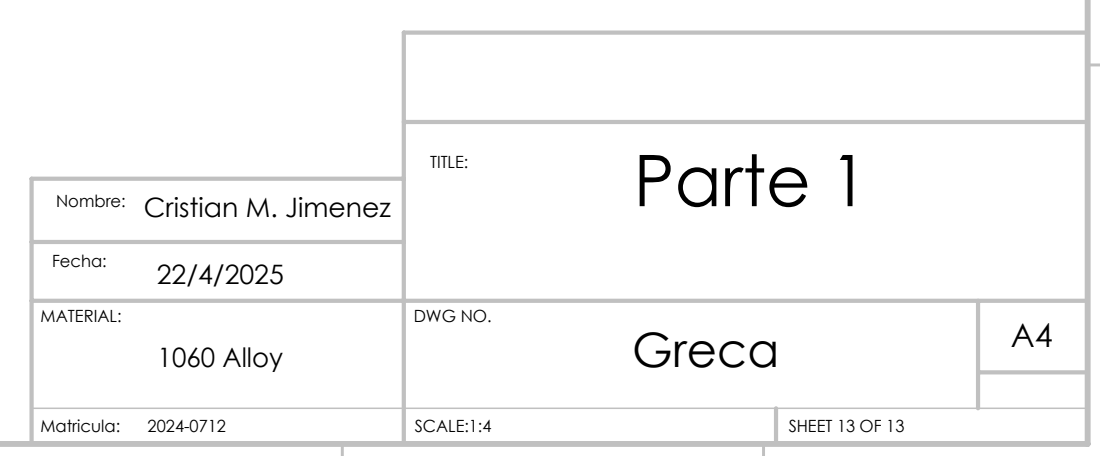
[picture p403: page 13]
DWG NO.; SCALE:1:4; SHEET 13 OF 13; 1060 Alloy; Parte 1 TITLE:; Cristian M. Jimenez
