mk2442/Itla/digital/proyectos/a2/a2.pdf

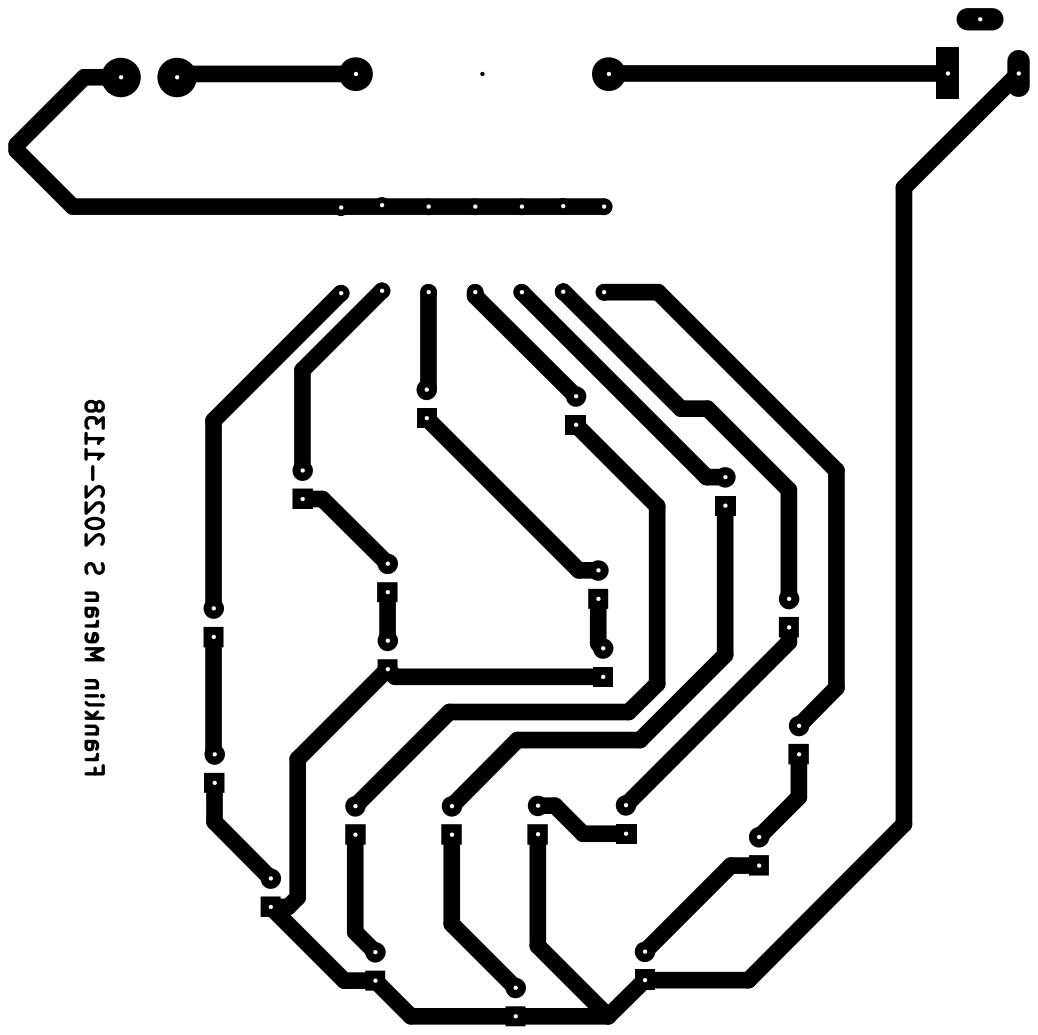
[picture p404: page 1]
