mk2442/Itla/(list of files, drawings)

Other design files:
digital/proyectos/electronica-ii/Electronica II/circuitos/amplificador de audio.ms14
digital/proyectos/electronica-ii/Electronica II/circuitos/amplificador.ms14
digital/proyectos/electronica-ii/Electronica II/circuitos/circuito de enclavamiento.ms14
digital/proyectos/electronica-ii/Electronica II/circuitos/circuito de enclavamiento.pdsprj
digital/proyectos/electronica-ii/Electronica II/circuitos/detector de luz juego de leds.pdsprj
digital/proyectos/electronica-ii/Electronica II/circuitos/el circuito ese del 4017 y el ldr.pdsprj
digital/proyectos/electronica-ii/Electronica II/circuitos/Inversor.pdsprj
digital/proyectos/electronica-ii/Electronica II/circuitos/Multivibrador con transistores.pdsprj
digital/proyectos/electronica-ii/Electronica II/circuitos/niveles de agua 2.pdsprj
digital/proyectos/electronica-ii/Electronica II/circuitos/otro circuito de enclavamiento.ms14
digital/proyectos/electronica-ii/Electronica II/circuitos/Project Backups/detector de luz juego de leds [20250605, 16-25-50].pdsprj
digital/proyectos/electronica-ii/Electronica II/circuitos/Project Backups/Inversor [20250707, 23-51-33].pdsprj
digital/proyectos/electronica-ii/Electronica II/circuitos/Project Backups/Multivibrador con transistores [20250601, 15-04-30].pdsprj
digital/proyectos/electronica-ii/Electronica II/circuitos/Project Backups/Multivibrador con transistores [20250601, 15-12-53].pdsprj
digital/proyectos/electronica-ii/Electronica II/circuitos/Project Backups/Multivibrador con transistores [20250601, 20-01-48].pdsprj
digital/proyectos/electronica-ii/Electronica II/circuitos/Project Backups/Multivibrador con transistores [20250603, 21-35-07].pdsprj
digital/proyectos/electronica-ii/Electronica II/circuitos/Project Backups/Multivibrador con transistores [20250603, 21-35-08].pdsprj
digital/proyectos/electronica-ii/Electronica II/circuitos/Project Backups/PWM [20250707, 22-20-44].pdsprj
digital/proyectos/electronica-ii/Electronica II/circuitos/PWM.pdsprj
digital/proyectos/electronica-ii/Electronica II/circuitos/semaforo.ms14
digital/proyectos/electronica-ii/Electronica II/circuitos/semaforo.pdsprj
digital/proyectos/electronica-ii/Electronica II/circuitos/sensor con 2 ldr.ms14
digital/proyectos/electronica-ii/Electronica II/circuitos/touch que sirve.ms14
digital/proyectos/electronica-ii/Electronica II/circuitos/touch.pdsprj
digital/proyectos/electronica-ii/Electronica II/Project Backups/circuito de enclavamiento [20250524, 15-38-27].pdsprj
digital/proyectos/electronica-ii/Electronica II/Project Backups/semaforo [20250525, 21-49-58].pdsprj
digital/proyectos/electronica-ii/Electronica II/Project Backups/semaforo [20250526, 19-54-46].pdsprj
digital/proyectos/electronica-ii/Electronica II/Project Backups/touch [20250526, 20-25-20].pdsprj
