mk2442/Itla/digital/proyectos/rc-kakata-control/RC-KAKATA-CONTROL.kicad_pcb

## KiCad design digital/proyectos/rc-kakata-control/RC-KAKATA-CONTROL.kicad_pcb (2026-11-01)

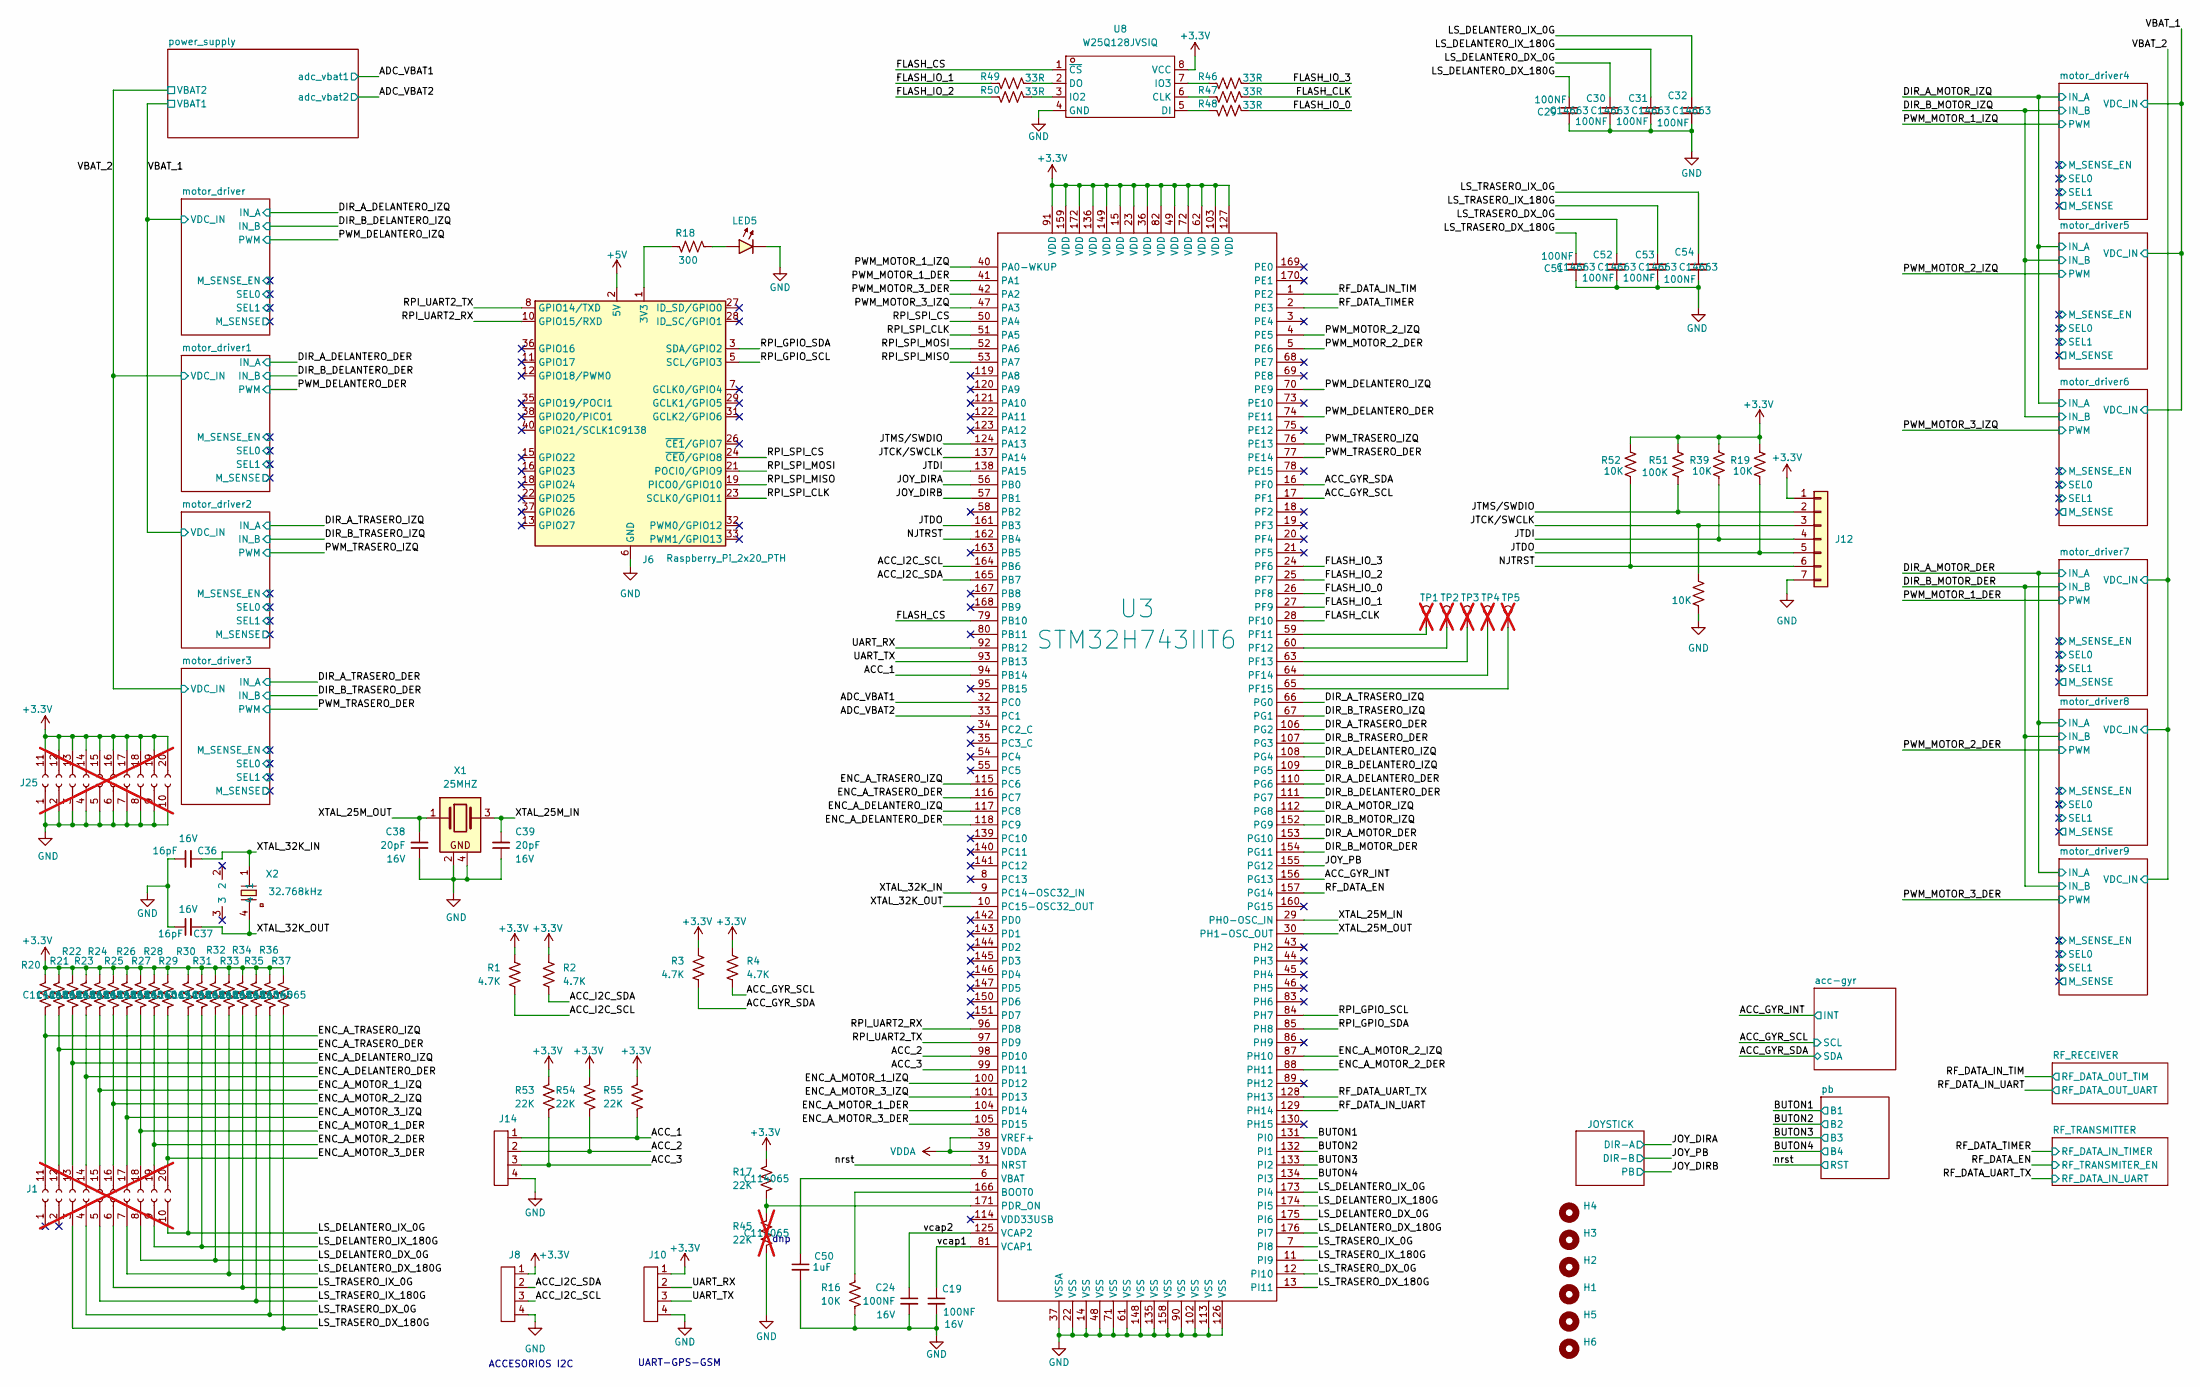
[picture p405: schematic RC-KAKATA-CONTROL.kicad_sch]

Parts:
C19, C24, C29, C30, C31, C32, C51, C52, C53, C54: 100NF; C_0603; Part Number 0603YC104KAT2A; JLCPCB ID C14663
C36, C37: 16pF; C_0603; Part Number 0603YC104KAT2A; JLCPCB ID C14663
C38, C39: 20pF; C_0603; Part Number 0603YC104KAT2A; JLCPCB ID C14663
C50: 1uF; C_0603; Part Number 0603YC104KAT2A; JLCPCB ID C14663
H1, H2, H3, H4, H5, H6: MountingHole; MountingHole_3.2mm_M3
J1, J25: Conn_02x20_Socket_DG250T-5.0-20P; DG250T-5.0-20P; not fitted
J6: Raspberry_Pi_2x20_PTH; 2x20_Shrouded; LCSC Part C9138
J8, J10, J14: DB125-2.54-4P-GN; CONN-TH_DB125-2.54-4P-GN; LCSC Part C918122
J12: Conn_01x07; PinHeader_1x07_P2.54mm_Vertical; LCSC Part C6332200
LED5: LED_0603_Red; LED_0603_1608Metric; LCSC Part C965799
R1, R2, R3, R4: 4.7K; R_0603; Part Number RC0603FR-0710KL; LCSC Part C99782
R16, R19, R38, R39, R52: 10K; R_0603; Part Number RC0603FR-0710KL; LCSC Part C98220
R17, R20, R21, R22, R23, R24, R25, R26, R27, R28, R29, R30, R31, R32, R33, R34, R35, R36, R37, R53, R54, R55: 22K; R_0603; Part Number RC0603FR-0710KL; LCSC Part C114065
R18: 300; R_0603; Part Number RC0603FR-0710KL; LCSC Part C114617
R45: 22K; R_0603; Part Number RC0603FR-0710KL; LCSC Part C114065; not fitted
R46, R47, R48, R49, R50: 33R; R_0603; Part Number RC0603FR-0710KL; LCSC Part C108661
R51: 100K; R_0603; Part Number RC0603FR-0710KL; LCSC Part C14675
TP1, TP2, TP3, TP4, TP5: TestPoint_Hole1; TestPoint_WireHole; not fitted
U3: STM32H743IIT6; LQFP-176_L24.0-W24.0-P0.50-LS26.0-BL; LCSC Part C89597
U8: W25Q128JVSIQ; SOIC-8_L5.3-W5.3-P1.27-LS8.0-BL; LCSC Part C97521
X1: 25MHZ; Crystal_SMD_3225-4Pin_3.2x2.5mm; PART_NUMBER XL2EL89CSI-111YLC-25M; LCSC Part C5280577
X2: 32.768kHz; MC-306_4P-L8.0-W3.2-P5.5-BL; PART_NUMBER Q13MC30610003; LCSC Part C16320

Connections:
+3.3V: J8.1, J10.1, J12.1, J25.11 (Pin_1), J25.12 (Pin_2), J25.13 (Pin_3), J25.14 (Pin_4), J25.15 (Pin_5), J25.16 (Pin_6), J25.17 (Pin_7), J25.18 (Pin_8), J25.19 (Pin_9), J25.20 (Pin_10), R1.1, R2.1, R3.1, R4.1, R17.1, R19.1, R20.1, R21.1, R22.1, R23.1, R24.1, R25.1, R26.1, R27.1, R28.1, R29.1, R30.1, R31.1, R32.1, R33.1, R34.1, R35.1, R36.1, R37.1, R39.1, R51.1, R52.1, R53.1, R54.1, R55.1, U3.15 (VDD), U3.23 (VDD), U3.36 (VDD), U3.49 (VDD), U3.62 (VDD), U3.72 (VDD), U3.82 (VDD), U3.91 (VDD), U3.103 (VDD), U3.127 (VDD), U3.136 (VDD), U3.149 (VDD), U3.159 (VDD), U3.172 (VDD), U8.8 (VCC); also elsewhere on the board
+5V: J6.2 (5V), J6.4 (5V); also elsewhere on the board
/ACC_1: J14.1, R55.2, U3.94 (PB14)
/ACC_2: J14.2, R54.2, U3.98 (PD10)
/ACC_3: J14.3, R53.2, U3.99 (PD11)
/ACC_GYR_INT: U3.156 (PG13); also elsewhere on the board
/ACC_GYR_SCL: R4.2, U3.17 (PF1); also elsewhere on the board
/ACC_GYR_SDA: R3.2, U3.16 (PF0); also elsewhere on the board
/ACC_I2C_SCL: J8.3, R1.2, U3.164 (PB6)
/ACC_I2C_SDA: J8.2, R2.2, U3.165 (PB7)
/ADC_VBAT1: U3.32 (PC0); also elsewhere on the board
/ADC_VBAT2: U3.33 (PC1); also elsewhere on the board
/BUTON1: U3.131 (PI0); also elsewhere on the board
/BUTON2: U3.132 (PI1); also elsewhere on the board
/BUTON3: U3.133 (PI2); also elsewhere on the board
/BUTON4: U3.134 (PI3); also elsewhere on the board
/DIR_A_DELANTERO_DER: U3.110 (PG6); also elsewhere on the board
/DIR_A_DELANTERO_IZQ: U3.108 (PG4); also elsewhere on the board
/DIR_A_MOTOR_DER: U3.153 (PG10); also elsewhere on the board
/DIR_A_MOTOR_IZQ: U3.112 (PG8); also elsewhere on the board
/DIR_A_TRASERO_DER: U3.106 (PG2); also elsewhere on the board
/DIR_A_TRASERO_IZQ: U3.66 (PG0); also elsewhere on the board
/DIR_B_DELANTERO_DER: U3.111 (PG7); also elsewhere on the board
/DIR_B_DELANTERO_IZQ: U3.109 (PG5); also elsewhere on the board
/DIR_B_MOTOR_DER: U3.154 (PG11); also elsewhere on the board
/DIR_B_MOTOR_IZQ: U3.152 (PG9); also elsewhere on the board
/DIR_B_TRASERO_DER: U3.107 (PG3); also elsewhere on the board
/DIR_B_TRASERO_IZQ: U3.67 (PG1); also elsewhere on the board
/ENC_A_DELANTERO_DER: J1.14 (Pin_4), R23.2, U3.118 (PC9)
/ENC_A_DELANTERO_IZQ: J1.13 (Pin_3), R22.2, U3.117 (PC8)
/ENC_A_MOTOR_1_DER: J1.18 (Pin_8), R27.2, U3.104 (PD14)
/ENC_A_MOTOR_1_IZQ: J1.15 (Pin_5), R24.2, U3.100 (PD12)
/ENC_A_MOTOR_2_DER: J1.19 (Pin_9), R28.2, U3.88 (PH11)
/ENC_A_MOTOR_2_IZQ: J1.16 (Pin_6), R25.2, U3.87 (PH10)
/ENC_A_MOTOR_3_DER: J1.20 (Pin_10), R29.2, U3.105 (PD15)
/ENC_A_MOTOR_3_IZQ: J1.17 (Pin_7), R26.2, U3.101 (PD13)
/ENC_A_TRASERO_DER: J1.12 (Pin_2), R21.2, U3.116 (PC7)
/ENC_A_TRASERO_IZQ: J1.11 (Pin_1), R20.2, U3.115 (PC6)
/FLASH_CLK: R47.2, U3.28 (PF10)
/FLASH_CS: U3.79 (PB10), U8.1 (~CS)
/FLASH_IO_0: R48.2, U3.26 (PF8)
/FLASH_IO_1: R49.1, U3.27 (PF9)
/FLASH_IO_2: R50.1, U3.25 (PF7)
/FLASH_IO_3: R46.2, U3.24 (PF6)
/JOY_DIRA: U3.56 (PB0); also elsewhere on the board
/JOY_DIRB: U3.57 (PB1); also elsewhere on the board
/JOY_PB: U3.155 (PG12); also elsewhere on the board
/JTCK/SWCLK: J12.3, R38.1, U3.137 (PA14)
/JTDI: J12.4, R39.2, U3.138 (PA15)
/JTDO: J12.5, R19.2, U3.161 (PB3)
/JTMS/SWDIO: J12.2, R51.2, U3.124 (PA13)
/LS_DELANTERO_DX_0G: C30.1, J1.8, R32.2, U3.175 (PI6)
/LS_DELANTERO_DX_180G: C29.1, J1.7, R33.2, U3.176 (PI7)
/LS_DELANTERO_IX_0G: C32.1, J1.10, R30.2, U3.173 (PI4)
/LS_DELANTERO_IX_180G: C31.1, J1.9, R31.2, U3.174 (PI5)
/LS_TRASERO_DX_0G: C52.1, J1.4, R36.2, U3.12 (PI10)
/LS_TRASERO_DX_180G: C51.1, J1.3, R37.2, U3.13 (PI11)
/LS_TRASERO_IX_0G: C54.1, J1.6, R34.2, U3.7 (PI8)
/LS_TRASERO_IX_180G: C53.1, J1.5, R35.2, U3.11 (PI9)
/NJTRST: J12.6, R52.2, U3.162 (PB4)
/PWM_DELANTERO_DER: U3.74 (PE11); also elsewhere on the board
/PWM_DELANTERO_IZQ: U3.70 (PE9); also elsewhere on the board
/PWM_MOTOR_1_DER: U3.41 (PA1); also elsewhere on the board
/PWM_MOTOR_1_IZQ: U3.40 (PA0-WKUP); also elsewhere on the board
/PWM_MOTOR_2_DER: U3.5 (PE6); also elsewhere on the board
/PWM_MOTOR_2_IZQ: U3.4 (PE5); also elsewhere on the board
/PWM_MOTOR_3_DER: U3.42 (PA2); also elsewhere on the board
/PWM_MOTOR_3_IZQ: U3.47 (PA3); also elsewhere on the board
/PWM_TRASERO_DER: U3.77 (PE14); also elsewhere on the board
/PWM_TRASERO_IZQ: U3.76 (PE13); also elsewhere on the board
/RF_DATA_EN: U3.157 (PG14); also elsewhere on the board
/RF_DATA_IN_TIM: U3.1 (PE2); also elsewhere on the board
/RF_DATA_IN_UART: U3.129 (PH14); also elsewhere on the board
/RF_DATA_TIMER: U3.2 (PE3); also elsewhere on the board
/RF_DATA_UART_TX: U3.128 (PH13); also elsewhere on the board
/RPI_GPIO_SCL: J6.5 (SCL/GPIO3), U3.84 (PH7)
/RPI_GPIO_SDA: J6.3 (SDA/GPIO2), U3.85 (PH8)
/RPI_SPI_CLK: J6.23 (SCLK0/GPIO11), U3.51 (PA5)
/RPI_SPI_CS: J6.24 (~CE0/GPIO8), U3.50 (PA4)
/RPI_SPI_MISO: J6.19 (PICO0/GPIO10), U3.53 (PA7)
/RPI_SPI_MOSI: J6.21 (POCI0/GPIO9), U3.52 (PA6)
/RPI_UART2_RX: J6.10 (GPIO15/RXD), U3.96 (PD8)
/RPI_UART2_TX: J6.8 (GPIO14/TXD), U3.97 (PD9)
/UART_RX: J10.2, U3.92 (PB12)
/UART_TX: J10.3, U3.93 (PB13)
/XTAL_25M_IN: C39.2, U3.29 (PH0-OSC_IN), X1.3
/XTAL_25M_OUT: C38.2, U3.30 (PH1-OSC_OUT), X1.1
/XTAL_32K_IN: C36.2, U3.9 (PC14-OSC32_IN), X2.1
/XTAL_32K_OUT: C37.2, U3.10 (PC15-OSC32_OUT), X2.4
/nrst: U3.31 (NRST); also elsewhere on the board
/vcap1: C19.1, U3.81 (VCAP1)
/vcap2: C24.1, U3.125 (VCAP2)
GND: C19.2, C24.2, C29.2, C30.2, C31.2, C32.2, C36.1, C37.1, C38.1, C39.1, C50.2, C51.2, C52.2, C53.2, C54.2, J6.6 (GND), J6.9 (GND), J6.14 (GND), J6.20 (GND), J6.25 (GND), J6.30 (GND), J6.34 (GND), J6.39 (GND), J8.4, J10.4, J12.7, J14.4, J25.1, J25.2, J25.3, J25.4, J25.5, J25.6, J25.7, J25.8, J25.9, J25.10, LED5.1 (K), R16.2, R38.2, R45.2, U3.14 (VSS), U3.22 (VSS), U3.37 (VSSA), U3.48 (VSS), U3.61 (VSS), U3.71 (VSS), U3.90 (VSS), U3.102 (VSS), U3.113 (VSS), U3.126 (VSS), U3.135 (VSS), U3.148 (VSS), U3.158 (VSS), U8.4 (GND), X1.2, X1.4; also elsewhere on the board
unnamed: J6.1 (3V3), J6.17 (3V3), R18.1
unnamed: LED5.2 (A), R18.2
unnamed: R16.1, U3.166 (BOOT0)
unnamed: R17.2, R45.1, U3.171 (PDR_ON)
unnamed: TP1.1, U3.59 (PF11)
unnamed: TP2.1, U3.60 (PF12)
unnamed: TP3.1, U3.63 (PF13)
unnamed: TP4.1, U3.64 (PF14)
unnamed: TP5.1, U3.65 (PF15)
unnamed: C50.1, U3.6 (VBAT)
unnamed: R47.1, U8.6 (CLK)
unnamed: R48.1, U8.5 (DI)
unnamed: R49.2, U8.2 (DO)
unnamed: R50.2, U8.3 (IO2)
unnamed: R46.1, U8.7 (IO3)
VDDA: U3.38 (VREF+), U3.39 (VDDA); also elsewhere on the board

Notes on the sheet:
UART-GPS-GSM
ACCESORIOS I2C
dnp

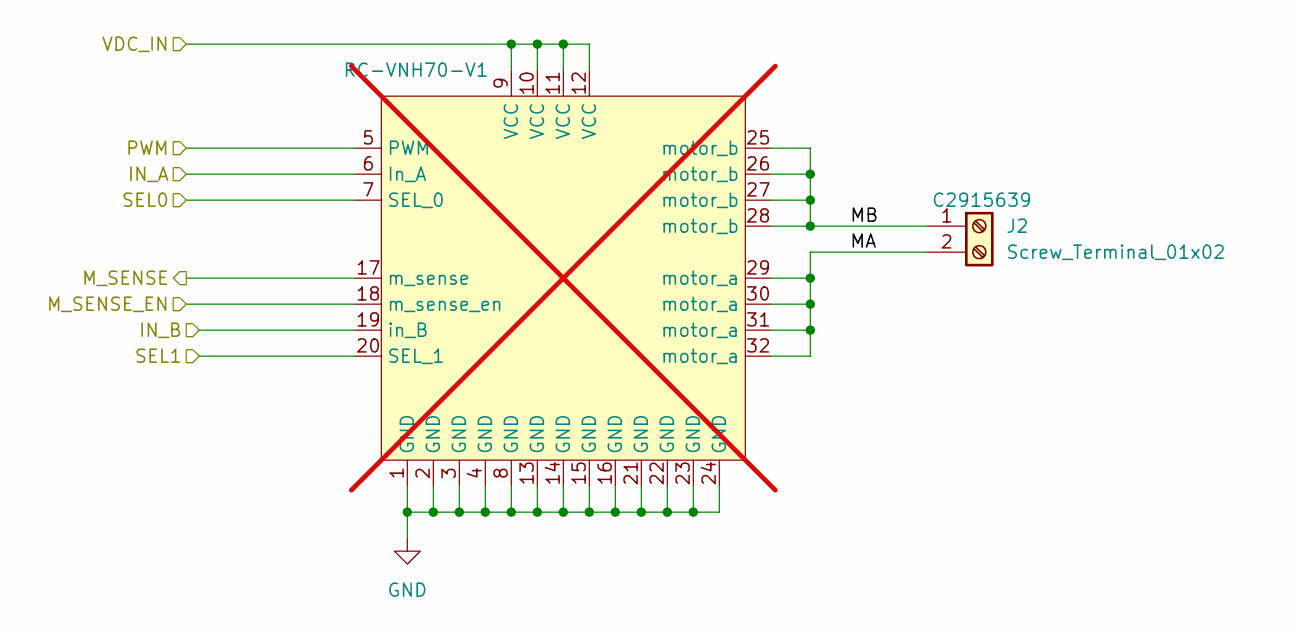
[picture p406: schematic motor_driver.kicad_sch, RC-KAKATA-CONTROL]

Parts:
J2: Screw_Terminal_01x02; CONN-TH_2P-P5.08_DIBO_DB128V-5.08; LCSC PN C2915639
RC-VNH70-V1: RC-VNH70-V1; not fitted

Connections:
/DIR_A_DELANTERO_IZQ: RC-VNH70-V1.6 (In_A); also elsewhere on the board
/DIR_B_DELANTERO_IZQ: RC-VNH70-V1.19 (in_B); also elsewhere on the board
/PWM_DELANTERO_IZQ: RC-VNH70-V1.5 (PWM); also elsewhere on the board
/VBAT_1: RC-VNH70-V1.9 (VCC), RC-VNH70-V1.10 (VCC), RC-VNH70-V1.11 (VCC), RC-VNH70-V1.12 (VCC); also elsewhere on the board
/motor_driver/MA: J2.2, RC-VNH70-V1.29 (motor_a), RC-VNH70-V1.30 (motor_a), RC-VNH70-V1.31 (motor_a), RC-VNH70-V1.32 (motor_a)
/motor_driver/MB: J2.1, RC-VNH70-V1.25 (motor_b), RC-VNH70-V1.26 (motor_b), RC-VNH70-V1.27 (motor_b), RC-VNH70-V1.28 (motor_b)
/motor_driver/M_SENSE: RC-VNH70-V1.17 (m_sense)
/motor_driver/M_SENSE_EN: RC-VNH70-V1.18 (m_sense_en)
/motor_driver/SEL0: RC-VNH70-V1.7 (SEL_0)
/motor_driver/SEL1: RC-VNH70-V1.20 (SEL_1)
GND: RC-VNH70-V1.1 (GND), RC-VNH70-V1.2 (GND), RC-VNH70-V1.3 (GND), RC-VNH70-V1.4 (GND), RC-VNH70-V1.8 (GND), RC-VNH70-V1.13 (GND), RC-VNH70-V1.14 (GND), RC-VNH70-V1.15 (GND), RC-VNH70-V1.16 (GND), RC-VNH70-V1.21 (GND), RC-VNH70-V1.22 (GND), RC-VNH70-V1.23 (GND), RC-VNH70-V1.24 (GND); also elsewhere on the board

Parts of its further copies:
J5, J7, J9, J11, J13, J17, J19, J21, J23: Screw_Terminal_01x02; CONN-TH_2P-P5.08_DIBO_DB128V-5.08; LCSC PN C2915639
RC-VNH70-V2, RC-VNH70-V3, RC-VNH70-V4, RC-VNH70-V5, RC-VNH70-V6, RC-VNH70-V7, RC-VNH70-V8, RC-VNH70-V9, RC-VNH70-V10: RC-VNH70-V1; not fitted

Connections of its further copies:
/DIR_A_DELANTERO_DER: RC-VNH70-V2.6 (In_A); also elsewhere on the board
/DIR_A_MOTOR_DER: RC-VNH70-V8.6 (In_A), RC-VNH70-V9.6 (In_A), RC-VNH70-V10.6 (In_A); also elsewhere on the board
/DIR_A_MOTOR_IZQ: RC-VNH70-V5.6 (In_A), RC-VNH70-V6.6 (In_A), RC-VNH70-V7.6 (In_A); also elsewhere on the board
/DIR_A_TRASERO_DER: RC-VNH70-V4.6 (In_A); also elsewhere on the board
/DIR_A_TRASERO_IZQ: RC-VNH70-V3.6 (In_A); also elsewhere on the board
/DIR_B_DELANTERO_DER: RC-VNH70-V2.19 (in_B); also elsewhere on the board
/DIR_B_MOTOR_DER: RC-VNH70-V8.19 (in_B), RC-VNH70-V9.19 (in_B), RC-VNH70-V10.19 (in_B); also elsewhere on the board
/DIR_B_MOTOR_IZQ: RC-VNH70-V5.19 (in_B), RC-VNH70-V6.19 (in_B), RC-VNH70-V7.19 (in_B); also elsewhere on the board
/DIR_B_TRASERO_DER: RC-VNH70-V4.19 (in_B); also elsewhere on the board
/DIR_B_TRASERO_IZQ: RC-VNH70-V3.19 (in_B); also elsewhere on the board
/PWM_DELANTERO_DER: RC-VNH70-V2.5 (PWM); also elsewhere on the board
/PWM_MOTOR_1_DER: RC-VNH70-V8.5 (PWM); also elsewhere on the board
/PWM_MOTOR_1_IZQ: RC-VNH70-V5.5 (PWM); also elsewhere on the board
/PWM_MOTOR_2_DER: RC-VNH70-V9.5 (PWM); also elsewhere on the board
/PWM_MOTOR_2_IZQ: RC-VNH70-V6.5 (PWM); also elsewhere on the board
/PWM_MOTOR_3_DER: RC-VNH70-V10.5 (PWM); also elsewhere on the board
/PWM_MOTOR_3_IZQ: RC-VNH70-V7.5 (PWM); also elsewhere on the board
/PWM_TRASERO_DER: RC-VNH70-V4.5 (PWM); also elsewhere on the board
/PWM_TRASERO_IZQ: RC-VNH70-V3.5 (PWM); also elsewhere on the board
/VBAT_1: RC-VNH70-V3.9 (VCC), RC-VNH70-V3.10 (VCC), RC-VNH70-V3.11 (VCC), RC-VNH70-V3.12 (VCC), RC-VNH70-V5.9 (VCC), RC-VNH70-V5.10 (VCC), RC-VNH70-V5.11 (VCC), RC-VNH70-V5.12 (VCC), RC-VNH70-V6.9 (VCC), RC-VNH70-V6.10 (VCC), RC-VNH70-V6.11 (VCC), RC-VNH70-V6.12 (VCC), RC-VNH70-V7.9 (VCC), RC-VNH70-V7.10 (VCC), RC-VNH70-V7.11 (VCC), RC-VNH70-V7.12 (VCC); also elsewhere on the board
/VBAT_2: RC-VNH70-V2.9 (VCC), RC-VNH70-V2.10 (VCC), RC-VNH70-V2.11 (VCC), RC-VNH70-V2.12 (VCC), RC-VNH70-V4.9 (VCC), RC-VNH70-V4.10 (VCC), RC-VNH70-V4.11 (VCC), RC-VNH70-V4.12 (VCC), RC-VNH70-V8.9 (VCC), RC-VNH70-V8.10 (VCC), RC-VNH70-V8.11 (VCC), RC-VNH70-V8.12 (VCC), RC-VNH70-V9.9 (VCC), RC-VNH70-V9.10 (VCC), RC-VNH70-V9.11 (VCC), RC-VNH70-V9.12 (VCC), RC-VNH70-V10.9 (VCC), RC-VNH70-V10.10 (VCC), RC-VNH70-V10.11 (VCC), RC-VNH70-V10.12 (VCC); also elsewhere on the board
/motor_driver1/MA: J5.2, RC-VNH70-V2.29 (motor_a), RC-VNH70-V2.30 (motor_a), RC-VNH70-V2.31 (motor_a), RC-VNH70-V2.32 (motor_a)
/motor_driver1/MB: J5.1, RC-VNH70-V2.25 (motor_b), RC-VNH70-V2.26 (motor_b), RC-VNH70-V2.27 (motor_b), RC-VNH70-V2.28 (motor_b)
/motor_driver1/M_SENSE: RC-VNH70-V2.17 (m_sense)
/motor_driver1/M_SENSE_EN: RC-VNH70-V2.18 (m_sense_en)
/motor_driver1/SEL0: RC-VNH70-V2.7 (SEL_0)
/motor_driver1/SEL1: RC-VNH70-V2.20 (SEL_1)
/motor_driver2/MA: J7.2, RC-VNH70-V3.29 (motor_a), RC-VNH70-V3.30 (motor_a), RC-VNH70-V3.31 (motor_a), RC-VNH70-V3.32 (motor_a)
/motor_driver2/MB: J7.1, RC-VNH70-V3.25 (motor_b), RC-VNH70-V3.26 (motor_b), RC-VNH70-V3.27 (motor_b), RC-VNH70-V3.28 (motor_b)
/motor_driver2/M_SENSE: RC-VNH70-V3.17 (m_sense)
/motor_driver2/M_SENSE_EN: RC-VNH70-V3.18 (m_sense_en)
/motor_driver2/SEL0: RC-VNH70-V3.7 (SEL_0)
/motor_driver2/SEL1: RC-VNH70-V3.20 (SEL_1)
/motor_driver3/MA: J9.2, RC-VNH70-V4.29 (motor_a), RC-VNH70-V4.30 (motor_a), RC-VNH70-V4.31 (motor_a), RC-VNH70-V4.32 (motor_a)
/motor_driver3/MB: J9.1, RC-VNH70-V4.25 (motor_b), RC-VNH70-V4.26 (motor_b), RC-VNH70-V4.27 (motor_b), RC-VNH70-V4.28 (motor_b)
/motor_driver3/M_SENSE: RC-VNH70-V4.17 (m_sense)
/motor_driver3/M_SENSE_EN: RC-VNH70-V4.18 (m_sense_en)
/motor_driver3/SEL0: RC-VNH70-V4.7 (SEL_0)
/motor_driver3/SEL1: RC-VNH70-V4.20 (SEL_1)
/motor_driver4/MA: J11.2, RC-VNH70-V5.29 (motor_a), RC-VNH70-V5.30 (motor_a), RC-VNH70-V5.31 (motor_a), RC-VNH70-V5.32 (motor_a)
/motor_driver4/MB: J11.1, RC-VNH70-V5.25 (motor_b), RC-VNH70-V5.26 (motor_b), RC-VNH70-V5.27 (motor_b), RC-VNH70-V5.28 (motor_b)
/motor_driver4/M_SENSE: RC-VNH70-V5.17 (m_sense)
/motor_driver4/M_SENSE_EN: RC-VNH70-V5.18 (m_sense_en)
/motor_driver4/SEL0: RC-VNH70-V5.7 (SEL_0)
/motor_driver4/SEL1: RC-VNH70-V5.20 (SEL_1)
/motor_driver5/MA: J13.2, RC-VNH70-V6.29 (motor_a), RC-VNH70-V6.30 (motor_a), RC-VNH70-V6.31 (motor_a), RC-VNH70-V6.32 (motor_a)
/motor_driver5/MB: J13.1, RC-VNH70-V6.25 (motor_b), RC-VNH70-V6.26 (motor_b), RC-VNH70-V6.27 (motor_b), RC-VNH70-V6.28 (motor_b)
/motor_driver5/M_SENSE: RC-VNH70-V6.17 (m_sense)
/motor_driver5/M_SENSE_EN: RC-VNH70-V6.18 (m_sense_en)
/motor_driver5/SEL0: RC-VNH70-V6.7 (SEL_0)
/motor_driver5/SEL1: RC-VNH70-V6.20 (SEL_1)
/motor_driver6/MA: J17.2, RC-VNH70-V7.29 (motor_a), RC-VNH70-V7.30 (motor_a), RC-VNH70-V7.31 (motor_a), RC-VNH70-V7.32 (motor_a)
/motor_driver6/MB: J17.1, RC-VNH70-V7.25 (motor_b), RC-VNH70-V7.26 (motor_b), RC-VNH70-V7.27 (motor_b), RC-VNH70-V7.28 (motor_b)
/motor_driver6/M_SENSE: RC-VNH70-V7.17 (m_sense)
/motor_driver6/M_SENSE_EN: RC-VNH70-V7.18 (m_sense_en)
/motor_driver6/SEL0: RC-VNH70-V7.7 (SEL_0)
/motor_driver6/SEL1: RC-VNH70-V7.20 (SEL_1)
/motor_driver7/MA: J19.2, RC-VNH70-V8.29 (motor_a), RC-VNH70-V8.30 (motor_a), RC-VNH70-V8.31 (motor_a), RC-VNH70-V8.32 (motor_a)
/motor_driver7/MB: J19.1, RC-VNH70-V8.25 (motor_b), RC-VNH70-V8.26 (motor_b), RC-VNH70-V8.27 (motor_b), RC-VNH70-V8.28 (motor_b)
/motor_driver7/M_SENSE: RC-VNH70-V8.17 (m_sense)
/motor_driver7/M_SENSE_EN: RC-VNH70-V8.18 (m_sense_en)
/motor_driver7/SEL0: RC-VNH70-V8.7 (SEL_0)
/motor_driver7/SEL1: RC-VNH70-V8.20 (SEL_1)
/motor_driver8/MA: J21.2, RC-VNH70-V9.29 (motor_a), RC-VNH70-V9.30 (motor_a), RC-VNH70-V9.31 (motor_a), RC-VNH70-V9.32 (motor_a)
/motor_driver8/MB: J21.1, RC-VNH70-V9.25 (motor_b), RC-VNH70-V9.26 (motor_b), RC-VNH70-V9.27 (motor_b), RC-VNH70-V9.28 (motor_b)
/motor_driver8/M_SENSE: RC-VNH70-V9.17 (m_sense)
/motor_driver8/M_SENSE_EN: RC-VNH70-V9.18 (m_sense_en)
/motor_driver8/SEL0: RC-VNH70-V9.7 (SEL_0)
/motor_driver8/SEL1: RC-VNH70-V9.20 (SEL_1)
/motor_driver9/MA: J23.2, RC-VNH70-V10.29 (motor_a), RC-VNH70-V10.30 (motor_a), RC-VNH70-V10.31 (motor_a), RC-VNH70-V10.32 (motor_a)
/motor_driver9/MB: J23.1, RC-VNH70-V10.25 (motor_b), RC-VNH70-V10.26 (motor_b), RC-VNH70-V10.27 (motor_b), RC-VNH70-V10.28 (motor_b)
/motor_driver9/M_SENSE: RC-VNH70-V10.17 (m_sense)
/motor_driver9/M_SENSE_EN: RC-VNH70-V10.18 (m_sense_en)
/motor_driver9/SEL0: RC-VNH70-V10.7 (SEL_0)
/motor_driver9/SEL1: RC-VNH70-V10.20 (SEL_1)
GND: RC-VNH70-V2.1 (GND), RC-VNH70-V2.2 (GND), RC-VNH70-V2.3 (GND), RC-VNH70-V2.4 (GND), RC-VNH70-V2.8 (GND), RC-VNH70-V2.13 (GND), RC-VNH70-V2.14 (GND), RC-VNH70-V2.15 (GND), RC-VNH70-V2.16 (GND), RC-VNH70-V2.21 (GND), RC-VNH70-V2.22 (GND), RC-VNH70-V2.23 (GND), RC-VNH70-V2.24 (GND), RC-VNH70-V3.1 (GND), RC-VNH70-V3.2 (GND), RC-VNH70-V3.3 (GND), RC-VNH70-V3.4 (GND), RC-VNH70-V3.8 (GND), RC-VNH70-V3.13 (GND), RC-VNH70-V3.14 (GND), RC-VNH70-V3.15 (GND), RC-VNH70-V3.16 (GND), RC-VNH70-V3.21 (GND), RC-VNH70-V3.22 (GND), RC-VNH70-V3.23 (GND), RC-VNH70-V3.24 (GND), RC-VNH70-V4.1 (GND), RC-VNH70-V4.2 (GND), RC-VNH70-V4.3 (GND), RC-VNH70-V4.4 (GND), RC-VNH70-V4.8 (GND), RC-VNH70-V4.13 (GND), RC-VNH70-V4.14 (GND), RC-VNH70-V4.15 (GND), RC-VNH70-V4.16 (GND), RC-VNH70-V4.21 (GND), RC-VNH70-V4.22 (GND), RC-VNH70-V4.23 (GND), RC-VNH70-V4.24 (GND), RC-VNH70-V5.1 (GND), RC-VNH70-V5.2 (GND), RC-VNH70-V5.3 (GND), RC-VNH70-V5.4 (GND), RC-VNH70-V5.8 (GND), RC-VNH70-V5.13 (GND), RC-VNH70-V5.14 (GND), RC-VNH70-V5.15 (GND), RC-VNH70-V5.16 (GND), RC-VNH70-V5.21 (GND), RC-VNH70-V5.22 (GND), RC-VNH70-V5.23 (GND), RC-VNH70-V5.24 (GND), RC-VNH70-V6.1 (GND), RC-VNH70-V6.2 (GND), RC-VNH70-V6.3 (GND), RC-VNH70-V6.4 (GND), RC-VNH70-V6.8 (GND), RC-VNH70-V6.13 (GND), RC-VNH70-V6.14 (GND), RC-VNH70-V6.15 (GND), RC-VNH70-V6.16 (GND), RC-VNH70-V6.21 (GND), RC-VNH70-V6.22 (GND), RC-VNH70-V6.23 (GND), RC-VNH70-V6.24 (GND), RC-VNH70-V7.1 (GND), RC-VNH70-V7.2 (GND), RC-VNH70-V7.3 (GND), RC-VNH70-V7.4 (GND), RC-VNH70-V7.8 (GND), RC-VNH70-V7.13 (GND), RC-VNH70-V7.14 (GND), RC-VNH70-V7.15 (GND), RC-VNH70-V7.16 (GND), RC-VNH70-V7.21 (GND), RC-VNH70-V7.22 (GND), RC-VNH70-V7.23 (GND), RC-VNH70-V7.24 (GND), RC-VNH70-V8.1 (GND), RC-VNH70-V8.2 (GND), RC-VNH70-V8.3 (GND), RC-VNH70-V8.4 (GND), RC-VNH70-V8.8 (GND), RC-VNH70-V8.13 (GND), RC-VNH70-V8.14 (GND), RC-VNH70-V8.15 (GND), RC-VNH70-V8.16 (GND), RC-VNH70-V8.21 (GND), RC-VNH70-V8.22 (GND), RC-VNH70-V8.23 (GND), RC-VNH70-V8.24 (GND), RC-VNH70-V9.1 (GND), RC-VNH70-V9.2 (GND), RC-VNH70-V9.3 (GND), RC-VNH70-V9.4 (GND), RC-VNH70-V9.8 (GND), RC-VNH70-V9.13 (GND), RC-VNH70-V9.14 (GND), RC-VNH70-V9.15 (GND), RC-VNH70-V9.16 (GND), RC-VNH70-V9.21 (GND), RC-VNH70-V9.22 (GND), RC-VNH70-V9.23 (GND), RC-VNH70-V9.24 (GND), RC-VNH70-V10.1 (GND), RC-VNH70-V10.2 (GND), RC-VNH70-V10.3 (GND), RC-VNH70-V10.4 (GND), RC-VNH70-V10.8 (GND), RC-VNH70-V10.13 (GND), RC-VNH70-V10.14 (GND), RC-VNH70-V10.15 (GND), RC-VNH70-V10.16 (GND), RC-VNH70-V10.21 (GND), RC-VNH70-V10.22 (GND), RC-VNH70-V10.23 (GND), RC-VNH70-V10.24 (GND); also elsewhere on the board

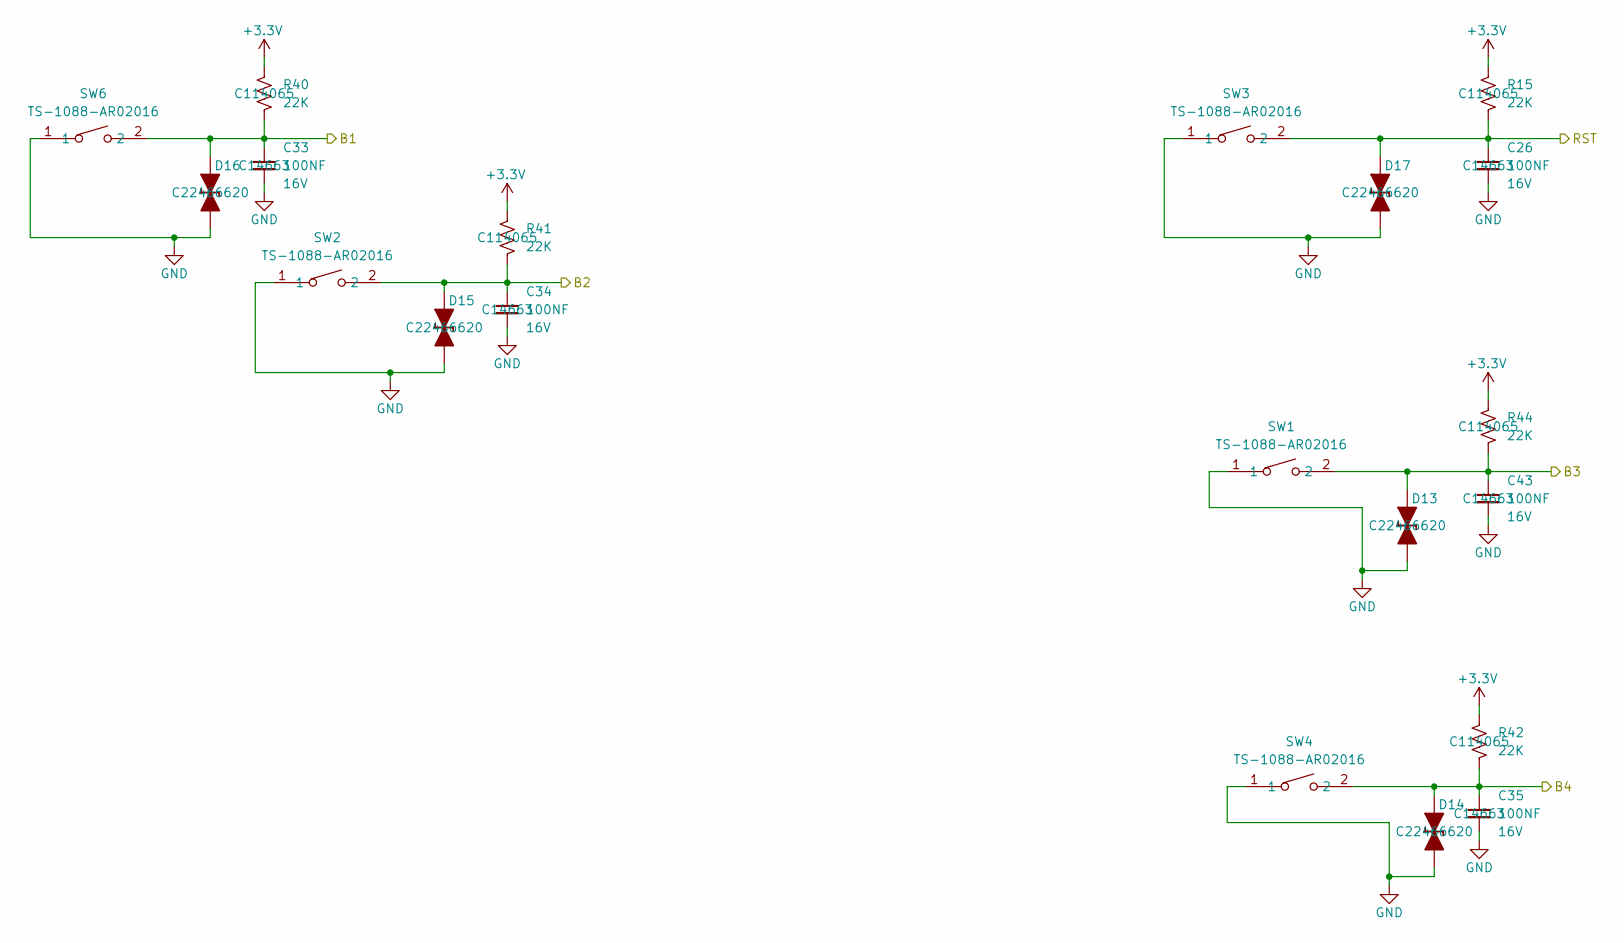
[picture p407: schematic PB.kicad_sch, RC-KAKATA-CONTROL]

Parts:
C26, C33, C34, C35, C43: 100NF; C_0603; Part Number 0603YC104KAT2A; JLCPCB ID C14663
D13, D14, D15, D16, D17: PESD3V3L1BA; D_SOD-323_TVS; LCSC Part C22466620
R15, R40, R41, R42, R44: 22K; R_0603; Part Number RC0603FR-0710KL; LCSC Part C114065
SW1, SW2, SW3, SW4, SW6: TS-1088-AR02016; SW-SMD_L3.9-W3.0-P4.45; LCSC Part C720477

Connections:
+3.3V: R15.1, R40.1, R41.1, R42.1, R44.1; also elsewhere on the board
/BUTON1: C33.1, D16.2 (A), R40.2, SW6.2; also elsewhere on the board
/BUTON2: C34.1, D15.2 (A), R41.2, SW2.2; also elsewhere on the board
/BUTON3: C43.1, D13.2 (A), R44.2, SW1.2; also elsewhere on the board
/BUTON4: C35.1, D14.2 (A), R42.2, SW4.2; also elsewhere on the board
/nrst: C26.1, D17.2 (A), R15.2, SW3.2; also elsewhere on the board
GND: C26.2, C33.2, C34.2, C35.2, C43.2, D13.1 (K), D14.1 (K), D15.1 (K), D16.1 (K), D17.1 (K), SW1.1, SW2.1, SW3.1, SW4.1, SW6.1; also elsewhere on the board

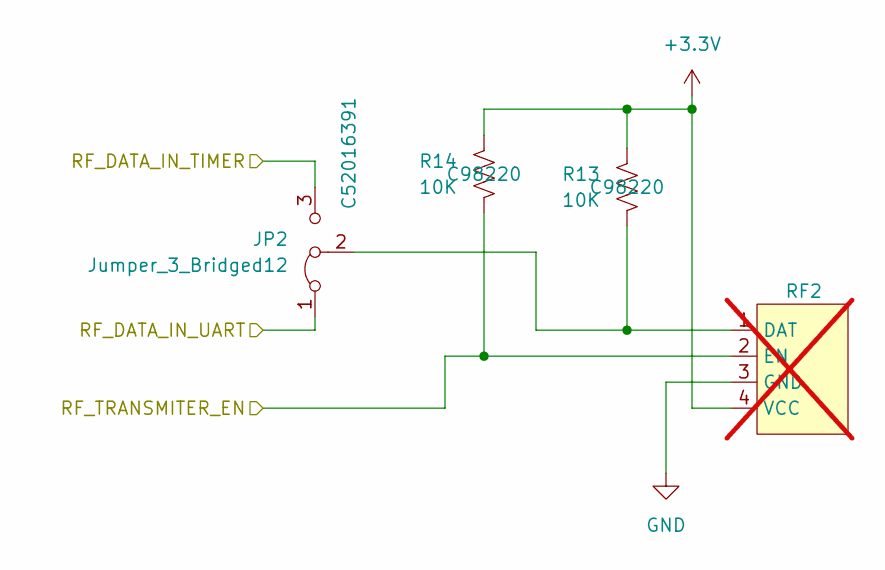
[picture p408: schematic rf_out.kicad_sch, RC-KAKATA-CONTROL]

Parts:
JP2: Jumper_3_Bridged12; PinHeader_1x03_P2.54mm_Vertical; LCSC Part C52016391
R13, R14: 10K; R_0603; Part Number RC0603FR-0710KL; LCSC Part C98220
RF2: Itla_RC_RF_433MHz_transmitter; not fitted

Connections:
+3.3V: R13.1, R14.1, RF2.4 (VCC); also elsewhere on the board
/RF_DATA_EN: R14.2, RF2.2 (EN); also elsewhere on the board
/RF_DATA_TIMER: JP2.3 (B); also elsewhere on the board
/RF_DATA_UART_TX: JP2.1 (A); also elsewhere on the board
GND: RF2.3 (GND); also elsewhere on the board
unnamed: JP2.2 (C), R13.2, RF2.1 (DAT)

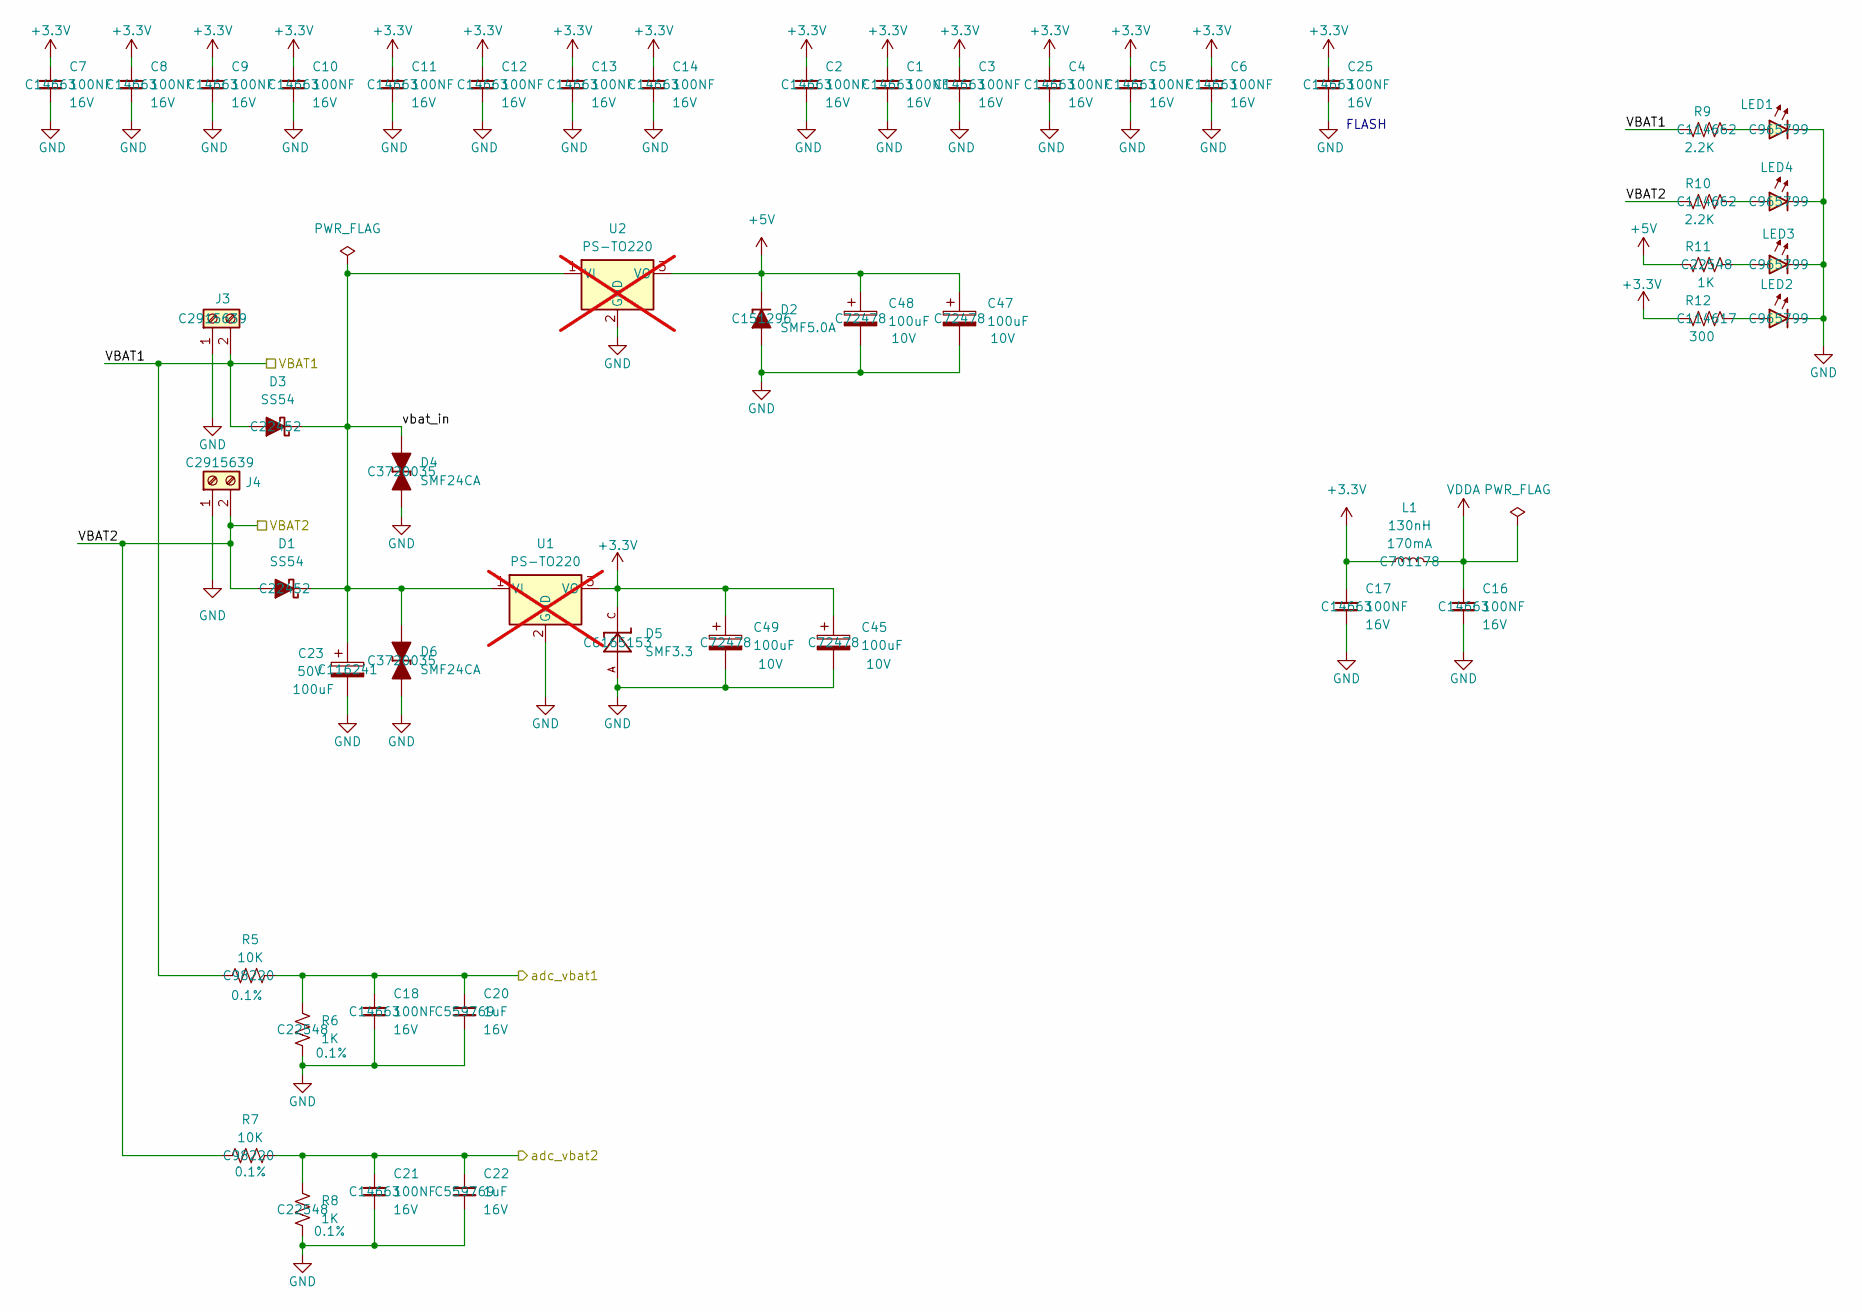
[picture p409: schematic power_supply.kicad_sch, RC-KAKATA-CONTROL]

Parts:
C1, C2, C3, C4, C5, C6, C7, C8, C9, C10, C11, C12, C13, C14, C16, C17, C18, C21, C25: 100NF; C_0603; Part Number 0603YC104KAT2A; JLCPCB ID C14663
C20, C22: 1uF; C_0603; Part Number 0603YC104KAT2A; JLCPCB ID C14663
C23: 100uF; CP_Elec_8x6.2; LCSC Part C116241
C45, C47, C48, C49: 100uF; CP_Elec_6.3x5.9; LCSC Part C72478
D1, D3: SS54; D_SMC; LCSC Part C22452
D2: SMF5.0A; D_SOD-123F; LCSC Part C151296
D4, D6: SMF24CA; D_SOD-123F; LCSC Part C3720035
D5: SMF3.3; SMF3.3_SODFL3718X108N; LCSC Part C6165153
J3, J4: Screw_Terminal_01x02; CONN-TH_2P-P5.08_DIBO_DB128V-5.08; LCSC Part C2915639
L1: 130nH; C_0603_1608Metric; LCSC Part C701178
LED1, LED2, LED3, LED4: LED_0603_Red; LED_0603_1608Metric; LCSC Part C965799
R5, R7: 10K; R_0603; Part Number RC0603FR-0710KL; LCSC Part C98220
R6, R8, R11: 1K; R_0603; Part Number RC0603FR-0710KL; LCSC Part C22548
R9, R10: 2.2K; R_0603; Part Number RC0603FR-0710KL; LCSC Part C114662
R12: 300; R_0603; Part Number RC0603FR-0710KL; LCSC Part C114617
U1, U2: PS-TO220; PS-TO-220-3_Vertical; not fitted

Connections:
+3.3V: C1.1, C2.1, C3.1, C4.1, C5.1, C6.1, C7.1, C8.1, C9.1, C10.1, C11.1, C12.1, C13.1, C14.1, C17.1, C25.1, C45.1, C49.1, D5.C, L1.1, R12.1, U1.3 (VO); also elsewhere on the board
+5V: C47.1, C48.1, D2.1 (K), R11.1, U2.3 (VO); also elsewhere on the board
/ADC_VBAT1: C18.1, C20.1, R5.2, R6.2; also elsewhere on the board
/ADC_VBAT2: C21.1, C22.1, R7.2, R8.2; also elsewhere on the board
/VBAT_1: D3.2 (A), J3.2, R5.1, R9.1; also elsewhere on the board
/VBAT_2: D1.2 (A), J4.2, R7.1, R10.1; also elsewhere on the board
/power_supply/vbat_in: C23.1, D1.1 (K), D3.1 (K), D4.2 (A), D6.2 (A), U1.1 (VI), U2.1 (VI)
GND: C1.2, C2.2, C3.2, C4.2, C5.2, C6.2, C7.2, C8.2, C9.2, C10.2, C11.2, C12.2, C13.2, C14.2, C16.2, C17.2, C18.2, C20.2, C21.2, C22.2, C23.2, C25.2, C45.2, C47.2, C48.2, C49.2, D2.2 (A), D4.1 (K), D5.A, D6.1 (K), J3.1, J4.1, LED1.1 (K), LED2.1 (K), LED3.1 (K), LED4.1 (K), R6.1, R8.1, U1.2 (GND), U2.2 (GND); also elsewhere on the board
unnamed: LED1.2 (A), R9.2
unnamed: LED2.2 (A), R12.2
unnamed: LED3.2 (A), R11.2
unnamed: LED4.2 (A), R10.2
VDDA: C16.1, L1.2; also elsewhere on the board

Notes on the sheet:
FLASH

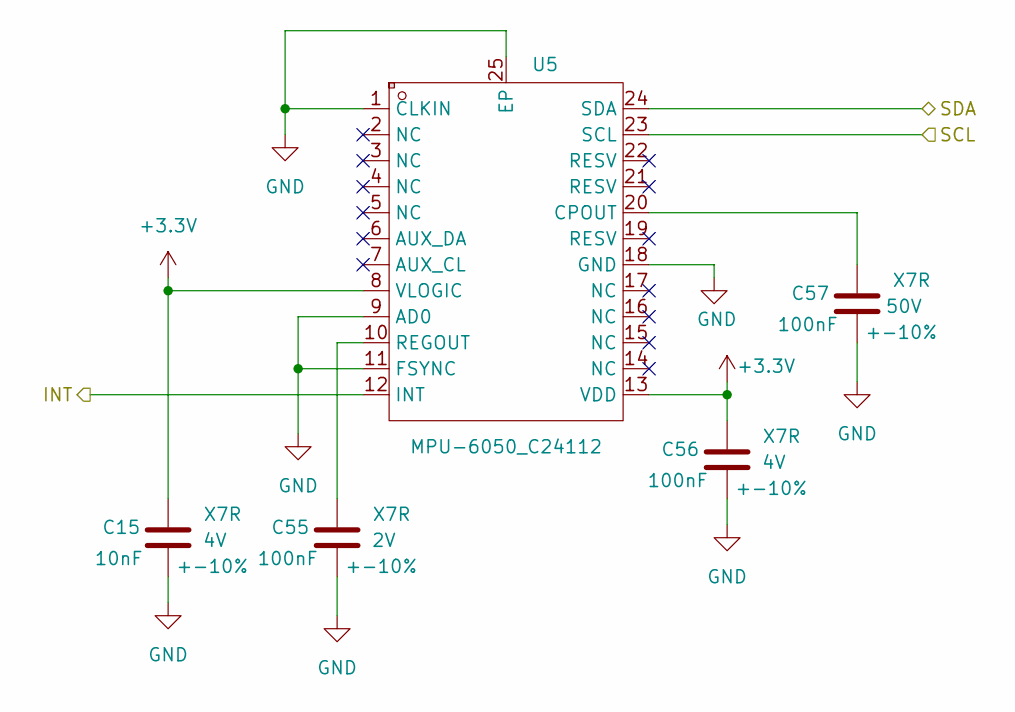
[picture p410: schematic acc-gyr.kicad_sch, RC-KAKATA-CONTROL]

Parts:
C15: 10nF; C_0603_1608Metric; LCSC Part C100042
C55, C56: 100nF; C_0603_1608Metric; LCSC Part C519438
C57: 100nF; C_0603_1608Metric; LCSC Part C14663
U5: MPU-6050_C24112; QFN-24_L4.0-W4.0-P0.50-BL-EP2.7; LCSC Part C24112

Connections:
+3.3V: C15.1, C56.1, U5.8 (VLOGIC), U5.13 (VDD); also elsewhere on the board
/ACC_GYR_INT: U5.12 (INT); also elsewhere on the board
/ACC_GYR_SCL: U5.23 (SCL); also elsewhere on the board
/ACC_GYR_SDA: U5.24 (SDA); also elsewhere on the board
GND: C15.2, C55.2, C56.2, C57.2, U5.1 (CLKIN), U5.9 (AD0), U5.11 (FSYNC), U5.18 (GND), U5.25 (EP); also elsewhere on the board
unnamed: C57.1, U5.20 (CPOUT)
unnamed: C55.1, U5.10 (REGOUT)
