mk2442/Itla/digital/proyectos/rc-kakata-control/RC-KAKATA-CONTROL.kicad_pcb

## KiCad design digital/proyectos/rc-kakata-control/RC-KAKATA-CONTROL.kicad_pcb (continued)

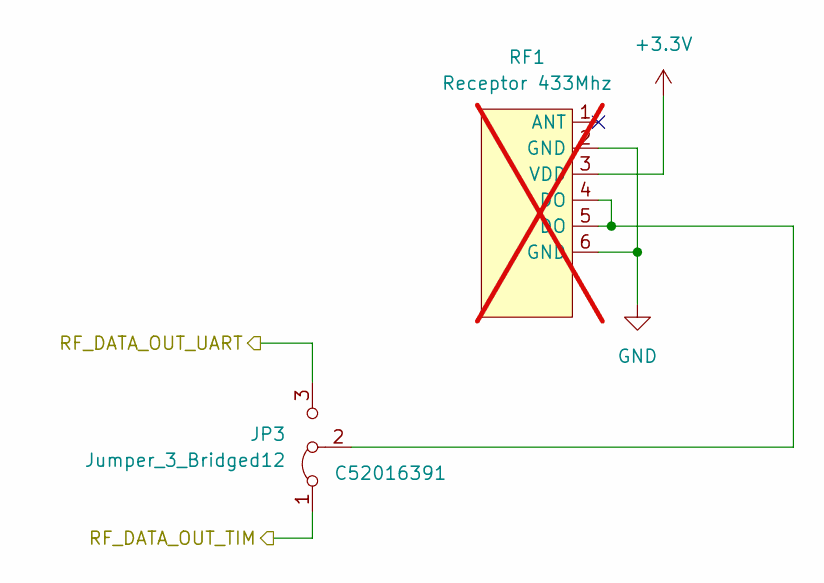
[picture p411: schematic rf_in.kicad_sch, RC-KAKATA-CONTROL]

Parts:
JP3: Jumper_3_Bridged12; PinHeader_1x03_P2.54mm_Vertical; LCSC Part C52016391
RF1: Receptor 433Mhz; rf_433mhz_receiver; not fitted

Connections:
+3.3V: RF1.3 (VDD); also elsewhere on the board
/RF_DATA_IN_TIM: JP3.1 (A); also elsewhere on the board
/RF_DATA_IN_UART: JP3.3 (B); also elsewhere on the board
GND: RF1.2 (GND), RF1.6 (GND); also elsewhere on the board
unnamed: JP3.2 (C), RF1.4 (DO), RF1.5 (DO)

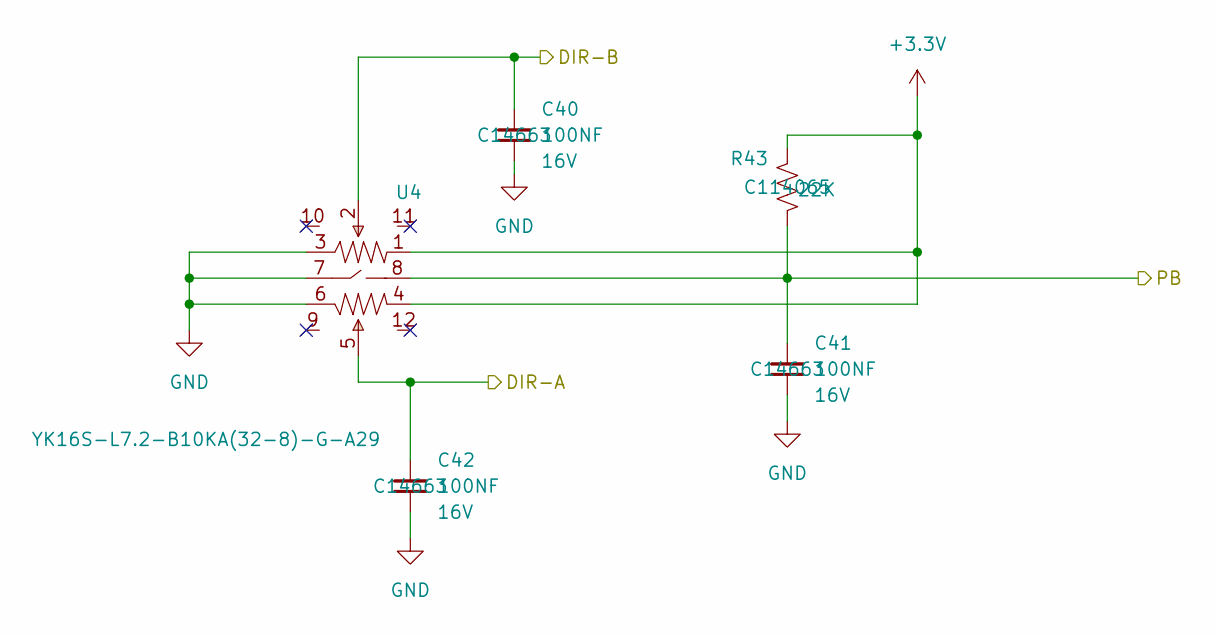
[picture p412: schematic JOYSTICK.kicad_sch, RC-KAKATA-CONTROL]

Parts:
C40, C41, C42: 100NF; C_0603; Part Number 0603YC104KAT2A; JLCPCB ID C14663
R43: 22K; R_0603; Part Number RC0603FR-0710KL; LCSC Part C114065
U4: YK16S-L7.2-B10KA(32-8)-G-A29; JOYTICK-TH_YF16S-FL7.2-B5KB-45-10-Y_1; LCSC Part C37323746

Connections:
+3.3V: R43.1, U4.1, U4.4; also elsewhere on the board
/JOY_DIRA: C42.2, U4.5; also elsewhere on the board
/JOY_DIRB: C41.2, R43.2, U4.8; also elsewhere on the board
/JOY_PB: C40.2, U4.2; also elsewhere on the board
GND: C40.1, C41.1, C42.1, U4.3, U4.6, U4.7; also elsewhere on the board

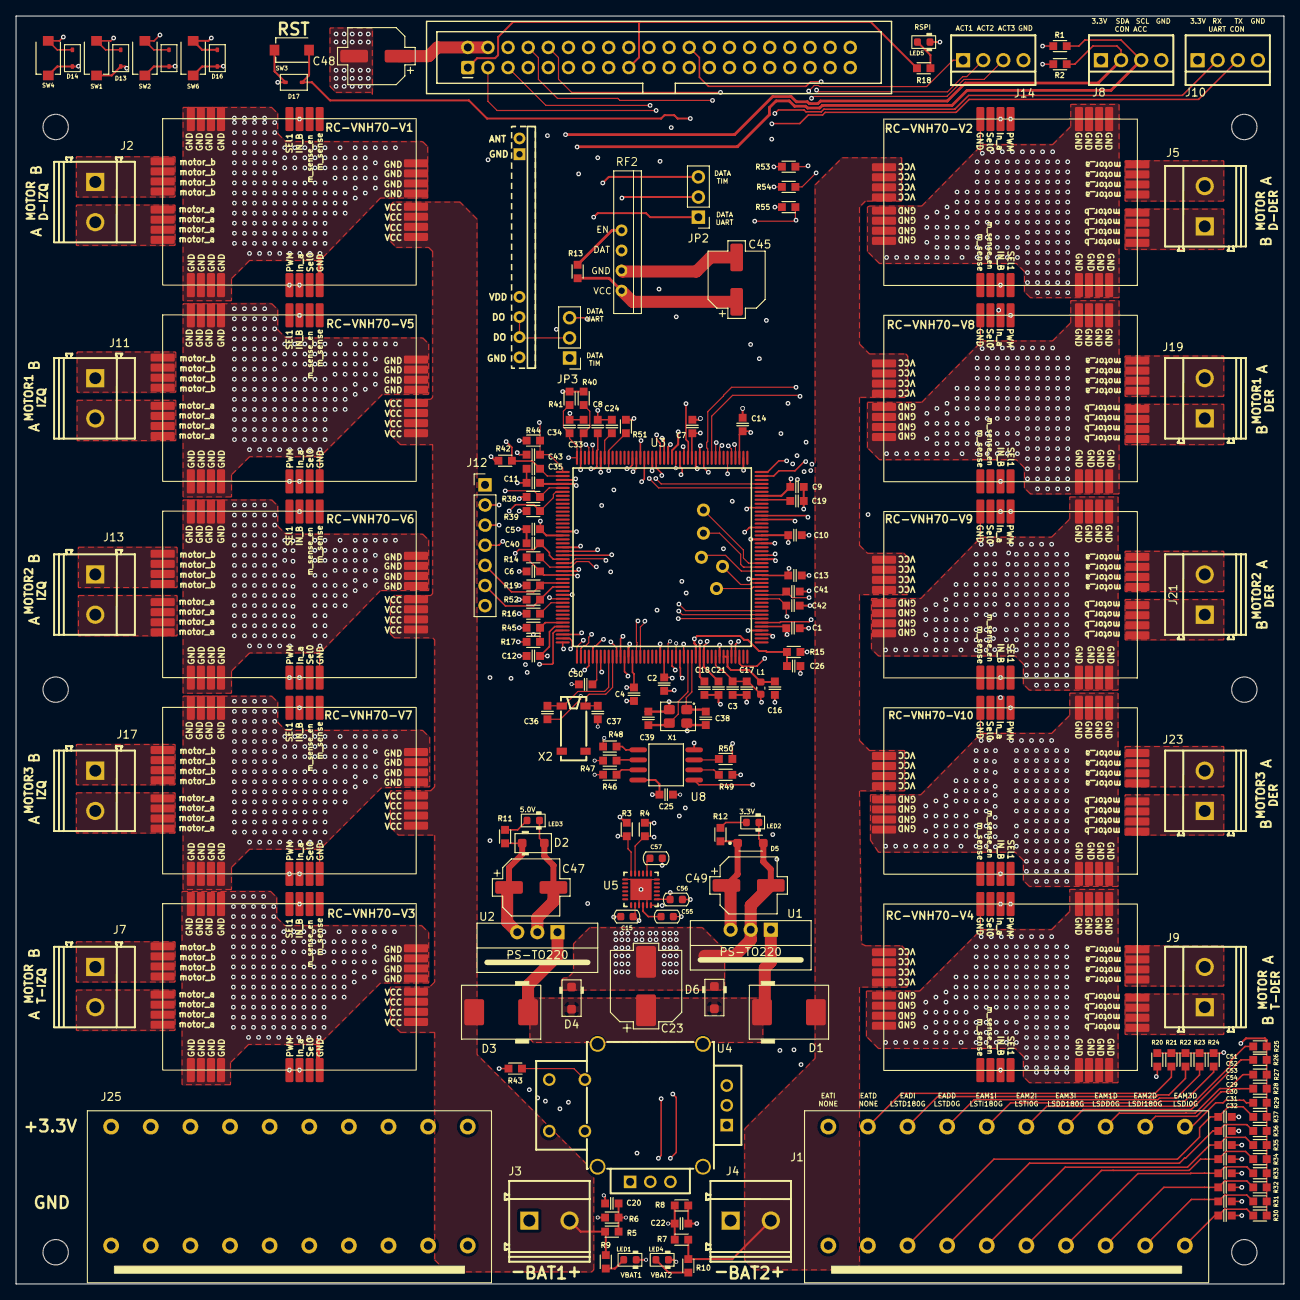
[picture p413: board RC-KAKATA-CONTROL.kicad_pcb from above]

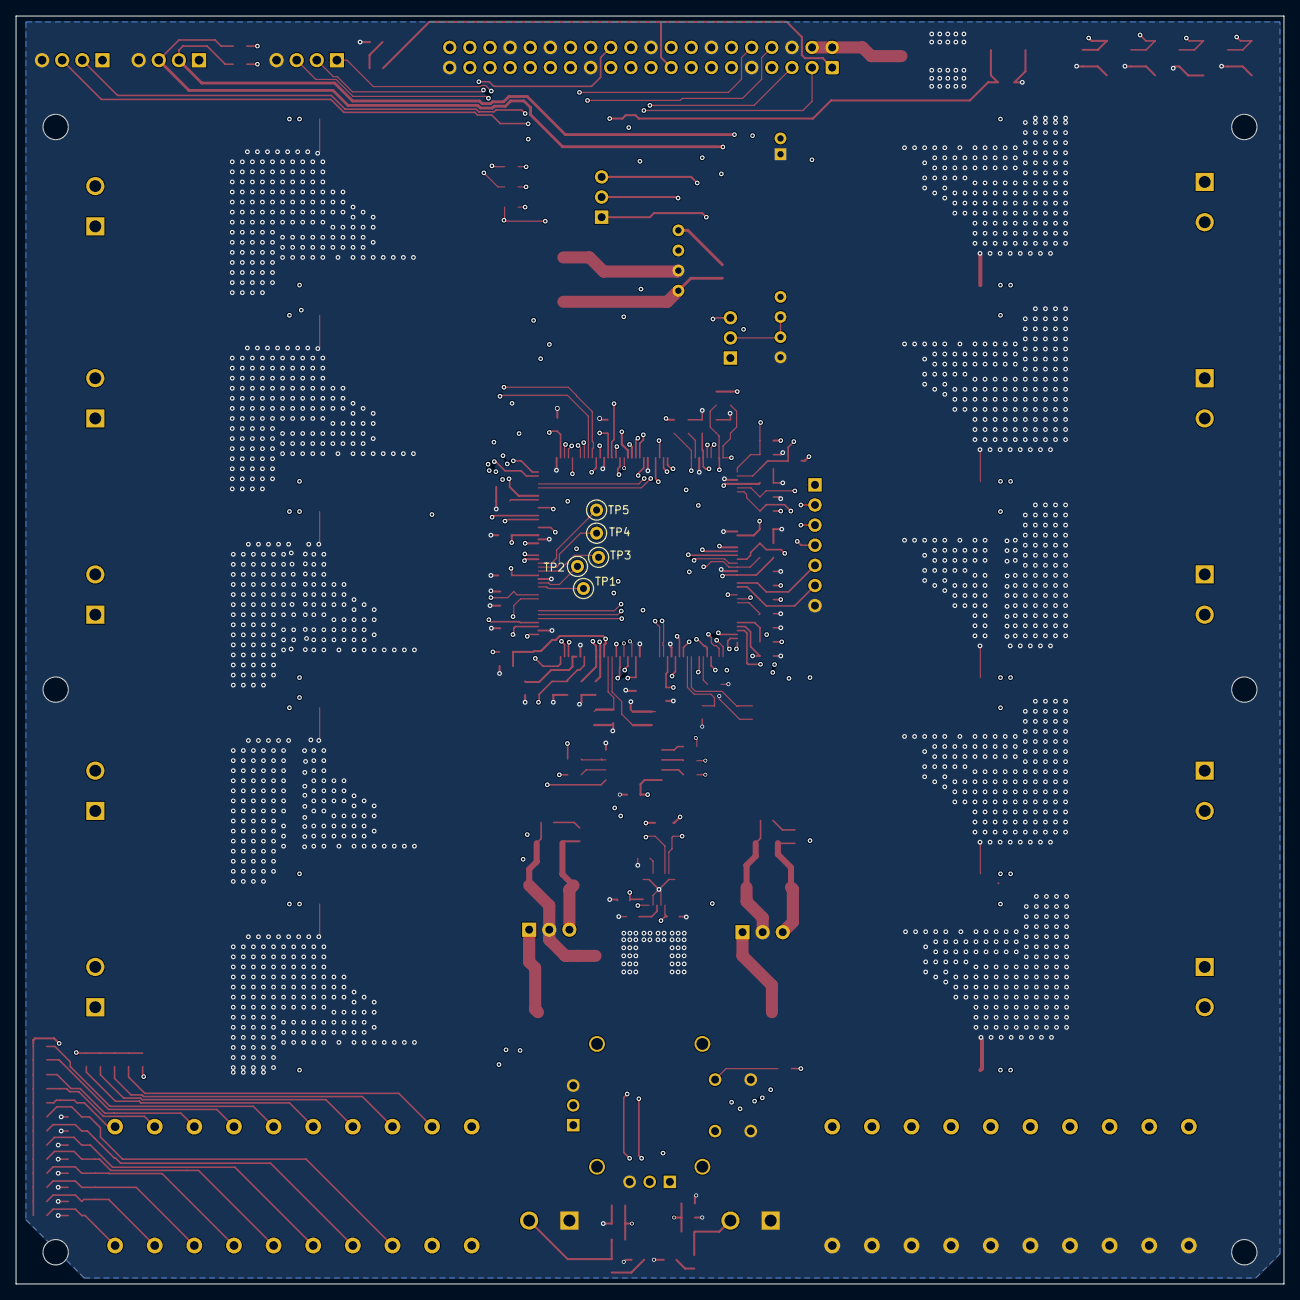
[picture p414: board RC-KAKATA-CONTROL.kicad_pcb from below]

Board: 6 copper layers, 160.0 x 160.0 mm, 182 parts (5 on the bottom side), 140 nets.
