mk2442/Itla/digital/proyectos/abanico/abanico.kicad_pcb

## KiCad design digital/proyectos/abanico/abanico.kicad_pcb (2026-11-01)

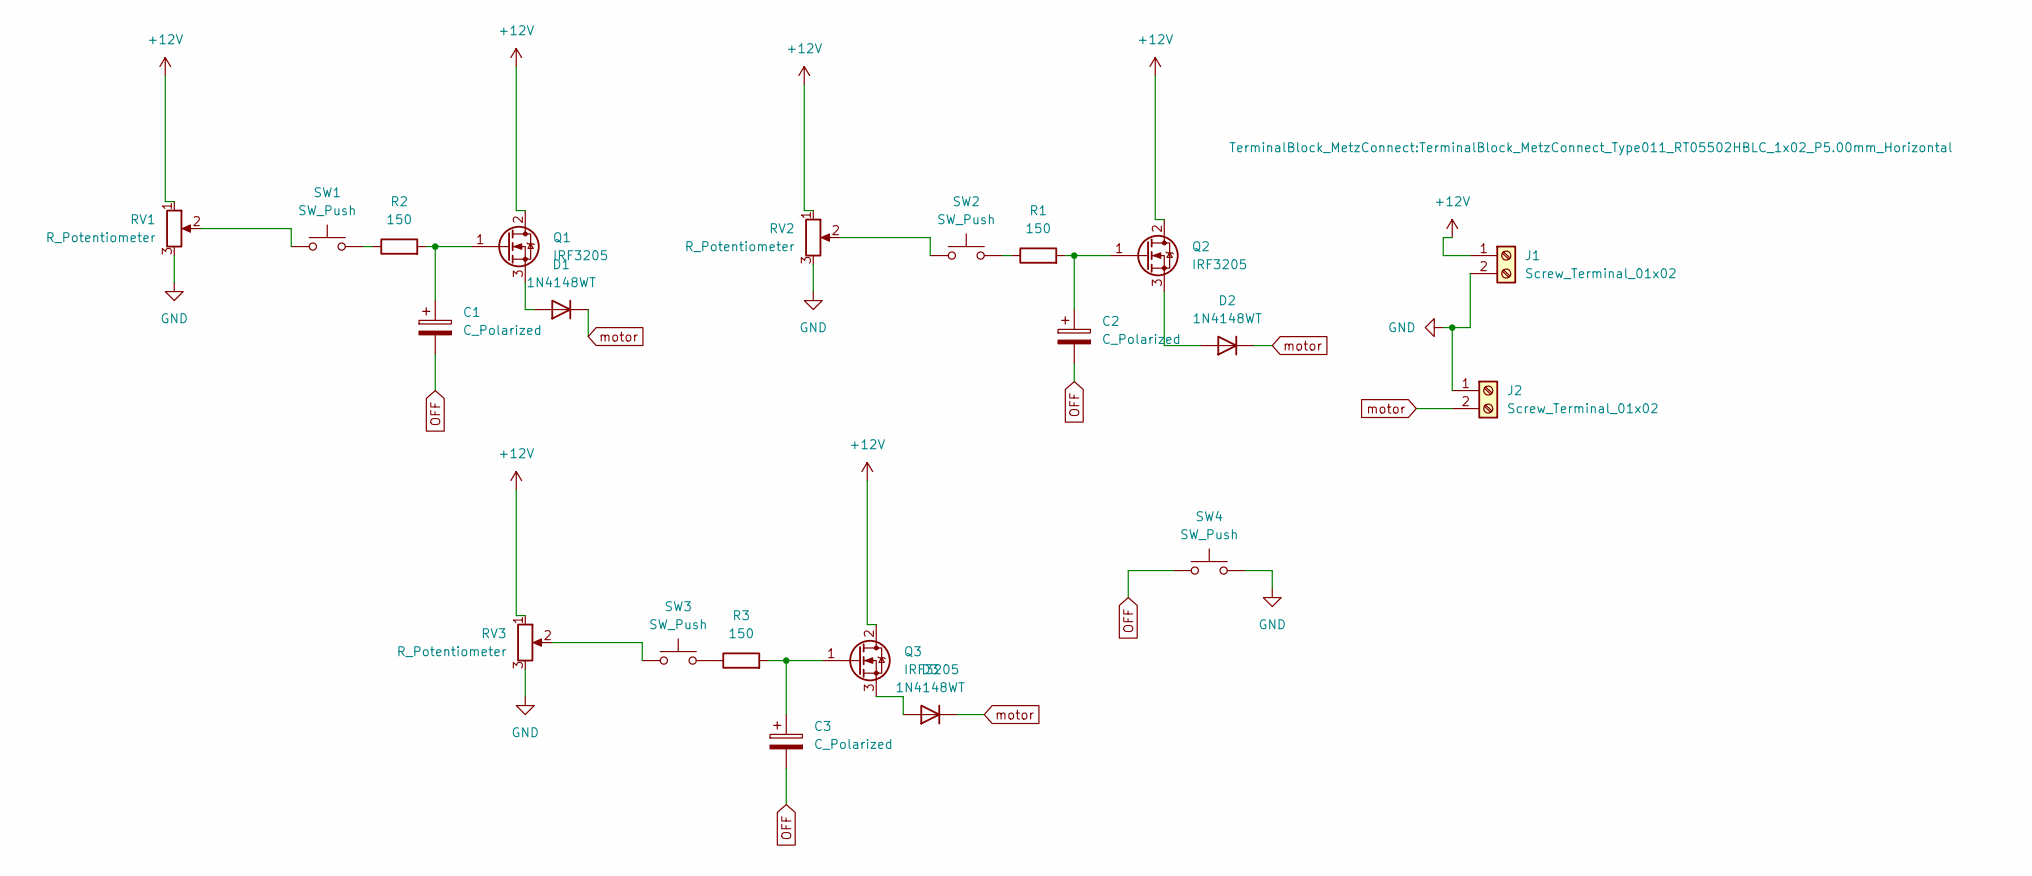
[picture p415: schematic abanico.kicad_sch]

Parts:
C1, C2, C3: C_Polarized; CP_Elec_3x5.3
D1, D2, D3: 1N4148WT; D_SOD-523
J1, J2: Screw_Terminal_01x02; TerminalBlock_MetzConnect_Type011_RT05502HBLC_1x02_P5.00mm_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
Q1, Q2, Q3: IRF3205; TO-220-3_Vertical
R1, R2, R3: 150; R_0201_0603Metric_Pad0.64x0.40mm_HandSolder
RV1, RV2, RV3: R_Potentiometer; Potentiometer_ACP_CA6-VSMD_Vertical
SW1, SW2, SW3, SW4: SW_Push; SW_Push_1P1T_NO_CK_KMR2

Connections:
+12V: J1.1, Q1.2 (D), Q2.2 (D), Q3.2 (D), RV1.1, RV2.1, RV3.1
GND: J1.2, J2.1, RV1.3, RV2.3, RV3.3, SW4.2
unnamed: D1.2 (A), Q1.3 (S)
unnamed: D2.2 (A), Q2.3 (S)
unnamed: D3.2 (A), Q3.3 (S)
unnamed: C1.1, Q1.1 (G), R2.2
unnamed: C2.1, Q2.1 (G), R1.2
unnamed: C3.1, Q3.1 (G), R3.2
unnamed: R1.1, SW2.2
unnamed: R2.1, SW1.2
unnamed: R3.1, SW3.2
unnamed: RV1.2, SW1.1
unnamed: RV2.2, SW2.1
unnamed: RV3.2, SW3.1
OFF: C1.2, C2.2, C3.2, SW4.1
motor: D1.1 (K), D2.1 (K), D3.1 (K), J2.2

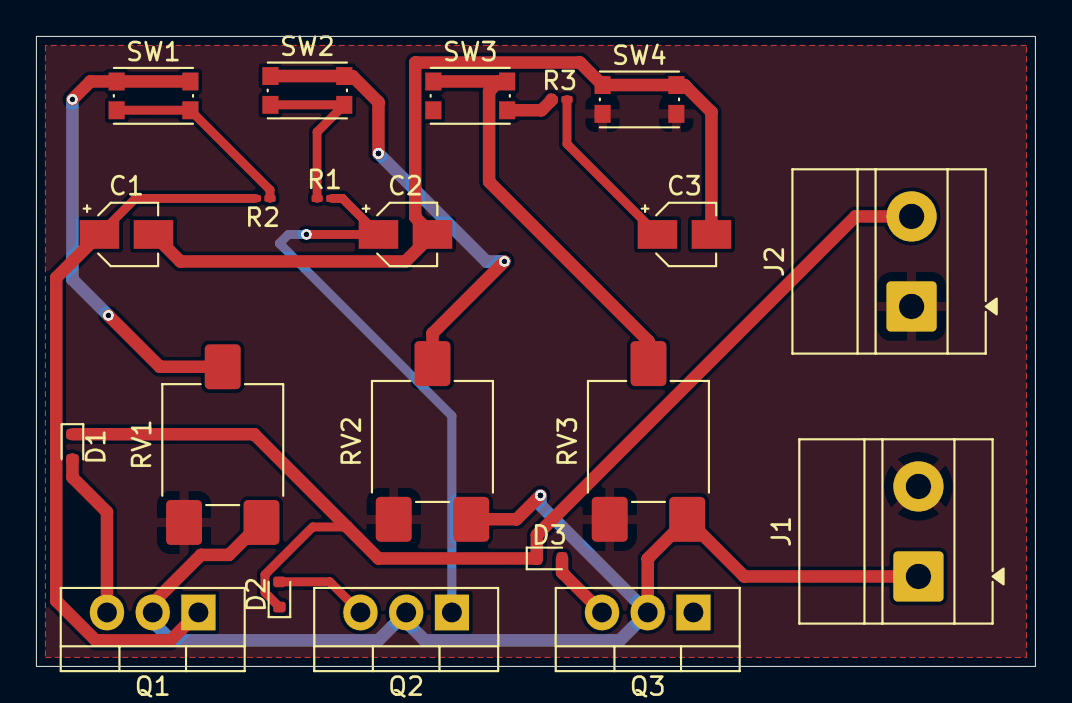
[picture p416: board abanico.kicad_pcb from above]

Board: 2 copper layers, 55.5 x 35.0 mm, 21 parts (0 on the bottom side), 16 nets.
