mk2442/Itla/digital/proyectos/salida-fija-5v-12v/Salida Fija 5V_12V DC/Salida Fija 5V_12V DC.kicad_pcb

## KiCad design digital/proyectos/salida-fija-5v-12v/Salida Fija 5V_12V DC/Salida Fija 5V_12V DC.kicad_pcb (2026-11-01)

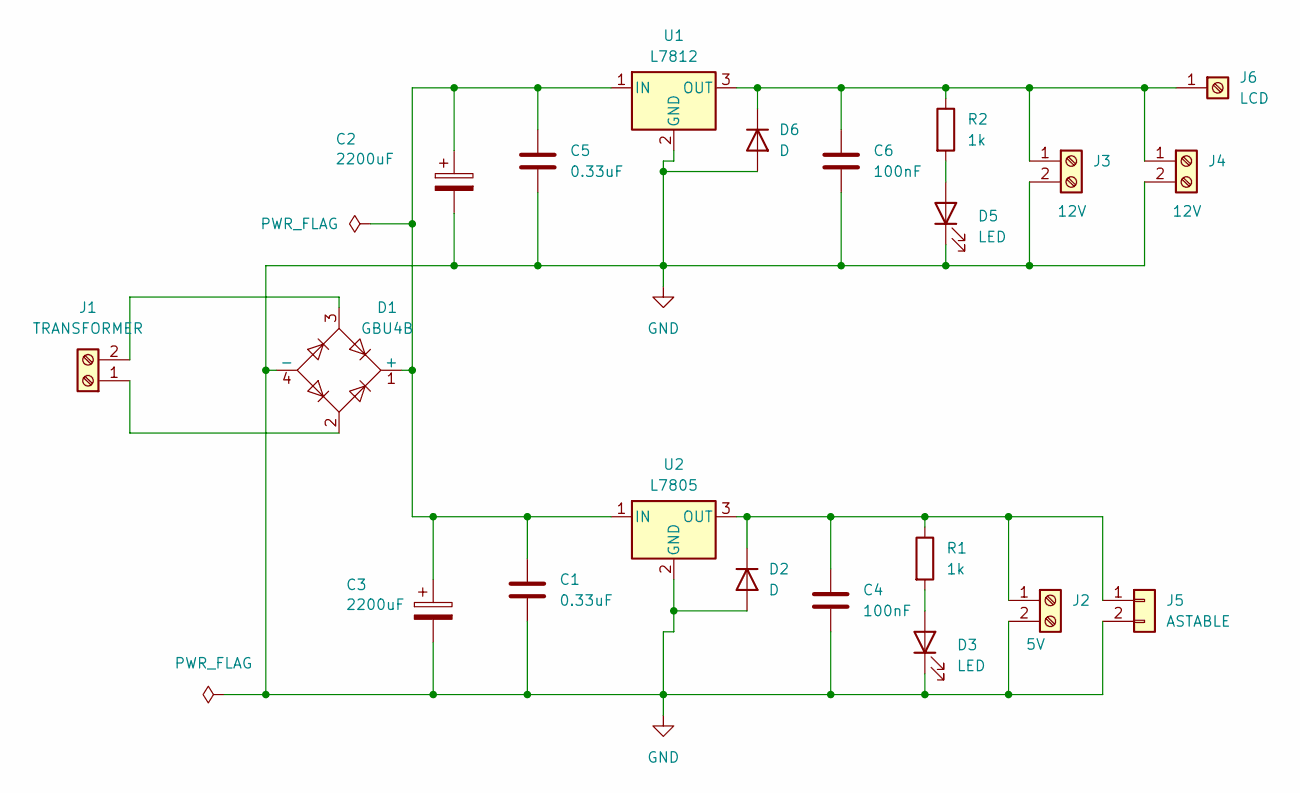
[picture p417: schematic Salida Fija 5V_12V DC.kicad_sch]

Parts:
C1, C5: 0.33uF; C_Disc_D5.0mm_W2.5mm_P5.00mm
C2, C3: 2200uF; CP_Radial_D12.5mm_P5.00mm
C4, C6: 100nF; C_Disc_D5.0mm_W2.5mm_P5.00mm
D1: GBU4B; Diode_Bridge_Vishay_GBU
D2, D6: D; D_DO-41_SOD81_P10.16mm_Horizontal
D3, D5: LED; LED_D5.0mm
J1: TRANSFORMER; TerminalBlock_Phoenix_MKDS-1,5-2_1x02_P5.00mm_Horizontal
J2: 5V; TerminalBlock_Phoenix_MKDS-1,5-2_1x02_P5.00mm_Horizontal
J3, J4: 12V; TerminalBlock_Phoenix_MKDS-1,5-2_1x02_P5.00mm_Horizontal
J5: ASTABLE; Molex_KK-254_AE-6410-02A_1x02_P2.54mm_Vertical
J6: LCD; TestPoint_THTPad_D2.5mm_Drill1.2mm
R1, R2: 1k; R_Axial_DIN0207_L6.3mm_D2.5mm_P10.16mm_Horizontal
U1: L7812; TO-220-3_Vertical
U2: L7805; TO-220-3_Vertical

Connections:
GND: C1.2, C2.2, C3.2, C4.2, C5.2, C6.2, D1.4 (-), D2.2 (A), D3.1 (K), D5.1 (K), D6.2 (A), J2.2, J3.2, J4.2, J5.2, U1.2 (GND), U2.2 (GND)
unnamed: C1.1, C2.1, C3.1, C5.1, D1.1 (+), U1.1 (IN), U2.1 (IN)
unnamed: C4.1, D2.1 (K), J2.1, J5.1, R1.1, U2.3 (OUT)
unnamed: D3.2 (A), R1.2
unnamed: D5.2 (A), R2.2
unnamed: C6.1, D6.1 (K), J3.1, J4.1, J6.1, R2.1, U1.3 (OUT)
unnamed: D1.2, J1.1
unnamed: D1.3, J1.2

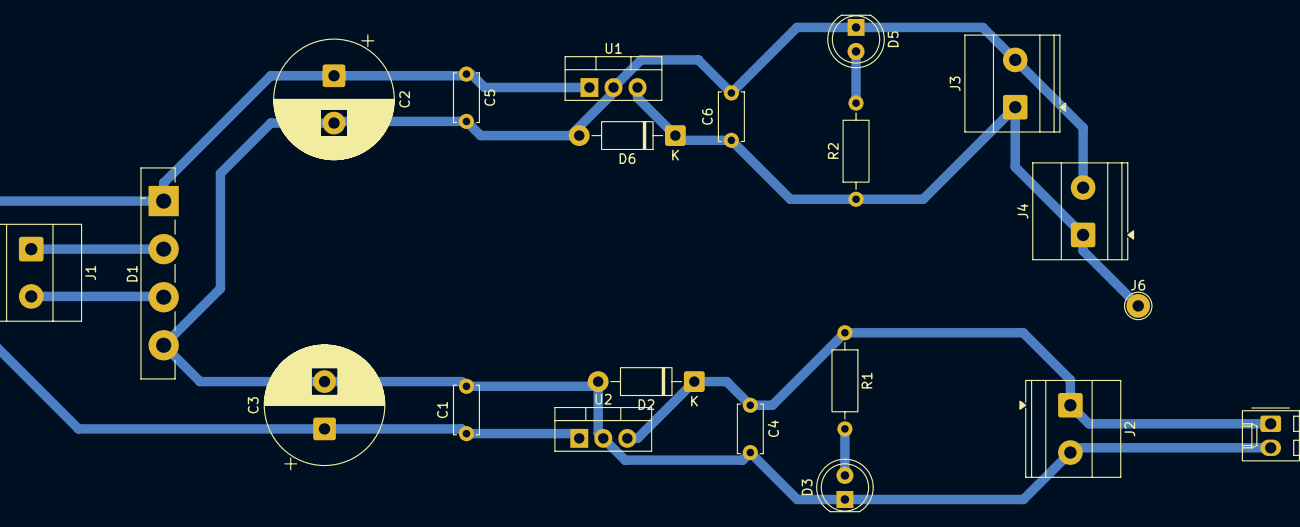
[picture p418: board Salida Fija 5V_12V DC.kicad_pcb from above]

Board: 2 copper layers, 21 parts (0 on the bottom side), 8 nets.
