mk2442/Itla/digital/proyectos/troca-mcu-stm32g474/TROCA-MCU-STM32G474.kicad_pcb

## KiCad design digital/proyectos/troca-mcu-stm32g474/TROCA-MCU-STM32G474.kicad_pcb (2026-11-01)

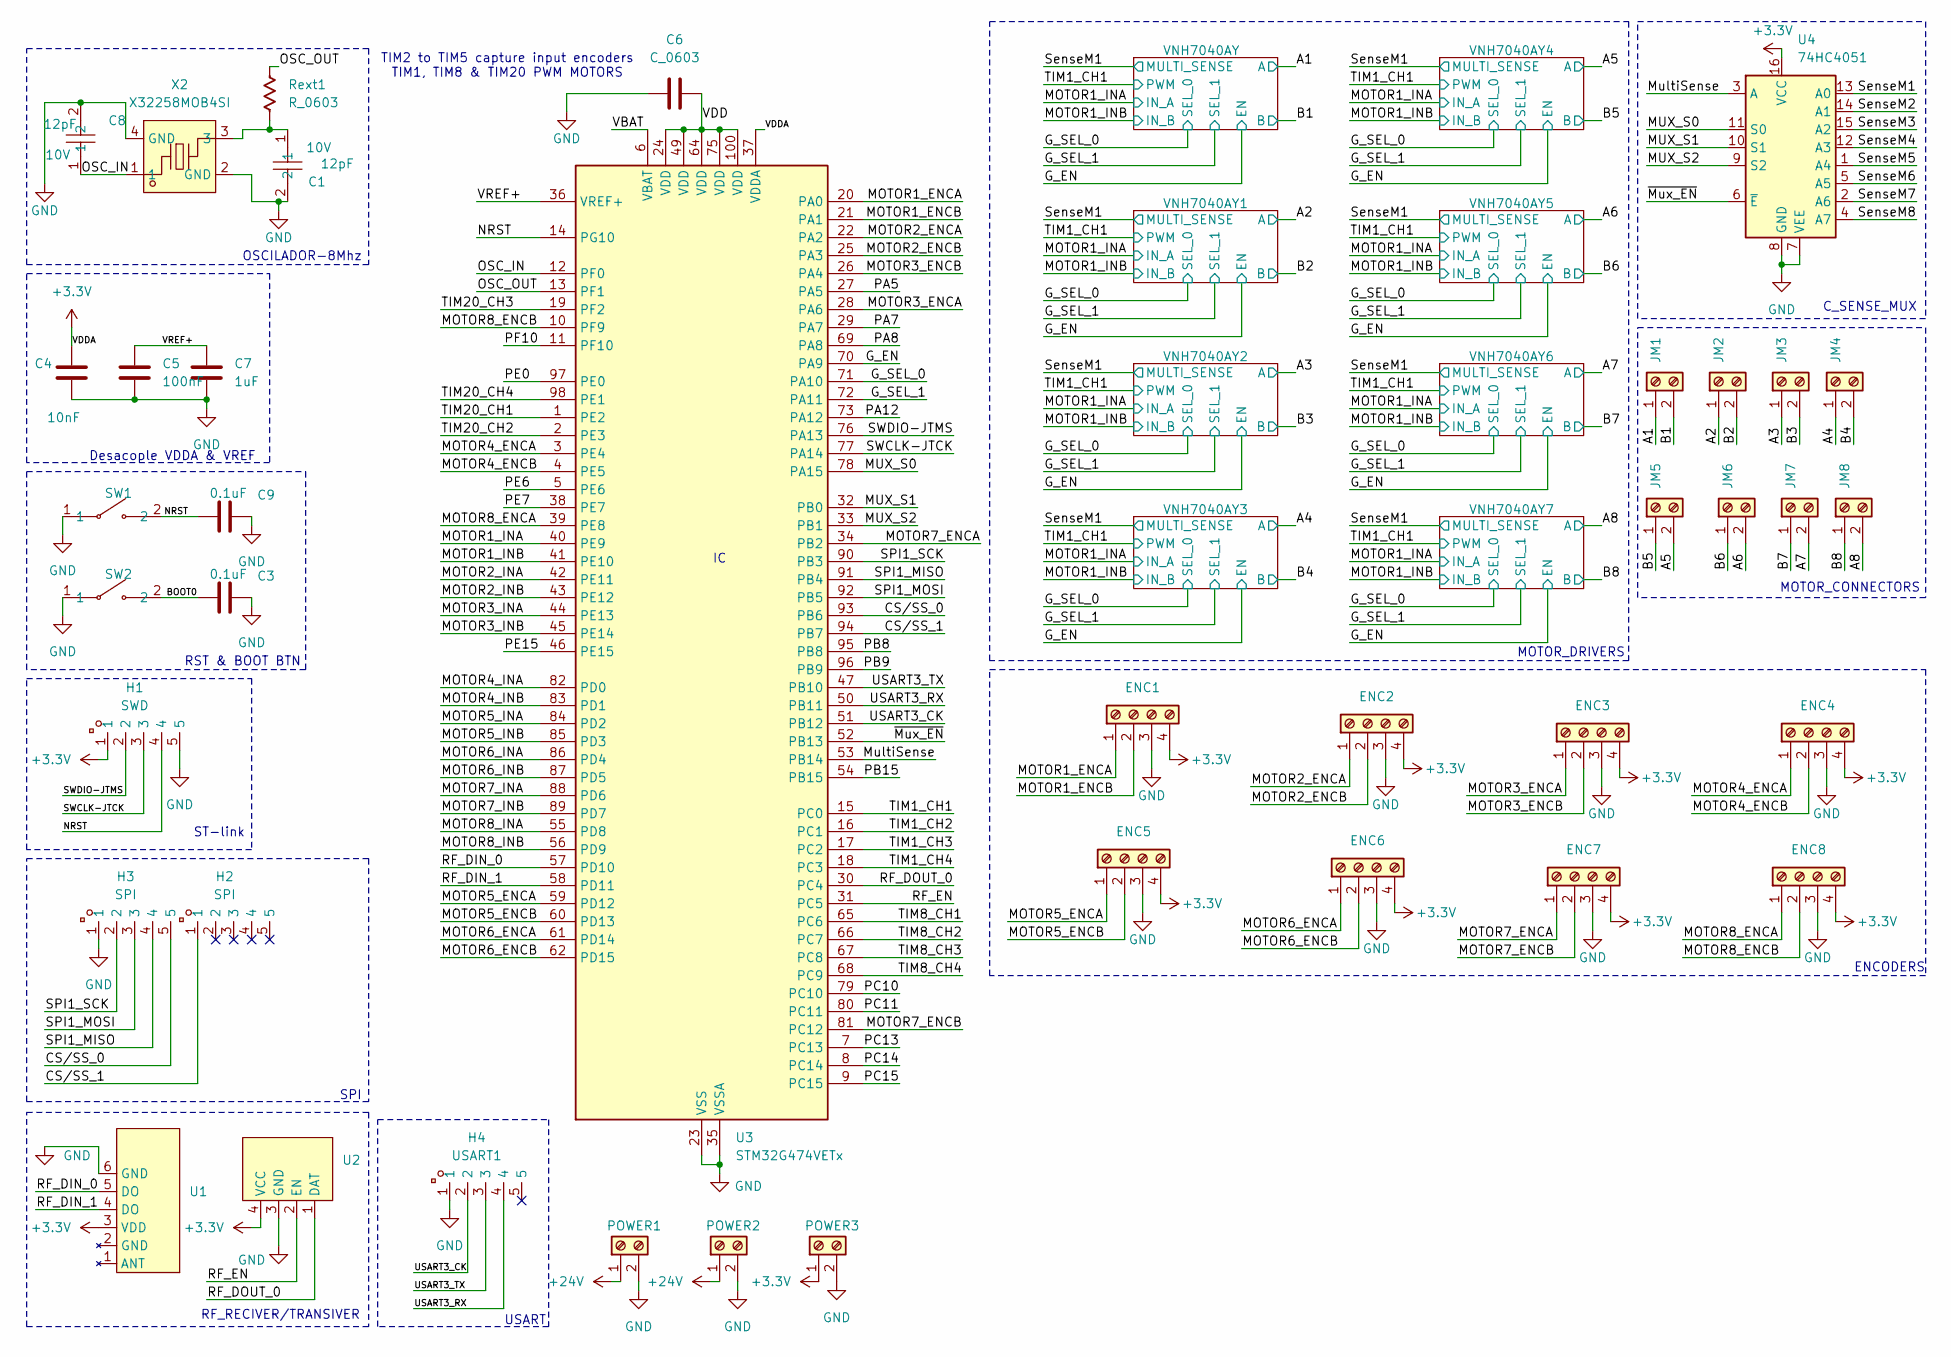
[picture p419: schematic TROCA-MCU-STM32G474.kicad_sch]

Parts:
C1, C8: 12pF; C0603; LCSC Part C2169734
C3, C9: 0.1uF; C_0603_1608Metric
C4: 10nF; C_0603_1608Metric
C5: 100nF; C_0603_1608Metric
C6: C_0603; C_0603_1608Metric
C7: 1uF; C_0603_1608Metric
ENC1, ENC2, ENC3, ENC4, ENC5, ENC6, ENC7, ENC8: Screw_Terminal_01x04; TerminalBlock_Xinya_XY308-2.54-4P_1x04_P2.54mm_Horizontal
H1: SWD; HDR-TH_5P-P2.00-V-M; LCSC Part C22438288
H2, H3: SPI; HDR-TH_5P-P2.00-V-M; LCSC Part C22438288
H4: USART1; HDR-TH_5P-P2.00-V-M; LCSC Part C22438288
JM1, JM2, JM3, JM4, JM5, JM6, JM7, JM8: Screw_Terminal_01x02; TerminalBlock_Xinya_XY308-2.54-2P_1x02_P2.54mm_Horizontal
POWER1, POWER2, POWER3: Screw_Terminal_01x02; TerminalBlock_Xinya_XY308-2.54-2P_1x02_P2.54mm_Horizontal
Rext1: R_0603; R_0603_1608Metric
SW1, SW2: HX-3X6X2.5-X SMD TACT SWITCH; SW-SMD_HX-3X6X2.5-X; LCSC Part C49234125
U1: rf_433mhz_receiver
U2: RF_433MHz_transmisor
U3: STM32G474VETx; LQFP-100_14x14mm_P0.5mm
U4: 74HC4051; PDIP-16_L19.3-W6.4-P2.54-LS7.94-BL
X2: X32258MOB4SI; CRYSTAL-SMD_4P-L3.2-W2.5-BL; LCSC Part C2682775

Connections:
+3.3V: C4.1, ENC1.4, ENC2.4, ENC3.4, ENC4.4, ENC5.4, ENC6.4, ENC7.4, ENC8.4, H1.1, POWER3.1, U1.3 (VDD), U2.4 (VCC), U3.37 (VDDA), U4.16 (VCC)
+24V: POWER1.1, POWER2.1; also elsewhere on the board
/A1: JM1.1; also elsewhere on the board
/A2: JM2.1; also elsewhere on the board
/A3: JM3.1; also elsewhere on the board
/A4: JM4.1; also elsewhere on the board
/A5: JM5.2; also elsewhere on the board
/A6: JM6.2; also elsewhere on the board
/A7: JM7.2; also elsewhere on the board
/A8: JM8.2; also elsewhere on the board
/B1: JM1.2; also elsewhere on the board
/B2: JM2.2; also elsewhere on the board
/B3: JM3.2; also elsewhere on the board
/B4: JM4.2; also elsewhere on the board
/B5: JM5.1; also elsewhere on the board
/B6: JM6.1; also elsewhere on the board
/B7: JM7.1; also elsewhere on the board
/B8: JM8.1; also elsewhere on the board
/BOOT0: C3.1, SW2.2
/CS/SS_0: H3.5, U3.93 (PB6)
/CS/SS_1: H2.1, U3.94 (PB7)
/G_EN: U3.70 (PA9); also elsewhere on the board
/G_SEL_0: U3.71 (PA10); also elsewhere on the board
/G_SEL_1: U3.72 (PA11); also elsewhere on the board
/MOTOR1_ENCA: ENC1.1, U3.20 (PA0)
/MOTOR1_ENCB: ENC1.2, U3.21 (PA1)
/MOTOR1_INA: U3.40 (PE9); also elsewhere on the board
/MOTOR1_INB: U3.41 (PE10); also elsewhere on the board
/MOTOR2_ENCA: ENC2.1, U3.22 (PA2)
/MOTOR2_ENCB: ENC2.2, U3.25 (PA3)
/MOTOR2_INA: U3.42 (PE11)
/MOTOR2_INB: U3.43 (PE12)
/MOTOR3_ENCA: ENC3.1, U3.28 (PA6)
/MOTOR3_ENCB: ENC3.2, U3.26 (PA4)
/MOTOR3_INA: U3.44 (PE13)
/MOTOR3_INB: U3.45 (PE14)
/MOTOR4_ENCA: ENC4.1, U3.3 (PE4)
/MOTOR4_ENCB: ENC4.2, U3.4 (PE5)
/MOTOR4_INA: U3.82 (PD0)
/MOTOR4_INB: U3.83 (PD1)
/MOTOR5_ENCA: ENC5.1, U3.59 (PD12)
/MOTOR5_ENCB: ENC5.2, U3.60 (PD13)
/MOTOR5_INA: U3.84 (PD2)
/MOTOR5_INB: U3.85 (PD3)
/MOTOR6_ENCA: ENC6.1, U3.61 (PD14)
/MOTOR6_ENCB: ENC6.2, U3.62 (PD15)
/MOTOR6_INA: U3.86 (PD4)
/MOTOR6_INB: U3.87 (PD5)
/MOTOR7_ENCA: ENC7.1, U3.34 (PB2)
/MOTOR7_ENCB: ENC7.2, U3.81 (PC12)
/MOTOR7_INA: U3.88 (PD6)
/MOTOR7_INB: U3.89 (PD7)
/MOTOR8_ENCA: ENC8.1, U3.39 (PE8)
/MOTOR8_ENCB: ENC8.2, U3.10 (PF9)
/MOTOR8_INA: U3.55 (PD8)
/MOTOR8_INB: U3.56 (PD9)
/MUX_S0: U3.78 (PA15), U4.11 (S0)
/MUX_S1: U3.32 (PB0), U4.10 (S1)
/MUX_S2: U3.33 (PB1), U4.9 (S2)
/MultiSense: U3.53 (PB14), U4.3 (A)
/NRST: C9.1, H1.4, SW1.2, U3.14 (PG10)
/OSC_IN: C8.1, U3.12 (PF0), X2.1
/OSC_OUT: Rext1.2, U3.13 (PF1)
/PA5: U3.27 (PA5)
/PA7: U3.29 (PA7)
/PA8: U3.69 (PA8)
/PA12: U3.73 (PA12)
/PB8: U3.95 (PB8)
/PB9: U3.96 (PB9)
/PB15: U3.54 (PB15)
/PC10: U3.79 (PC10)
/PC11: U3.80 (PC11)
/PC13: U3.7 (PC13)
/PC14: U3.8 (PC14)
/PC15: U3.9 (PC15)
/PE0: U3.97 (PE0)
/PE6: U3.5 (PE6)
/PE7: U3.38 (PE7)
/PE15: U3.46 (PE15)
/PF10: U3.11 (PF10)
/RF_DIN_0: U1.5 (DO), U3.57 (PD10)
/RF_DIN_1: U1.4 (DO), U3.58 (PD11)
/RF_DOUT_0: U2.1 (DAT), U3.30 (PC4)
/RF_EN: U2.2 (EN), U3.31 (PC5)
/SPI1_MISO: H3.4, U3.91 (PB4)
/SPI1_MOSI: H3.3, U3.92 (PB5)
/SPI1_SCK: H3.2, U3.90 (PB3)
/SWCLK-JTCK: H1.3, U3.77 (PA14)
/SWDIO-JTMS: H1.2, U3.76 (PA13)
/SenseM1: U4.13 (A0); also elsewhere on the board
/SenseM2: U4.14 (A1)
/SenseM3: U4.15 (A2)
/SenseM4: U4.12 (A3)
/SenseM5: U4.1 (A4)
/SenseM6: U4.5 (A5)
/SenseM7: U4.2 (A6)
/SenseM8: U4.4 (A7)
/TIM1_CH1: U3.15 (PC0); also elsewhere on the board
/TIM1_CH2: U3.16 (PC1)
/TIM1_CH3: U3.17 (PC2)
/TIM1_CH4: U3.18 (PC3)
/TIM8_CH1: U3.65 (PC6)
/TIM8_CH2: U3.66 (PC7)
/TIM8_CH3: U3.67 (PC8)
/TIM8_CH4: U3.68 (PC9)
/TIM20_CH1: U3.1 (PE2)
/TIM20_CH2: U3.2 (PE3)
/TIM20_CH3: U3.19 (PF2)
/TIM20_CH4: U3.98 (PE1)
/USART3_CK: H4.2, U3.51 (PB12)
/USART3_RX: H4.4, U3.50 (PB11)
/USART3_TX: H4.3, U3.47 (PB10)
/VBAT: U3.6 (VBAT)
/VDD: C6.1, U3.24 (VDD), U3.49 (VDD), U3.64 (VDD), U3.75 (VDD), U3.100 (VDD)
/VREF+: C5.1, C7.1, U3.36 (VREF+)
/~Mux_EN: U3.52 (PB13), U4.6 (~E)
GND: C1.2, C3.2, C4.2, C5.2, C6.2, C7.2, C8.2, C9.2, ENC1.3, ENC2.3, ENC3.3, ENC4.3, ENC5.3, ENC6.3, ENC7.3, ENC8.3, H1.5, H3.1, H4.1, POWER1.2, POWER2.2, POWER3.2, SW1.1, SW2.1, U1.6 (GND), U2.3 (GND), U3.23 (VSS), U3.35 (VSSA), U3.48 (VSS), U3.63 (VSS), U3.74 (VSS), U3.99 (VSS), U4.7 (VEE), U4.8 (GND), X2.2 (GND), X2.4 (GND); also elsewhere on the board
unnamed: C1.1, Rext1.1, X2.3

Notes on the sheet:
RF_RECIVER/TRANSIVER
TIM2 to TIM5 capture input encoders TIM1, TIM8 & TIM20 PWM MOTORS
OSCILADOR-8Mhz
MOTOR_CONNECTORS
MOTOR_DRIVERS
ENCODERS
Desacople VDDA & VREF
RST & BOOT BTN
C_SENSE_MUX
USART
SPI
ST-link

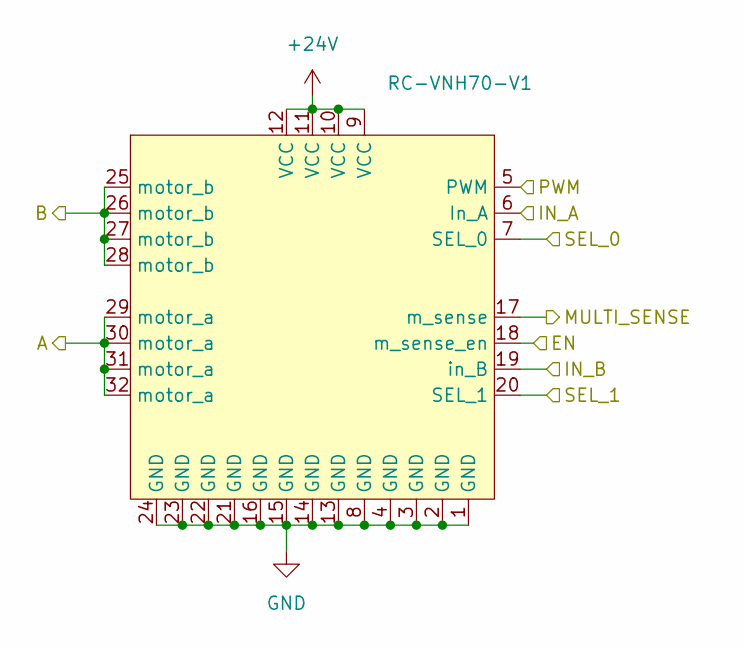
[picture p420: schematic Motor_Driver.kicad_sch]

Parts:
RC-VNH70-V1: RC-VNH70-V1

Connections:
+24V: RC-VNH70-V1.9 (VCC), RC-VNH70-V1.10 (VCC), RC-VNH70-V1.11 (VCC), RC-VNH70-V1.12 (VCC); also elsewhere on the board
/A1: RC-VNH70-V1.29 (motor_a), RC-VNH70-V1.30 (motor_a), RC-VNH70-V1.31 (motor_a), RC-VNH70-V1.32 (motor_a); also elsewhere on the board
/B1: RC-VNH70-V1.25 (motor_b), RC-VNH70-V1.26 (motor_b), RC-VNH70-V1.27 (motor_b), RC-VNH70-V1.28 (motor_b); also elsewhere on the board
/G_EN: RC-VNH70-V1.18 (m_sense_en); also elsewhere on the board
/G_SEL_0: RC-VNH70-V1.7 (SEL_0); also elsewhere on the board
/G_SEL_1: RC-VNH70-V1.20 (SEL_1); also elsewhere on the board
/MOTOR1_INA: RC-VNH70-V1.6 (In_A); also elsewhere on the board
/MOTOR1_INB: RC-VNH70-V1.19 (in_B); also elsewhere on the board
/SenseM1: RC-VNH70-V1.17 (m_sense); also elsewhere on the board
/TIM1_CH1: RC-VNH70-V1.5 (PWM); also elsewhere on the board
GND: RC-VNH70-V1.1 (GND), RC-VNH70-V1.2 (GND), RC-VNH70-V1.3 (GND), RC-VNH70-V1.4 (GND), RC-VNH70-V1.8 (GND), RC-VNH70-V1.13 (GND), RC-VNH70-V1.14 (GND), RC-VNH70-V1.15 (GND), RC-VNH70-V1.16 (GND), RC-VNH70-V1.21 (GND), RC-VNH70-V1.22 (GND), RC-VNH70-V1.23 (GND), RC-VNH70-V1.24 (GND); also elsewhere on the board

Parts of its further copies:
RC-VNH70-V2, RC-VNH70-V3, RC-VNH70-V4, RC-VNH70-V5, RC-VNH70-V6, RC-VNH70-V7, RC-VNH70-V8: RC-VNH70-V1

Connections of its further copies:
+24V: RC-VNH70-V2.9 (VCC), RC-VNH70-V2.10 (VCC), RC-VNH70-V2.11 (VCC), RC-VNH70-V2.12 (VCC), RC-VNH70-V3.9 (VCC), RC-VNH70-V3.10 (VCC), RC-VNH70-V3.11 (VCC), RC-VNH70-V3.12 (VCC), RC-VNH70-V4.9 (VCC), RC-VNH70-V4.10 (VCC), RC-VNH70-V4.11 (VCC), RC-VNH70-V4.12 (VCC), RC-VNH70-V5.9 (VCC), RC-VNH70-V5.10 (VCC), RC-VNH70-V5.11 (VCC), RC-VNH70-V5.12 (VCC), RC-VNH70-V6.9 (VCC), RC-VNH70-V6.10 (VCC), RC-VNH70-V6.11 (VCC), RC-VNH70-V6.12 (VCC), RC-VNH70-V7.9 (VCC), RC-VNH70-V7.10 (VCC), RC-VNH70-V7.11 (VCC), RC-VNH70-V7.12 (VCC), RC-VNH70-V8.9 (VCC), RC-VNH70-V8.10 (VCC), RC-VNH70-V8.11 (VCC), RC-VNH70-V8.12 (VCC); also elsewhere on the board
/A2: RC-VNH70-V2.29 (motor_a), RC-VNH70-V2.30 (motor_a), RC-VNH70-V2.31 (motor_a), RC-VNH70-V2.32 (motor_a); also elsewhere on the board
/A3: RC-VNH70-V3.29 (motor_a), RC-VNH70-V3.30 (motor_a), RC-VNH70-V3.31 (motor_a), RC-VNH70-V3.32 (motor_a); also elsewhere on the board
/A4: RC-VNH70-V4.29 (motor_a), RC-VNH70-V4.30 (motor_a), RC-VNH70-V4.31 (motor_a), RC-VNH70-V4.32 (motor_a); also elsewhere on the board
/A5: RC-VNH70-V5.29 (motor_a), RC-VNH70-V5.30 (motor_a), RC-VNH70-V5.31 (motor_a), RC-VNH70-V5.32 (motor_a); also elsewhere on the board
/A6: RC-VNH70-V6.29 (motor_a), RC-VNH70-V6.30 (motor_a), RC-VNH70-V6.31 (motor_a), RC-VNH70-V6.32 (motor_a); also elsewhere on the board
/A7: RC-VNH70-V7.29 (motor_a), RC-VNH70-V7.30 (motor_a), RC-VNH70-V7.31 (motor_a), RC-VNH70-V7.32 (motor_a); also elsewhere on the board
/A8: RC-VNH70-V8.29 (motor_a), RC-VNH70-V8.30 (motor_a), RC-VNH70-V8.31 (motor_a), RC-VNH70-V8.32 (motor_a); also elsewhere on the board
/B2: RC-VNH70-V2.25 (motor_b), RC-VNH70-V2.26 (motor_b), RC-VNH70-V2.27 (motor_b), RC-VNH70-V2.28 (motor_b); also elsewhere on the board
/B3: RC-VNH70-V3.25 (motor_b), RC-VNH70-V3.26 (motor_b), RC-VNH70-V3.27 (motor_b), RC-VNH70-V3.28 (motor_b); also elsewhere on the board
/B4: RC-VNH70-V4.25 (motor_b), RC-VNH70-V4.26 (motor_b), RC-VNH70-V4.27 (motor_b), RC-VNH70-V4.28 (motor_b); also elsewhere on the board
/B5: RC-VNH70-V5.25 (motor_b), RC-VNH70-V5.26 (motor_b), RC-VNH70-V5.27 (motor_b), RC-VNH70-V5.28 (motor_b); also elsewhere on the board
/B6: RC-VNH70-V6.25 (motor_b), RC-VNH70-V6.26 (motor_b), RC-VNH70-V6.27 (motor_b), RC-VNH70-V6.28 (motor_b); also elsewhere on the board
/B7: RC-VNH70-V7.25 (motor_b), RC-VNH70-V7.26 (motor_b), RC-VNH70-V7.27 (motor_b), RC-VNH70-V7.28 (motor_b); also elsewhere on the board
/B8: RC-VNH70-V8.25 (motor_b), RC-VNH70-V8.26 (motor_b), RC-VNH70-V8.27 (motor_b), RC-VNH70-V8.28 (motor_b); also elsewhere on the board
/G_EN: RC-VNH70-V2.18 (m_sense_en), RC-VNH70-V3.18 (m_sense_en), RC-VNH70-V4.18 (m_sense_en), RC-VNH70-V5.18 (m_sense_en), RC-VNH70-V6.18 (m_sense_en), RC-VNH70-V7.18 (m_sense_en), RC-VNH70-V8.18 (m_sense_en); also elsewhere on the board
/G_SEL_0: RC-VNH70-V2.7 (SEL_0), RC-VNH70-V3.7 (SEL_0), RC-VNH70-V4.7 (SEL_0), RC-VNH70-V5.7 (SEL_0), RC-VNH70-V6.7 (SEL_0), RC-VNH70-V7.7 (SEL_0), RC-VNH70-V8.7 (SEL_0); also elsewhere on the board
/G_SEL_1: RC-VNH70-V2.20 (SEL_1), RC-VNH70-V3.20 (SEL_1), RC-VNH70-V4.20 (SEL_1), RC-VNH70-V5.20 (SEL_1), RC-VNH70-V6.20 (SEL_1), RC-VNH70-V7.20 (SEL_1), RC-VNH70-V8.20 (SEL_1); also elsewhere on the board
/MOTOR1_INA: RC-VNH70-V2.6 (In_A), RC-VNH70-V3.6 (In_A), RC-VNH70-V4.6 (In_A), RC-VNH70-V5.6 (In_A), RC-VNH70-V6.6 (In_A), RC-VNH70-V7.6 (In_A), RC-VNH70-V8.6 (In_A); also elsewhere on the board
/MOTOR1_INB: RC-VNH70-V2.19 (in_B), RC-VNH70-V3.19 (in_B), RC-VNH70-V4.19 (in_B), RC-VNH70-V5.19 (in_B), RC-VNH70-V6.19 (in_B), RC-VNH70-V7.19 (in_B), RC-VNH70-V8.19 (in_B); also elsewhere on the board
/SenseM1: RC-VNH70-V2.17 (m_sense), RC-VNH70-V3.17 (m_sense), RC-VNH70-V4.17 (m_sense), RC-VNH70-V5.17 (m_sense), RC-VNH70-V6.17 (m_sense), RC-VNH70-V7.17 (m_sense), RC-VNH70-V8.17 (m_sense); also elsewhere on the board
/TIM1_CH1: RC-VNH70-V2.5 (PWM), RC-VNH70-V3.5 (PWM), RC-VNH70-V4.5 (PWM), RC-VNH70-V5.5 (PWM), RC-VNH70-V6.5 (PWM), RC-VNH70-V7.5 (PWM), RC-VNH70-V8.5 (PWM); also elsewhere on the board
GND: RC-VNH70-V2.1 (GND), RC-VNH70-V2.2 (GND), RC-VNH70-V2.3 (GND), RC-VNH70-V2.4 (GND), RC-VNH70-V2.8 (GND), RC-VNH70-V2.13 (GND), RC-VNH70-V2.14 (GND), RC-VNH70-V2.15 (GND), RC-VNH70-V2.16 (GND), RC-VNH70-V2.21 (GND), RC-VNH70-V2.22 (GND), RC-VNH70-V2.23 (GND), RC-VNH70-V2.24 (GND), RC-VNH70-V3.1 (GND), RC-VNH70-V3.2 (GND), RC-VNH70-V3.3 (GND), RC-VNH70-V3.4 (GND), RC-VNH70-V3.8 (GND), RC-VNH70-V3.13 (GND), RC-VNH70-V3.14 (GND), RC-VNH70-V3.15 (GND), RC-VNH70-V3.16 (GND), RC-VNH70-V3.21 (GND), RC-VNH70-V3.22 (GND), RC-VNH70-V3.23 (GND), RC-VNH70-V3.24 (GND), RC-VNH70-V4.1 (GND), RC-VNH70-V4.2 (GND), RC-VNH70-V4.3 (GND), RC-VNH70-V4.4 (GND), RC-VNH70-V4.8 (GND), RC-VNH70-V4.13 (GND), RC-VNH70-V4.14 (GND), RC-VNH70-V4.15 (GND), RC-VNH70-V4.16 (GND), RC-VNH70-V4.21 (GND), RC-VNH70-V4.22 (GND), RC-VNH70-V4.23 (GND), RC-VNH70-V4.24 (GND), RC-VNH70-V5.1 (GND), RC-VNH70-V5.2 (GND), RC-VNH70-V5.3 (GND), RC-VNH70-V5.4 (GND), RC-VNH70-V5.8 (GND), RC-VNH70-V5.13 (GND), RC-VNH70-V5.14 (GND), RC-VNH70-V5.15 (GND), RC-VNH70-V5.16 (GND), RC-VNH70-V5.21 (GND), RC-VNH70-V5.22 (GND), RC-VNH70-V5.23 (GND), RC-VNH70-V5.24 (GND), RC-VNH70-V6.1 (GND), RC-VNH70-V6.2 (GND), RC-VNH70-V6.3 (GND), RC-VNH70-V6.4 (GND), RC-VNH70-V6.8 (GND), RC-VNH70-V6.13 (GND), RC-VNH70-V6.14 (GND), RC-VNH70-V6.15 (GND), RC-VNH70-V6.16 (GND), RC-VNH70-V6.21 (GND), RC-VNH70-V6.22 (GND), RC-VNH70-V6.23 (GND), RC-VNH70-V6.24 (GND), RC-VNH70-V7.1 (GND), RC-VNH70-V7.2 (GND), RC-VNH70-V7.3 (GND), RC-VNH70-V7.4 (GND), RC-VNH70-V7.8 (GND), RC-VNH70-V7.13 (GND), RC-VNH70-V7.14 (GND), RC-VNH70-V7.15 (GND), RC-VNH70-V7.16 (GND), RC-VNH70-V7.21 (GND), RC-VNH70-V7.22 (GND), RC-VNH70-V7.23 (GND), RC-VNH70-V7.24 (GND), RC-VNH70-V8.1 (GND), RC-VNH70-V8.2 (GND), RC-VNH70-V8.3 (GND), RC-VNH70-V8.4 (GND), RC-VNH70-V8.8 (GND), RC-VNH70-V8.13 (GND), RC-VNH70-V8.14 (GND), RC-VNH70-V8.15 (GND), RC-VNH70-V8.16 (GND), RC-VNH70-V8.21 (GND), RC-VNH70-V8.22 (GND), RC-VNH70-V8.23 (GND), RC-VNH70-V8.24 (GND); also elsewhere on the board

Board: 4 copper layers, 47 parts (0 on the bottom side), 68 nets, no tracks yet.
