mk2442/Itla/electronica/PHM-30A/PHM-30A/PHM-30A.kicad_pcb

## KiCad design electronica/PHM-30A/PHM-30A/PHM-30A.kicad_pcb (2026-11-01)

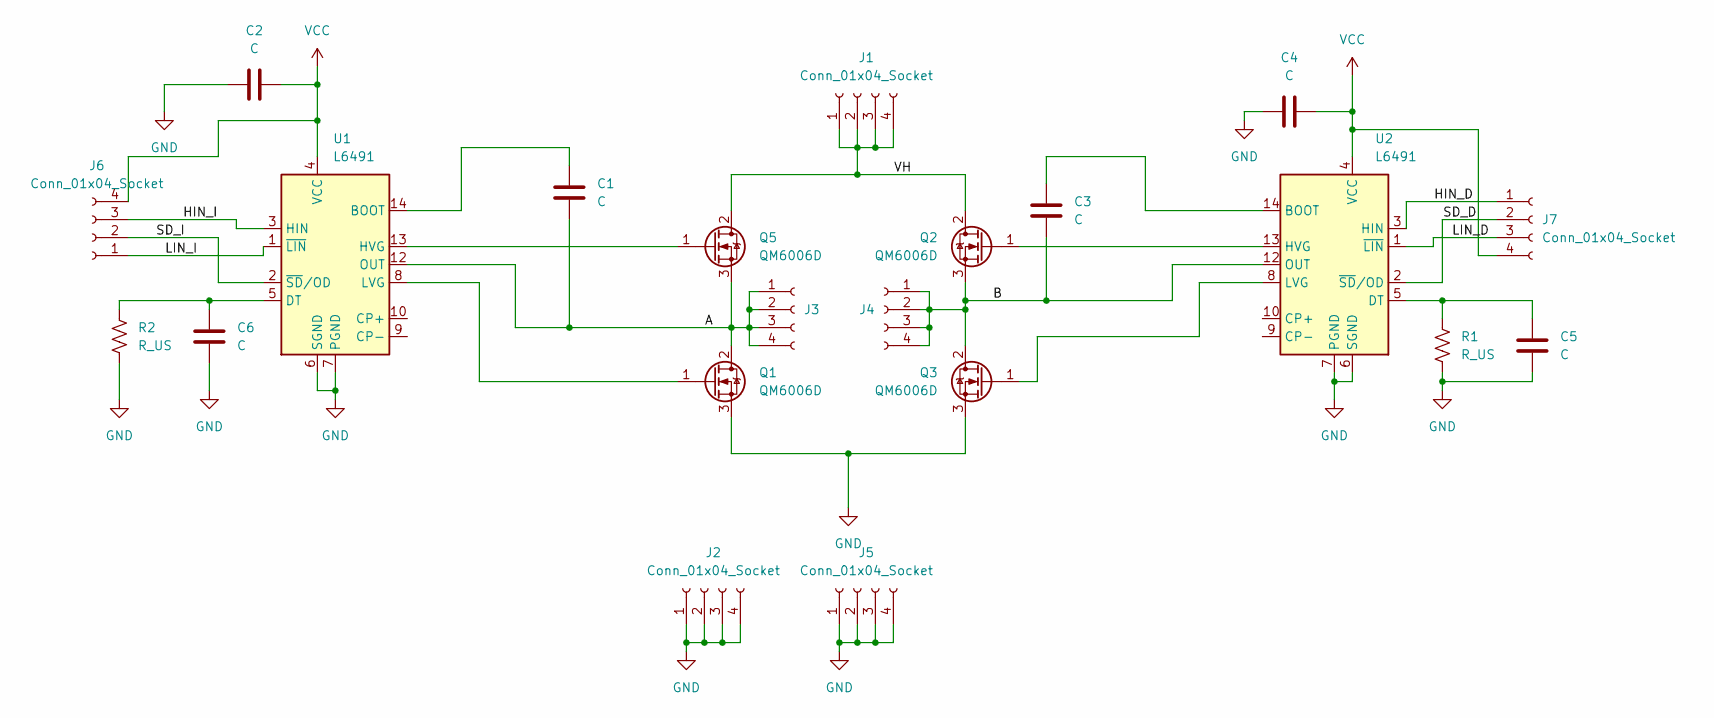
[picture p421: schematic PHM-30A.kicad_sch]

Parts:
C1, C2, C3, C4: C; C_0805_2012Metric
C5, C6: C; C_0603_1608Metric
J1, J2, J3, J4, J5, J6, J7: Conn_01x04_Socket; PinSocket_1x04_P1.27mm_Castellated
Q1, Q2, Q3, Q5: QM6006D; TO-252-2
R1, R2: R_US; R_0603_1608Metric
U1, U2: L6491; SO-14_3.9x8.65mm_P1.27mm

Connections:
/A: C1.2, J3.1, J3.2, J3.3, J3.4, Q1.2 (D), Q5.3 (S), U1.12 (OUT)
/B: C3.2, J4.1, J4.2, J4.3, J4.4, Q2.3 (S), Q3.2 (D), U2.12 (OUT)
/HIN_D: J7.1, U2.3 (HIN)
/HIN_I: J6.3, U1.3 (HIN)
/LIN_D: J7.3, U2.1 (~LIN)
/LIN_I: J6.1, U1.1 (~LIN)
/SD_D: J7.2, U2.2 (~SD/OD)
/SD_I: J6.2, U1.2 (~SD/OD)
/VH: J1.1, J1.2, J1.3, J1.4, Q2.2 (D), Q5.2 (D)
GND: C2.2, C4.1, C5.1, C6.1, J2.1, J2.2, J2.3, J2.4, J5.1, J5.2, J5.3, J5.4, Q1.3 (S), Q3.3 (S), R1.2, R2.2, U1.6 (SGND), U1.7 (PGND), U2.6 (SGND), U2.7 (PGND)
unnamed: Q1.1 (G), U1.8 (LVG)
unnamed: Q2.1 (G), U2.13 (HVG)
unnamed: Q3.1 (G), U2.8 (LVG)
unnamed: Q5.1 (G), U1.13 (HVG)
unnamed: C1.1, U1.14 (BOOT)
unnamed: C6.2, R2.1, U1.5 (DT)
unnamed: C3.1, U2.14 (BOOT)
unnamed: C5.2, R1.1, U2.5 (DT)
VCC: C2.1, C4.2, J6.4, J7.4, U1.4 (VCC), U2.4 (VCC)

Board: 2 copper layers, 21 parts (0 on the bottom side), 19 nets, no tracks yet.
