mk2442/Itla/digital/proyectos/puente-h/PUENTE H.kicad_pcb

## KiCad design digital/proyectos/puente-h/PUENTE H.kicad_pcb (2026-11-01)

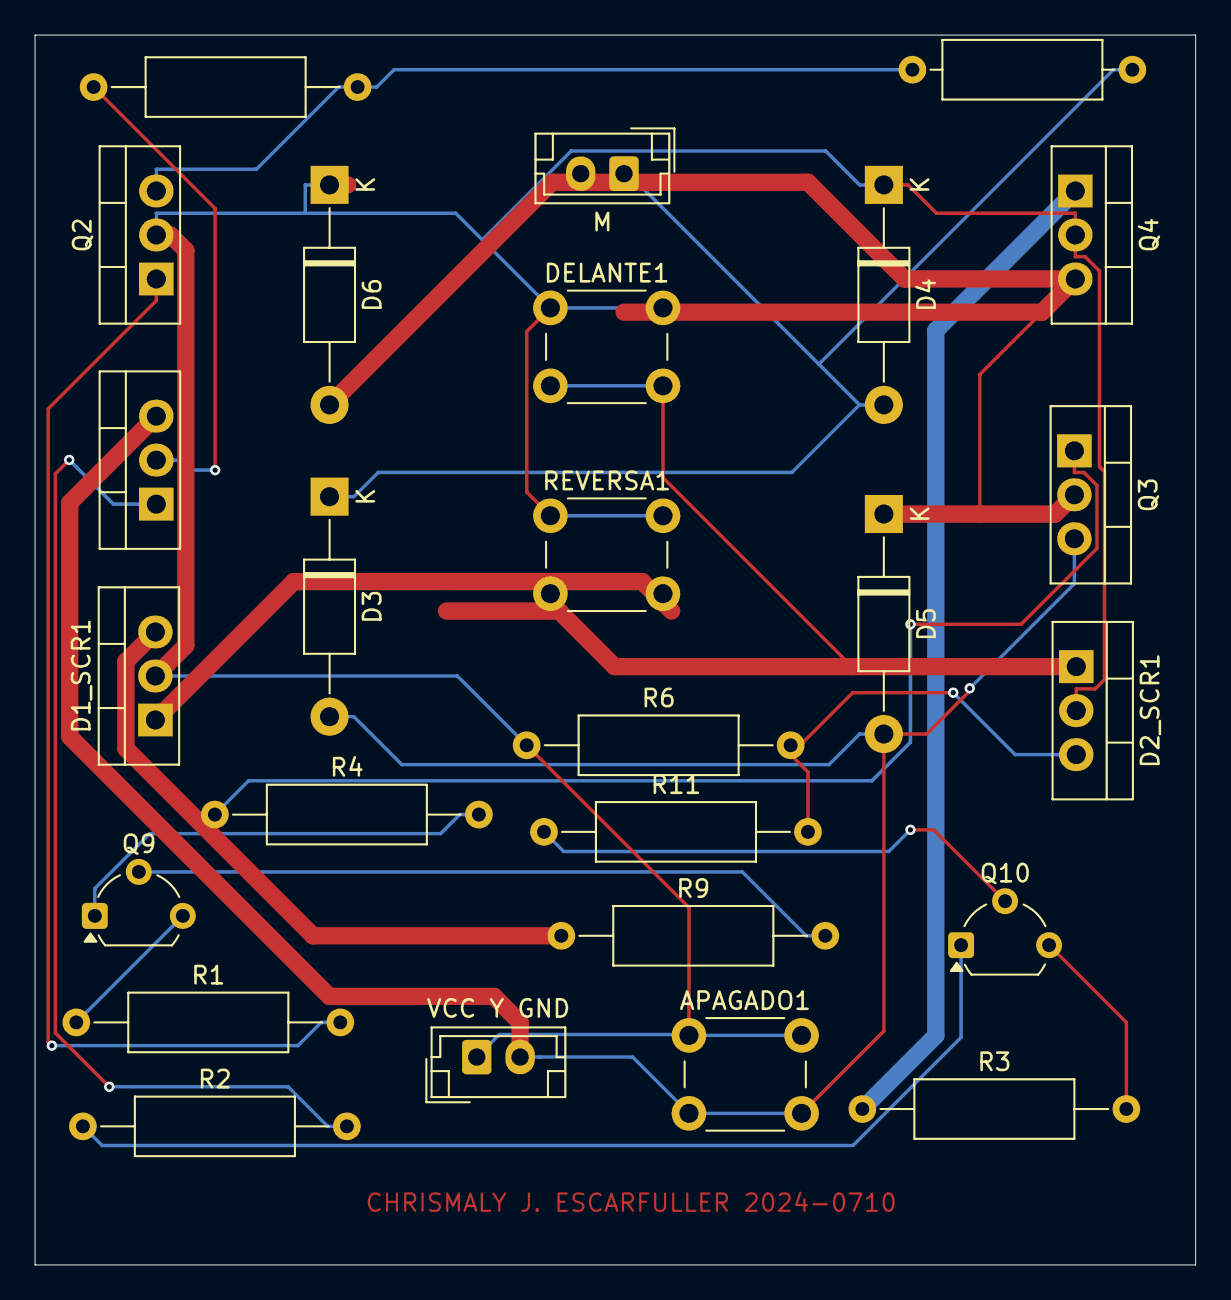
[picture p422: board PUENTE H.kicad_pcb from above]

Board: 2 copper layers, 67.0 x 71.0 mm, 26 parts (0 on the bottom side), 20 nets.

Parts:
APAGADO1: SW_Push; SW_PUSH_6mm_H7.3mm
D1_SCR1, D2_SCR1: Q_SCR_GAK; TO-220-3_Vertical
D3, D4, D5, D6: 1N4007; D_DO-41_SOD81_P12.70mm_Horizontal
DELANTE1: SW_Push; SW_PUSH_6mm_H7.3mm
M: Screw_Terminal_01x02; JST_EH_B2B-EH-A_1x02_P2.50mm_Vertical
Q1, Q2, Q3, Q4: TIP41; TO-220-3_Vertical
Q9, Q10: 2N3904; TO-92L_Wide
R1, R2, R3, R4, R6, R9, R11: R; R_Axial_DIN0309_L9.0mm_D3.2mm_P15.24mm_Horizontal
REVERSA1: SW_Push; SW_PUSH_6mm_H7.3mm
VCC Y GND: Screw_Terminal_01x02; JST_EH_B2B-EH-A_1x02_P2.50mm_Vertical
jUMPER1: R; R_Axial_DIN0309_L9.0mm_D3.2mm_P12.70mm_Horizontal
jUMPER2: R; R_Axial_DIN0309_L9.0mm_D3.2mm_P15.24mm_Horizontal

Connections:
GNDPWR: APAGADO1.2, D3.2 (A), D5.2 (A), Q1.3 (E), Q3.3 (E), VCC Y GND.2
unnamed: D1_SCR1.1 (G), REVERSA1.2
unnamed: D1_SCR1.3 (K), R9.1
unnamed: D2_SCR1.1 (G), DELANTE1.2
unnamed: D2_SCR1.3 (K), R6.2, R11.2
unnamed: D3.1 (K), D4.2 (A), M.1, jUMPER1.2
unnamed: D5.1 (K), D6.2 (A), M.2, Q3.2 (C), Q4.3 (E)
unnamed: Q1.1 (B), R2.2
unnamed: Q1.2 (C), jUMPER2.1
unnamed: Q2.1 (B), R1.2
unnamed: Q2.3 (E), jUMPER1.1, jUMPER2.2
unnamed: Q3.1 (B), R4.1
unnamed: Q4.1 (B), R3.1
unnamed: Q9.2 (B), R9.2
unnamed: Q9.3 (C), R1.1
unnamed: Q9.1 (E), R4.2
unnamed: Q10.2 (B), R11.1
unnamed: Q10.3 (C), R3.2
unnamed: Q10.1 (E), R2.1
VCC: APAGADO1.1, D1_SCR1.2 (A), D2_SCR1.2 (A), D4.1 (K), D6.1 (K), DELANTE1.1, Q2.2 (C), Q4.2 (C), R6.1, REVERSA1.1, VCC Y GND.1
