mk2442/Itla/digital/proyectos/a2/a2.kicad_pcb

## KiCad design digital/proyectos/a2/a2.kicad_pcb (2026-11-01)

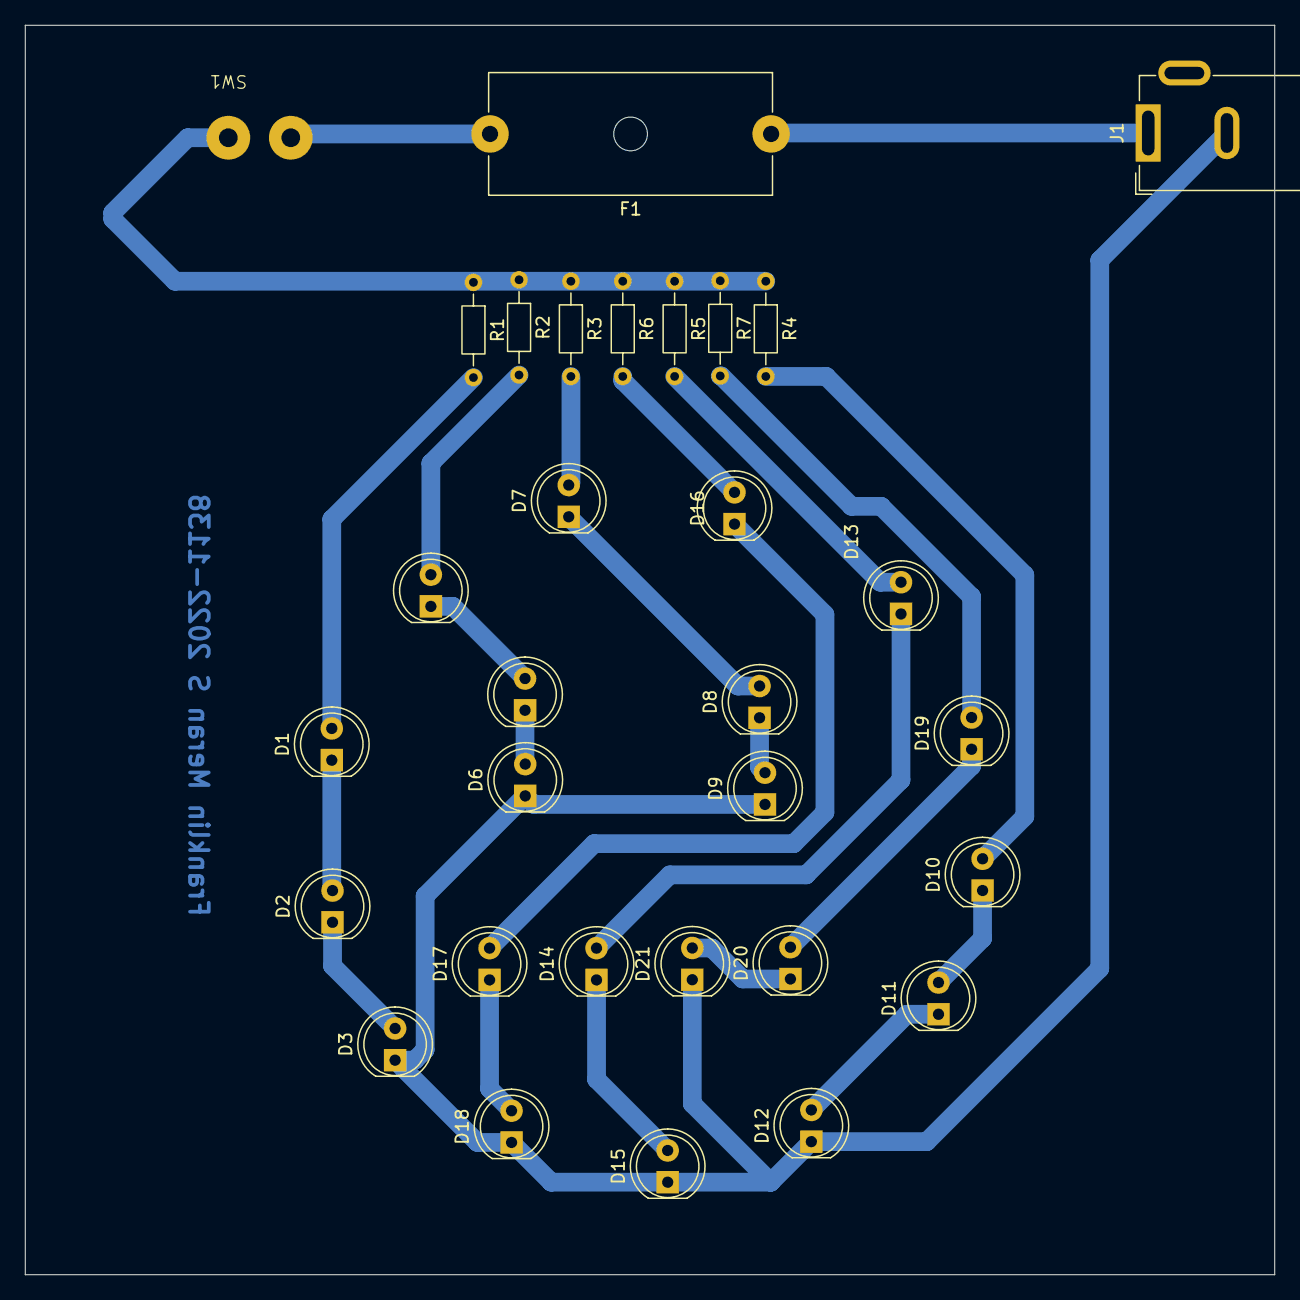
[picture p423: board a2.kicad_pcb from above]

Board: 2 copper layers, 100.0 x 100.0 mm, 31 parts (0 on the bottom side), 25 nets.

Parts:
D1, D2, D3, D4, D5, D6, D7, D8, D9, D10, D11, D12, D13, D14, D15, D16, D17, D18, D19, D20, D21: LED; LED_D5.0mm_Clear
F1: Fuse; Fuseholder_Cylinder-5x20mm_Schurter_0031_8201_Horizontal_Op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
J1: Jack-DC; BarrelJack_GCT_DCJ200-10-A_Horizontal
R1, R2, R3, R4, R5, R6, R7: R; R_Axial_DIN0204_L3.6mm_D1.6mm_P7.62mm_Horizontal
SW1: SW_DIP_x01; Untitled

Connections:
unnamed: D1.2 (A), R1.2
unnamed: D1.1 (K), D2.2 (A)
unnamed: D2.1 (K), D3.2 (A)
unnamed: D4.2 (A), R2.2
unnamed: D4.1 (K), D5.2 (A)
unnamed: D5.1 (K), D6.2 (A)
unnamed: D7.2 (A), R3.2
unnamed: D7.1 (K), D8.2 (A)
unnamed: D8.1 (K), D9.2 (A)
unnamed: D10.2 (A), R4.2
unnamed: D10.1 (K), D11.2 (A)
unnamed: D11.1 (K), D12.2 (A)
unnamed: D3.1 (K), D6.1 (K), D9.1 (K), D12.1 (K), D15.1 (K), D18.1 (K), D21.1 (K), J1.2
unnamed: D13.2 (A), R5.2
unnamed: D13.1 (K), D14.2 (A)
unnamed: D14.1 (K), D15.2 (A)
unnamed: D16.2 (A), R6.2
unnamed: D16.1 (K), D17.2 (A)
unnamed: D17.1 (K), D18.2 (A)
unnamed: D19.2 (A), R7.2
unnamed: D19.1 (K), D20.2 (A)
unnamed: D20.1 (K), D21.2 (A)
unnamed: F1.2, SW1.1
unnamed: F1.1, J1.1
unnamed: R1.1, R2.1, R3.1, R4.1, R5.1, R6.1, R7.1, SW1.2
