mk2442/Itla/digital/proyectos/troca-mcu-stm32g474/STM_MCU_PROYECT/ROVER.ioc

Mcu.UserName=STM32G474VETx
PA0.Signal=S_TIM2_CH1
PA1.Signal=S_TIM2_CH2
PA10.GPIO_Label=G_SEL_0
PA10.Signal=GPIO_Output
PA11.GPIO_Label=G_SEL_1
PA11.Signal=GPIO_Output
PA12.Signal=S_TIM4_CH2
PA13.Signal=SYS_JTMS-SWDIO
PA14.Signal=SYS_JTCK-SWCLK
PA15.GPIO_Label=MUX_SEL0
PA15.Signal=GPIO_Output
PA2.Signal=S_TIM2_CH3
PA3.Signal=S_TIM2_CH4
PA4.Signal=S_TIM3_CH2
PA6.Signal=S_TIM3_CH1
PB0.GPIO_Label=MUX_SEL1
PB0.Signal=GPIO_Output
PB1.GPIO_Label=MUX_SEL1
PB1.Signal=GPIO_Output
PB10.Signal=USART3_TX
PB11.Signal=USART3_RX
PB12.Signal=USART3_CK
PB13.GPIO_Label=MUX_EN
PB13.Signal=GPIO_Output
PB14.Signal=ADC1_IN5
PB2.Signal=S_TIM5_CH1
PB3.Signal=SPI1_SCK
PB4.Signal=SPI1_MISO
PB5.Signal=SPI1_MOSI
PB6.GPIO_Label=CS/SS_0
PB6.Signal=GPIO_Output
PB7.GPIO_Label=CS/SS_1
PB7.Signal=GPIO_Output
PC0.Signal=S_TIM1_CH1
PC1.Signal=S_TIM1_CH2
PC12.Signal=S_TIM5_CH2
PC2.Signal=S_TIM1_CH3
PC3.Signal=S_TIM1_CH4
PC4.GPIO_Label=RF_DOUT_0
PC4.Signal=GPIO_Output
PC5.GPIO_Label=RF_EN
PC5.Signal=GPIO_Output
PC6.Signal=S_TIM8_CH1
PC7.Signal=S_TIM8_CH2
PC8.Signal=S_TIM8_CH3
PC9.Signal=S_TIM8_CH4
PD0.GPIO_Label=MOTOR4_INA
PD0.Signal=GPIO_Output
PD1.GPIO_Label=MOTOR4_INB
PD1.Signal=GPIO_Output
PD10.Signal=GPIO_Input
PD11.GPIO_Label=RF_DIN_0
PD11.Signal=GPIO_Input
PD12.Signal=S_TIM4_CH1
PD13.Signal=ADC3_IN10
PD14.Signal=S_TIM4_CH3
PD15.Signal=S_TIM4_CH4
PD2.GPIO_Label=MOTOR5_INA
PD2.Signal=GPIO_Output
PD3.GPIO_Label=MOTOR5_INB
PD3.Signal=GPIO_Output
PD4.GPIO_Label=MOTOR6_INA
PD4.Signal=GPIO_Output
PD5.Signal=GPIO_Output
PD6.GPIO_Label=MOTOR7_INA
PD6.Signal=GPIO_Output
PD7.GPIO_Label=MOTOR7_INB
PD7.Signal=GPIO_Output
PD8.GPIO_Label=MOTOR8_INA
PD8.Signal=GPIO_Output
PD9.GPIO_Label=MOTOR8_INB
PD9.Signal=GPIO_Output
PE1.Signal=S_TIM20_CH4
PE10.GPIO_Label=MOTOR1_INB
PE10.Signal=GPIO_Output
PE11.GPIO_Label=MOTOR2_INA
PE11.Signal=GPIO_Output
PE12.GPIO_Label=MOTOR2_INB
PE12.Signal=GPIO_Output
PE13.GPIO_Label=MOTOR3_INA
PE13.Signal=GPIO_Output
PE14.GPIO_Label=MOTOR3_INB
PE14.Signal=GPIO_Output
PE2.Signal=S_TIM20_CH1
PE3.Signal=S_TIM20_CH2
PE4.Signal=S_TIM3_CH3
PE5.Signal=S_TIM3_CH4
PE8.Signal=S_TIM5_CH3
PE9.GPIO_Label=MOTOR1_INA
PE9.Signal=GPIO_Output
PF0-OSC_IN.Signal=RCC_OSC_IN
PF1-OSC_OUT.Signal=RCC_OSC_OUT
PF2.Signal=S_TIM20_CH3
PF9.Signal=S_TIM5_CH4
