mk2442/Itla/digital/proyectos/rotonda/src/NOT.v

module not_module(
    input  A1, output Y1,
    input  A2, output Y2,
    input  A3, output Y3,
    input  A4, output Y4
);
    not (Y1, A1);
    not (Y2, A2);
    not (Y3, A3);
    not (Y4, A4);
endmodule
