mk2442/Itla/(commit log)

2026-11-01 Agregar carpeta solid con piezas y ensambles de SolidWorks
    Sube el contenido de la carpeta solid: piezas (.SLDPRT), ensambles
    (.SLDASM), planos (.SLDDRW), exports para impresión 3D (.STL, .STEP),
    archivos de impresión (.3mf, .gcode), comprimidos (.rar, .zip) y un
    plano en PDF y un JPG. Se conserva la estructura de subcarpetas
    original (greca, cafetera, rover, pieza, eco, empaque, etc.).
    Se excluyeron los archivos temporales de bloqueo de SolidWorks (~$*).
    Claude-Session: https://claude.ai/code/session_01URZ1fdRsAuKez5NQk6RCRS
2026-11-01 Agregar proyectos de electrónica y programación en C
    Organiza los proyectos en carpetas temáticas:
    - electronica/: ESP32-DEVKITV1 (librerías y documentación) y PHM-30A
    (proyecto KiCad con respaldos).
    - programacion-c/: ejercicios y prácticas en C de Cristian_Jimenez
    (capítulos, juegos y proyecto ESP-IDF), a y mondongo.
    Se excluyeron los archivos de compilación (.exe, .o, .a, build/),
    cachés del IDE (.vs/), repositorios Git anidados y archivos vacíos.
    Se agregó un README.md con la estructura del repositorio.
    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
2026-11-01 Agregar carpeta digital: proyectos, impresión 3D y documentos
    Organiza el contenido de la carpeta digital en tres áreas:
    - proyectos/: proyectos de circuitos digitales y electrónica (KiCad,
    Gowin FPGA, Proteus, controles RC, puente H, semáforo, rotonda, etc.).
    Los archivos extraídos de .zip/.rar se reorganizaron en carpetas con
    nombres consistentes.
    - impresion-3d/: modelos e impresión 3D (logo, llavero, altavoz,
    stepper, RD inteligente).
    - documentos/: PDFs de prácticas, parciales y proyectos finales, sin
    los sufijos de copia "(1)".
    Se excluyeron: archivos .git y respaldos (-backups, -bak), cachés,
    bloqueos (.lck), archivos generados del compilador de Gowin (impl/,
    .pr,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
2026-11-01 Agregar Default Project: microcontroladores y proyectos FPGA
    - microcontroladores/esp-idf/: ServeSense (con respaldo de la versión
    anterior incluida en ServeSense.rar), dc-motor-relay, esp32-blink,
    stepper-28byj48, servo-test.
    - microcontroladores/arduino/: stepper-28byj48 y dwdw-test.
    - digital/proyectos/: event-logger-25k y piano-25k (Tang Primer 25K).
    Se excluyeron: carpetas build/, .vscode/, sdkconfig locales y archivos
    generados (cmake, ninja, elf, map, bin); la carpeta CodigoCarrito, que
    solo contiene configuración del IDE; y los archivos vacíos.
    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
2026-11-01 Agregar proyecto carrito (KiCad y archivos de fabricación)
    Agrega electronica/carrito con el proyecto de KiCad (esquemático, PCB y
    archivo de proyecto), los Gerbers y drills de fabricación, y la lista de
    materiales, posiciones, designadores y netlist.
    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
